BryanRalston/robot-lab/modules/design/cad/covers/README.md

## chest_pad_bezel_r2.step (P-052 rev 2, for Arms R18 G2 sweep), 2026-10-21
**Frame: GLOBAL** = torso frame + z 1280 mm, no rotation, waist joints at zero; mm, x fwd, y left, z up. Not the torso frame.
Bodies (named): `pad_core_116` (98×98, x 58–174), `pad_face_CF` (x 174–175), `land` (101×101, x 52–58, thickness [EST], Torso owns it), `bezel_fairing_P052r2` (1 mm PC, 100×100 front at x 173 → 150×150 at x 110, 4 mm corner chamfers, R6 front edge), `crush_posts_x4` (PA66 Ø8/Ø4.5, x 110–173, y ±63, z 1437/1563). Pad and land z 1451–1549 / 1449.5–1550.5.
Bounding box: x 52.0–175.0, y −75.0–75.0, z 1425.0–1575.0. Source: chest_pad_bezel_r2.py (CadQuery, light B-rep).
