BryanRalston/robot-lab/modules/legs/grokbuild/results/STRUCTURE_FEA_REPORT.md

# Structure FEA report

Job 3 of 3. Material 7075-T6. Loads at 66.5 kg. Solver is scikit-fem 12 on P2 tetrahedra, C3D27 hexahedra, and Q4 plates, units mm / N / MPa. Eight threads. CPU only. Every stress below is from a solve in `modules/legs/grokbuild/results/`. The M2 catalog was not changed.

## Acceptance

The r5 M2 line for both legs is 4.822 kg (`modules/legs/results/r5/structure_r5.json`, `total_both_kg` 4.82231676641112). The 0.04 kg bolt and bumper estimate is outside that line. The cap is 4.85 kg. This study did not add catalog mass, so the line stays at 4.822 kg.

Yield safety factor is Sy / von Mises, with Sy = 503 MPa. Pulse Goodman treats the reported stress as 0 to peak: sa = sm = σ/2, SF = 1 / (sa/159 + sm/572). Fully reversed Goodman at 0.52× is SF = 159 / (0.52 × σ) on the full-load stress. The walk load case that is already scaled by 0.52 is not run through that formula again.

| Check | Result |
| --- | --- |
| M2 line ≤ 4.85 kg | 4.822 kg. Holds. |
| Fall SF ≥ 2 on a converged section stress | Fork, knee tongue, both tubes in bending, tongue fall, and foot heel pass. Foot toe and clevis fail on the element maximum. Both of those maxima grew when the mesh was refined. |
| Goodman ≥ 1.5 | Clamp arm root is 1.472 on the fully reversed 0.52× check. Several corner maxima fail. Section stresses away from those corners pass. |
| Added mass where a check fails | Measured only for the lateral tube dent. Not measured for the clevis corner, the foot flange edge, the tongue neck corner, or the clamp root. |

## Material and loads

E = 71700 MPa, ν = 0.33, Sy = 503 MPa, Su = 572 MPa, Se = 159 MPa at 5×10^8 cycles, ρ = 2.81×10⁻⁶ kg/mm³. Shaft steel in the press-fit slice is E = 210000 MPa, ν = 0.30. DP490 in the bond model is E = 2500 MPa, ν = 0.40, thickness 0.10 mm.

W = 652.365 N. 3 body-weights = 1957.1 N. Fall = 3914.19 N. The r3 ground-reaction figure 1039.8 N was not rescaled. Knee screw 7267.4 N. Hip screw 9084.3 N. One screw body force 4542 N. Carry moment 241.5 N·m at a 73 mm instep arm, so the carry screw is 3308.2 N. The 1.5× moment used as a second foot case is 314 N·m.

## Solver checks

`verify_solver.json`, status ok.

- P2 cantilever, 439 tets, 3012 dofs. Tip 0.5557 mm against the beam value 0.5579 mm (0.40%). Bending-stress band 40.9 MPa against 48 MPa (15% low). Tip face area 100 mm².
- Lamé quarter tube, 4095 tets. Bore von Mises median 167.0 MPa against the plane-stress value 179.4 MPa (6.9% low). Hand hoop 141.7 MPa.

`fea_tubes.json` cantilever gate, C3D27, intorder 4, 64 elements, 2475 dofs. Tip −0.5553 mm against the bending target 0.5579 mm plus shear, error 1.26%. End area 100.0 mm². Converged in 159 iterations.

`plate_buckling.json`. Thin plate 100×100×1, nx = 32, reduced shear: k = 3.9692, σ_cr = 26.267 MPa against k = 4 at 26.471 MPa. Biaxial ratio 0.9933. Foot bay 28×28×3.5 mm, nx = 24, full 2×2 shear, 625 nodes: simply supported σ_cr = 3537.2 MPa (k = 3.421), clamped σ_cr = 7912.4 MPa. The bay yields at 503 MPa before it buckles.
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
