BryanRalston/robot-lab/modules/legs/grokbuild/results/REPORT.md

# WBC r6 closed-loop re-sim

Date of these runs: 2026-10-13. Machine: Windows, Python 3.12, repo venv, CPU. `LEGS_MASS=65`, `LEGS_LIMITS=r1`, `LEGS_CONTACT` unset. Contact is the default model: condim 3, box feet 240×100 (geom half-size 0.120×0.05). No change to `CONTRACTS.md` or actuator selections.

Controller: `modules/legs/wbc/`. The plan path is still the 1 kHz QP on a 1 s slice of `walk_1p2_r2` (carry uses `carry_20kg_r2`). `_plan_mpc` is no longer open-loop playback:
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
