BryanRalston/robot-lab/media/progress/2026-10-13_actuators_r2_regen_mass.png

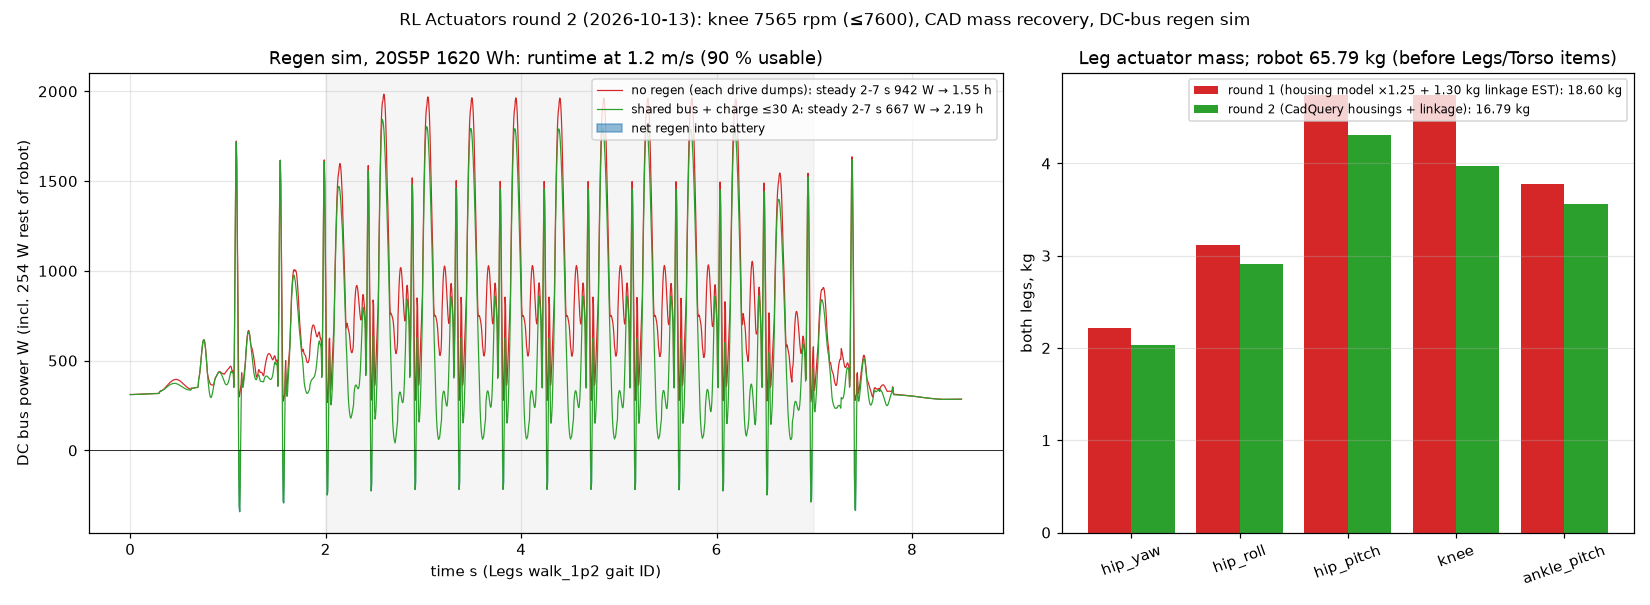
media/progress/2026-10-13_actuators_r2_regen_mass.png
