BryanRalston/robot-lab/media/progress/2026-10-13_actuators_r3_regen_sweep.png

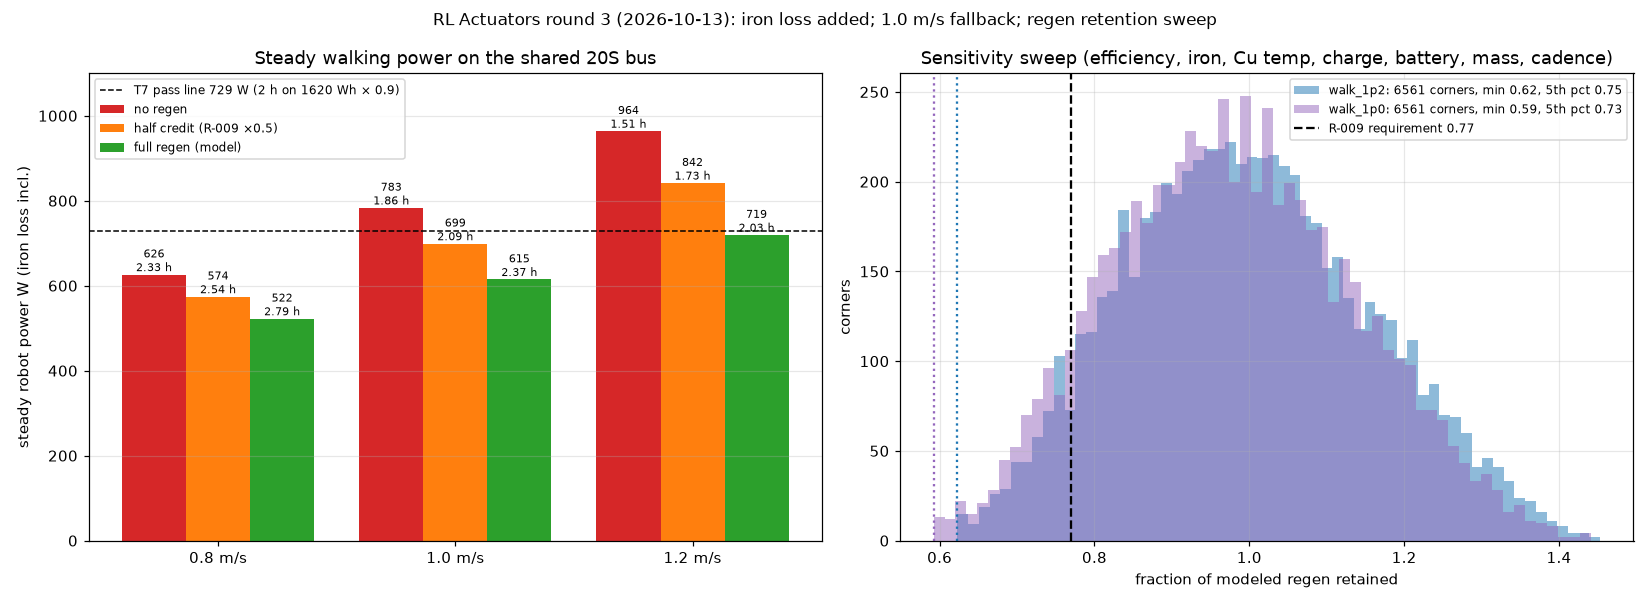
media/progress/2026-10-13_actuators_r3_regen_sweep.png
