BryanRalston/robot-lab/media/progress/2026-10-13_actuators_r3b_hip_lever_fea.png

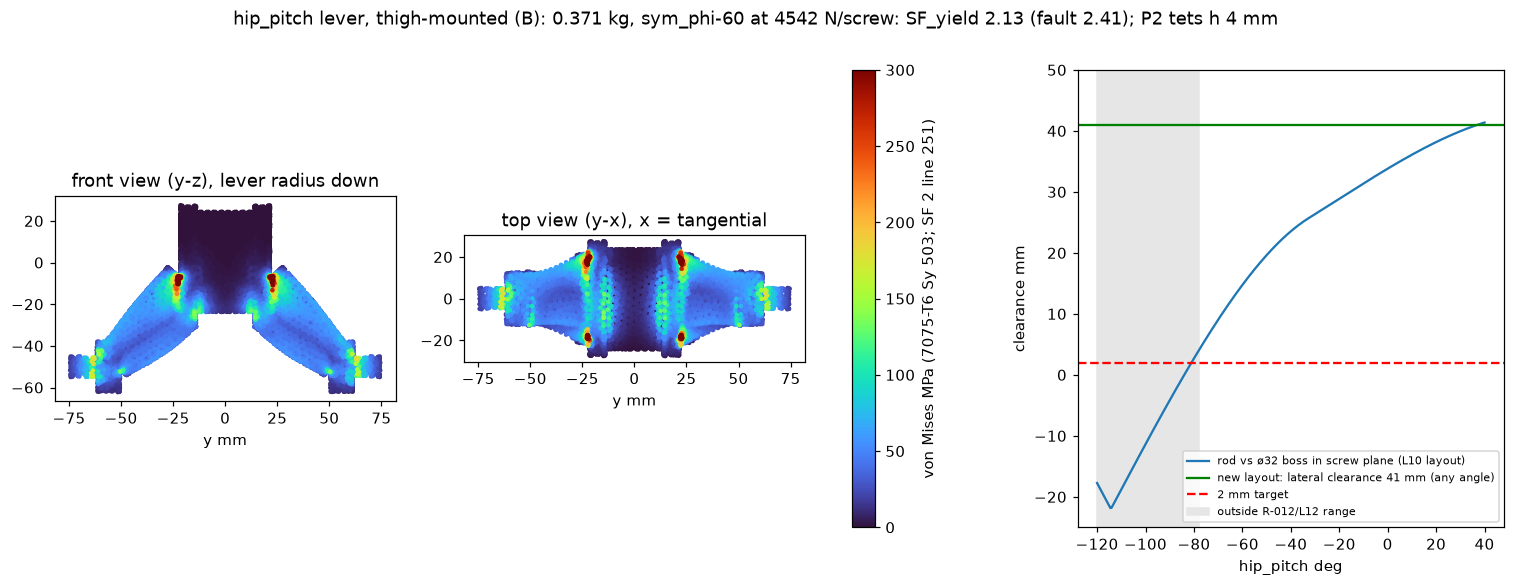
media/progress/2026-10-13_actuators_r3b_hip_lever_fea.png
