BryanRalston/robot-lab/media/progress/2026-10-13_actuators_r4_mass_cuts.png

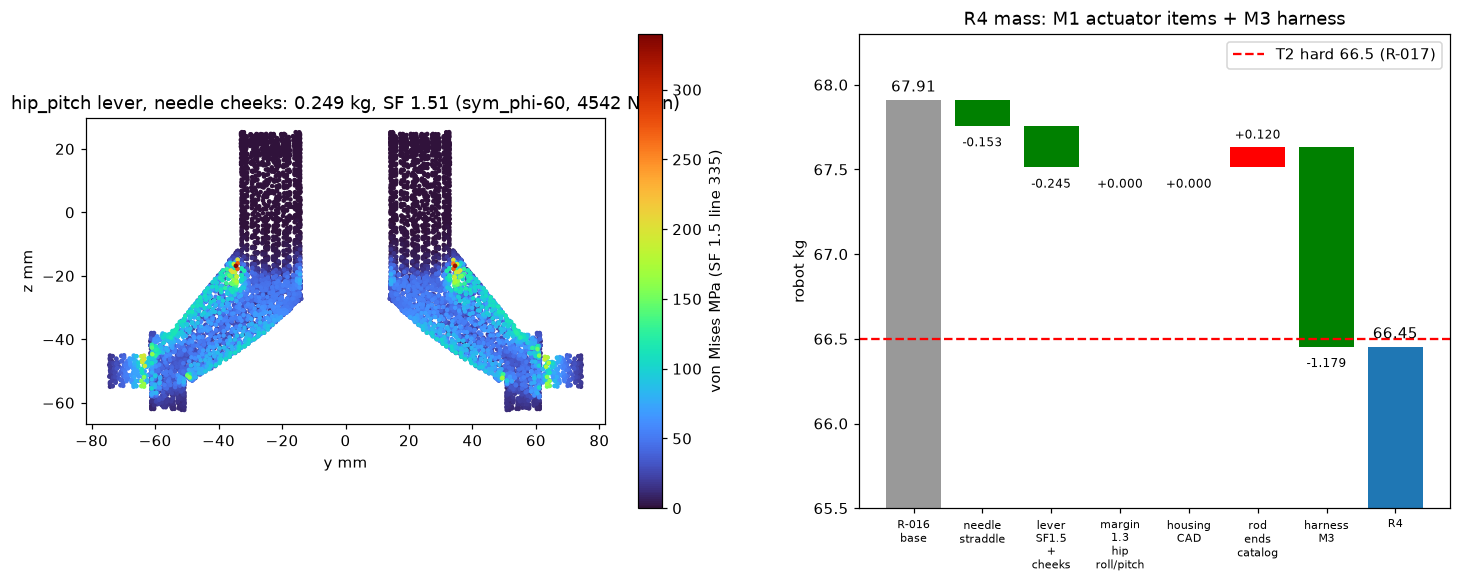
media/progress/2026-10-13_actuators_r4_mass_cuts.png
