BryanRalston/robot-lab/media/progress/2026-10-13_actuators_r5a2_harness.png

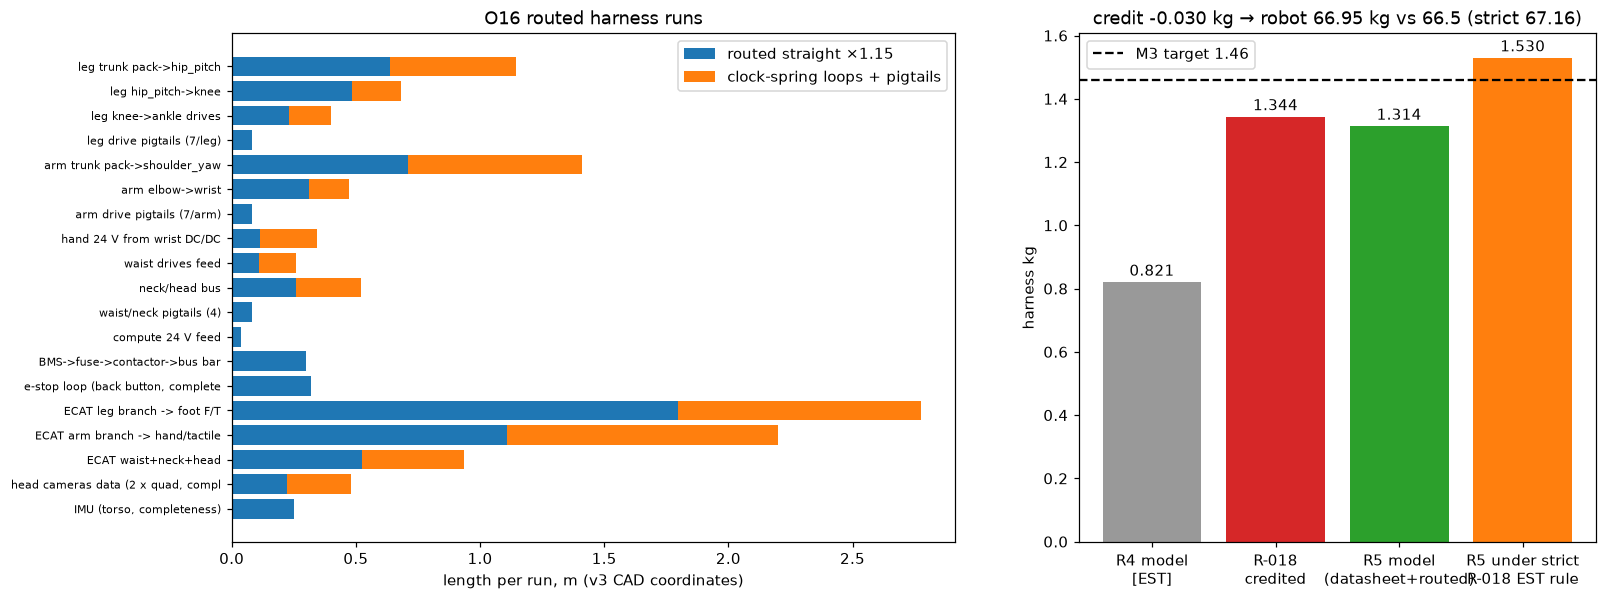
media/progress/2026-10-13_actuators_r5a2_harness.png
