BryanRalston/robot-lab/media/progress/2026-10-13_actuators_r5b_ankle_clamp_mass.png

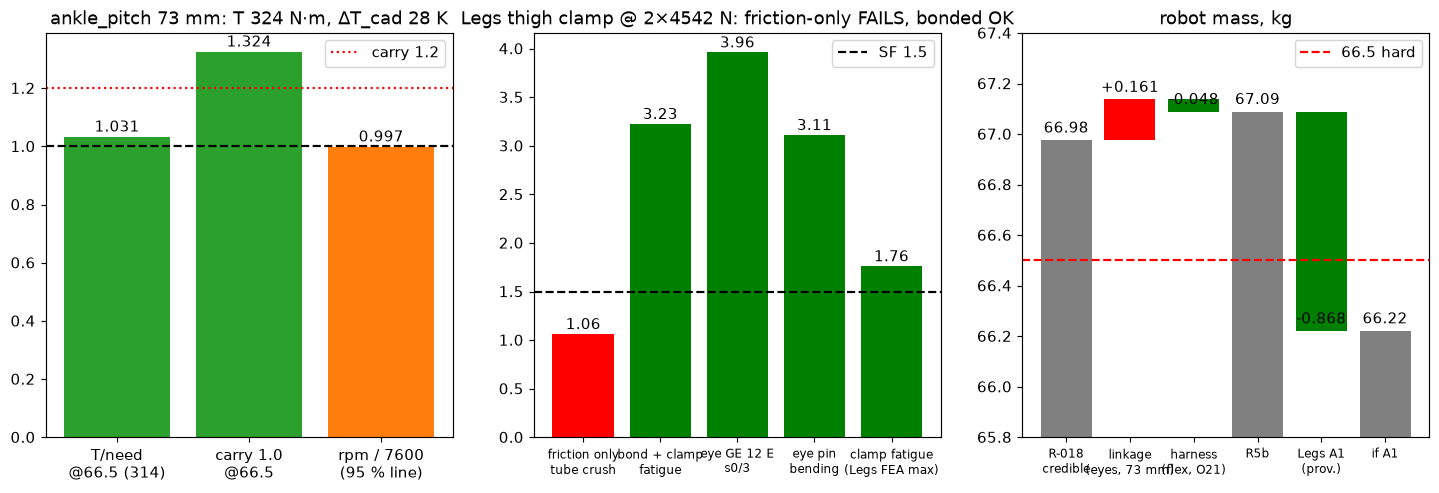
media/progress/2026-10-13_actuators_r5b_ankle_clamp_mass.png
