BryanRalston/robot-lab/media/progress/2026-10-13_actuators_r6_life_jst.png

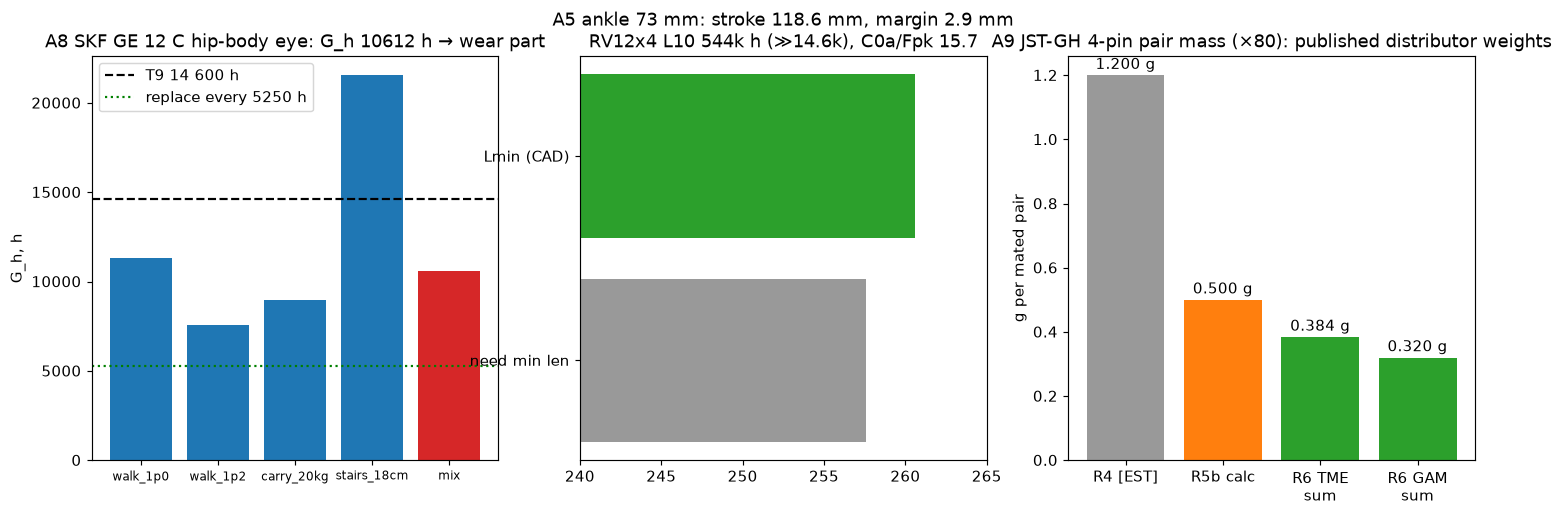
media/progress/2026-10-13_actuators_r6_life_jst.png
