BryanRalston/robot-lab/media/progress/2026-10-13_actuators_torque_speed.png

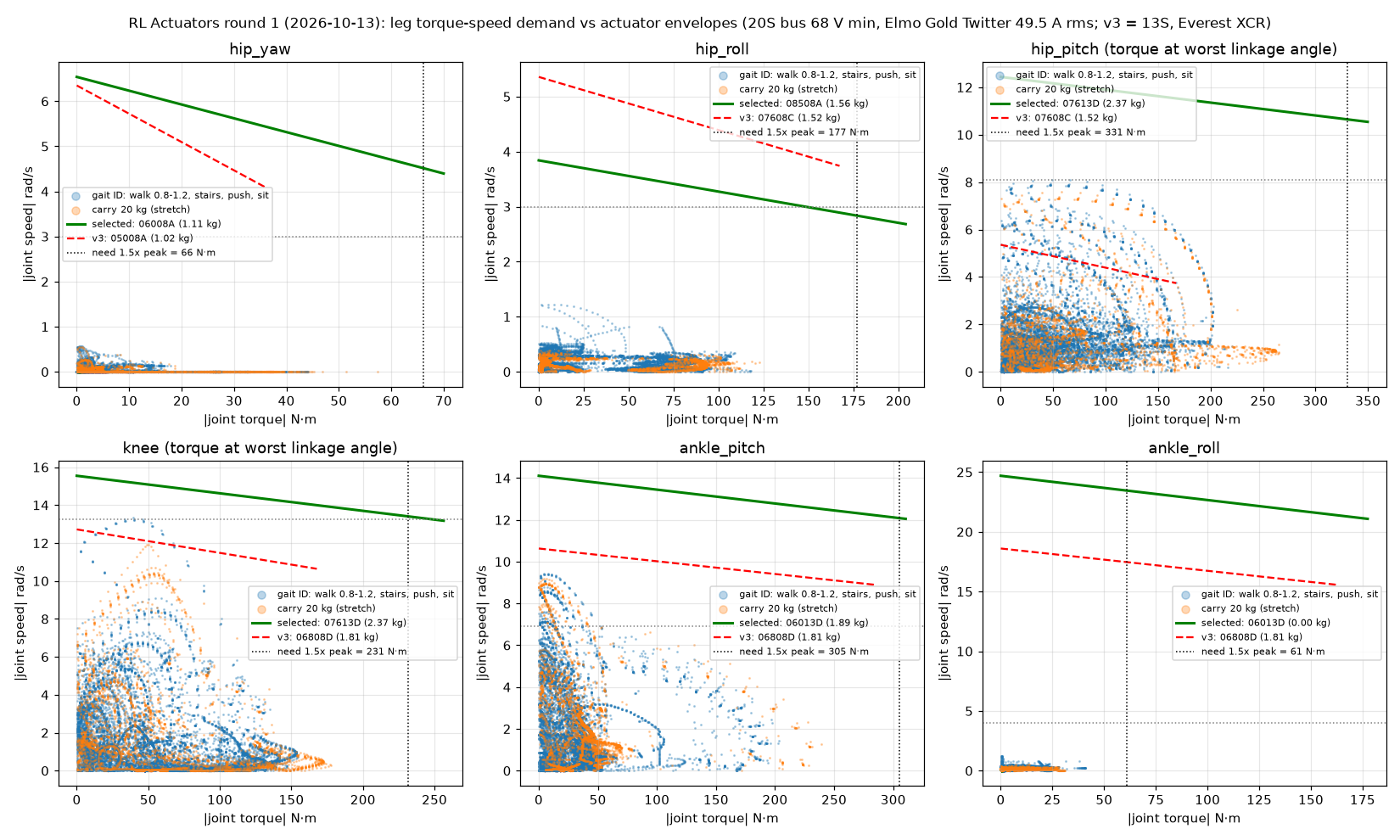
media/progress/2026-10-13_actuators_torque_speed.png
