BryanRalston/robot-lab/media/progress/2026-10-13_arbiter_mass_budget.png

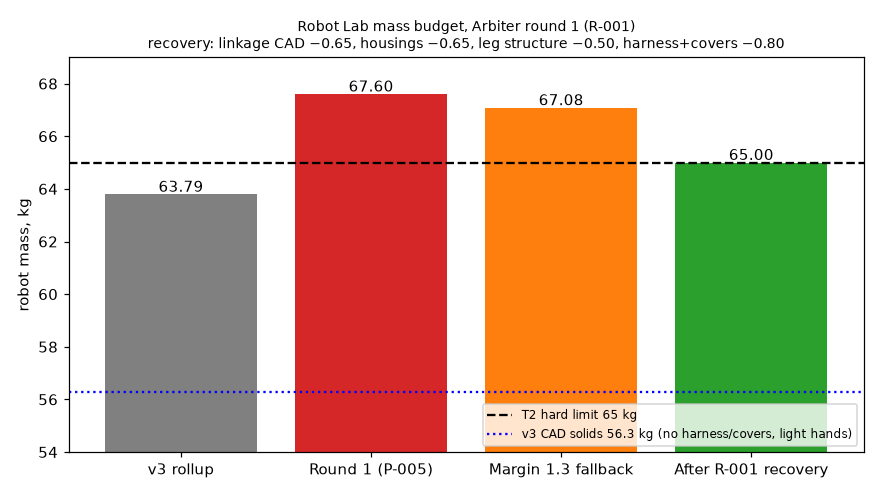
media/progress/2026-10-13_arbiter_mass_budget.png
