BryanRalston/robot-lab/media/progress/2026-10-13_legs_fsim_walk0p8.png

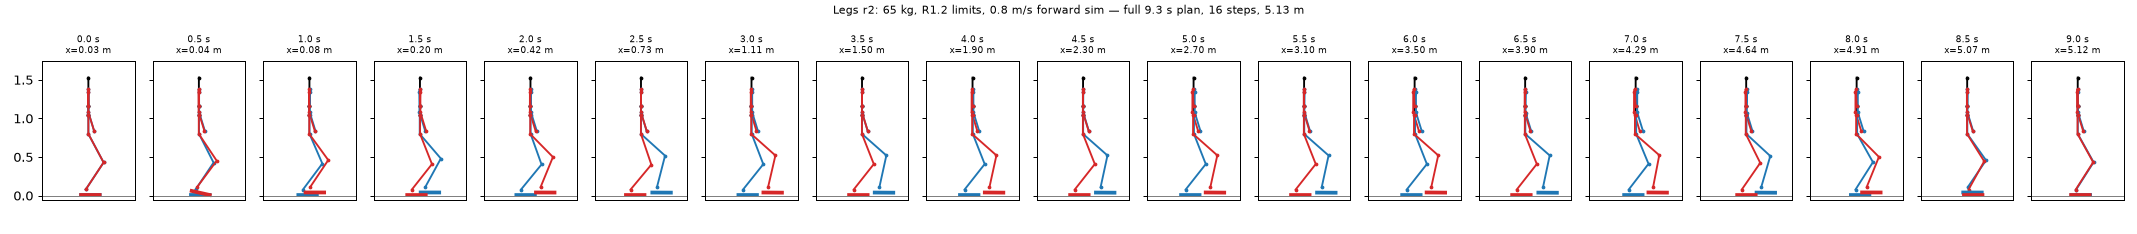
media/progress/2026-10-13_legs_fsim_walk0p8.png
