BryanRalston/robot-lab/media/progress/2026-10-13_legs_fsim_walk1p2_attempt.png

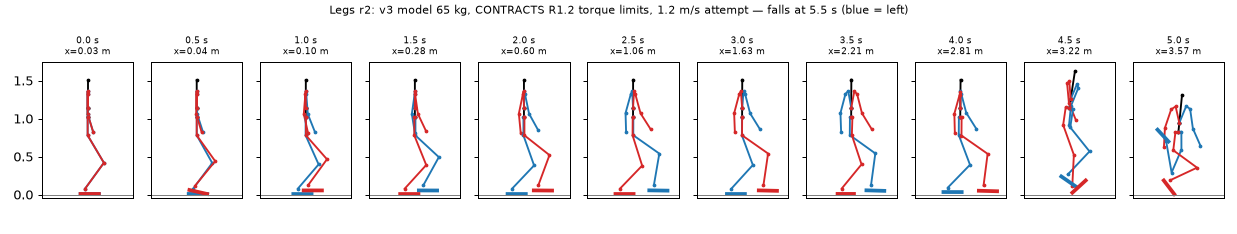
media/progress/2026-10-13_legs_fsim_walk1p2_attempt.png
