BryanRalston/robot-lab/media/progress/2026-10-13_legs_linkage_study.png

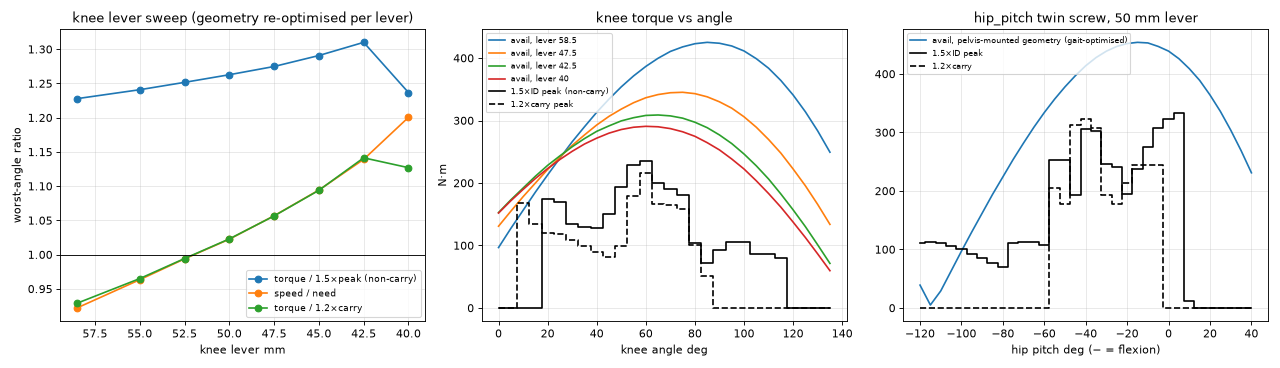
media/progress/2026-10-13_legs_linkage_study.png
