BryanRalston/robot-lab/media/progress/2026-10-13_legs_m2_structure_fea.png

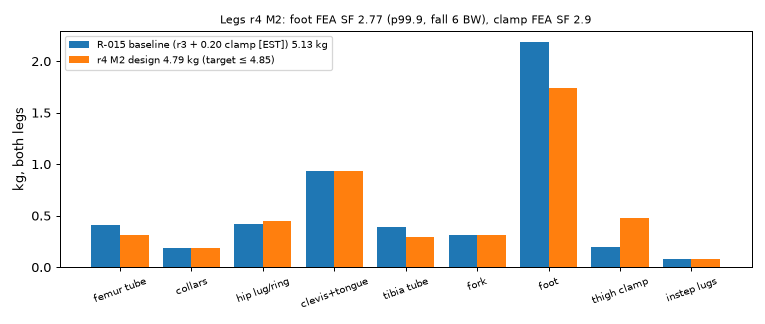
media/progress/2026-10-13_legs_m2_structure_fea.png
