BryanRalston/robot-lab/media/progress/2026-10-13_legs_sit_to_stand_chair.png

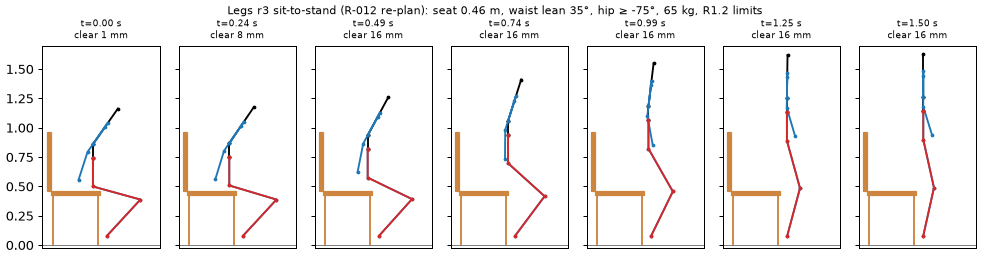
media/progress/2026-10-13_legs_sit_to_stand_chair.png
