BryanRalston/robot-lab/media/progress/2026-10-13_legs_wbc_r7_walk0p8.png

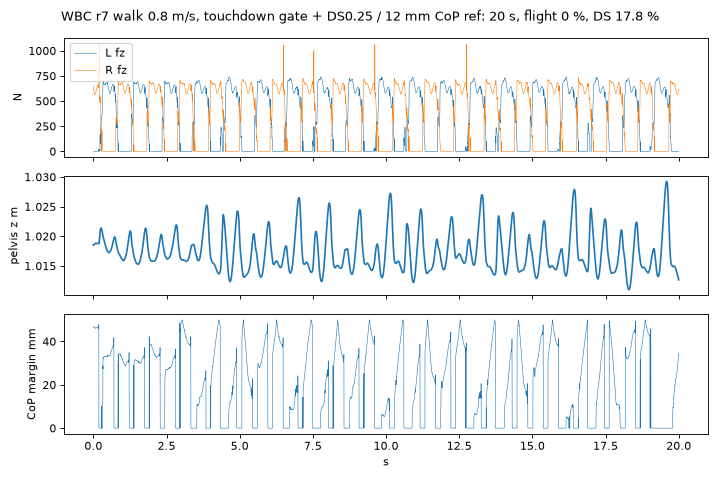
media/progress/2026-10-13_legs_wbc_r7_walk0p8.png
