BryanRalston/robot-lab/media/progress/2026-10-13_legs_wbc_walk1p2.gif

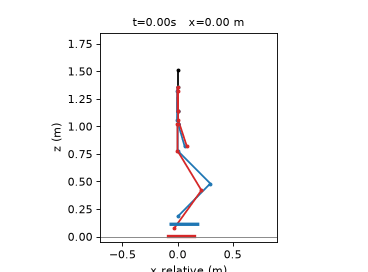
media/progress/2026-10-13_legs_wbc_walk1p2.gif
