BryanRalston/robot-lab/media/progress/2026-10-14_arms_R1_layout_torque.png

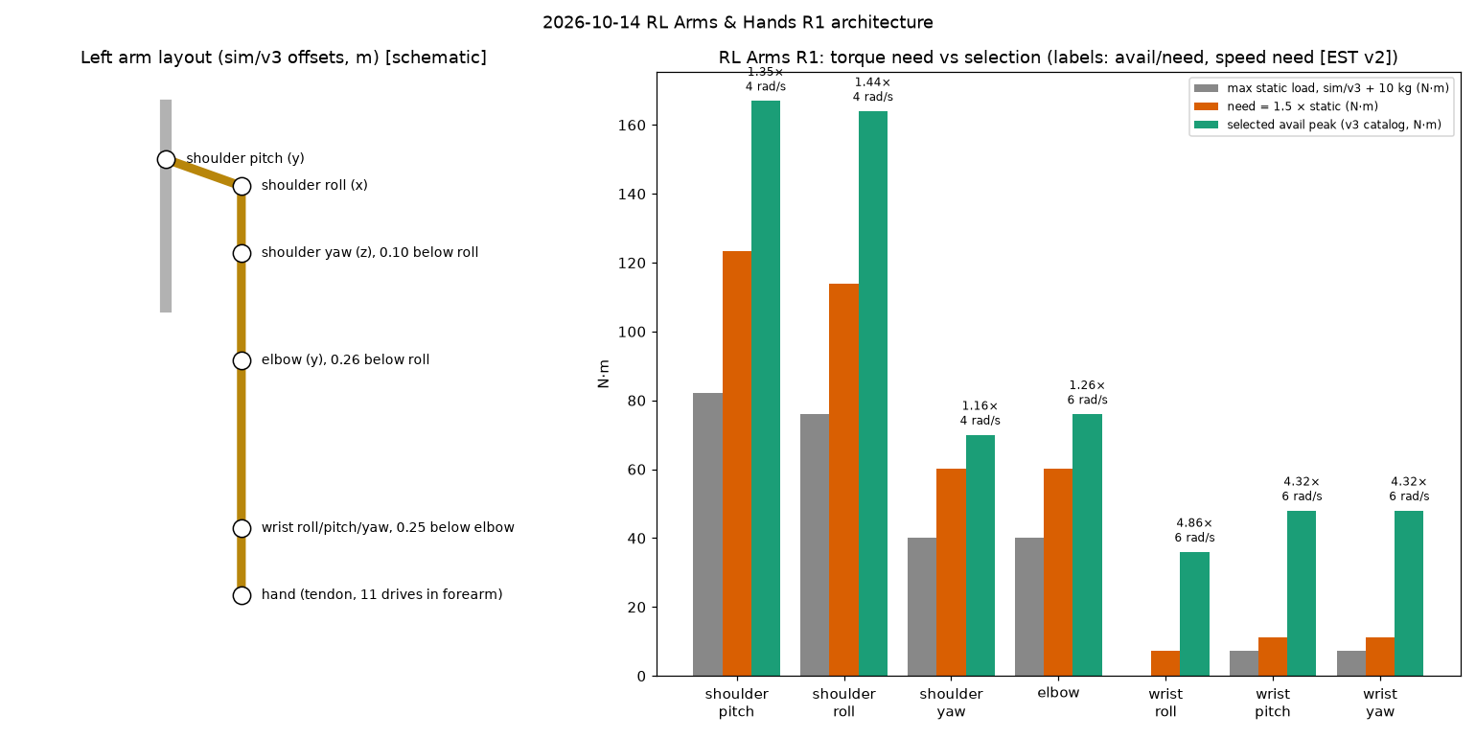
media/progress/2026-10-14_arms_R1_layout_torque.png
