BryanRalston/robot-lab/media/progress/2026-10-14_design_v5_polish_concept.png

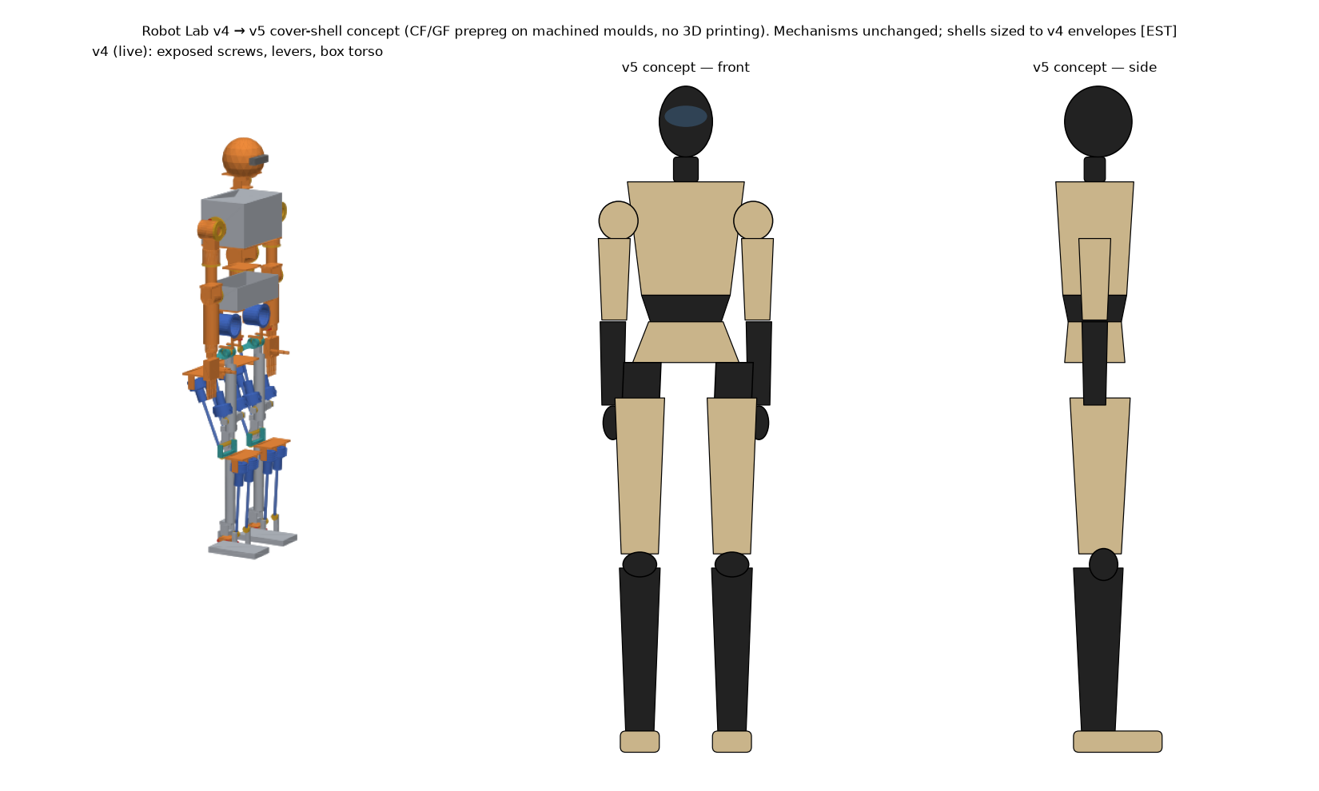
media/progress/2026-10-14_design_v5_polish_concept.png
