BryanRalston/robot-lab/media/progress/2026-10-14_head_balancer_verdict.png

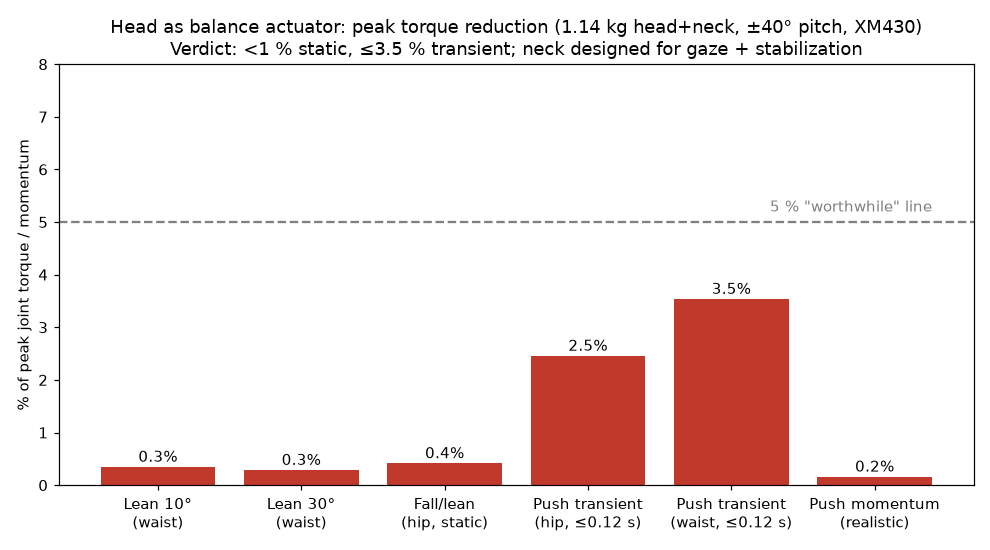
media/progress/2026-10-14_head_balancer_verdict.png
