BryanRalston/robot-lab/media/progress/2026-10-14_legs_v5_keepouts.png

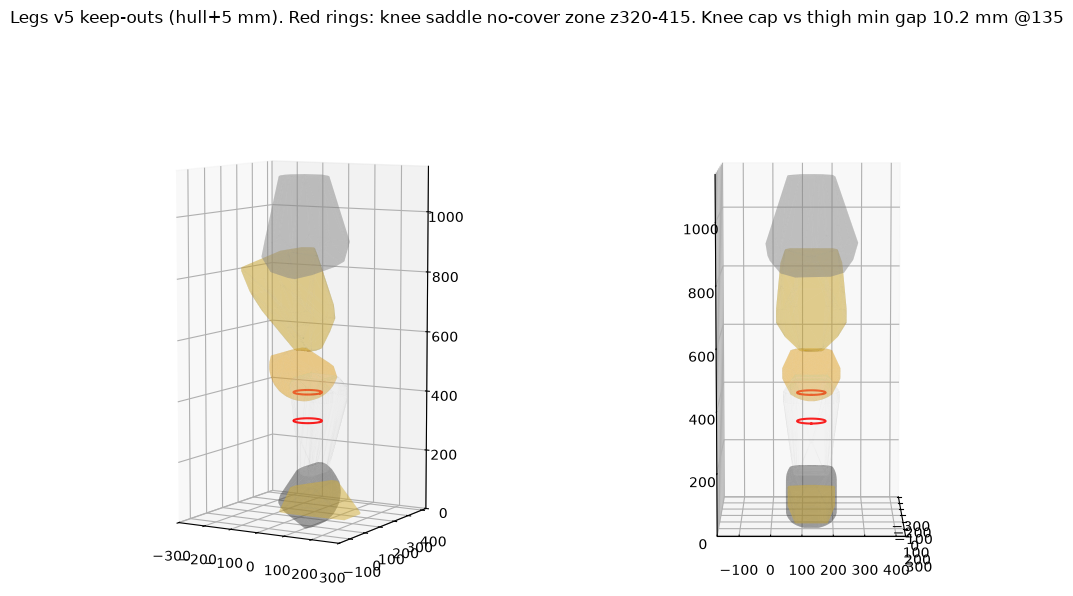
media/progress/2026-10-14_legs_v5_keepouts.png
