BryanRalston/robot-lab/media/progress/2026-10-14_model_v4_ankle_roll_fail.png

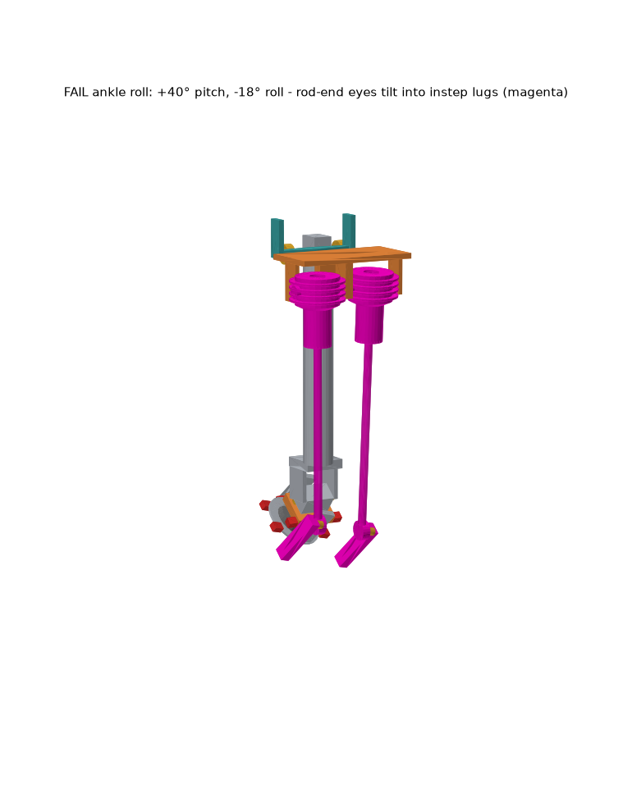
media/progress/2026-10-14_model_v4_ankle_roll_fail.png
