BryanRalston/robot-lab/media/progress/2026-10-14_model_v4_deep_squat.png

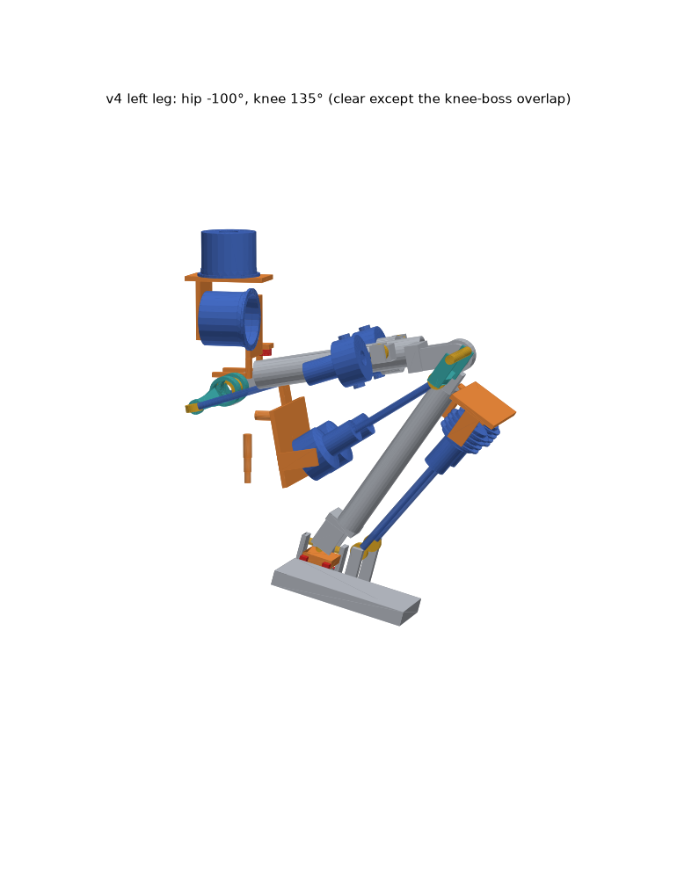
media/progress/2026-10-14_model_v4_deep_squat.png
