BryanRalston/robot-lab/media/progress/2026-10-14_model_v4_knee_boss_clash.png

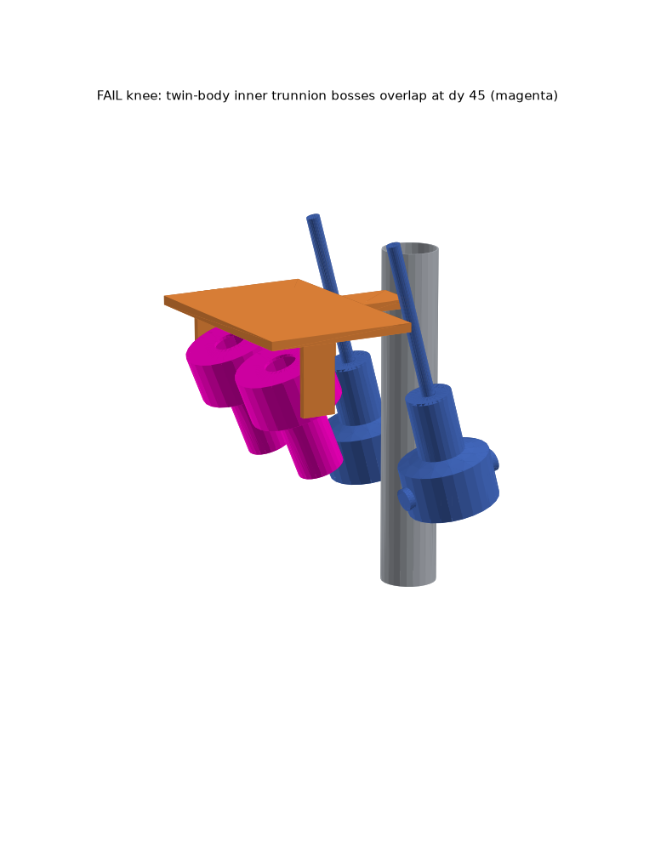
media/progress/2026-10-14_model_v4_knee_boss_clash.png
