BryanRalston/robot-lab/media/progress/2026-10-14_model_v4_site_desktop.png

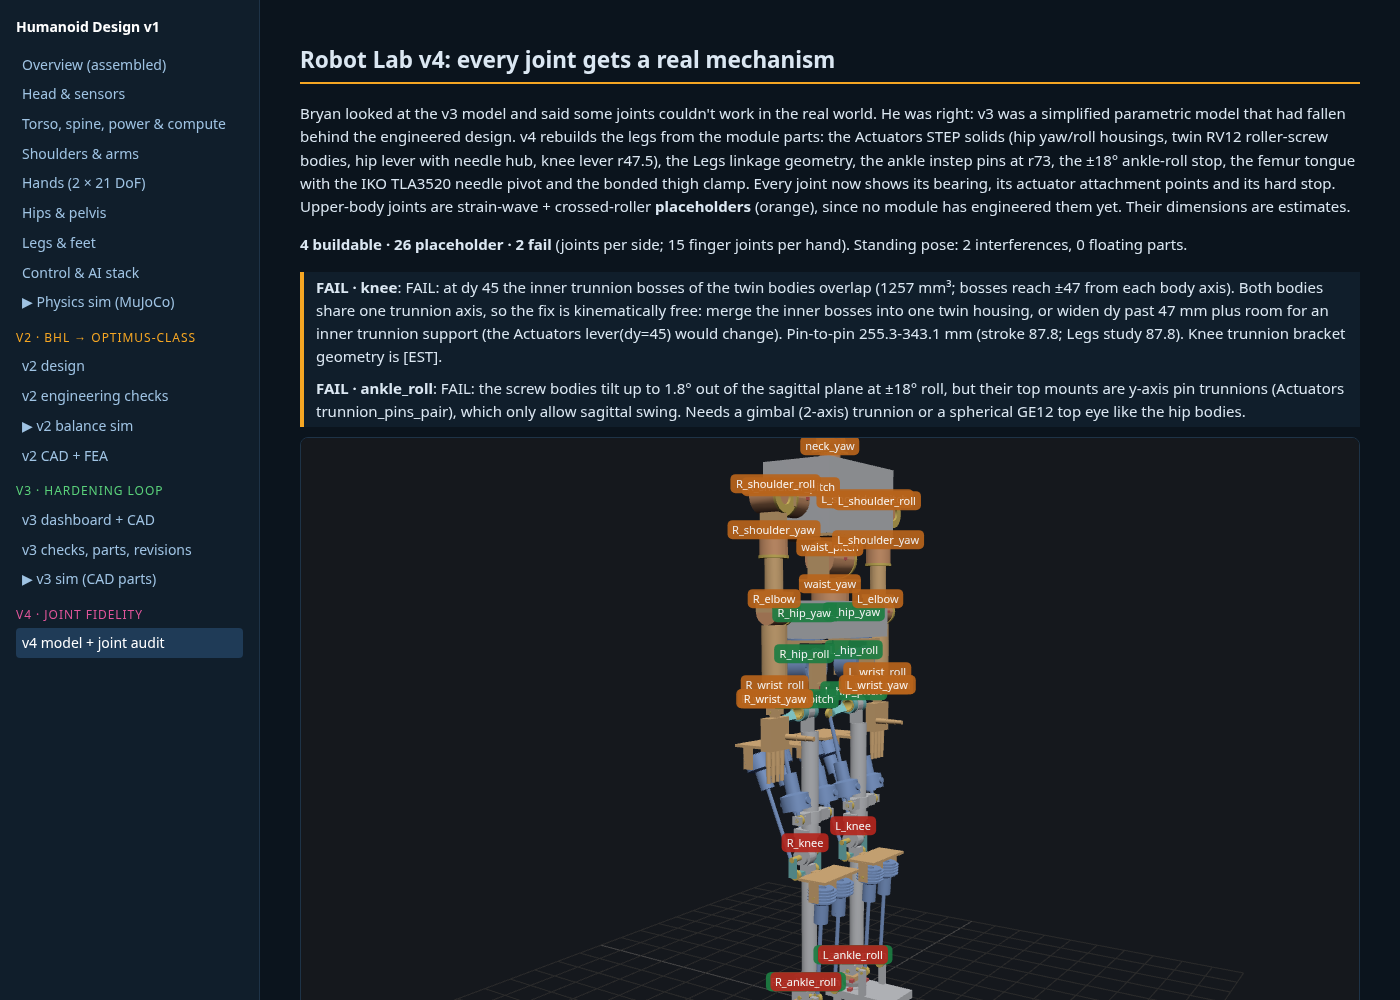
media/progress/2026-10-14_model_v4_site_desktop.png
