BryanRalston/robot-lab/media/progress/2026-10-14_torso_R1-3_power.png

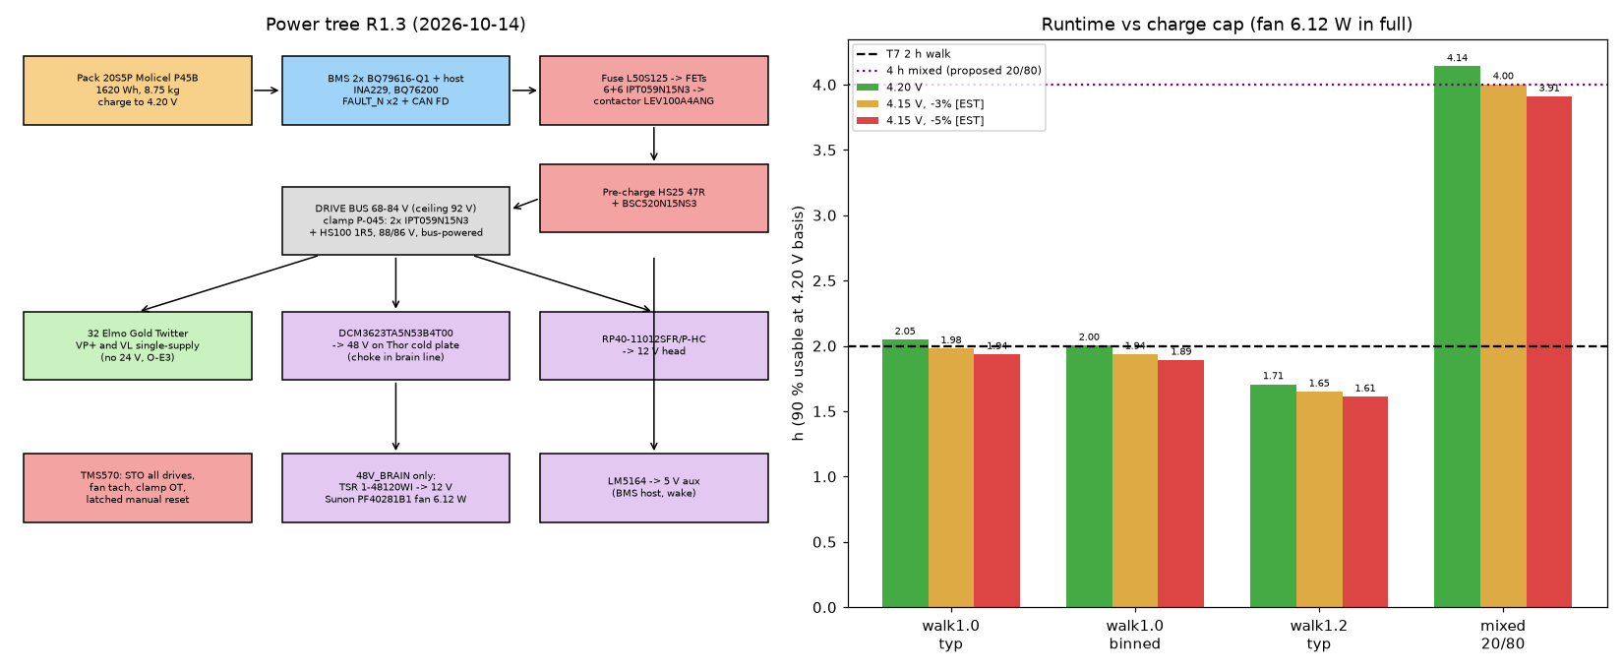
media/progress/2026-10-14_torso_R1-3_power.png
