BryanRalston/robot-lab/media/progress/2026-10-21_arms_R18_chest_pad_clash.png

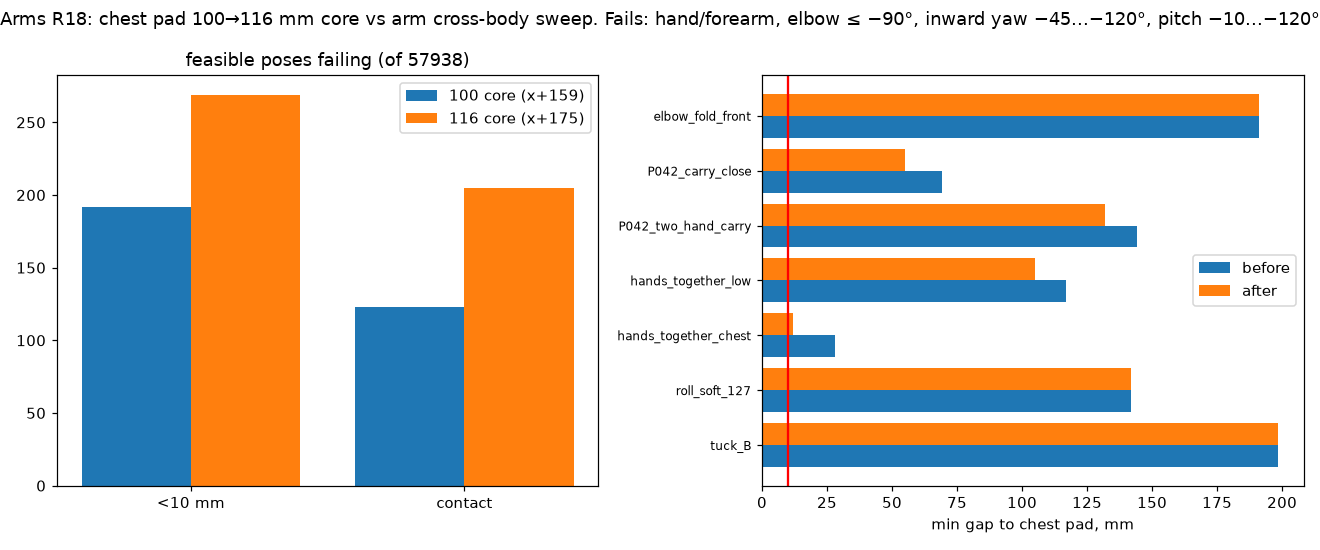
media/progress/2026-10-21_arms_R18_chest_pad_clash.png
