BryanRalston/robot-lab/media/progress/2026-10-21_arms_R18b_R19_kneel_plant.png

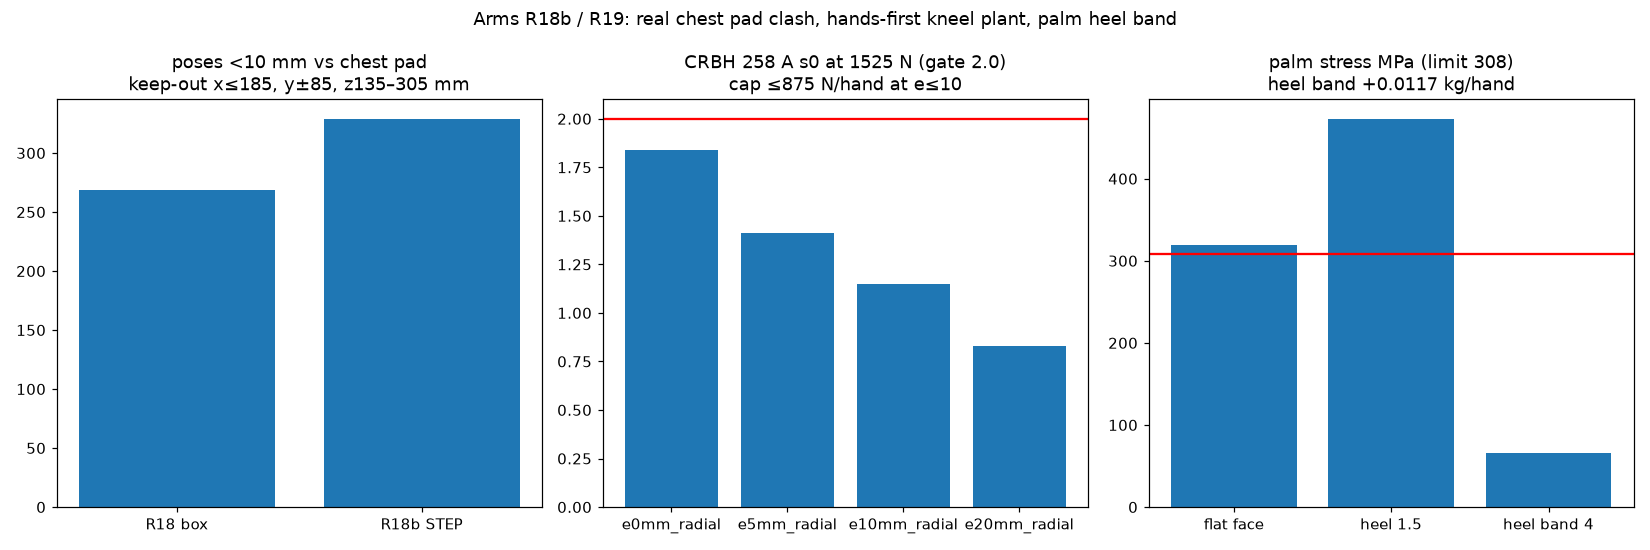
media/progress/2026-10-21_arms_R18b_R19_kneel_plant.png
