BryanRalston/robot-lab/media/progress/2026-10-21_controls_r142_safe_sit_wbc.gif

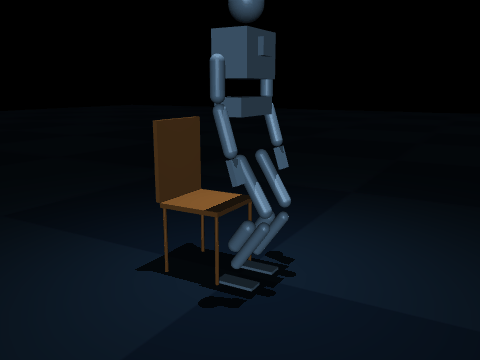
media/progress/2026-10-21_controls_r142_safe_sit_wbc.gif
