BryanRalston/robot-lab/media/progress/2026-10-21_controls_r145_crouch_kneel_attempt.gif

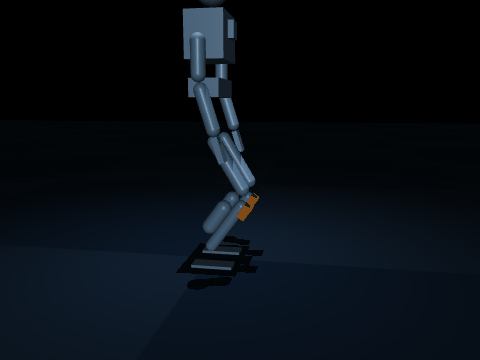
media/progress/2026-10-21_controls_r145_crouch_kneel_attempt.gif
