BryanRalston/robot-lab/media/progress/2026-10-21_controls_r146b_chest_lower_wbc.gif

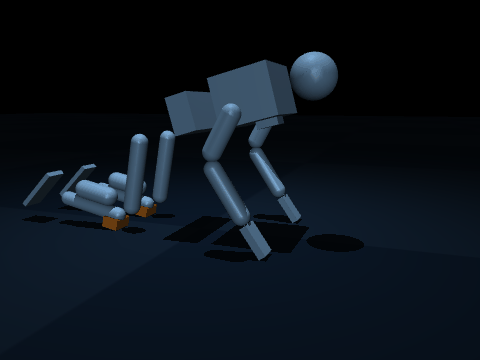
media/progress/2026-10-21_controls_r146b_chest_lower_wbc.gif
