BryanRalston/robot-lab/media/progress/2026-10-21_handling_map_rev6.png

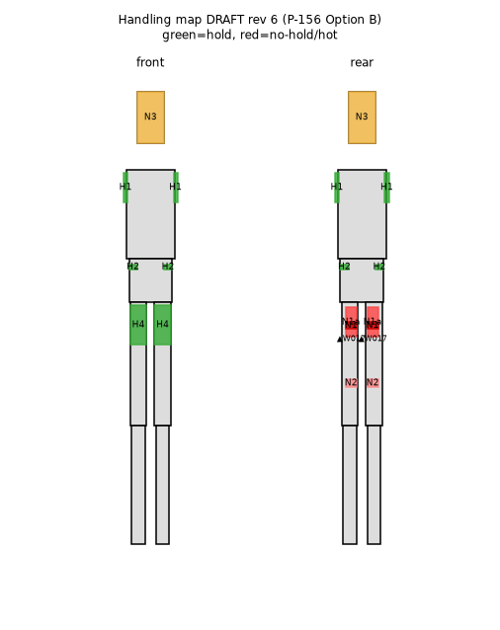
media/progress/2026-10-21_handling_map_rev6.png
