BryanRalston/robot-lab/media/progress/2026-10-21_hip_skirt_r8.png

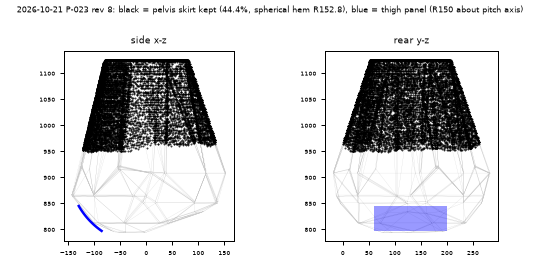
media/progress/2026-10-21_hip_skirt_r8.png
