BryanRalston/robot-lab/media/progress/2026-10-21_torso_revD_loadpath.png

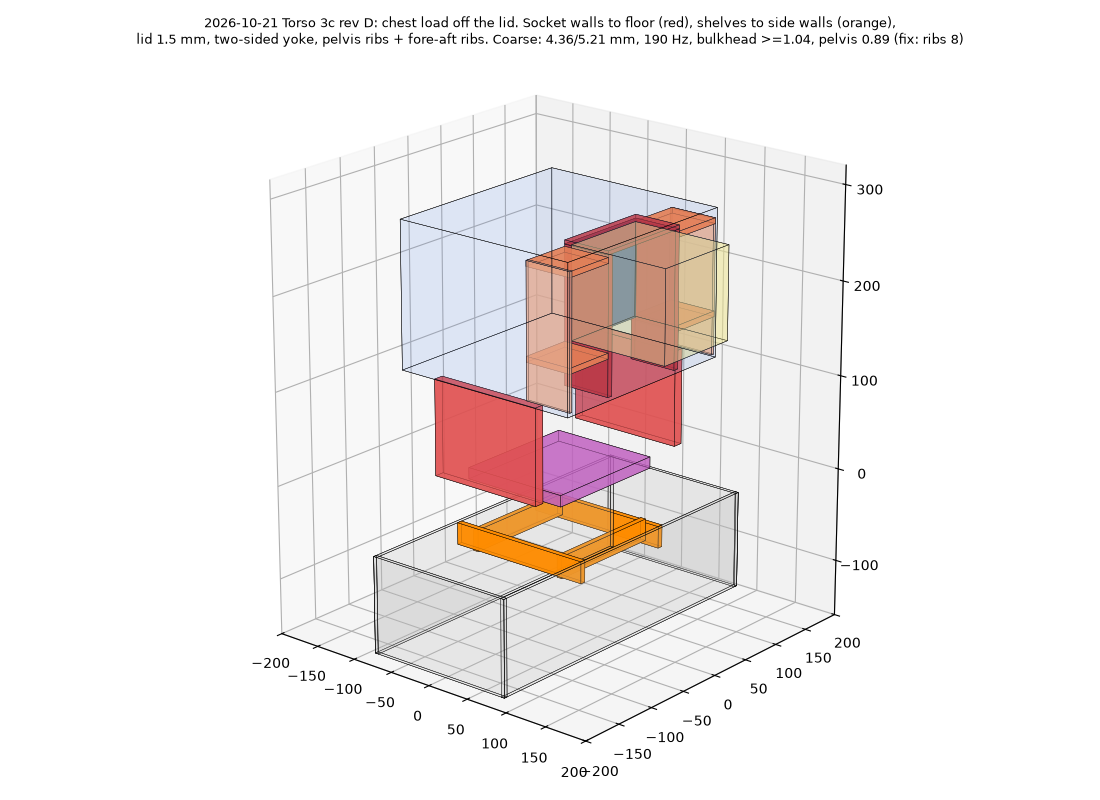
media/progress/2026-10-21_torso_revD_loadpath.png
