BryanRalston/robot-lab/media/progress/2026-10-21_torso_yoke.png

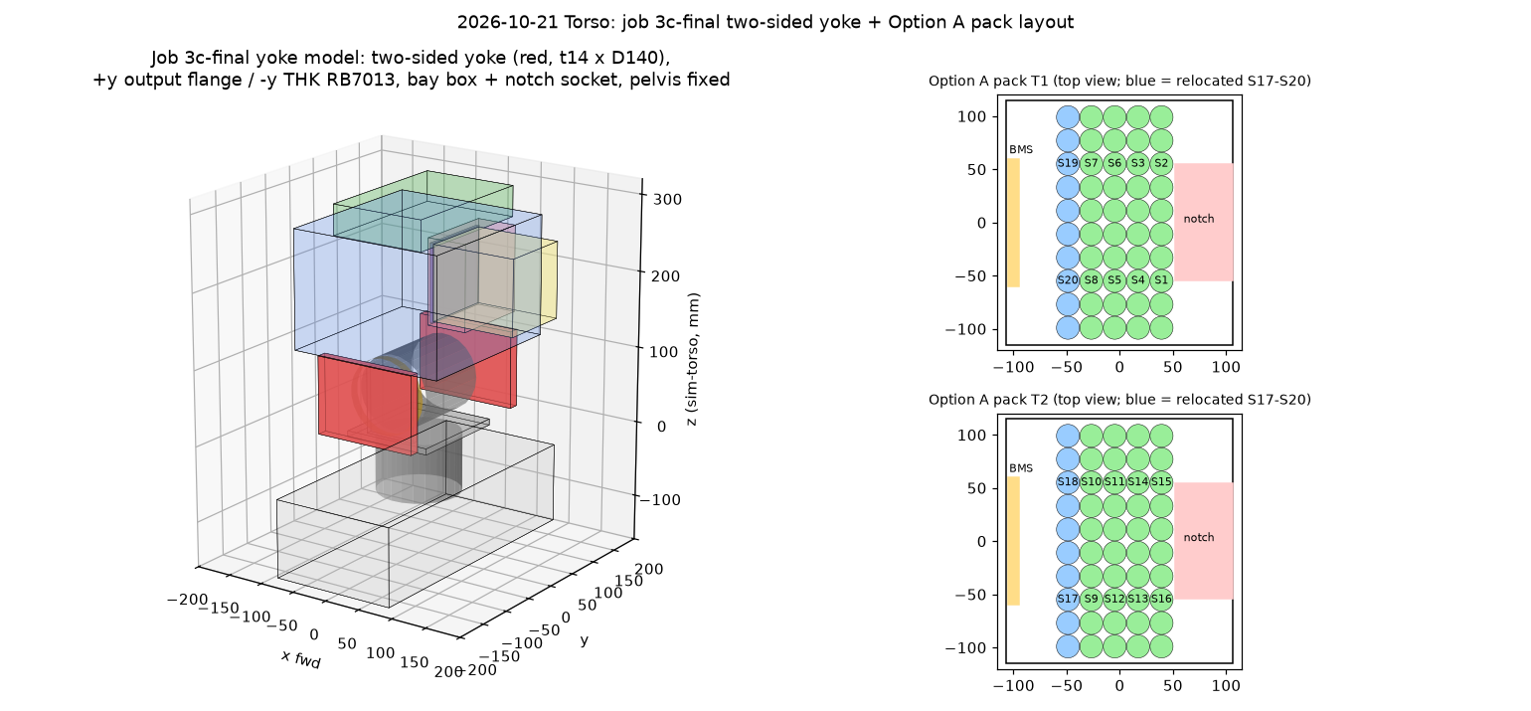
media/progress/2026-10-21_torso_yoke.png
