BryanRalston/robot-lab/media/progress/desktop_index.png

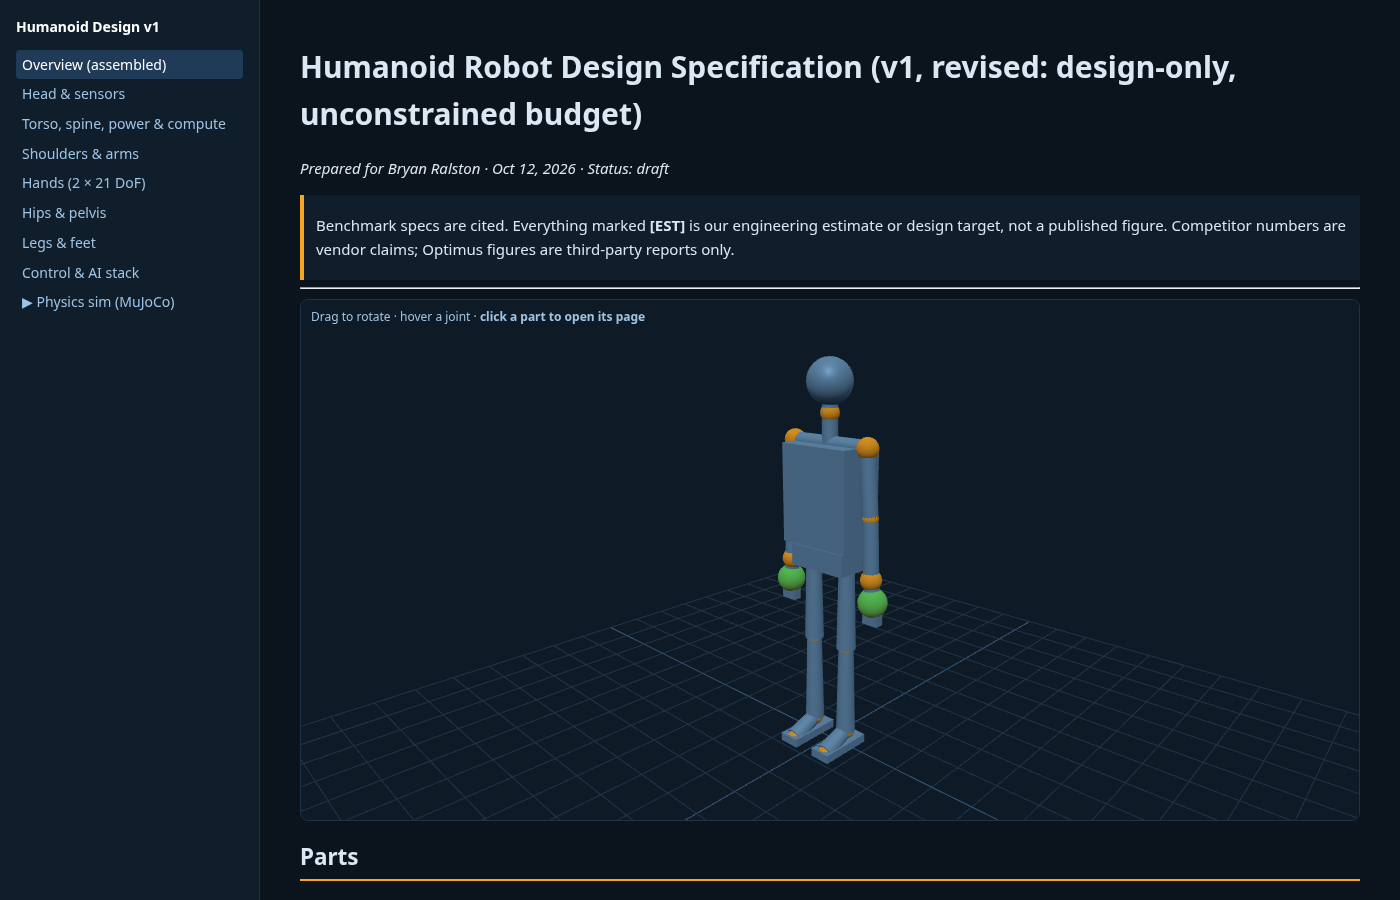
media/progress/desktop_index.png
