BryanRalston/robot-lab/media/progress/hp_lever_v2_B1_stress.png

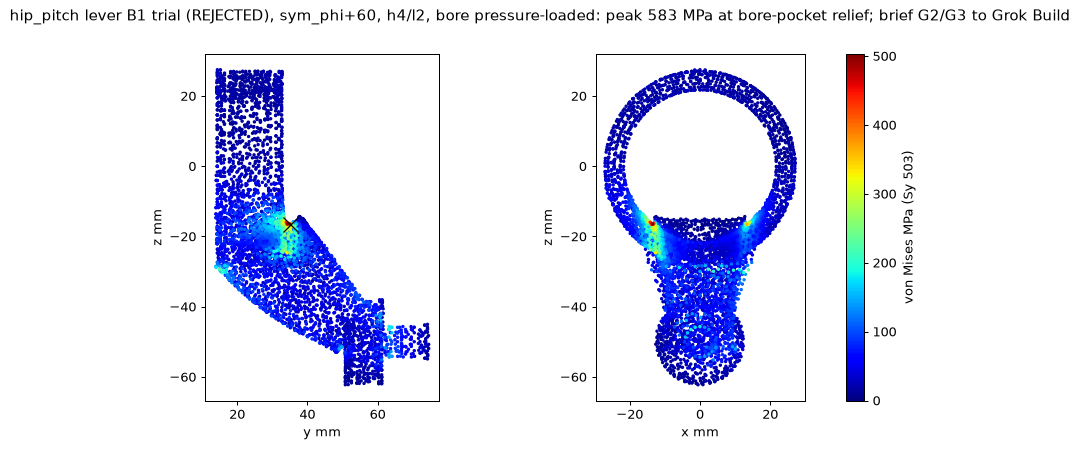
media/progress/hp_lever_v2_B1_stress.png
