BryanRalston/robot-lab/media/progress/v2_cad_desktop.png

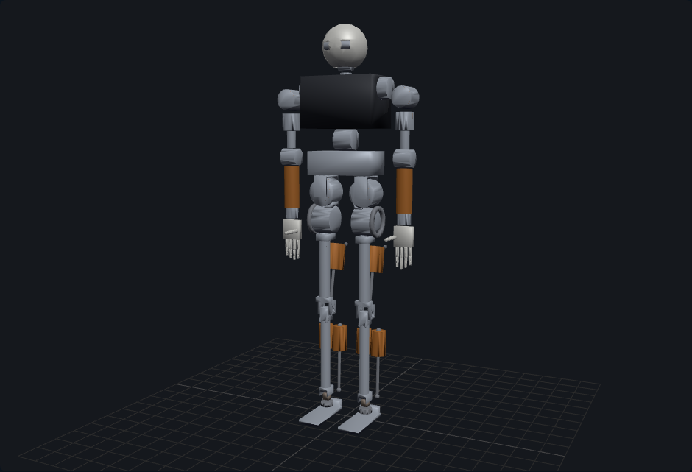
media/progress/v2_cad_desktop.png
