BryanRalston/robot-lab/media/progress/v3_mobile.png

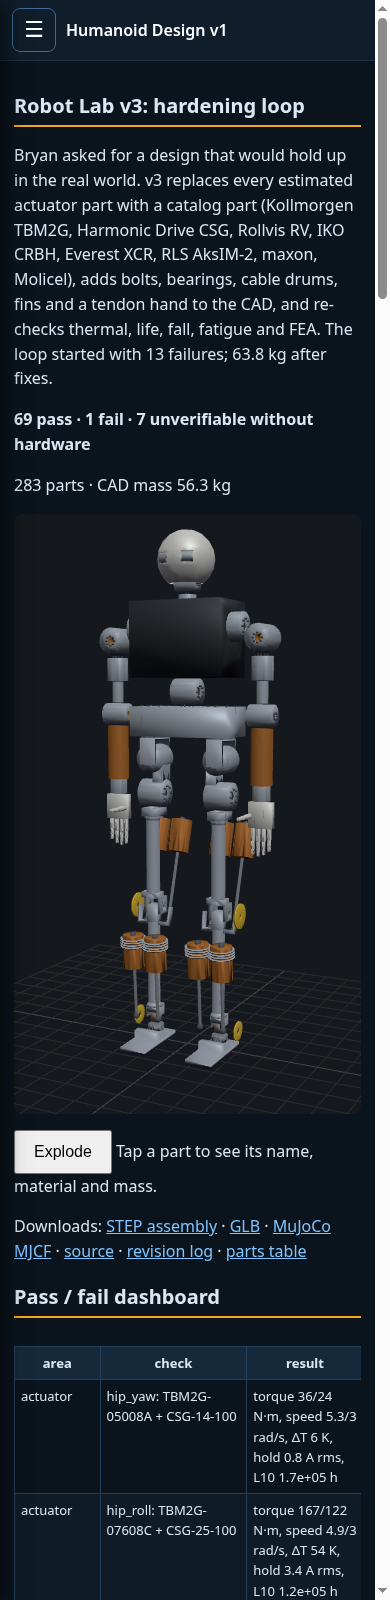
media/progress/v3_mobile.png
