BryanRalston/robot-lab/modules/actuators/fea/job2_g3_lever/governing_vm.png

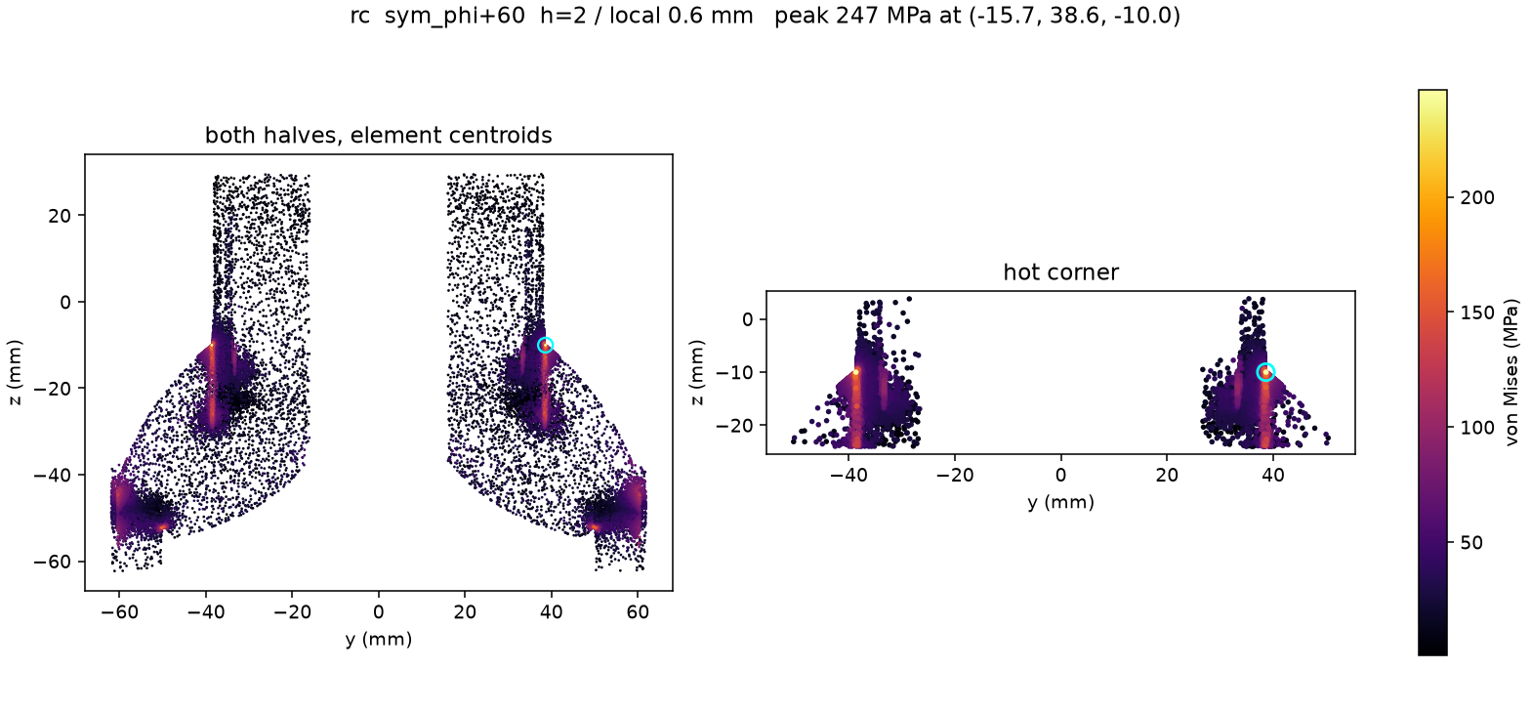
modules/actuators/fea/job2_g3_lever/governing_vm.png
