BryanRalston/robot-lab/modules/actuators/fea/job2_g3_lever/governing_vm_b35.png

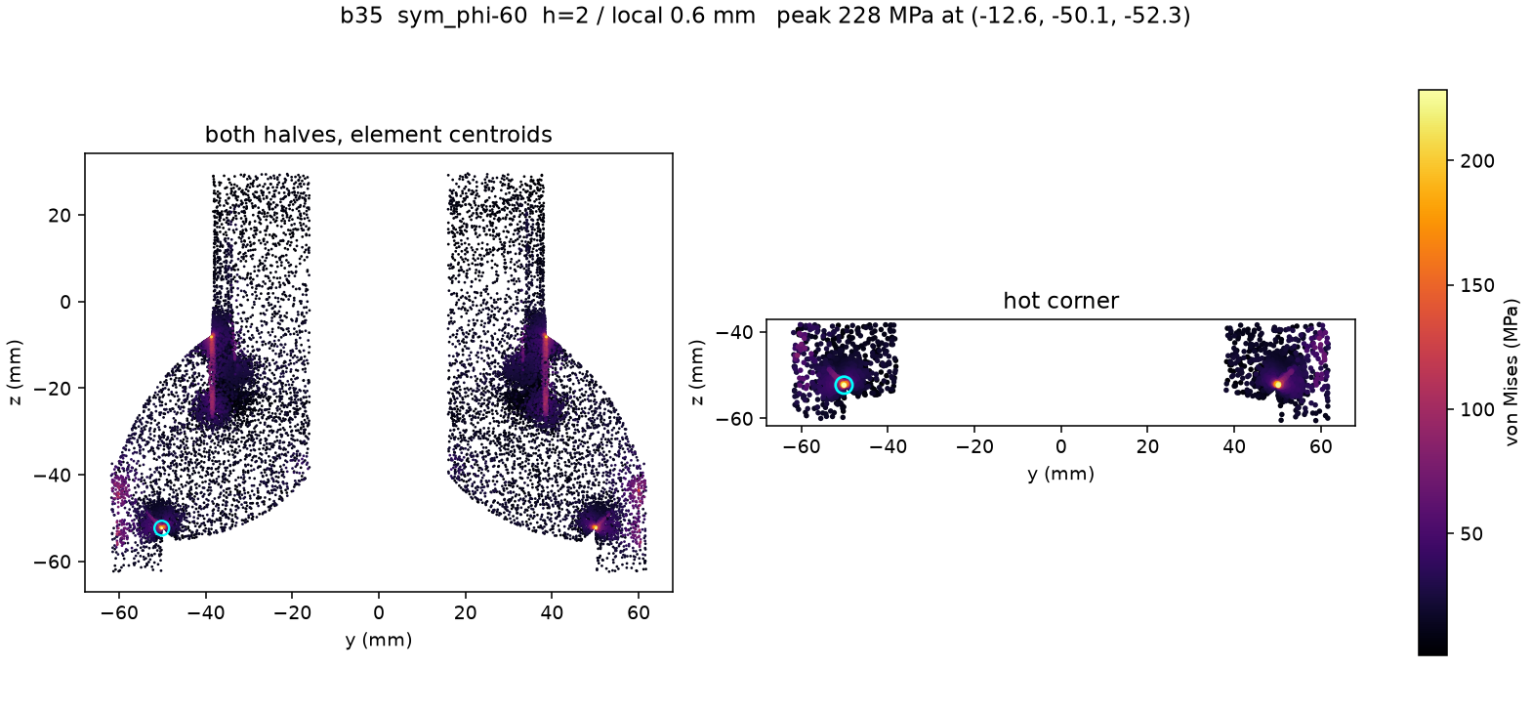
modules/actuators/fea/job2_g3_lever/governing_vm_b35.png
