BryanRalston/robot-lab/modules/actuators/fea/job2r_g3_lever/governing_vm_a.png

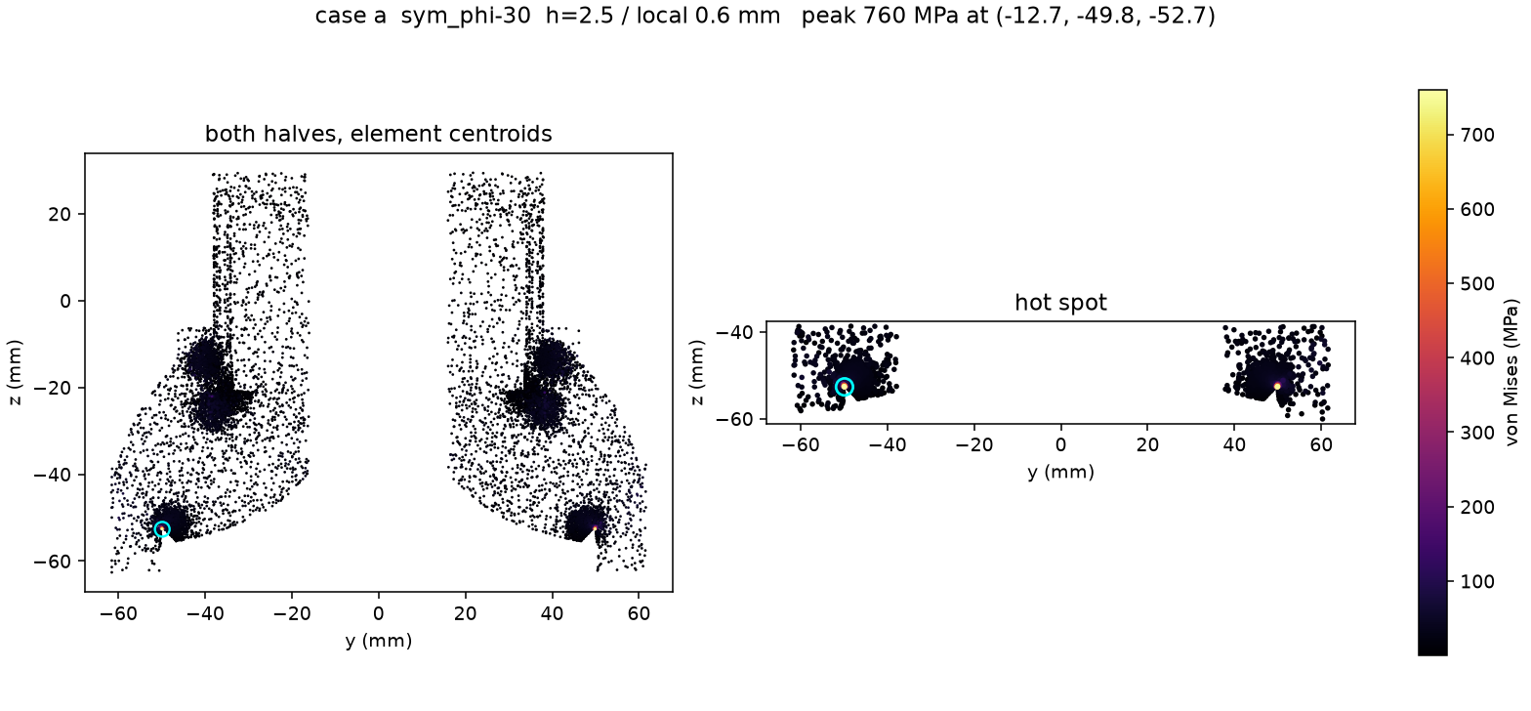
modules/actuators/fea/job2r_g3_lever/governing_vm_a.png
