BryanRalston/robot-lab/modules/arms/A42_forearm_wrist_r4.png

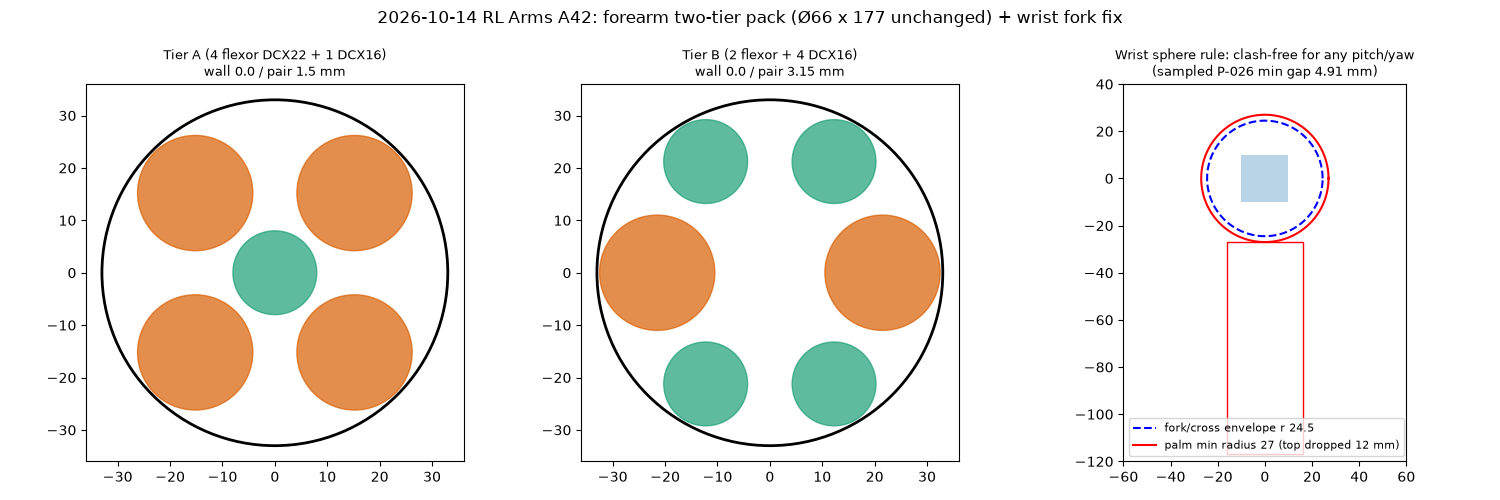
modules/arms/A42_forearm_wrist_r4.png
