BryanRalston/robot-lab/modules/arms/R13_standoff_7013.png

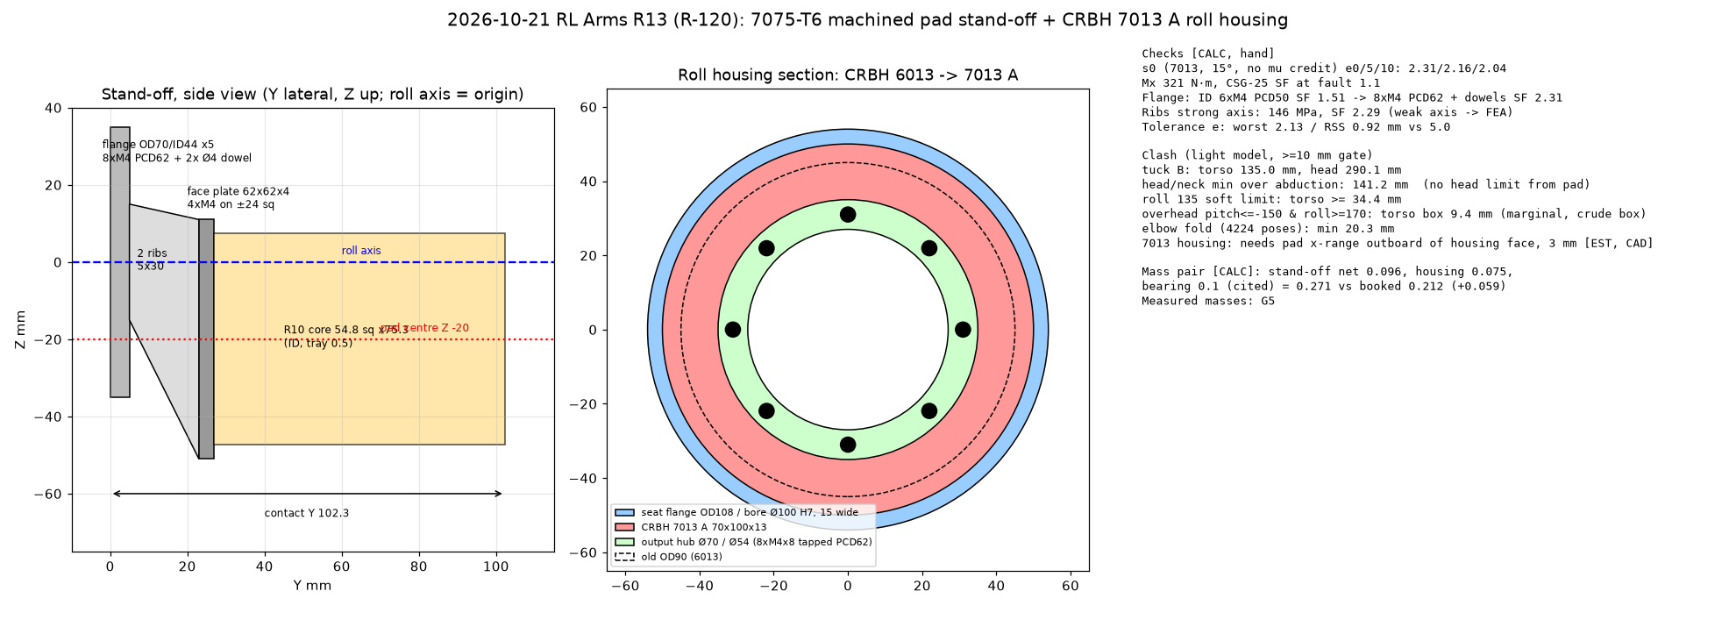
modules/arms/R13_standoff_7013.png
