BryanRalston/robot-lab/modules/arms/R15_w2_carrier.png

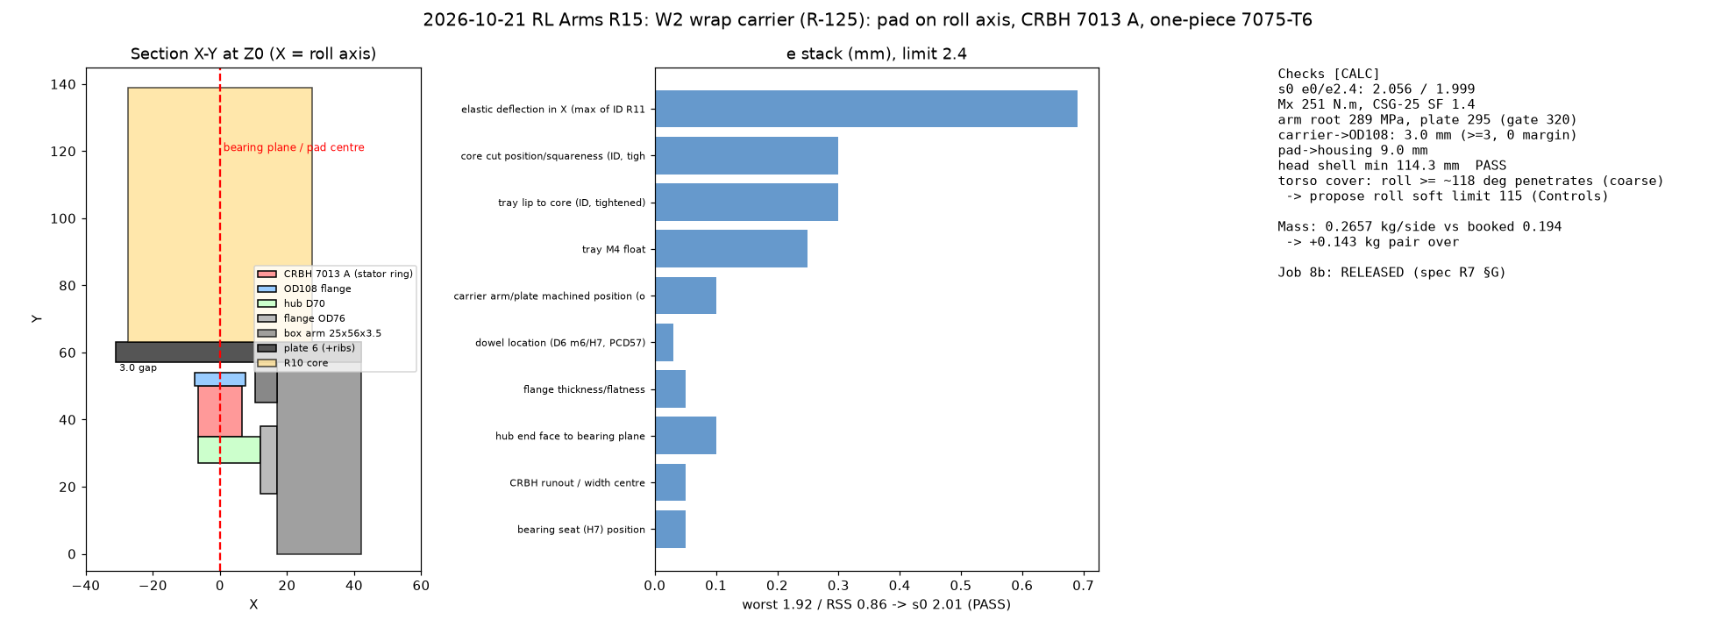
modules/arms/R15_w2_carrier.png
