BryanRalston/robot-lab/modules/design/HANDLING_MAP.png

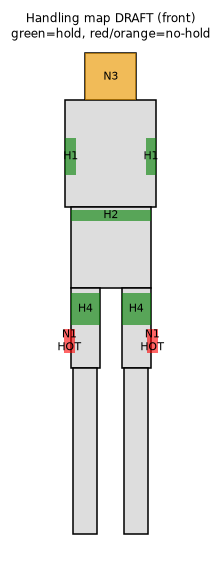
modules/design/HANDLING_MAP.png
