BryanRalston/robot-lab/modules/legs/plots/carry_20kg.png

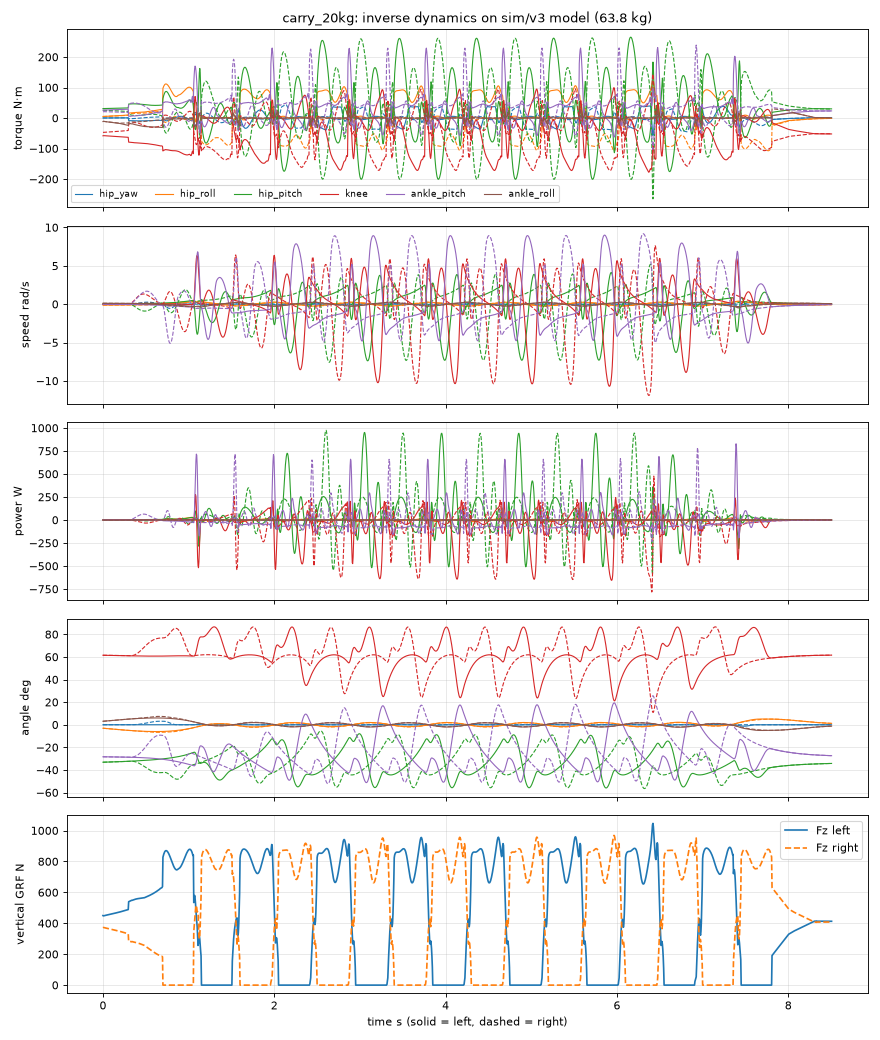
modules/legs/plots/carry_20kg.png
