BryanRalston/robot-lab/modules/legs/plots/envelope_vs_contract.png

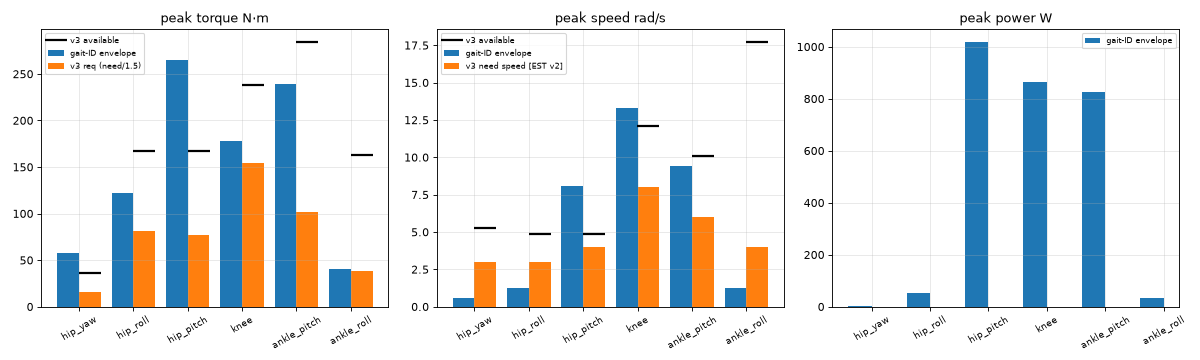
modules/legs/plots/envelope_vs_contract.png
