BryanRalston/robot-lab/modules/legs/plots/push_recover.png

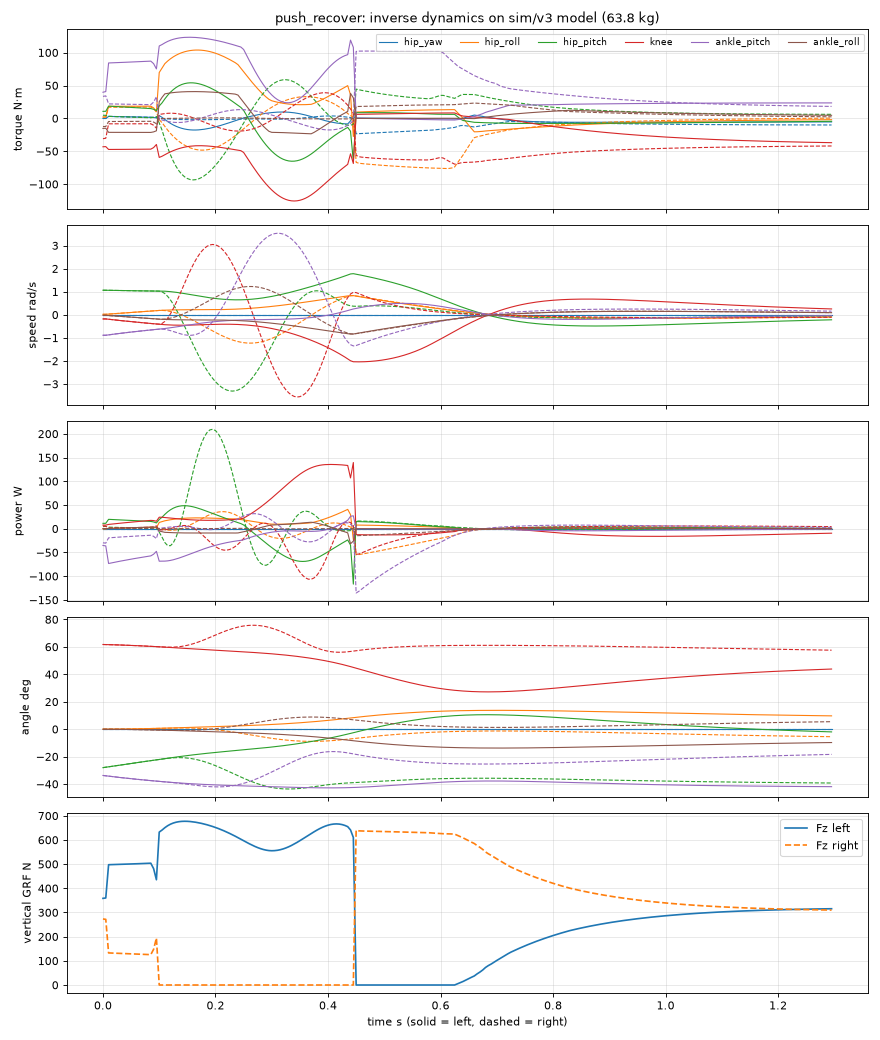
modules/legs/plots/push_recover.png
