BryanRalston/robot-lab/modules/legs/plots/r2/carry_20kg_r2.png

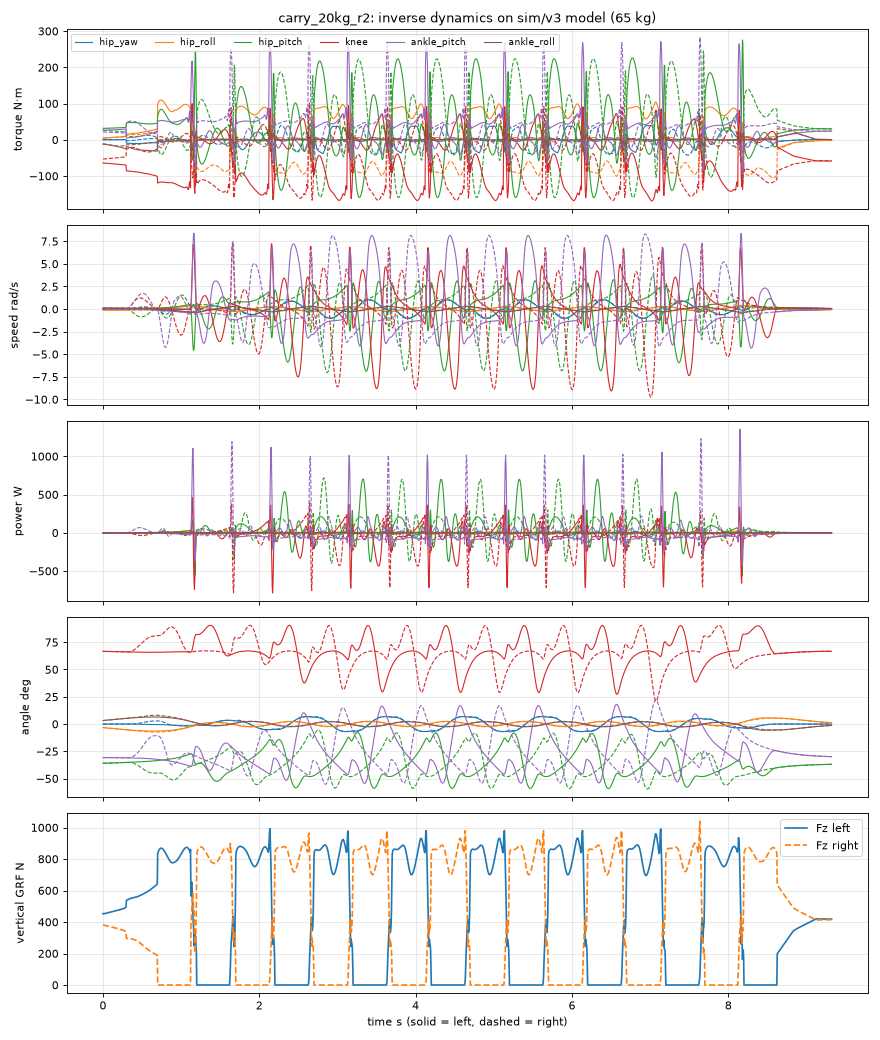
modules/legs/plots/r2/carry_20kg_r2.png
