BryanRalston/robot-lab/modules/legs/plots/r2/envelope_vs_contract.png

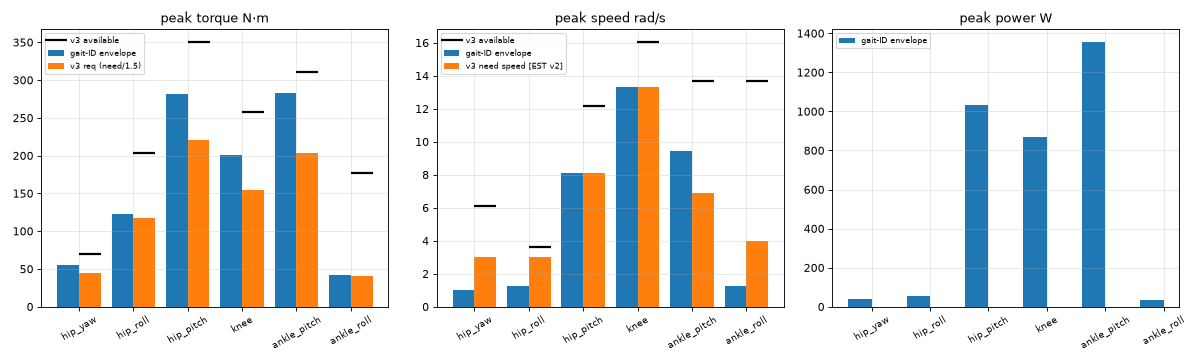
modules/legs/plots/r2/envelope_vs_contract.png
