BryanRalston/robot-lab/modules/legs/plots/r2/stairs_18cm.png

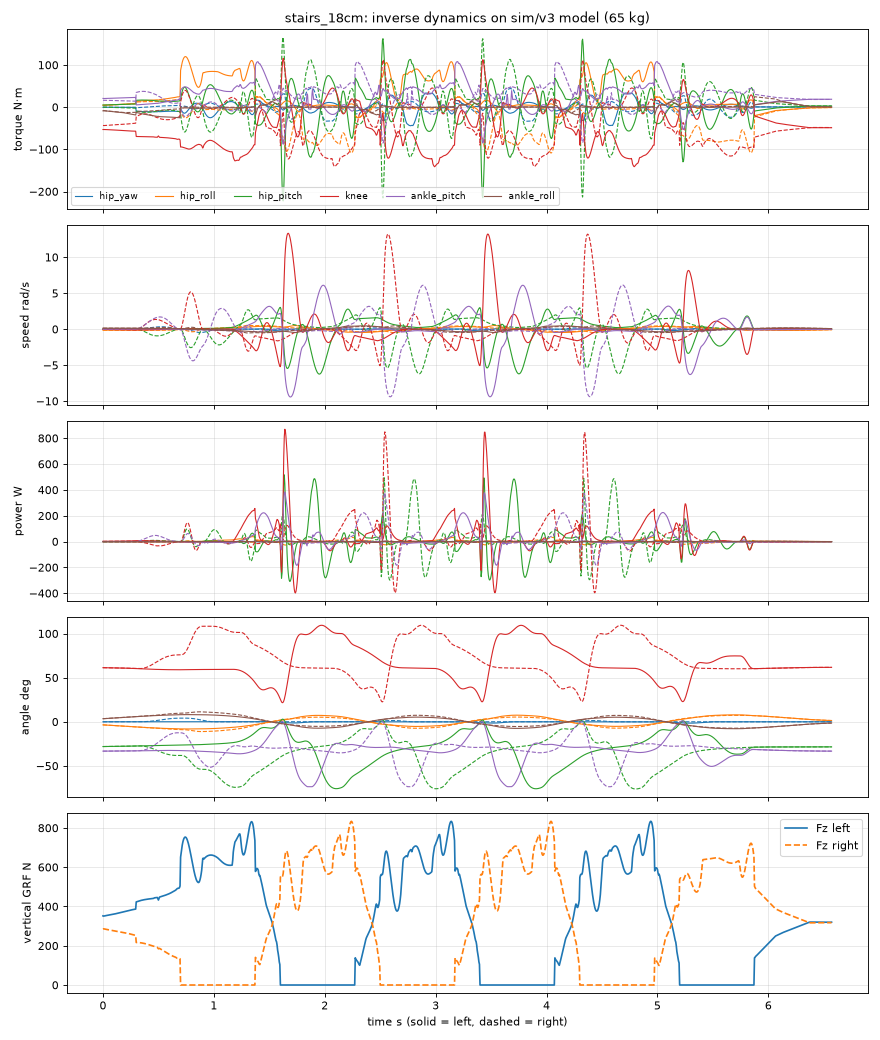
modules/legs/plots/r2/stairs_18cm.png
