BryanRalston/robot-lab/modules/legs/plots/r2/walk_1p2.png

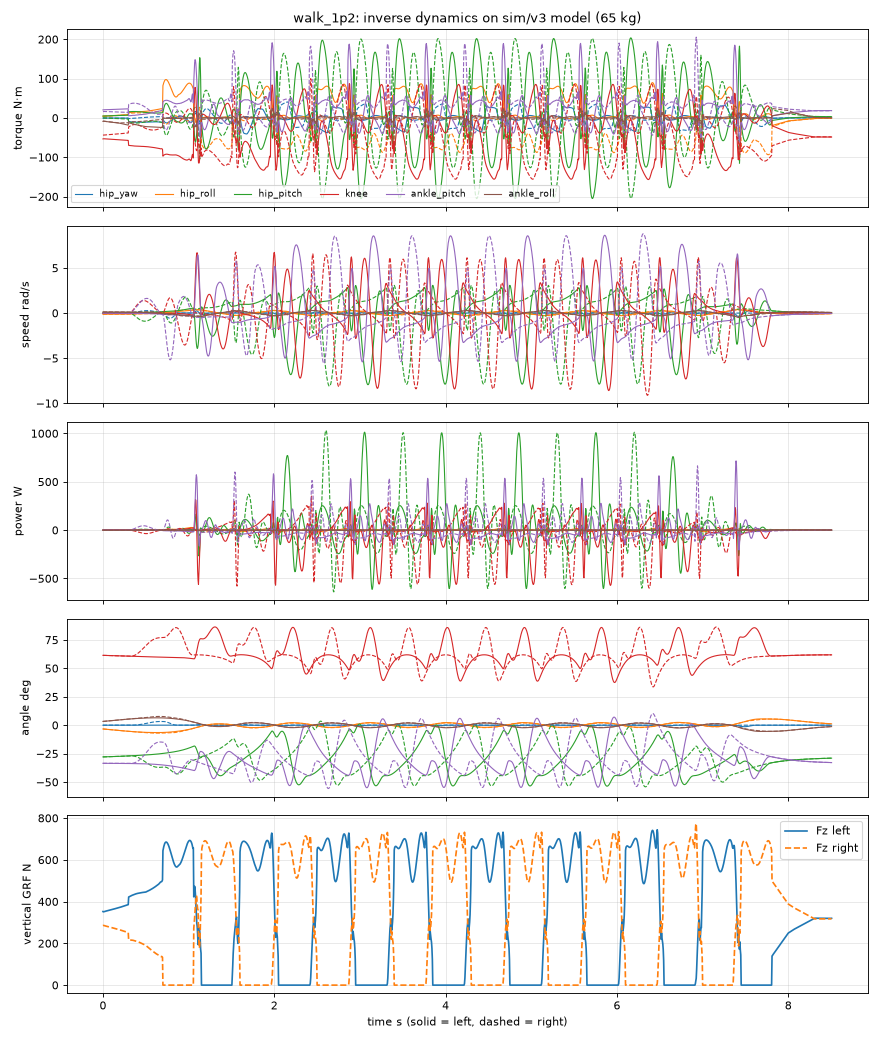
modules/legs/plots/r2/walk_1p2.png
