BryanRalston/robot-lab/modules/legs/plots/sit_to_stand.png

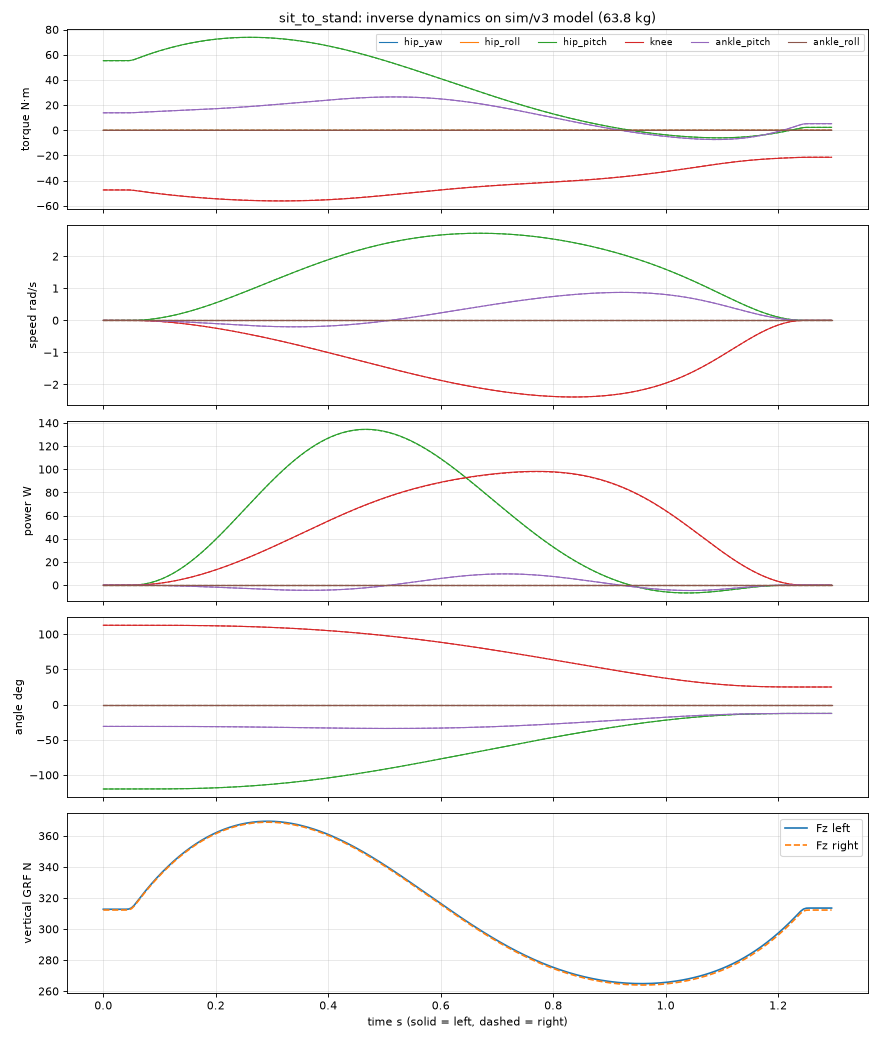
modules/legs/plots/sit_to_stand.png
