BryanRalston/robot-lab/modules/legs/plots/stairs_18cm.png

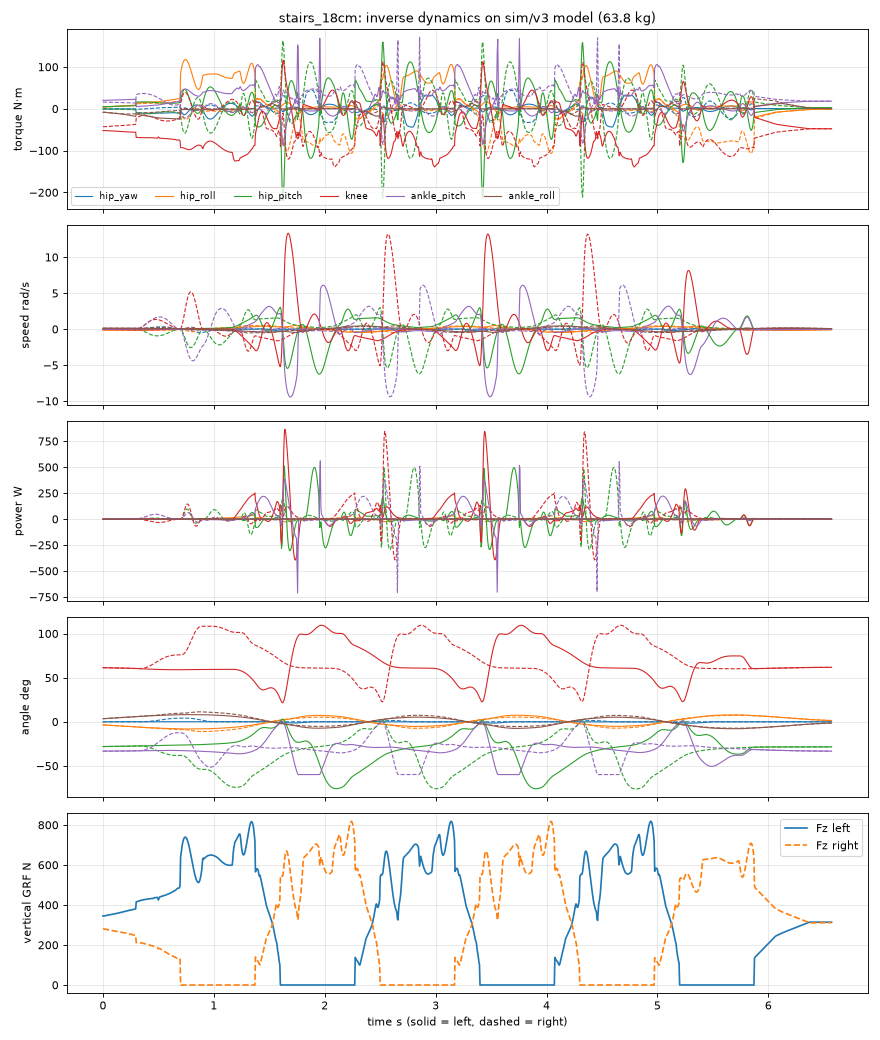
modules/legs/plots/stairs_18cm.png
