BryanRalston/robot-lab/modules/legs/plots/walk_0p8.png

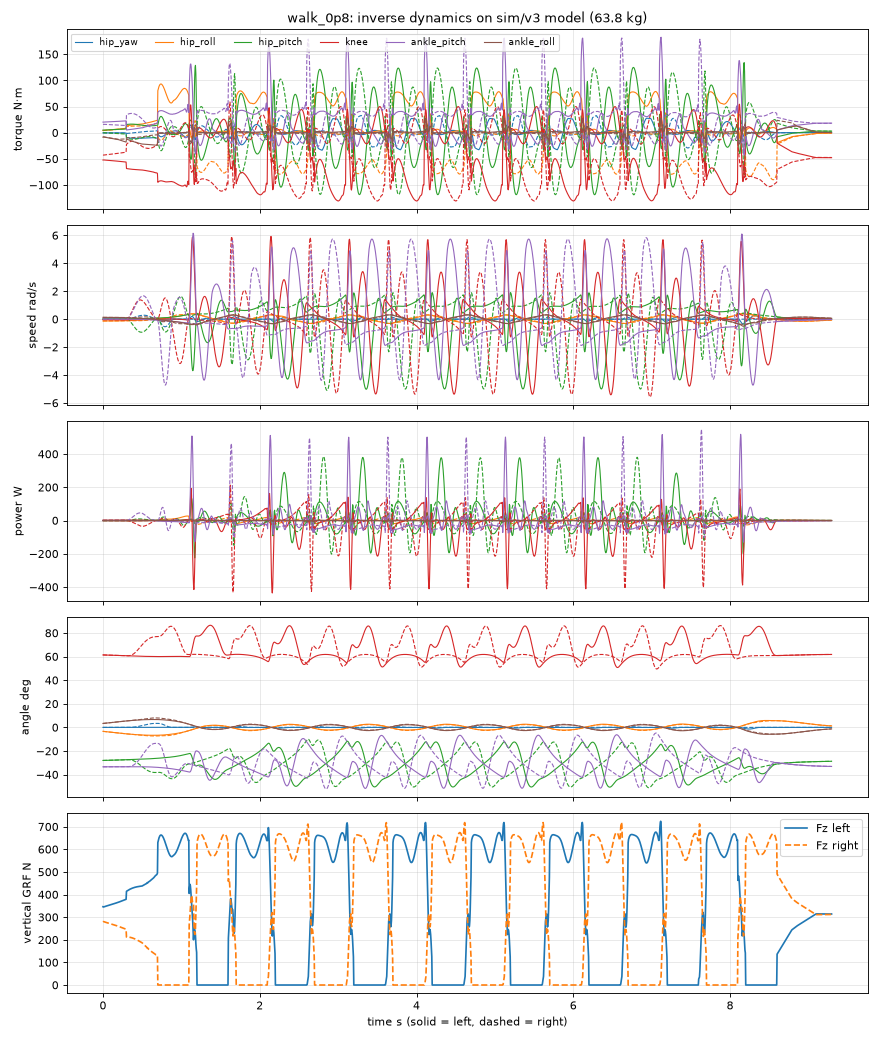
modules/legs/plots/walk_0p8.png
