BryanRalston/robot-lab/modules/legs/rl/curves/carry.png

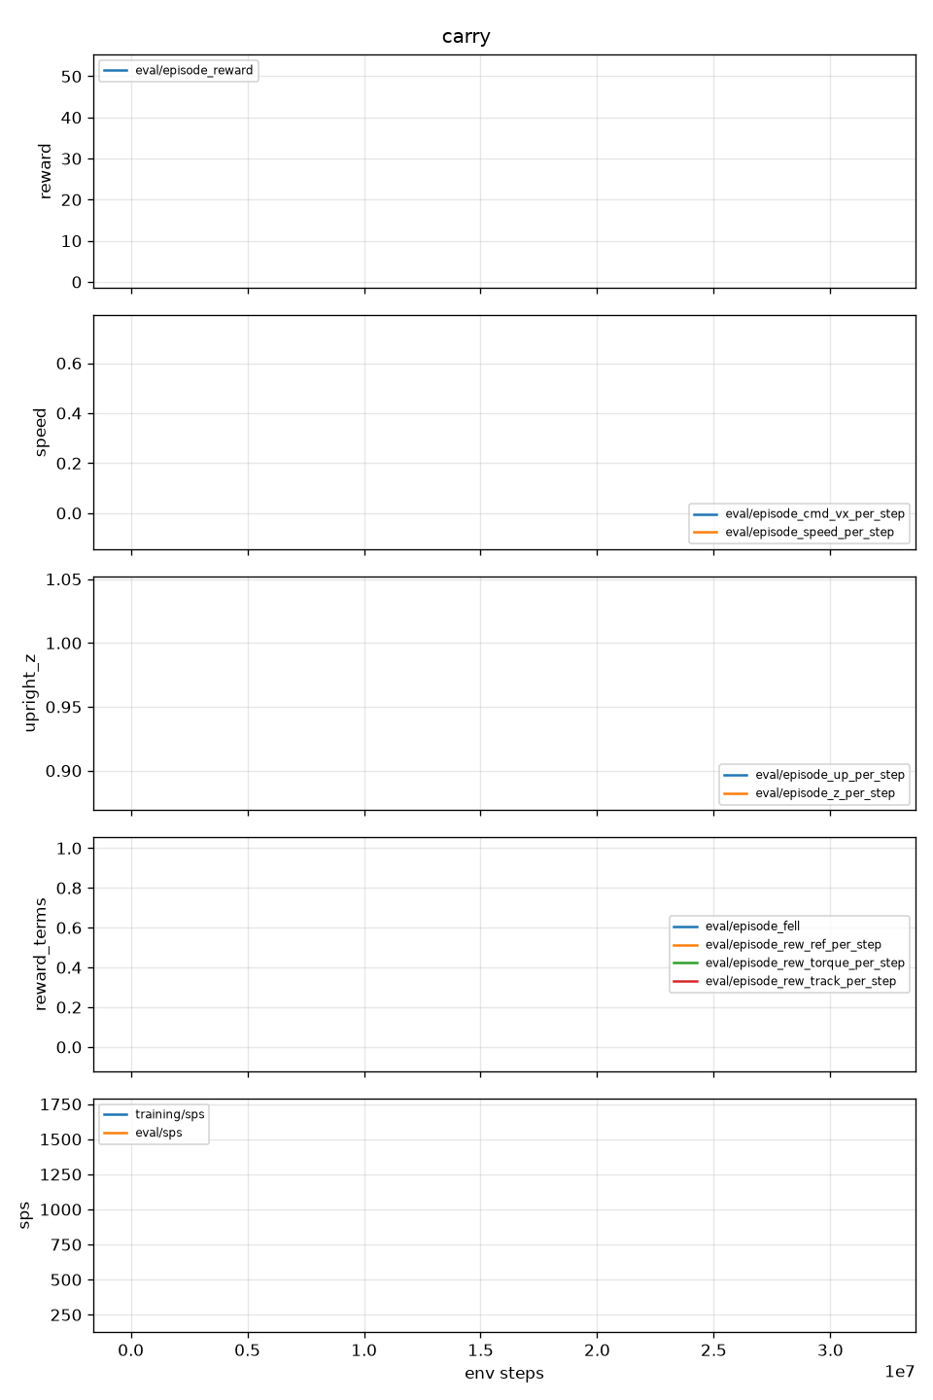
modules/legs/rl/curves/carry.png
