BryanRalston/robot-lab/modules/legs/rl/curves/walk_a.png

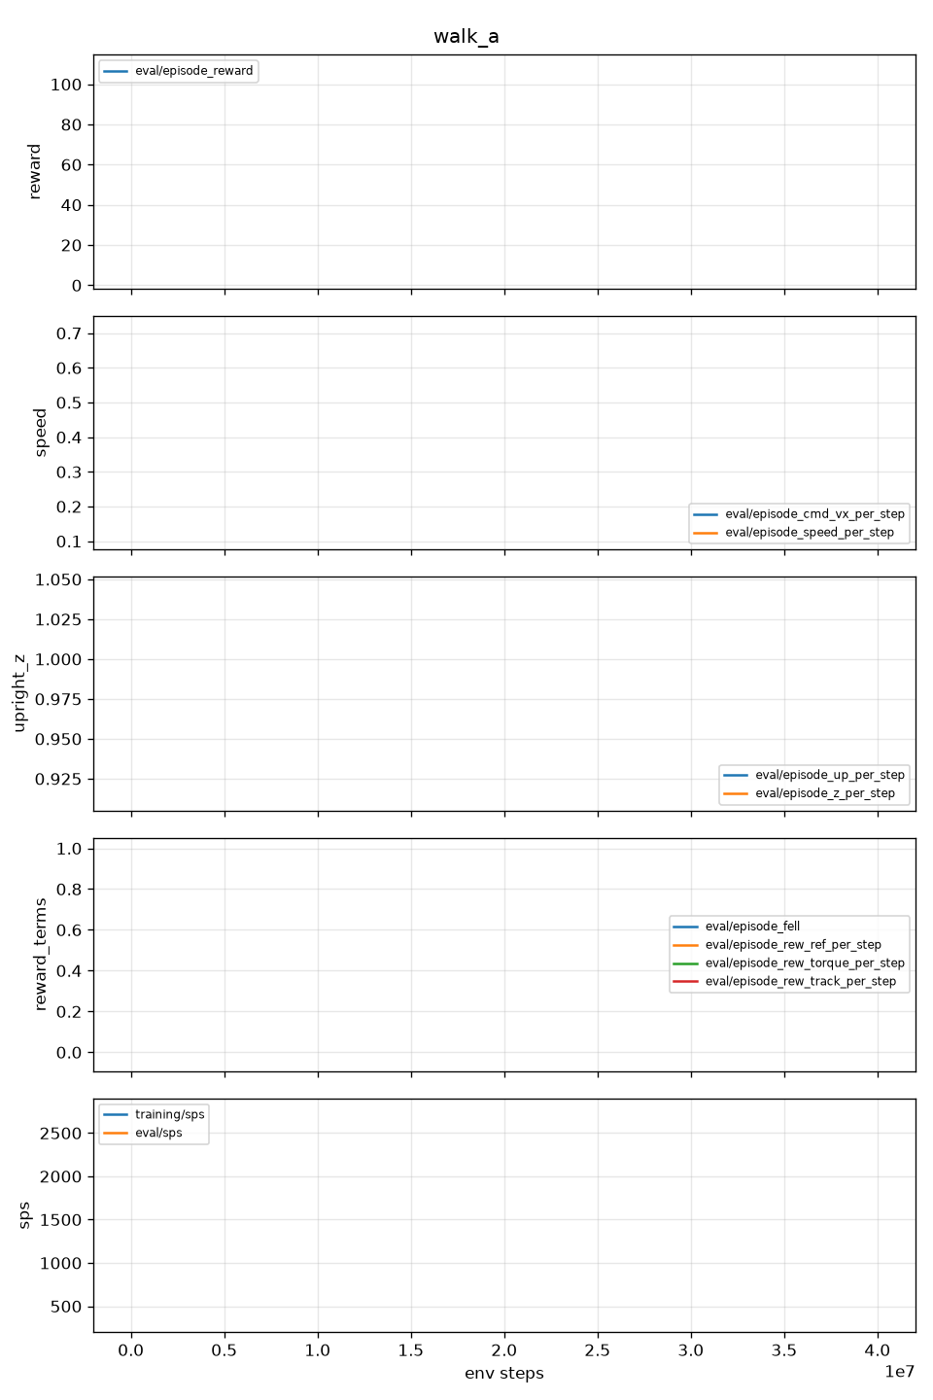
modules/legs/rl/curves/walk_a.png
