BryanRalston/robot-lab/modules/legs/rl/curves/walk_b.png

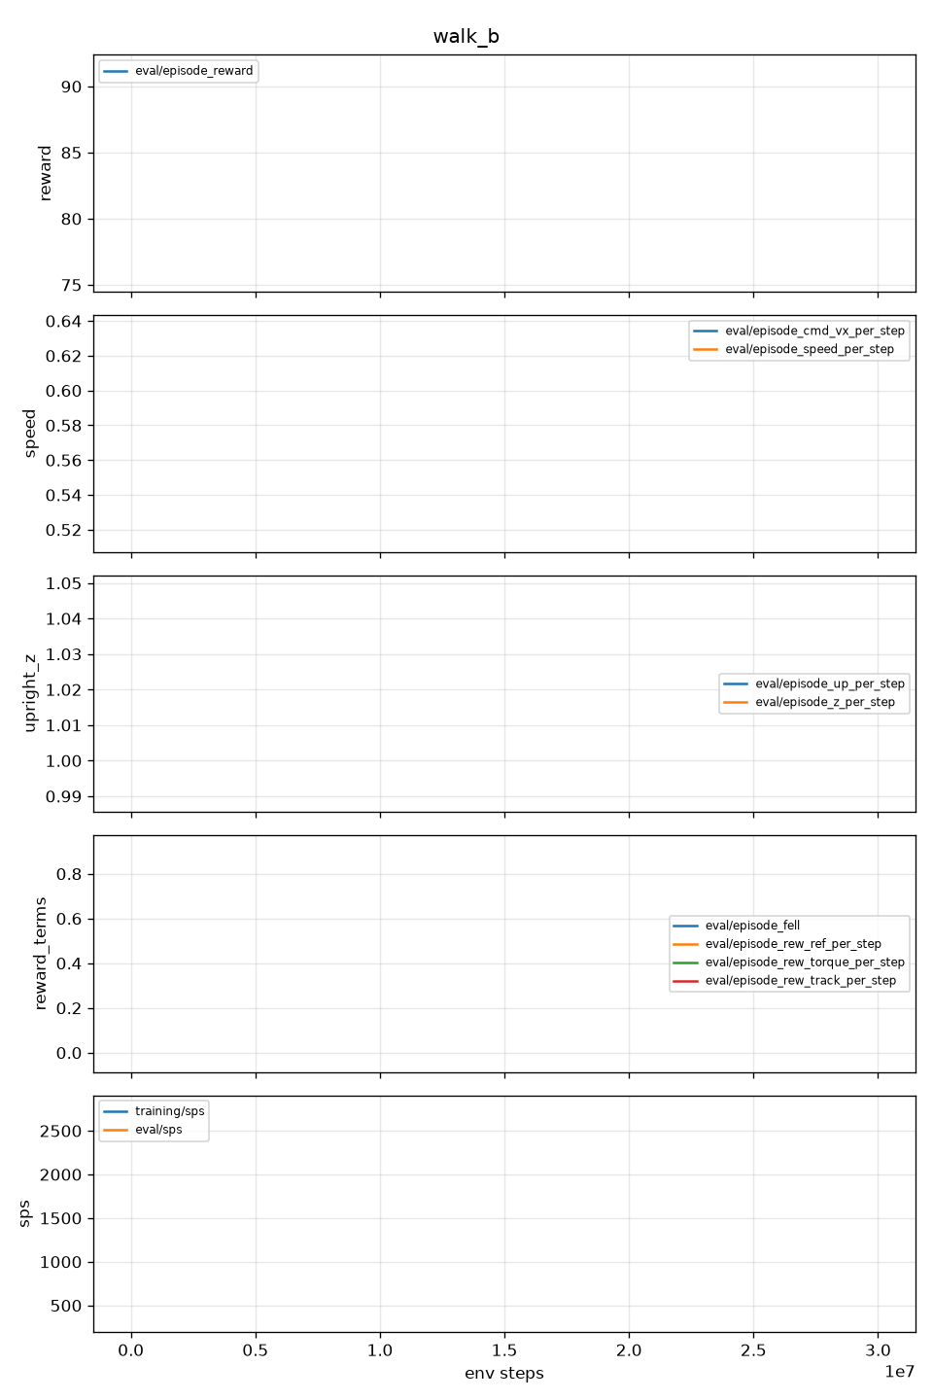
modules/legs/rl/curves/walk_b.png
