BryanRalston/robot-lab/modules/legs/rl/curves/walk_b_hardpush.png

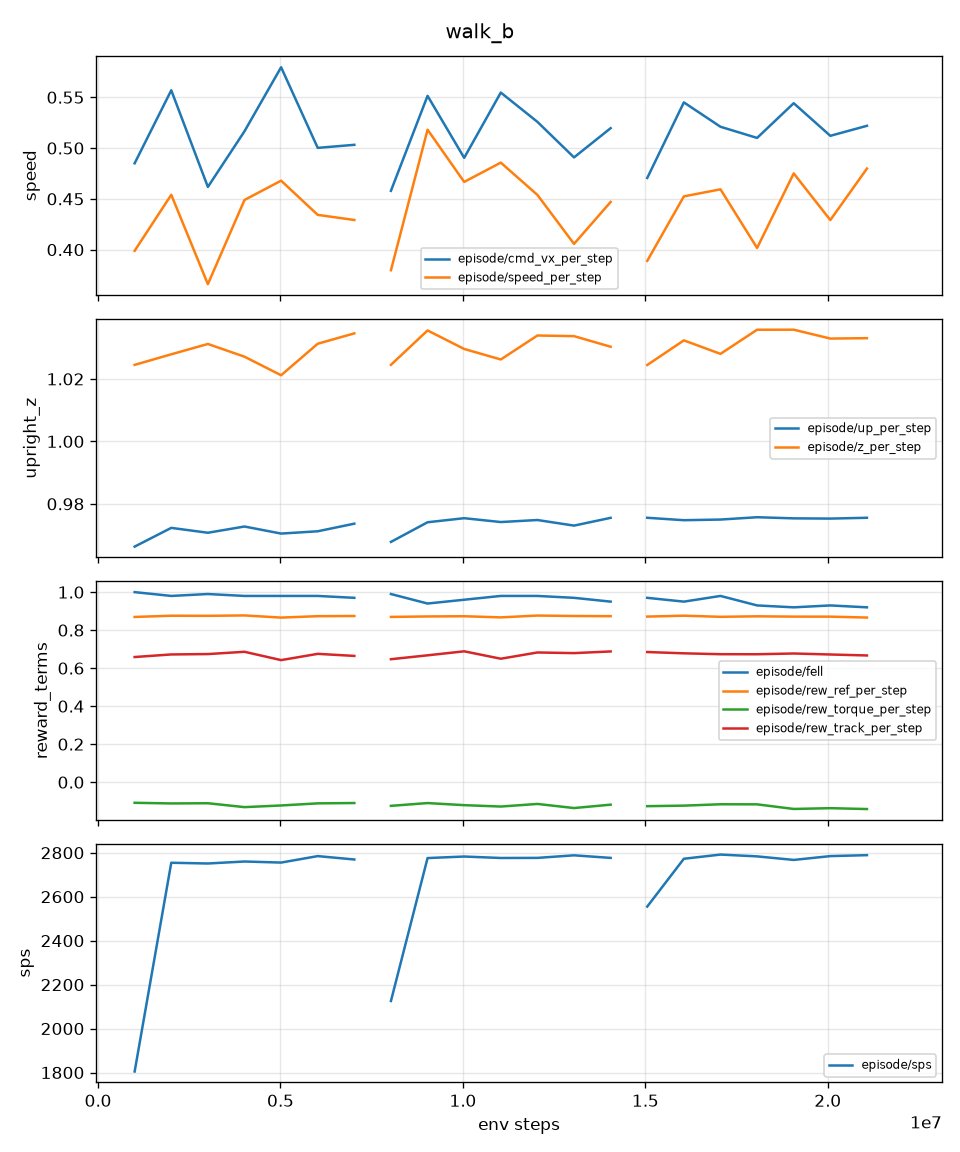
modules/legs/rl/curves/walk_b_hardpush.png
