BryanRalston/robot-lab/modules/legs/rl/walk.gif

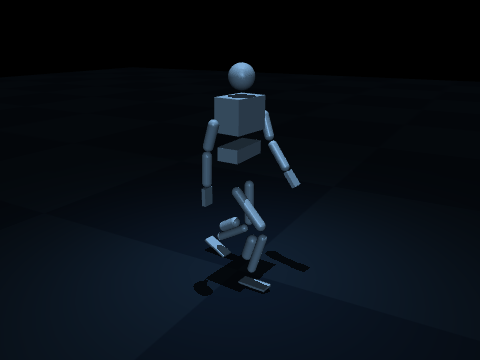
modules/legs/rl/walk.gif
