BryanRalston/robot-lab/shot_index.html.png

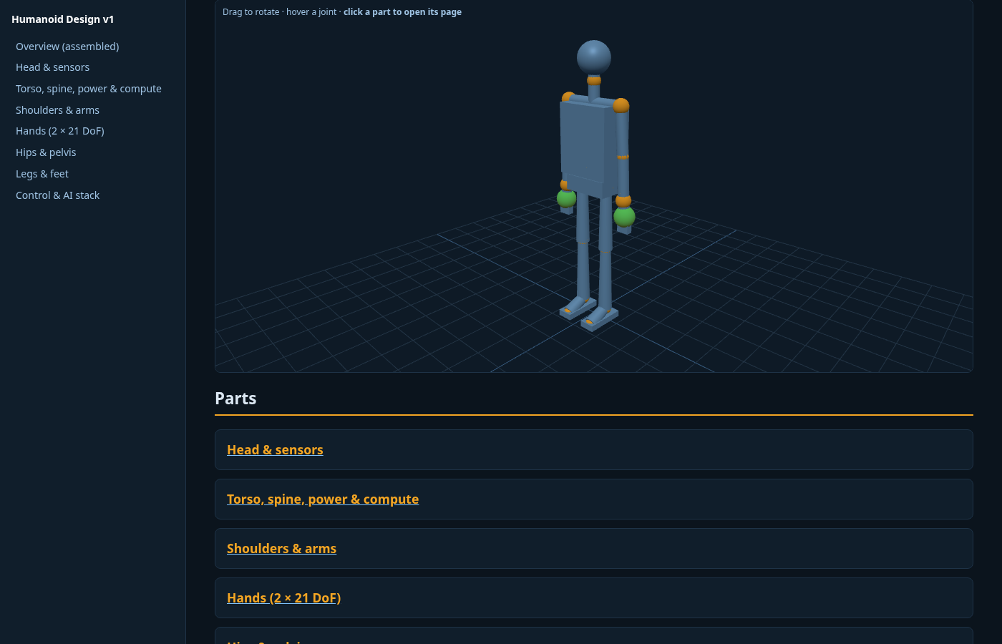
shot_index.html.png
