BryanRalston/robot-lab/shot_legs.html.png

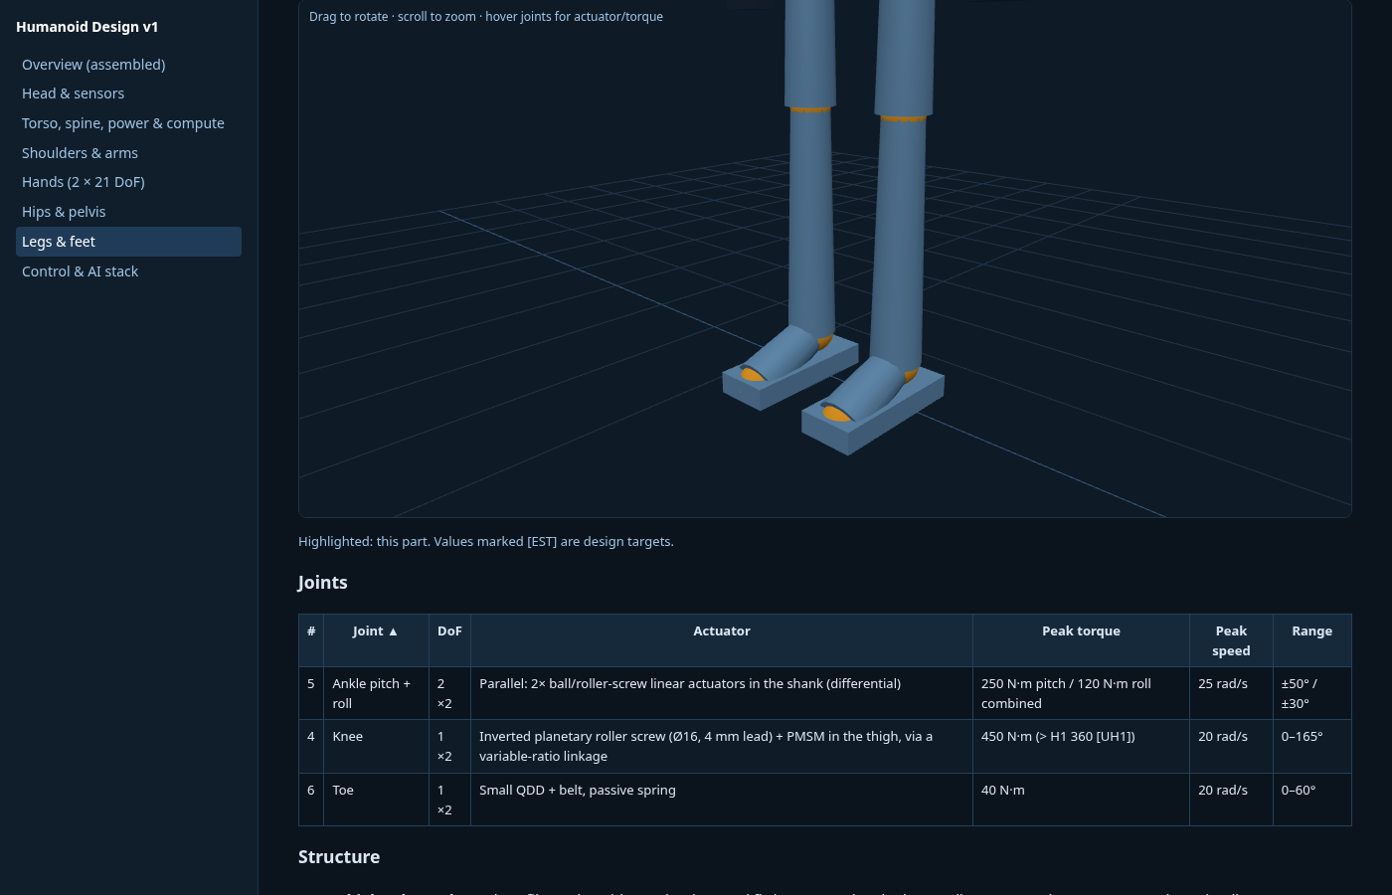
shot_legs.html.png
