BryanRalston/robot-lab/shot_sim.png

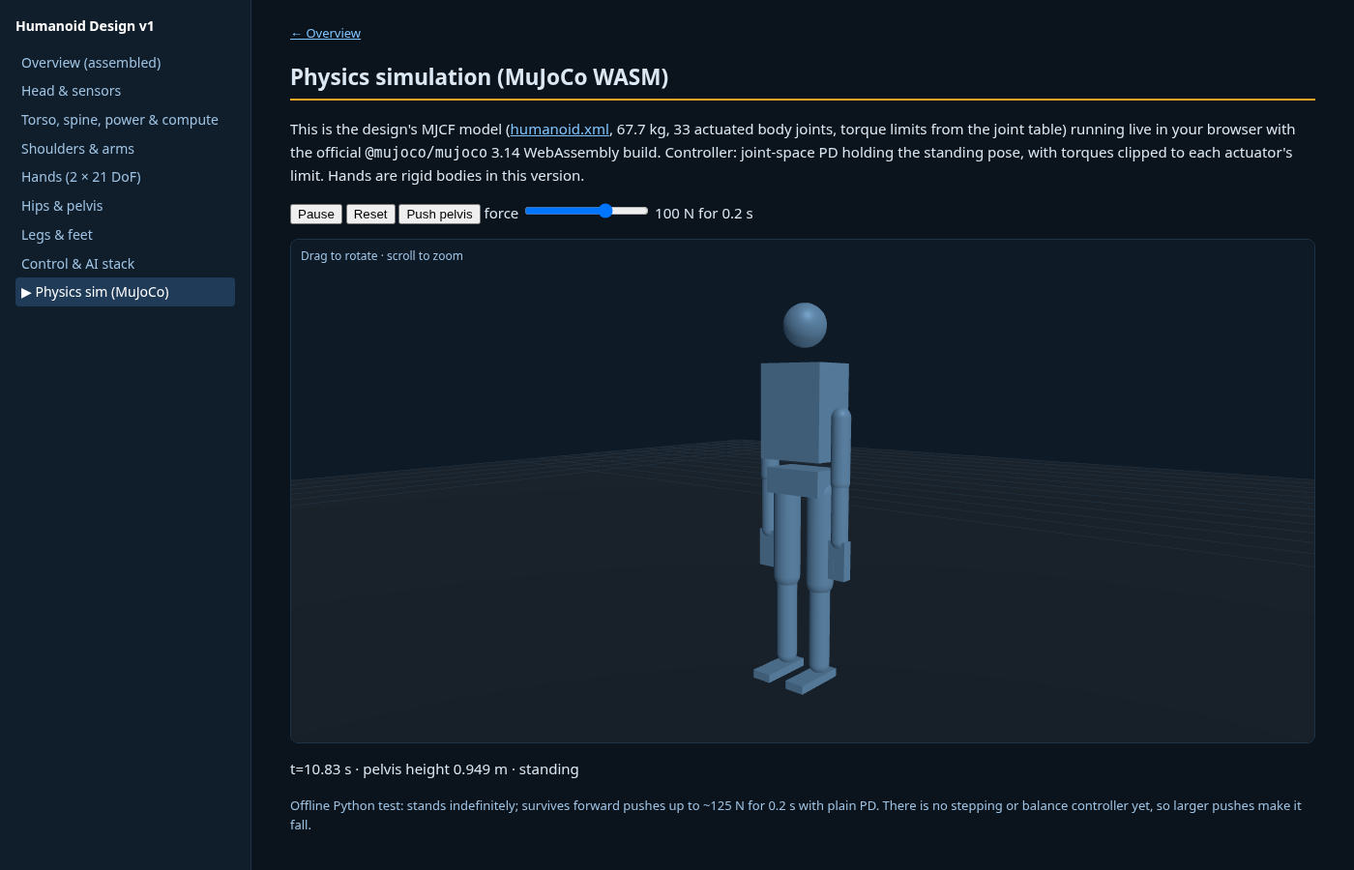
shot_sim.png
