BryanRalston/robot-lab/v3/PARTS.md

# v3 parts table (catalog parts, cited)

Every actuator part below is a catalog item; values are copied from the cited source. Items still marked [EST] are noted.

## Joint actuators (per joint; × count in the robot)

| joint | ×n | motor (winding) | Kt hot N·m/A | R Ω (25 °C, ph-ph) | Rth K/W | motor kg | transmission | rating | output bearing (C / C0 kN) | drive / encoder | actuator kg |
|---|---|---|---|---|---|---|---|---|---|---|---|
| hip_yaw | 2 | Kollmorgen TBM2G-05008A | 0.081 | 1.47 | 3.6 | 0.111 | Harmonic Drive CSG-14-100 | rated 10 / rep. peak 36 / mom. 70 / ratchet 100 N·m | IKO CRBH 6013 A (18.8 / 24.3) | Everest XCR / RLS AksIM-2 | 1.02 |
| hip_roll | 2 | Kollmorgen TBM2G-07608C | 0.096 | 0.318 | 2.15 | 0.236 | Harmonic Drive CSG-25-100 | rated 87 / rep. peak 204 / mom. 369 / ratchet 650 N·m | IKO CRBH 6013 A (18.8 / 24.3) | Everest XCR / RLS AksIM-2 | 1.52 |
| hip_pitch | 2 | Kollmorgen TBM2G-07608C | 0.096 | 0.318 | 2.15 | 0.236 | Harmonic Drive CSG-25-100 | rated 87 / rep. peak 204 / mom. 369 / ratchet 650 N·m | IKO CRBH 6013 A (18.8 / 24.3) | Everest XCR / RLS AksIM-2 | 1.52 |
| knee | 2 | Kollmorgen TBM2G-06808D | 0.044 | 0.115 | 2.45 | 0.188 | Rollvis RV12x4 roller screw, 58 mm lever | Ca 17.2 kN, C0a 27.2 kN, η 0.89 | rod-end spherical bearings [EST] | Everest XCR / RLS AksIM-2 | 1.81 |
| ankle_pitch | 2 | Kollmorgen TBM2G-06808D | 0.044 | 0.115 | 2.45 | 0.188 | Rollvis RV12x4 roller screw, 70 mm lever | Ca 17.2 kN, C0a 27.2 kN, η 0.89 | rod-end spherical bearings [EST] | Everest XCR / RLS AksIM-2 | 1.81 |
| ankle_roll | 0 | Kollmorgen TBM2G-06808D | 0.044 | 0.115 | 2.45 | 0.188 | Rollvis RV12x4 roller screw, 40 mm lever | Ca 17.2 kN, C0a 27.2 kN, η 0.89 | rod-end spherical bearings [EST] | Everest XCR / RLS AksIM-2 | 1.81 |
| waist_yaw | 1 | Kollmorgen TBM2G-06008A | 0.121 | 1.6 | 2.6 | 0.139 | Harmonic Drive CSG-17-100 | rated 31 / rep. peak 70 / mom. 143 / ratchet 200 N·m | IKO CRBH 5013 A (17.3 / 20.9) | Everest XCR / RLS AksIM-2 | 1.03 |
| waist_pitch | 1 | Kollmorgen TBM2G-06808A | 0.153 | 1.38 | 2.45 | 0.188 | Harmonic Drive CSG-25-100 | rated 87 / rep. peak 204 / mom. 369 / ratchet 650 N·m | IKO CRBH 5013 A (17.3 / 20.9) | Everest XCR / RLS AksIM-2 | 1.37 |
| shoulder_pitch | 2 | Kollmorgen TBM2G-07608C | 0.096 | 0.318 | 2.15 | 0.236 | Harmonic Drive CSG-25-100 | rated 87 / rep. peak 204 / mom. 369 / ratchet 650 N·m | IKO CRBH 6013 A (18.8 / 24.3) | Everest XCR / RLS AksIM-2 | 1.52 |
| shoulder_roll | 2 | Kollmorgen TBM2G-06813C | 0.113 | 0.427 | 2.3 | 0.254 | Harmonic Drive CSG-25-100 | rated 87 / rep. peak 204 / mom. 369 / ratchet 650 N·m | IKO CRBH 4010 A (8.6 / 10.6) | Everest XCR / RLS AksIM-2 | 1.24 |
| shoulder_yaw | 2 | Kollmorgen TBM2G-06008C | 0.061 | 0.4 | 2.6 | 0.139 | Harmonic Drive CSG-17-100 | rated 31 / rep. peak 70 / mom. 143 / ratchet 200 N·m | IKO CRBH 4010 A (8.6 / 10.6) | Everest XCR / RLS AksIM-2 | 0.81 |
| elbow | 2 | Kollmorgen TBM2G-05013C | 0.061 | 0.46 | 3.4 | 0.149 | Harmonic Drive CSG-20-100 | rated 52 / rep. peak 107 / mom. 191 / ratchet 330 N·m | IKO CRBH 3010 A (7.6 / 8.4) | Everest XCR / RLS AksIM-2 | 0.90 |
| wrist_roll | 2 | Kollmorgen TBM2G-05008C | 0.04 | 0.37 | 3.6 | 0.111 | Harmonic Drive CSG-14-100 | rated 10 / rep. peak 36 / mom. 70 / ratchet 100 N·m | IKO CRBH 208 A (2.9 / 2.4) | Everest XCR / RLS AksIM-2 | 0.55 |
| neck_yaw | 1 | Kollmorgen TBM2G-05008A | 0.081 | 1.47 | 3.6 | 0.111 | Harmonic Drive CSG-14-100 | rated 10 / rep. peak 36 / mom. 70 / ratchet 100 N·m | IKO CRBH 208 A (2.9 / 2.4) | Everest XCR / RLS AksIM-2 | 0.55 |
| neck_pitch | 1 | Kollmorgen TBM2G-05008A | 0.081 | 1.47 | 3.6 | 0.111 | Harmonic Drive CSG-14-100 | rated 10 / rep. peak 36 / mom. 70 / ratchet 100 N·m | IKO CRBH 208 A (2.9 / 2.4) | Everest XCR / RLS AksIM-2 | 0.55 |
| wrist_pitch | 2 | Kollmorgen TBM2G-05008C | 0.04 | 0.37 | 3.6 | 0.111 | Rollvis RV12x4 roller screw, 25 mm lever | Ca 17.2 kN, C0a 27.2 kN, η 0.89 | rod-end spherical bearings [EST] | Everest XCR / RLS AksIM-2 | 1.55 |
| wrist_yaw | 0 | Kollmorgen TBM2G-05008C | 0.04 | 0.37 | 3.6 | 0.111 | Rollvis RV12x4 roller screw, 25 mm lever | Ca 17.2 kN, C0a 27.2 kN, η 0.89 | rod-end spherical bearings [EST] | Everest XCR / RLS AksIM-2 | 1.55 |

Gear sizes 14 and 17 component-set masses are [EST] (not given in the table used). Housings are parametric 7075 shells (wall 3 mm), modelled in the CAD; harmonic-drive efficiency 75 % [EST]. Linear joints listed with ×0 share their screw pair with the pitch joint (differential pair).

## Other catalog parts

| item | part | key data | source |
|---|---|---|---|
| servo drive (one per motor) | Novanta Everest XCR | 45 A crest cont. (31.8 A rms), 60 A crest 1 s, ≤80 V, 38 g | EVE |
| joint encoder | RLS AksIM-2 off-axis absolute | 17–20 bit; ring + readhead masses per datasheet | AKSIM |
| battery cells | Molicel INR-21700-P45B ×91 (13S7P) | 16.2 Wh, ≤70 g each → 1474 Wh, 8.0 kg incl. 1.25× pack overhead [EST] | P45B |
| finger flexor drives (6 per hand) | maxon DCX 22 S + GPX 22 HP 111:1 | 15.3 mN·m cont.; gearhead 3.3 N·m cont., η 0.65 | DCX22, GPX22 |
| abduction/thumb drives (5 per hand) | maxon DCX 16 S + GPX 16 LN 103:1 | 5.2 mN·m cont.; 0.28 N·m cont. | DCX16, GPX16 |
| tendons | LIROS D-Pro 1 mm (Dyneema SK78) | 195 daN break | LIROS |
| structure | 7075-T6 | Su 572, Sy 503, Sf 159 MPa @5e8 | AL7075 |
| fasteners | ISO 898-1 class 12.9 | Rp0.2 ≥ 1100 MPa | ISO898 |
| cables | igus chainflex CFROBOT-class | moving bend radius ≥ 10×d | IGUS |

## Sources

| key | document | URL / reference |
|---|---|---|
| TBM2G | Kollmorgen TBM2G Frameless Motor Instruction Manual Rev B (June 2023), section 9 per-model specification pages | https://shop.oxni.ch/files/v240708160007/Kollmorgen/TBM/MN%20TBM2G%20RevB%20En.pdf ; https://www.kollmorgen.com/en-us/products/motors/direct-drive/tbm2g-series-frameless |
| HD-CSG | Harmonic Drive CSG-2A component set rating table (rated L10, repeated peak, momentary peak, mass) and CSF/CSG catalog (ratcheting torque Table 6, average torque, life formula) | https://www.harmonicdrive.net/products/component-sets/cup-type/csg-2a ; https://www.harmonicdrive.net/_hd/content/documents/csf-csg.pdf ; https://innodrive.ru/upload/iblock/195/ip72y4t28r1me60a2i9db29chijhvzqf.pdf (CSG-2A catalog, sizes 14/17 and average torque) |
| RV | Rollvis RV planetary roller screw product tables (Ca, C0a, nut dims, efficiency) | https://rollvis.com/wp-content/uploads/2024/05/Product-Tables-Rollvis-RV-Planetary-Roller-Screw-EN.pdf |
| IKO | IKO Crossed Roller Bearings catalog CAT-57151 (CRBH dimensions, C, C0, equivalent load with moment) | https://www.ikont.eu/files/Documents/Catalogues/CAT-57151UKv3_IKO_CRB.pdf |
| EVE | Novanta Everest XCR servo drive product description (45 A crest cont., 60 A crest 1 s, 80 V, 38 g) | https://drives.novantamotion.com/eve-xcr/product-description |
| AKSIM | RLS AksIM-2 off-axis absolute encoder datasheet MBD01 (17–20 bit, ring/readhead masses) | https://cdn.rls.si/documents/datasheets/MBD01_07_ds.pdf |
| DCX22 | maxon DCX 22 S graphite brushes datasheet (24 V winding: 15.3 mNm cont., 66 g, Rth 16+7 K/W) | https://innodrive.ru/upload/iblock/5b9/wra0c4ctrwv0jzqxwuy3ze74t678s55p.pdf |
| GPX22 | maxon GPX 22 HP gearhead (3-stage: 3.3 N·m cont., 65 % max eff., 107 g, ratios 62–231) | https://www.maxongroup.com/medias/sys_master/root/9406758256670/Cataloge-Page-EN-393.pdf |
| DCX16 | maxon DCX 16 S datasheet (5.2 mNm cont., 26 g) | https://www.maxongroup.com/medias/sys_master/root/8992244498462/EN-22-101.pdf |
| GPX16 | maxon GPX 16 LN gearhead (3-stage 0.28 N·m cont., 75 %, 25.7 mm, 27 g) | https://www.maxongroup.com/medias/sys_master/root/9406695473182/Cataloge-Page-EN-382.pdf |
| LIROS | LIROS D-Pro 1 mm (Dyneema SK78, 12-plait, breaking strength 195 daN) | https://www.liros.com/catalog/en/d-pro-1mm-p3511/ |
| CBOS | Bending-over-sheave endurance of small cables in prosthetic applications (HBO Kennisbank): 10 mm sheave, 150 N, Dyneema SK78 ≥ 31,826 cycles, none survived 50,000 | https://hbo-kennisbank.nl/details/sharekit_hh:oai:surfsharekit.nl:6534b4a7-f407-403f-bdd8-826dd64ce87a |
| AL7075 | Anchor Harvey 7075 datasheet (T6: Su 572 MPa, Sy 503 MPa, fatigue 159 MPa at 5e8 cycles, R=-1) | https://www.anchorharvey.com/media/fiahg3e0/anchorharvey-aluminum7075-datasheet.pdf |
| P45B | Molicel INR-21700-P45B product data sheet (4.5 Ah typ., 16.2 Wh, ≤70 g, 45 A cont.) | https://www.molicel.com/wp-content/uploads/INR21700P45B_1.4_Product-Data-Sheet-of-INR-21700-P45B-80109.pdf |
| IGUS | igus chainflex CFROBOT data sheets: min. bend radius 10×d moving (e-chain), 8×d flexible, 5×d fixed | https://www.igus.com/ContentData/Products/Downloads/2_EU_Data_sheet_chainflex_CFROBOT9.pdf |
| ISO898 | ISO 898-1 property class 12.9: Rp0.2 ≥ 1100 MPa, Rm ≥ 1220 MPa (standard values) | ISO 898-1:2013 |
| VDI2230 | VDI 2230 Part 1 (2015) systematic bolted-joint calculation: tightening preload, load factor, embedding, ASV fatigue limit for rolled-after-HT threads | VDI 2230 Blatt 1:2015 |
