BryanRalston/robot-lab/modules/covers/COVER_COST.md

# P-020/P-022..P-025 cover cost sheet (A30, A29 list after the final Legs envelopes)
Basis: trimmed v5 set, `modules/design/V5_COVER_SET.md`: **8 rigid PC thermoform panels** (thigh front/outboard, foot top, knee cap; L/R separate). The shin fairing is deleted because the lower shank and knee saddle are no-cover zones (Thermal D69). Plus 1 rim strip tool, 1 bellows mould (or COTS) and 2 sewing patterns. EPP pads not costed.

| Item | Cost | Basis |
|---|---|---|
| PC sheet 3 × 24×48″ 1.5 mm | $77 | cited (Falken) |
| 8 vacuum-form tools @ $900 + 8 trim fixtures @ $250 | $9,200 | [EST] |
| Rim strip former $300, bellows mould $1,500 (COTS ~$150 alt), 2 patterns $400 | $2,200 | [EST] |
| 8 rigid panels @ ≈ $86 | $687 | sheet cited, rest [EST] |
| 2 rim strips $40, 4 sewn parts $240, 1 bellows $40 | $320 | [EST] |
| **First robot set** | **≈ $12,480** (was ≈ $17,430 at 12 tools) | |
| Each further set | ≈ $1,080 | |
| Prototype route: tooling-board tools ~$300 each, COTS bellows | **≈ $6,330** first set | [EST] |

Line items in `COVER_COST.csv`. The CF thigh option (4 panels) needs machined Al tools (≈ +$1.6k) [EST].
