BryanRalston/robot-lab/modules/actuators/results/fastener_bom_table.md

| unit | item | size | n/unit | n/robot | grade | structural | reason | basis | steel g (robot) | Ti64 g (robot) |
|---|---|---|---:|---:|---|---|---|---|---:|---:|
| hip_yaw (CSG-17) | flexspline -> output hub | M5x12 | 6 | 12 | 12.9 steel | YES | gear torque path; HD requires >= 12.9 | HD Table 24; L [EST] | 40.6 | — |
| hip_yaw (CSG-17) | circular spline -> housing | M3x10 | 16 | 32 | 12.9 steel | YES | gear torque reaction | HD Table 27; L [EST] | 28.3 | — |
| hip_yaw (CSG-17) | output flange -> customer | M5x16 | 8 | 16 | 12.9 steel | YES | joint load path (interface, CONTRACTS 1c) | cad_mass.py 8 x M5x16 (legs); M4x12 on CSG-14/20 [EST] | 63.9 | — |
| hip_yaw (CSG-17) | crossed-roller clamp ring | M3x8 | 8 | 16 | 12.9 steel | YES | retains bearing outer ring axially (fall/impact load) | [EST] (Arms R13 clamp ring, count not drawn) | 12.4 | — |
| hip_yaw (CSG-17) | rear cap / encoder cover | M3x8 | 6 | 12 | 12.9 steel | no | cover only; motor reaction goes via stator bond land to tube | cad_mass.py 6 x M3; L [EST] | 9.3 | 5.2 |
| hip_yaw (CSG-17) | AksIM-2 readhead | M2x6 | 2 | 4 | A2 | no | locates readhead, no load; ring is press-fit | [EST] (RLS MBD01: ring press-fit) | 1.3 | 0.7 |
| hip_yaw (CSG-17) | Elmo drive mount | M2x6 | 4 | 8 | A2 | no | board/heat-sink mount; thermal contact (Thermal to OK Ti) | Elmo install guide l.770-773 (4 x M2 A2); L [EST] | 2.5 | 1.4 |
| hip_roll (CSG-25) | flexspline -> output hub | M6x14 | 8 | 16 | 12.9 steel | YES | gear torque path; HD requires >= 12.9 | HD Table 24; L [EST] | 92.0 | — |
| hip_roll (CSG-25) | circular spline -> housing | M4x12 | 16 | 32 | 12.9 steel | YES | gear torque reaction | HD Table 27; L [EST] | 62.9 | — |
| hip_roll (CSG-25) | output flange -> customer | M5x16 | 8 | 16 | 12.9 steel | YES | joint load path (interface, CONTRACTS 1c) | cad_mass.py 8 x M5x16 (legs); M4x12 on CSG-14/20 [EST] | 63.9 | — |
| hip_roll (CSG-25) | crossed-roller clamp ring | M3x8 | 8 | 16 | 12.9 steel | YES | retains bearing outer ring axially (fall/impact load) | [EST] (Arms R13 clamp ring, count not drawn) | 12.4 | — |
| hip_roll (CSG-25) | rear cap / encoder cover | M3x8 | 6 | 12 | 12.9 steel | no | cover only; motor reaction goes via stator bond land to tube | cad_mass.py 6 x M3; L [EST] | 9.3 | 5.2 |
| hip_roll (CSG-25) | AksIM-2 readhead | M2x6 | 2 | 4 | A2 | no | locates readhead, no load; ring is press-fit | [EST] (RLS MBD01: ring press-fit) | 1.3 | 0.7 |
| hip_roll (CSG-25) | Elmo drive mount | M2x6 | 4 | 8 | A2 | no | board/heat-sink mount; thermal contact (Thermal to OK Ti) | Elmo install guide l.770-773 (4 x M2 A2); L [EST] | 2.5 | 1.4 |
| waist_yaw (CSG-17) | flexspline -> output hub | M5x12 | 6 | 6 | 12.9 steel | YES | gear torque path; HD requires >= 12.9 | HD Table 24; L [EST] | 20.3 | — |
| waist_yaw (CSG-17) | circular spline -> housing | M3x10 | 16 | 16 | 12.9 steel | YES | gear torque reaction | HD Table 27; L [EST] | 14.2 | — |
| waist_yaw (CSG-17) | output flange -> customer | M5x16 | 8 | 8 | 12.9 steel | YES | joint load path (interface, CONTRACTS 1c) | cad_mass.py 8 x M5x16 (legs); M4x12 on CSG-14/20 [EST] | 32.0 | — |
| waist_yaw (CSG-17) | crossed-roller clamp ring | M3x8 | 8 | 8 | 12.9 steel | YES | retains bearing outer ring axially (fall/impact load) | [EST] (Arms R13 clamp ring, count not drawn) | 6.2 | — |
| waist_yaw (CSG-17) | rear cap / encoder cover | M3x8 | 6 | 6 | 12.9 steel | no | cover only; motor reaction goes via stator bond land to tube | cad_mass.py 6 x M3; L [EST] | 4.6 | 2.6 |
| waist_yaw (CSG-17) | AksIM-2 readhead | M2x6 | 2 | 2 | A2 | no | locates readhead, no load; ring is press-fit | [EST] (RLS MBD01: ring press-fit) | 0.6 | 0.4 |
| waist_yaw (CSG-17) | Elmo drive mount | M2x6 | 4 | 4 | A2 | no | board/heat-sink mount; thermal contact (Thermal to OK Ti) | Elmo install guide l.770-773 (4 x M2 A2); L [EST] | 1.3 | 0.7 |
| waist_pitch (CSG-25) | flexspline -> output hub | M6x14 | 8 | 8 | 12.9 steel | YES | gear torque path; HD requires >= 12.9 | HD Table 24; L [EST] | 46.0 | — |
| waist_pitch (CSG-25) | circular spline -> housing | M4x12 | 16 | 16 | 12.9 steel | YES | gear torque reaction | HD Table 27; L [EST] | 31.5 | — |
| waist_pitch (CSG-25) | output flange -> customer | M5x16 | 8 | 8 | 12.9 steel | YES | joint load path (interface, CONTRACTS 1c) | cad_mass.py 8 x M5x16 (legs); M4x12 on CSG-14/20 [EST] | 32.0 | — |
| waist_pitch (CSG-25) | crossed-roller clamp ring | M3x8 | 8 | 8 | 12.9 steel | YES | retains bearing outer ring axially (fall/impact load) | [EST] (Arms R13 clamp ring, count not drawn) | 6.2 | — |
| waist_pitch (CSG-25) | rear cap / encoder cover | M3x8 | 6 | 6 | 12.9 steel | no | cover only; motor reaction goes via stator bond land to tube | cad_mass.py 6 x M3; L [EST] | 4.6 | 2.6 |
| waist_pitch (CSG-25) | AksIM-2 readhead | M2x6 | 2 | 2 | A2 | no | locates readhead, no load; ring is press-fit | [EST] (RLS MBD01: ring press-fit) | 0.6 | 0.4 |
| waist_pitch (CSG-25) | Elmo drive mount | M2x6 | 4 | 4 | A2 | no | board/heat-sink mount; thermal contact (Thermal to OK Ti) | Elmo install guide l.770-773 (4 x M2 A2); L [EST] | 1.3 | 0.7 |
| shoulder_pitch (CSG-25) | flexspline -> output hub | M6x14 | 8 | 16 | 12.9 steel | YES | gear torque path; HD requires >= 12.9 | HD Table 24; L [EST] | 92.0 | — |
| shoulder_pitch (CSG-25) | circular spline -> housing | M4x12 | 16 | 32 | 12.9 steel | YES | gear torque reaction | HD Table 27; L [EST] | 62.9 | — |
| shoulder_pitch (CSG-25) | output flange -> customer | M5x16 | 8 | 16 | 12.9 steel | YES | joint load path (interface, CONTRACTS 1c) | cad_mass.py 8 x M5x16 (legs); M4x12 on CSG-14/20 [EST] | 63.9 | — |
| shoulder_pitch (CSG-25) | crossed-roller clamp ring | M3x8 | 8 | 16 | 12.9 steel | YES | retains bearing outer ring axially (fall/impact load) | [EST] (Arms R13 clamp ring, count not drawn) | 12.4 | — |
| shoulder_pitch (CSG-25) | rear cap / encoder cover | M3x8 | 6 | 12 | 12.9 steel | no | cover only; motor reaction goes via stator bond land to tube | cad_mass.py 6 x M3; L [EST] | 9.3 | 5.2 |
| shoulder_pitch (CSG-25) | AksIM-2 readhead | M2x6 | 2 | 4 | A2 | no | locates readhead, no load; ring is press-fit | [EST] (RLS MBD01: ring press-fit) | 1.3 | 0.7 |
| shoulder_pitch (CSG-25) | Elmo drive mount | M2x6 | 4 | 8 | A2 | no | board/heat-sink mount; thermal contact (Thermal to OK Ti) | Elmo install guide l.770-773 (4 x M2 A2); L [EST] | 2.5 | 1.4 |
| shoulder_roll (CSG-25) | flexspline -> output hub | M6x14 | 8 | 16 | 12.9 steel | YES | gear torque path; HD requires >= 12.9 | HD Table 24; L [EST] | 92.0 | — |
| shoulder_roll (CSG-25) | circular spline -> housing | M4x12 | 16 | 32 | 12.9 steel | YES | gear torque reaction | HD Table 27; L [EST] | 62.9 | — |
| shoulder_roll (CSG-25) | output flange -> customer | M5x16 | 8 | 16 | 12.9 steel | YES | joint load path (interface, CONTRACTS 1c) | cad_mass.py 8 x M5x16 (legs); M4x12 on CSG-14/20 [EST] | 63.9 | — |
| shoulder_roll (CSG-25) | crossed-roller clamp ring | M3x8 | 8 | 16 | 12.9 steel | YES | retains bearing outer ring axially (fall/impact load) | [EST] (Arms R13 clamp ring, count not drawn) | 12.4 | — |
| shoulder_roll (CSG-25) | rear cap / encoder cover | M3x8 | 6 | 12 | 12.9 steel | no | cover only; motor reaction goes via stator bond land to tube | cad_mass.py 6 x M3; L [EST] | 9.3 | 5.2 |
| shoulder_roll (CSG-25) | AksIM-2 readhead | M2x6 | 2 | 4 | A2 | no | locates readhead, no load; ring is press-fit | [EST] (RLS MBD01: ring press-fit) | 1.3 | 0.7 |
| shoulder_roll (CSG-25) | Elmo drive mount | M2x6 | 4 | 8 | A2 | no | board/heat-sink mount; thermal contact (Thermal to OK Ti) | Elmo install guide l.770-773 (4 x M2 A2); L [EST] | 2.5 | 1.4 |
| shoulder_yaw (CSG-17) | flexspline -> output hub | M5x12 | 6 | 12 | 12.9 steel | YES | gear torque path; HD requires >= 12.9 | HD Table 24; L [EST] | 40.6 | — |
| shoulder_yaw (CSG-17) | circular spline -> housing | M3x10 | 16 | 32 | 12.9 steel | YES | gear torque reaction | HD Table 27; L [EST] | 28.3 | — |
| shoulder_yaw (CSG-17) | output flange -> customer | M5x16 | 8 | 16 | 12.9 steel | YES | joint load path (interface, CONTRACTS 1c) | cad_mass.py 8 x M5x16 (legs); M4x12 on CSG-14/20 [EST] | 63.9 | — |
| shoulder_yaw (CSG-17) | crossed-roller clamp ring | M3x8 | 8 | 16 | 12.9 steel | YES | retains bearing outer ring axially (fall/impact load) | [EST] (Arms R13 clamp ring, count not drawn) | 12.4 | — |
| shoulder_yaw (CSG-17) | rear cap / encoder cover | M3x8 | 6 | 12 | 12.9 steel | no | cover only; motor reaction goes via stator bond land to tube | cad_mass.py 6 x M3; L [EST] | 9.3 | 5.2 |
| shoulder_yaw (CSG-17) | AksIM-2 readhead | M2x6 | 2 | 4 | A2 | no | locates readhead, no load; ring is press-fit | [EST] (RLS MBD01: ring press-fit) | 1.3 | 0.7 |
| shoulder_yaw (CSG-17) | Elmo drive mount | M2x6 | 4 | 8 | A2 | no | board/heat-sink mount; thermal contact (Thermal to OK Ti) | Elmo install guide l.770-773 (4 x M2 A2); L [EST] | 2.5 | 1.4 |
| elbow (CSG-20) | flexspline -> output hub | M5x12 | 8 | 16 | 12.9 steel | YES | gear torque path; HD requires >= 12.9 | HD Table 24; L [EST] | 54.1 | — |
| elbow (CSG-20) | circular spline -> housing | M3x10 | 16 | 32 | 12.9 steel | YES | gear torque reaction | HD Table 27; L [EST] | 28.3 | — |
| elbow (CSG-20) | output flange -> customer | M4x12 | 8 | 16 | 12.9 steel | YES | joint load path (interface, CONTRACTS 1c) | cad_mass.py 8 x M5x16 (legs); M4x12 on CSG-14/20 [EST] | 31.5 | — |
| elbow (CSG-20) | crossed-roller clamp ring | M3x8 | 8 | 16 | 12.9 steel | YES | retains bearing outer ring axially (fall/impact load) | [EST] (Arms R13 clamp ring, count not drawn) | 12.4 | — |
| elbow (CSG-20) | rear cap / encoder cover | M3x8 | 6 | 12 | 12.9 steel | no | cover only; motor reaction goes via stator bond land to tube | cad_mass.py 6 x M3; L [EST] | 9.3 | 5.2 |
| elbow (CSG-20) | AksIM-2 readhead | M2x6 | 2 | 4 | A2 | no | locates readhead, no load; ring is press-fit | [EST] (RLS MBD01: ring press-fit) | 1.3 | 0.7 |
| elbow (CSG-20) | Elmo drive mount | M2x6 | 4 | 8 | A2 | no | board/heat-sink mount; thermal contact (Thermal to OK Ti) | Elmo install guide l.770-773 (4 x M2 A2); L [EST] | 2.5 | 1.4 |
| wrist_roll (CSG-14) | flexspline -> output hub | M4x10 | 6 | 12 | 12.9 steel | YES | gear torque path; HD requires >= 12.9 | HD Table 24; L [EST] | 21.2 | — |
| wrist_roll (CSG-14) | circular spline -> housing | M3x10 | 8 | 16 | 12.9 steel | YES | gear torque reaction | HD Table 27; L [EST] | 14.2 | — |
| wrist_roll (CSG-14) | output flange -> customer | M4x12 | 8 | 16 | 12.9 steel | YES | joint load path (interface, CONTRACTS 1c) | cad_mass.py 8 x M5x16 (legs); M4x12 on CSG-14/20 [EST] | 31.5 | — |
| wrist_roll (CSG-14) | crossed-roller clamp ring | M3x8 | 8 | 16 | 12.9 steel | YES | retains bearing outer ring axially (fall/impact load) | [EST] (Arms R13 clamp ring, count not drawn) | 12.4 | — |
| wrist_roll (CSG-14) | rear cap / encoder cover | M3x8 | 6 | 12 | 12.9 steel | no | cover only; motor reaction goes via stator bond land to tube | cad_mass.py 6 x M3; L [EST] | 9.3 | 5.2 |
| wrist_roll (CSG-14) | AksIM-2 readhead | M2x6 | 2 | 4 | A2 | no | locates readhead, no load; ring is press-fit | [EST] (RLS MBD01: ring press-fit) | 1.3 | 0.7 |
| wrist_roll (CSG-14) | Elmo drive mount | M2x6 | 4 | 8 | A2 | no | board/heat-sink mount; thermal contact (Thermal to OK Ti) | Elmo install guide l.770-773 (4 x M2 A2); L [EST] | 2.5 | 1.4 |
| wrist_pitch (CSG-14, D76) | flexspline -> output hub | M4x10 | 6 | 12 | 12.9 steel | YES | gear torque path; HD requires >= 12.9 | HD Table 24; L [EST] | 21.2 | — |
| wrist_pitch (CSG-14, D76) | circular spline -> housing | M3x10 | 8 | 16 | 12.9 steel | YES | gear torque reaction | HD Table 27; L [EST] | 14.2 | — |
| wrist_pitch (CSG-14, D76) | output flange -> customer | M4x12 | 8 | 16 | 12.9 steel | YES | joint load path (interface, CONTRACTS 1c) | cad_mass.py 8 x M5x16 (legs); M4x12 on CSG-14/20 [EST] | 31.5 | — |
| wrist_pitch (CSG-14, D76) | crossed-roller clamp ring | M3x8 | 8 | 16 | 12.9 steel | YES | retains bearing outer ring axially (fall/impact load) | [EST] (Arms R13 clamp ring, count not drawn) | 12.4 | — |
| wrist_pitch (CSG-14, D76) | rear cap / encoder cover | M3x8 | 6 | 12 | 12.9 steel | no | cover only; motor reaction goes via stator bond land to tube | cad_mass.py 6 x M3; L [EST] | 9.3 | 5.2 |
| wrist_pitch (CSG-14, D76) | AksIM-2 readhead | M2x6 | 2 | 4 | A2 | no | locates readhead, no load; ring is press-fit | [EST] (RLS MBD01: ring press-fit) | 1.3 | 0.7 |
| wrist_pitch (CSG-14, D76) | Elmo drive mount | M2x6 | 4 | 8 | A2 | no | board/heat-sink mount; thermal contact (Thermal to OK Ti) | Elmo install guide l.770-773 (4 x M2 A2); L [EST] | 2.5 | 1.4 |
| wrist_yaw (CSG-14, D76) | flexspline -> output hub | M4x10 | 6 | 12 | 12.9 steel | YES | gear torque path; HD requires >= 12.9 | HD Table 24; L [EST] | 21.2 | — |
| wrist_yaw (CSG-14, D76) | circular spline -> housing | M3x10 | 8 | 16 | 12.9 steel | YES | gear torque reaction | HD Table 27; L [EST] | 14.2 | — |
| wrist_yaw (CSG-14, D76) | output flange -> customer | M4x12 | 8 | 16 | 12.9 steel | YES | joint load path (interface, CONTRACTS 1c) | cad_mass.py 8 x M5x16 (legs); M4x12 on CSG-14/20 [EST] | 31.5 | — |
| wrist_yaw (CSG-14, D76) | crossed-roller clamp ring | M3x8 | 8 | 16 | 12.9 steel | YES | retains bearing outer ring axially (fall/impact load) | [EST] (Arms R13 clamp ring, count not drawn) | 12.4 | — |
| wrist_yaw (CSG-14, D76) | rear cap / encoder cover | M3x8 | 6 | 12 | 12.9 steel | no | cover only; motor reaction goes via stator bond land to tube | cad_mass.py 6 x M3; L [EST] | 9.3 | 5.2 |
| wrist_yaw (CSG-14, D76) | AksIM-2 readhead | M2x6 | 2 | 4 | A2 | no | locates readhead, no load; ring is press-fit | [EST] (RLS MBD01: ring press-fit) | 1.3 | 0.7 |
| wrist_yaw (CSG-14, D76) | Elmo drive mount | M2x6 | 4 | 8 | A2 | no | board/heat-sink mount; thermal contact (Thermal to OK Ti) | Elmo install guide l.770-773 (4 x M2 A2); L [EST] | 2.5 | 1.4 |
| hip_pitch screw (RV12) | RV12 nut flange -> rotor hub | M5x12 | 6 | 24 | 12.9 steel | YES | full screw axial force | Rollvis p.25 via cad_mass.py hub(); L [EST] | 81.1 | — |
| hip_pitch screw (RV12) | front cap / 7202 bearing retainer | M4x12 | 4 | 16 | 12.9 steel | YES | carries angular-contact preload and axial force | cad_mass.py 4 x M4; L [EST] | 31.5 | — |
| hip_pitch screw (RV12) | rear cap / encoder cover | M3x8 | 6 | 24 | 12.9 steel | no | cover only | cad_mass.py 6 x M3; L [EST] | 18.6 | 10.5 |
| hip_pitch screw (RV12) | AksIM-2 readhead | M2x6 | 2 | 8 | A2 | no | no load | [EST] | 2.5 | 1.4 |
| hip_pitch screw (RV12) | Elmo drive mount | M2x6 | 4 | 16 | A2 | no | board mount; thermal contact (Thermal to OK Ti) | Elmo install guide (4 x M2 A2) | 5.0 | 2.8 |
| knee screw (RV12) | RV12 nut flange -> rotor hub | M5x12 | 6 | 24 | 12.9 steel | YES | full screw axial force | Rollvis p.25 via cad_mass.py hub(); L [EST] | 81.1 | — |
| knee screw (RV12) | front cap / 7202 bearing retainer | M4x12 | 4 | 16 | 12.9 steel | YES | carries angular-contact preload and axial force | cad_mass.py 4 x M4; L [EST] | 31.5 | — |
| knee screw (RV12) | rear cap / encoder cover | M3x8 | 6 | 24 | 12.9 steel | no | cover only | cad_mass.py 6 x M3; L [EST] | 18.6 | 10.5 |
| knee screw (RV12) | AksIM-2 readhead | M2x6 | 2 | 8 | A2 | no | no load | [EST] | 2.5 | 1.4 |
| knee screw (RV12) | Elmo drive mount | M2x6 | 4 | 16 | A2 | no | board mount; thermal contact (Thermal to OK Ti) | Elmo install guide (4 x M2 A2) | 5.0 | 2.8 |
| ankle screw (RV12) | RV12 nut flange -> rotor hub | M5x12 | 6 | 24 | 12.9 steel | YES | full screw axial force | Rollvis p.25 via cad_mass.py hub(); L [EST] | 81.1 | — |
| ankle screw (RV12) | front cap / 7202 bearing retainer | M4x12 | 4 | 16 | 12.9 steel | YES | carries angular-contact preload and axial force | cad_mass.py 4 x M4; L [EST] | 31.5 | — |
| ankle screw (RV12) | rear cap / encoder cover | M3x8 | 6 | 24 | 12.9 steel | no | cover only | cad_mass.py 6 x M3; L [EST] | 18.6 | 10.5 |
| ankle screw (RV12) | AksIM-2 readhead | M2x6 | 2 | 8 | A2 | no | no load | [EST] | 2.5 | 1.4 |
| ankle screw (RV12) | Elmo drive mount | M2x6 | 4 | 16 | A2 | no | board mount; thermal contact (Thermal to OK Ti) | Elmo install guide (4 x M2 A2) | 5.0 | 2.8 |
