BryanRalston/robot-lab/v3/cad/export/bhl_v3_assembly.step

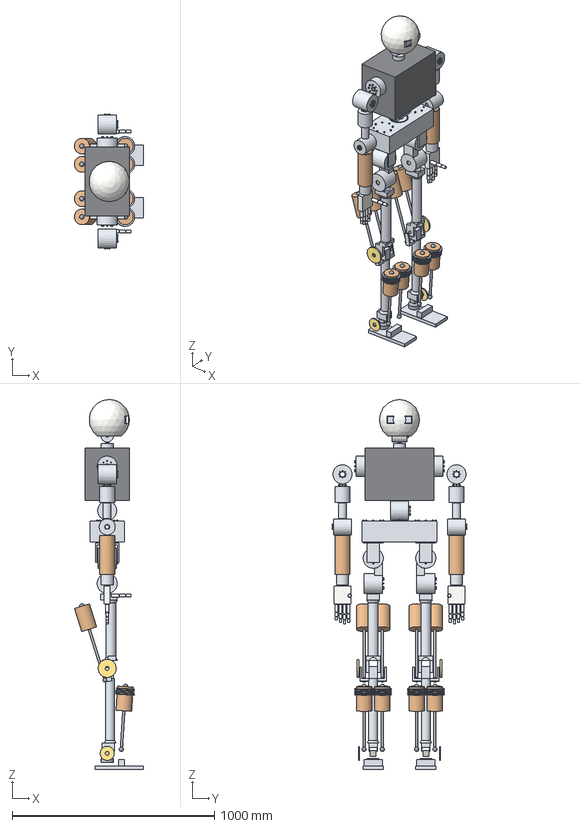
[picture p68: CAD file, 2026-10-13]
v3/cad/export/bhl_v3_assembly.step
342.2 x 669.0 x 1830.0 mm
pelvis shell (7075, 4 mm; encloses hip-yaw + waist-yaw actuators)
waist yaw housing
waist yaw motor (TBM2G-06008, Kollmorgen frameless)
waist yaw CSG-17-100 Harmonic Drive component set
waist yaw CRBH 5013 A crossed-roller output bearing (IKO)
waist yaw AksIM-2 encoder ring
waist yaw output bolts 8ÃM4 12.9
waist pitch housing
waist pitch motor (TBM2G-06808, Kollmorgen frameless)
waist pitch CSG-25-100 Harmonic Drive component set
waist pitch CRBH 5013 A crossed-roller output bearing (IKO)
waist pitch AksIM-2 encoder ring
waist pitch output bolts 8ÃM6 12.9
torso shell (CFRP sandwich 3 mm, 7 mm at shoulder doublers)
torso spine frame (7075)
battery pack 13S7P Molicel P45B (1474 Wh, 5.9 L)
compute bay: Jetson AGX Thor + cold plate
L_shoulder pitch housing
L_shoulder pitch motor (TBM2G-07608, Kollmorgen frameless)
L_shoulder pitch CSG-25-100 Harmonic Drive component set
L_shoulder pitch CRBH 6013 A crossed-roller output bearing (IKO)
L_shoulder pitch AksIM-2 encoder ring
L_shoulder pitch output bolts 8ÃM6 12.9
L_shoulder mount bolts 6ÃM8 12.9
L_shoulder roll housing
L_shoulder roll motor (TBM2G-06813, Kollmorgen frameless)
L_shoulder roll CSG-25-100 Harmonic Drive component set
L_shoulder roll CRBH 4010 A crossed-roller output bearing (IKO)
L_shoulder roll AksIM-2 encoder ring
L_shoulder roll output bolts 8ÃM6 12.9
L_shoulder yaw housing
L_shoulder yaw motor (TBM2G-06008, Kollmorgen frameless)
L_shoulder yaw CSG-17-100 Harmonic Drive component set
L_shoulder yaw CRBH 4010 A crossed-roller output bearing (IKO)
L_shoulder yaw AksIM-2 encoder ring
L_shoulder yaw output bolts 8ÃM4 12.9
L_upper arm tube 7075 Ã40x2
L_elbow housing
L_elbow motor (TBM2G-05013, Kollmorgen frameless)
L_elbow CSG-20-100 Harmonic Drive component set
L_elbow CRBH 3010 A crossed-roller output bearing (IKO)
L_elbow AksIM-2 encoder ring
L_elbow output bolts 8ÃM4 12.9
L_forearm shell 7075 (houses 11 hand drives)
L_flexor drive 1 (maxon DCX22S+GPX22HP 111:1)
L_flexor drive 2 (maxon DCX22S+GPX22HP 111:1)
L_flexor drive 3 (maxon DCX22S+GPX22HP 111:1)
L_flexor drive 4 (maxon DCX22S+GPX22HP 111:1)
L_flexor drive 5 (maxon DCX22S+GPX22HP 111:1)
L_flexor drive 6 (maxon DCX22S+GPX22HP 111:1)
L_wrist roll housing
L_wrist roll motor (TBM2G-05008, Kollmorgen frameless)
L_wrist roll CSG-14-100 Harmonic Drive component set
L_wrist roll CRBH 208 A crossed-roller output bearing (IKO)
L_wrist roll AksIM-2 encoder ring
L_wrist roll output bolts 6ÃM3 12.9
L_palm (7075 skeleton + PA12)
L_finger1 phalanx1
L_finger1 phalanx2
L_finger1 phalanx3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
