BryanRalston/robot-lab/modules/design/cad/shoulder_pad/assembly.stl

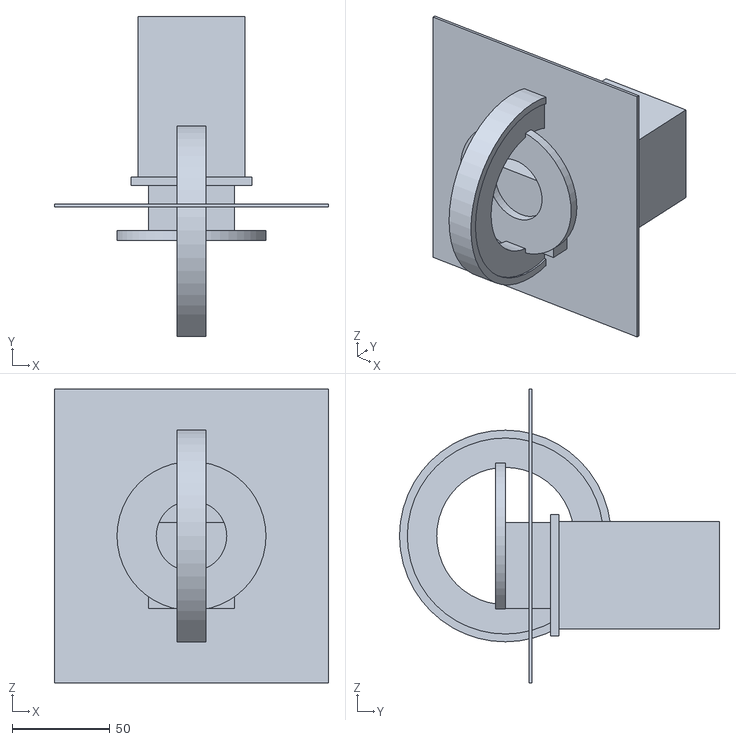
[picture p69: CAD file, 2026-10-21]
modules/design/cad/shoulder_pad/assembly.stl
140.0 x 163.3 x 150.0
