BryanRalston/robot-lab/modules/actuators/cad/waist_torque_limiter_d102c.step

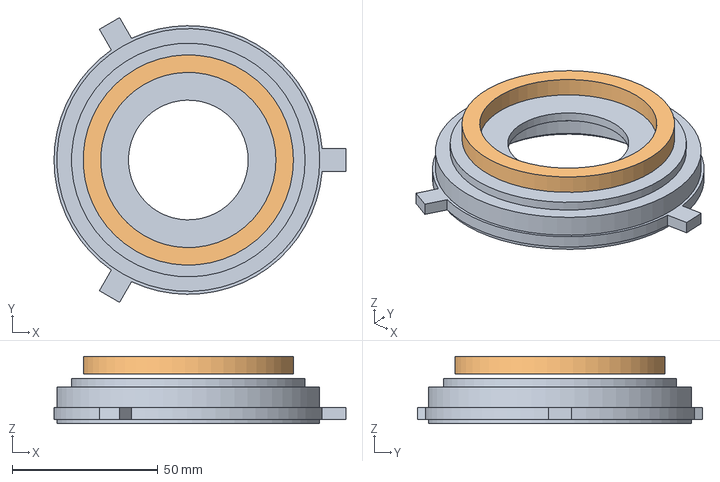
[picture p70: CAD file, 2026-10-21]
modules/actuators/cad/waist_torque_limiter_d102c.step
100.0 x 97.5 x 23.1 mm
