BryanRalston/robot-lab/modules/arms/cad/palm_7075.step

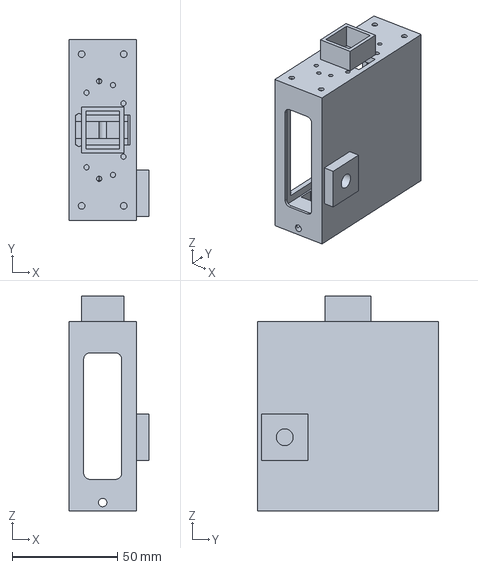
[picture p71: CAD file, 2026-10-21]
modules/arms/cad/palm_7075.step
38.0 x 86.0 x 102.0 mm
