BryanRalston/robot-lab/modules/arms/cad/r14/pad_envelope_r14.step

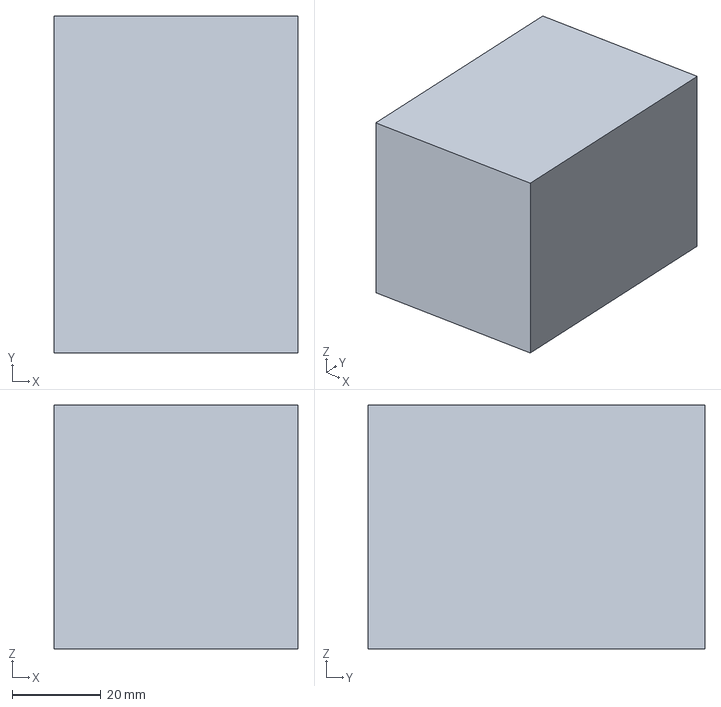
[picture p72: CAD file, 2026-10-21]
modules/arms/cad/r14/pad_envelope_r14.step
54.8 x 75.8 x 54.8 mm
