BryanRalston/robot-lab/modules/design/cad/covers/hip_skirt_r8f_pelvis_notched.stl

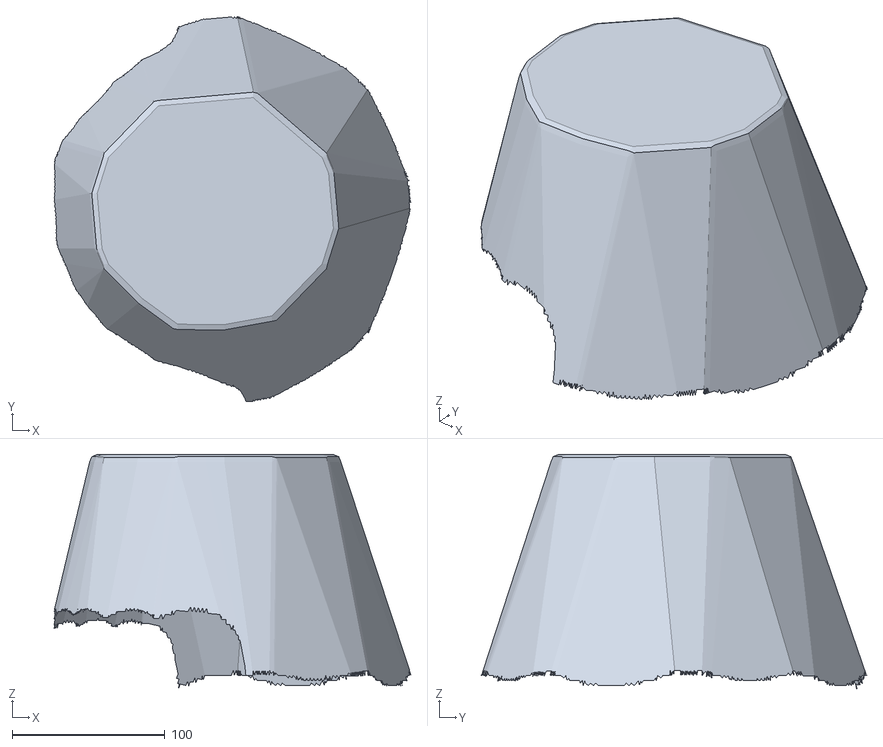
[picture p73: CAD file, 2026-10-21]
modules/design/cad/covers/hip_skirt_r8f_pelvis_notched.stl
234.0 x 252.4 x 153.4
