BryanRalston/robot-lab/modules/design/cad/shoulder_pad/housing_7013.stl

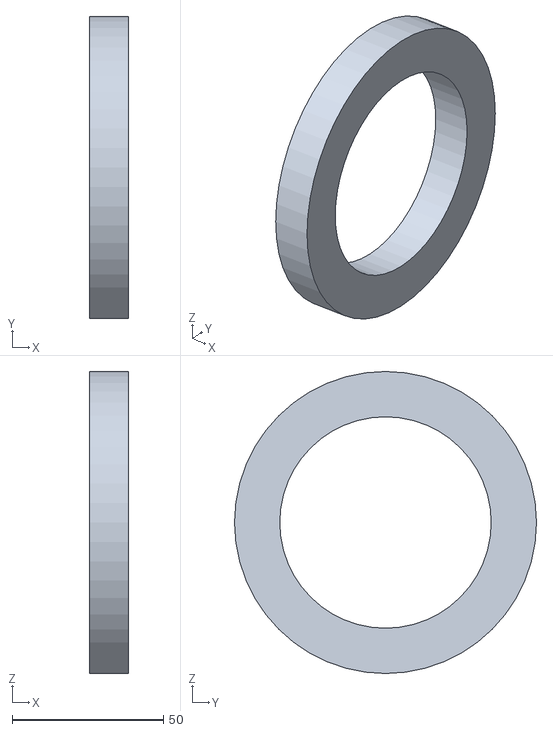
[picture p74: CAD file, 2026-10-21]
modules/design/cad/shoulder_pad/housing_7013.stl
13.0 x 100.0 x 100.0
