BryanRalston/robot-lab/modules/legs/cad/knee_twin_housing_fins_d69c_T1_b9_r6nf.step

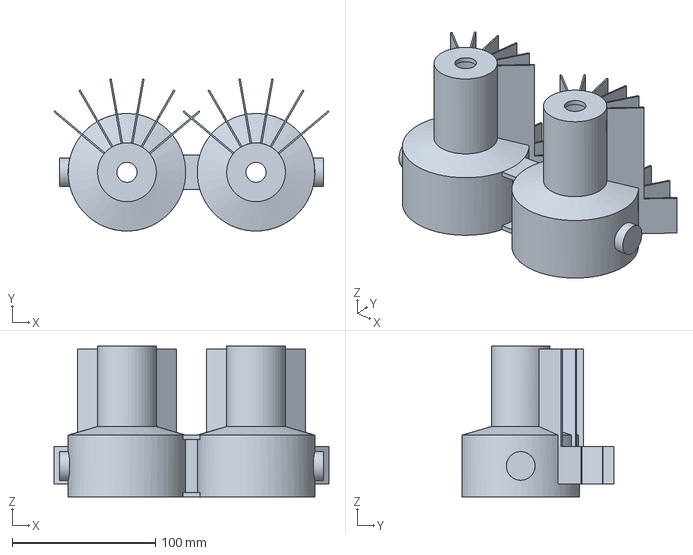
[picture p75: CAD file, 2026-10-14]
modules/legs/cad/knee_twin_housing_fins_d69c_T1_b9_r6nf.step
191.8 x 106.1 x 105.1 mm
