BryanRalston/robot-lab/modules/legs/results/v5/hip_skirt_keepout.stl

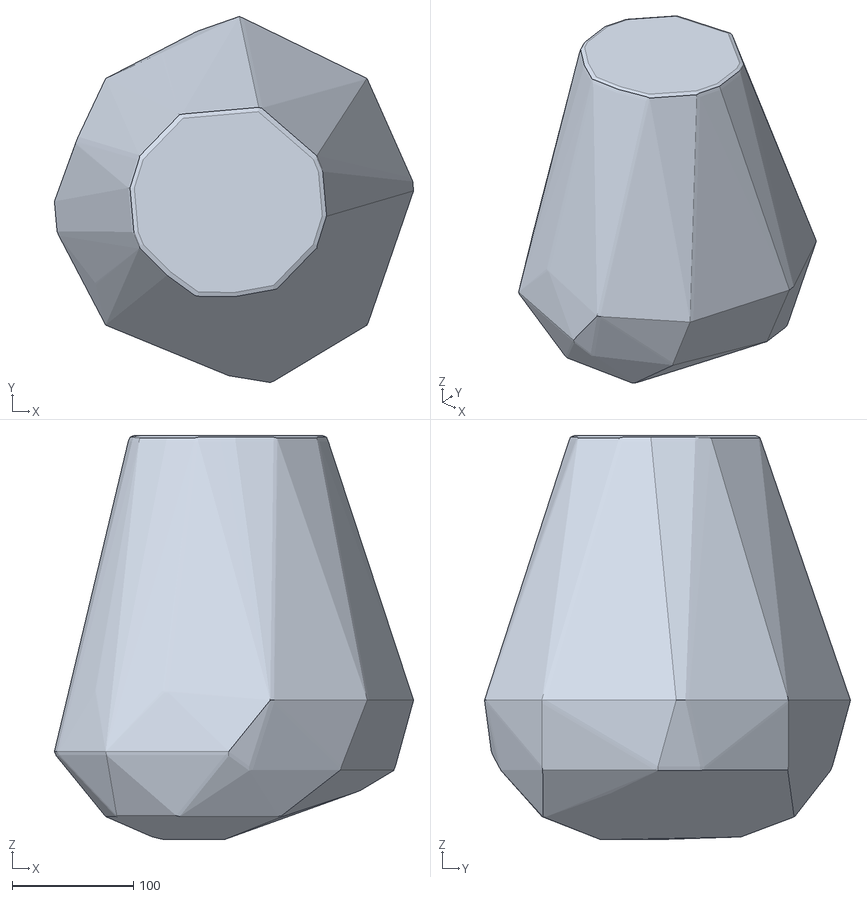
[picture p76: CAD file, 2026-10-14]
modules/legs/results/v5/hip_skirt_keepout.stl
295.9 x 301.5 x 333.0
