BryanRalston/robot-lab/modules/torso/cad/torso_cover.step

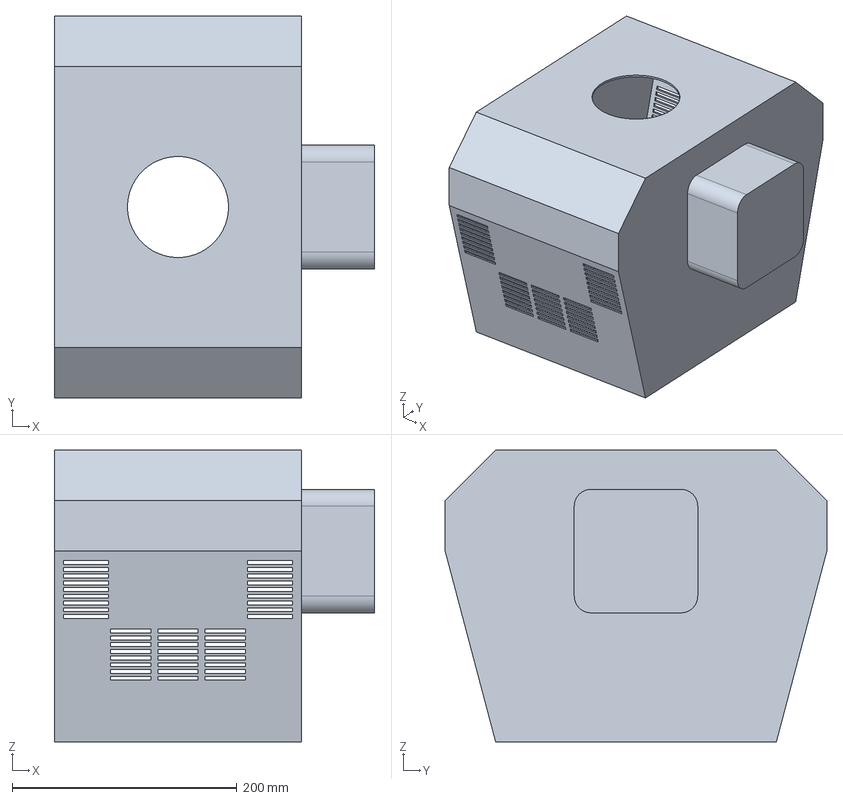
[picture p77: CAD file, 2026-10-21]
modules/torso/cad/torso_cover.step
285.0 x 340.0 x 260.0 mm
