BryanRalston/robot-lab/modules/torso/fea/job3b/torso_r1.step

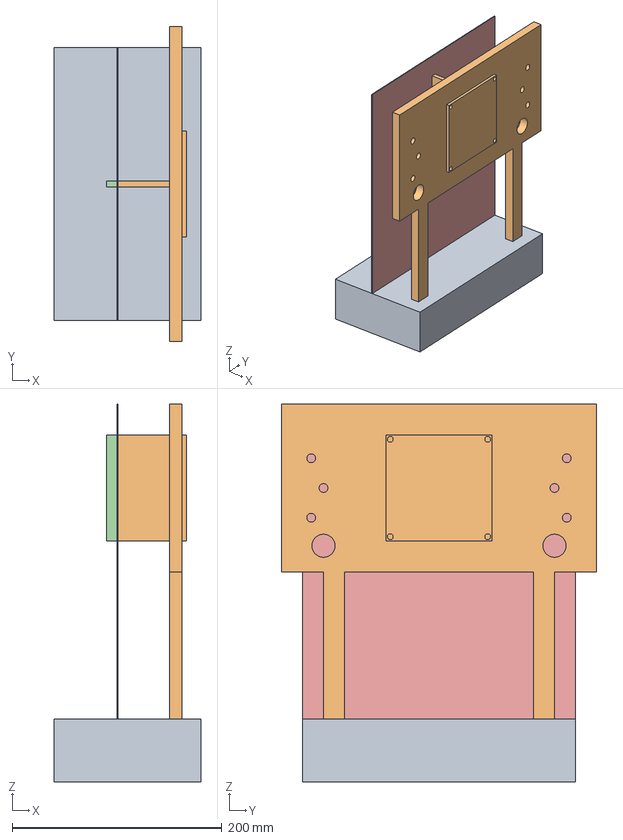
[picture p79: CAD file, 2026-10-21]
modules/torso/fea/job3b/torso_r1.step
140.0 x 300.0 x 360.0 mm
