BryanRalston/robot-lab/modules/actuators/cad/knee_stop_pu_r75b_d99.step

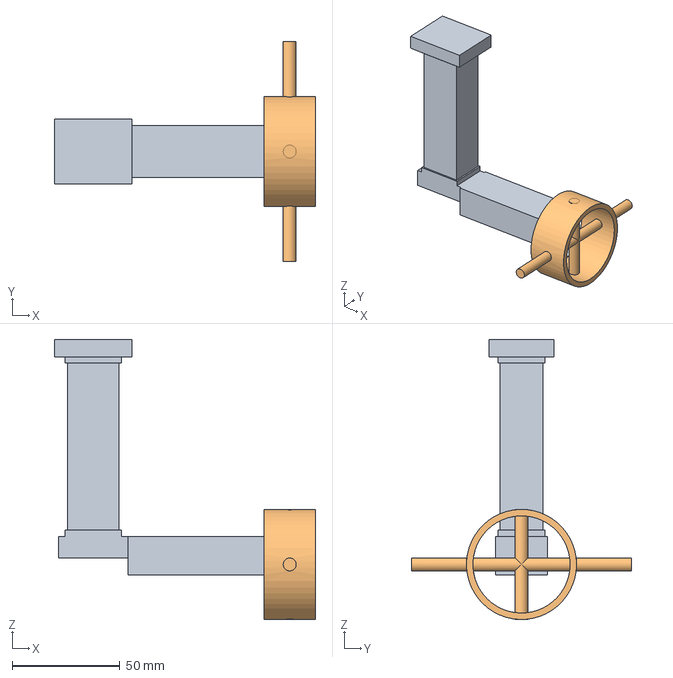
[picture p80: CAD file, 2026-10-21]
modules/actuators/cad/knee_stop_pu_r75b_d99.step
121.0 x 102.0 x 129.7 mm
