BryanRalston/robot-lab/modules/arms/cad/r14/housing_7013_r14.step

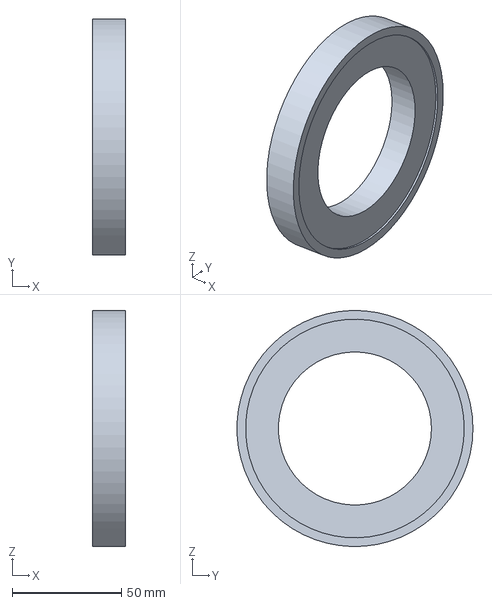
[picture p81: CAD file, 2026-10-21]
modules/arms/cad/r14/housing_7013_r14.step
15.0 x 107.9 x 108.0 mm
