BryanRalston/robot-lab/modules/arms/cad/r15/carrier_w2.stl

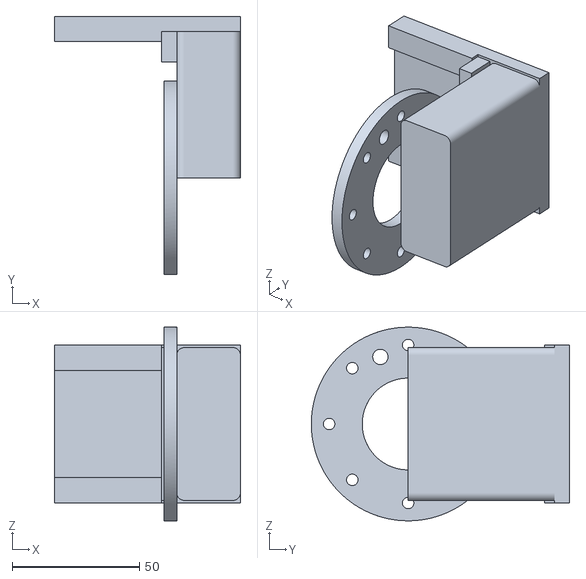
[picture p82: CAD file, 2026-10-21]
modules/arms/cad/r15/carrier_w2.stl
73.0 x 101.4 x 76.0
