BryanRalston/robot-lab/modules/design/cad/covers/hip_skirt_r8f_thigh_panel.stl

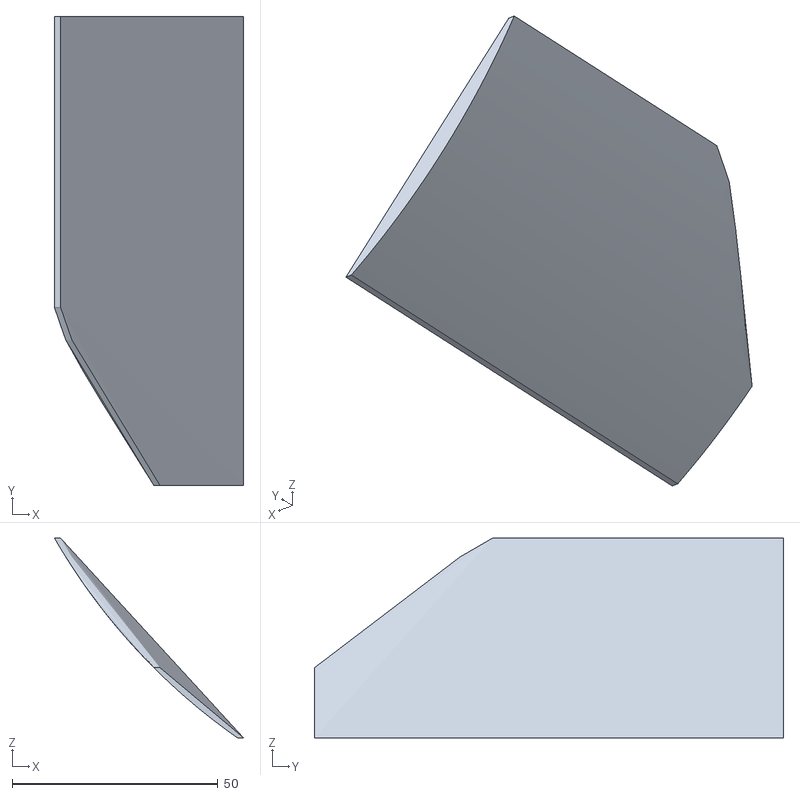
[picture p83: CAD file, 2026-10-21]
modules/design/cad/covers/hip_skirt_r8f_thigh_panel.stl
46.0 x 114.0 x 48.5
