BryanRalston/robot-lab/modules/design/cad/shoulder_pad/housing_flange_OD108.stl

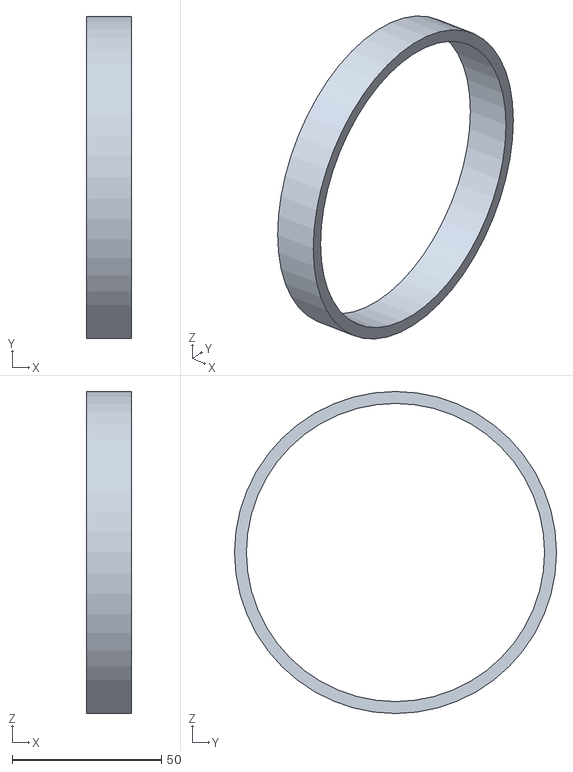
[picture p84: CAD file, 2026-10-21]
modules/design/cad/shoulder_pad/housing_flange_OD108.stl
15.0 x 108.0 x 108.0
