BryanRalston/robot-lab/modules/legs/cad/knee_twin_housing_fins_d69c_T1_z96.step

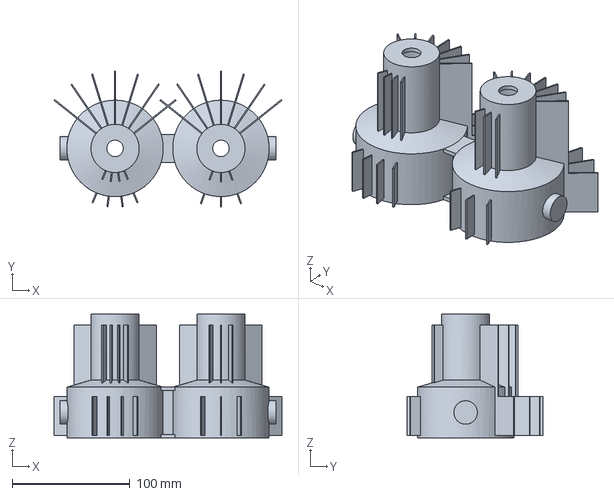
[picture p85: CAD file, 2026-10-14]
modules/legs/cad/knee_twin_housing_fins_d69c_T1_z96.step
193.8 x 116.0 x 105.1 mm
