BryanRalston/robot-lab/modules/legs/results/v5/shin_fairing_keepout.stl

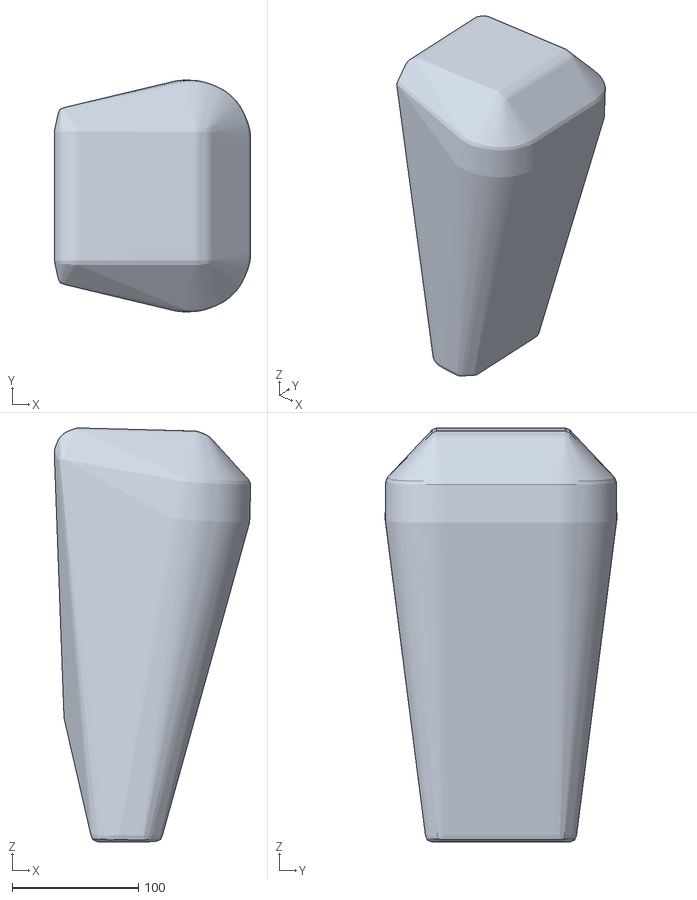
[picture p86: CAD file, 2026-10-14]
modules/legs/results/v5/shin_fairing_keepout.stl
155.4 x 183.3 x 327.5
