BryanRalston/robot-lab/modules/actuators/cad/knee_stop_pu_r75_d99.step

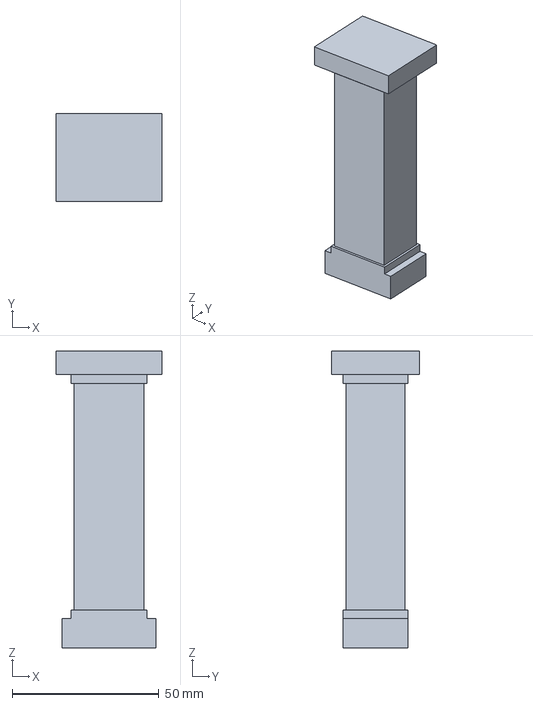
[picture p87: CAD file, 2026-10-21]
modules/actuators/cad/knee_stop_pu_r75_d99.step
36.0 x 30.0 x 101.2 mm
