BryanRalston/robot-lab/modules/arms/cad/r14/standoff_r14.stl

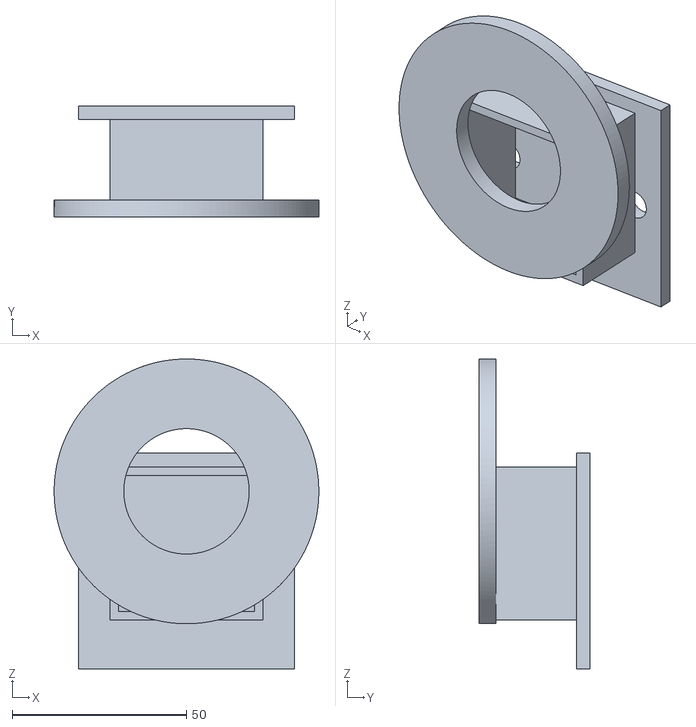
[picture p88: CAD file, 2026-10-21]
modules/arms/cad/r14/standoff_r14.stl
76.0 x 32.0 x 89.0
