BryanRalston/robot-lab/modules/arms/cad/r15/hub_r15.stl

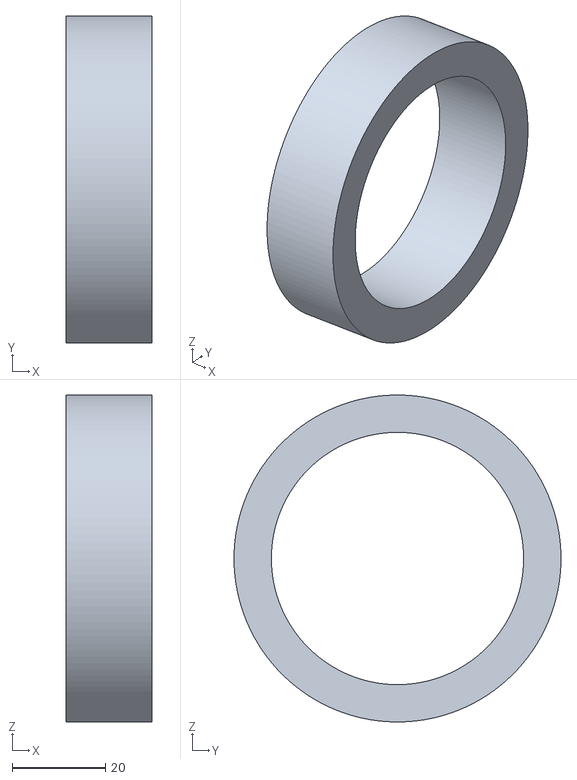
[picture p89: CAD file, 2026-10-21]
modules/arms/cad/r15/hub_r15.stl
18.5 x 70.0 x 70.0
