BryanRalston/robot-lab/modules/design/cad/covers/hip_skirt_r8e_stops.step

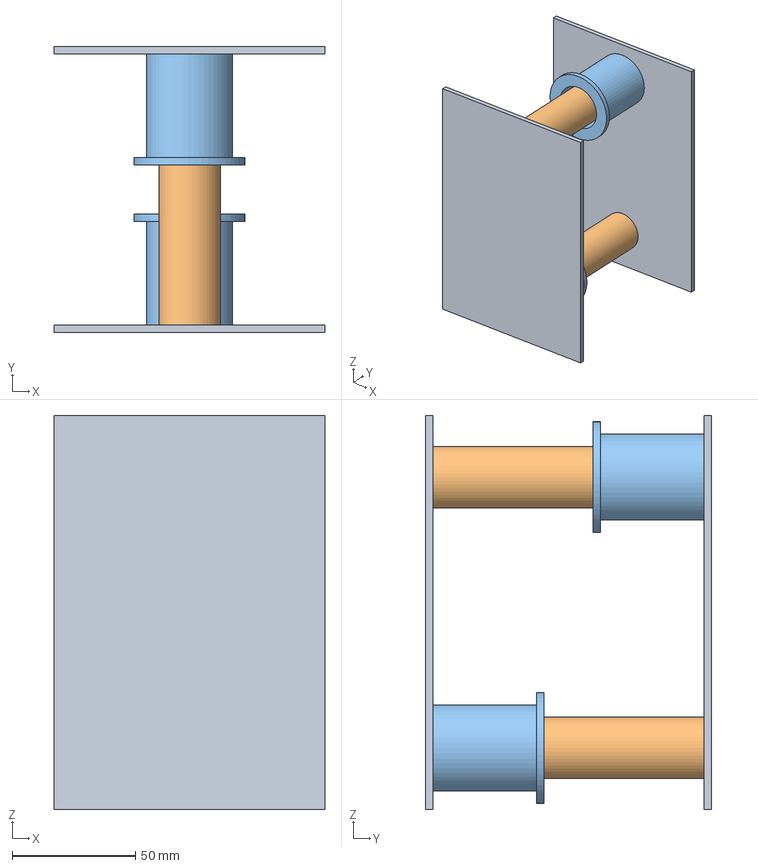
[picture p90: CAD file, 2026-10-21]
modules/design/cad/covers/hip_skirt_r8e_stops.step
110.0 x 116.0 x 160.0 mm
L_panel
L_stop_p40
L_cup_p70
R_panel
R_cup_p40
R_stop_p70
