BryanRalston/robot-lab/modules/design/cad/shoulder_pad/pad_face_EPP.stl

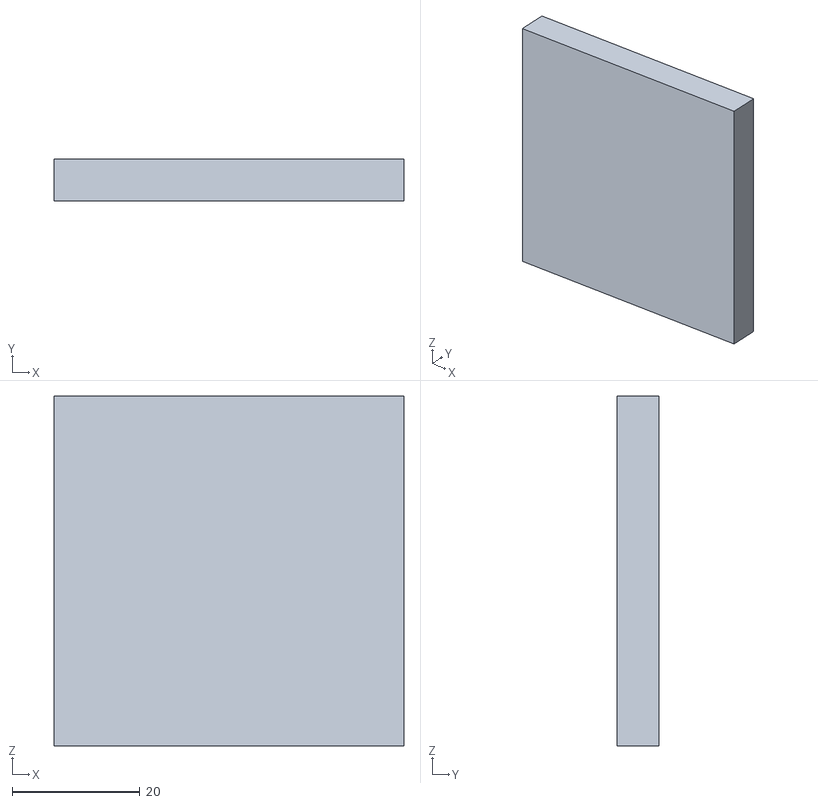
[picture p91: CAD file, 2026-10-21]
modules/design/cad/shoulder_pad/pad_face_EPP.stl
54.8 x 6.50 x 54.8
