BryanRalston/robot-lab/modules/legs/results/v5/foot_upper_keepout.stl

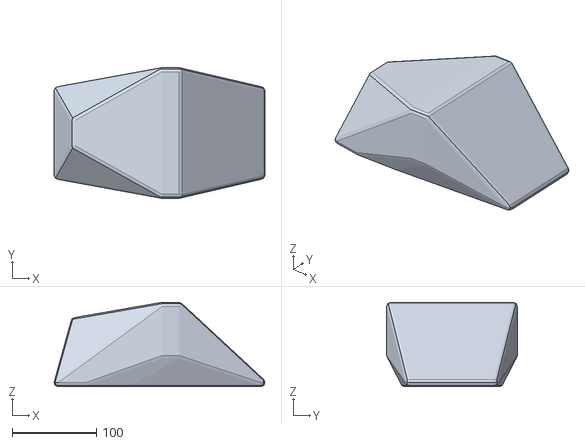
[picture p92: CAD file, 2026-10-14]
modules/legs/results/v5/foot_upper_keepout.stl
250.0 x 155.0 x 100.0
