BryanRalston/robot-lab/modules/actuators/cad/knee_stop_pu_pad_d97.step

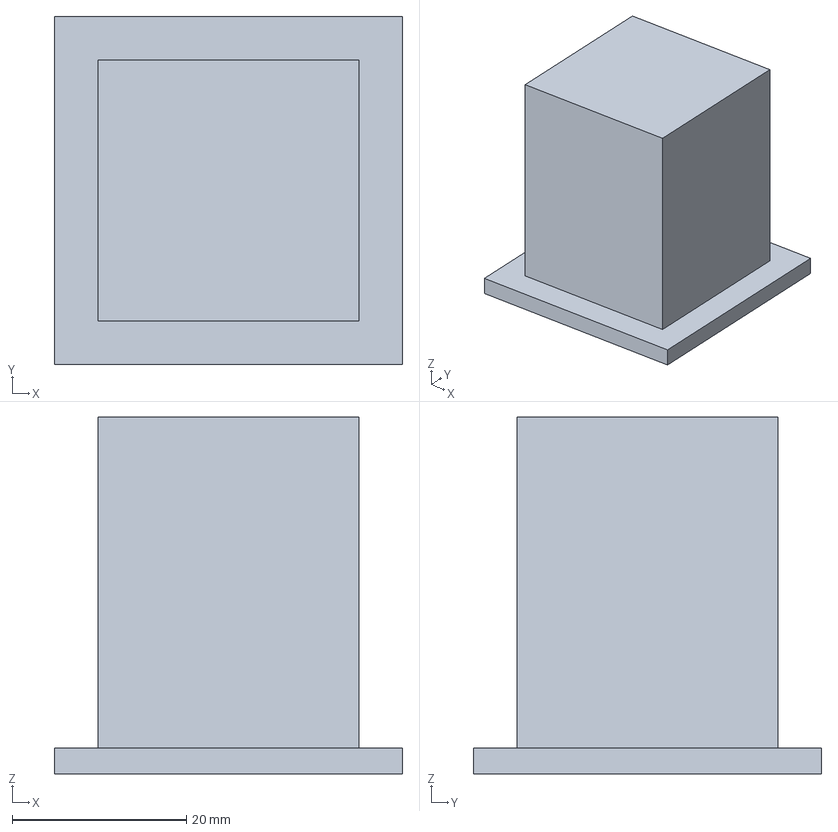
[picture p93: CAD file, 2026-10-21]
modules/actuators/cad/knee_stop_pu_pad_d97.step
40.0 x 40.0 x 41.0 mm
