BryanRalston/robot-lab/modules/design/cad/shoulder_pad/standoff_flange.stl

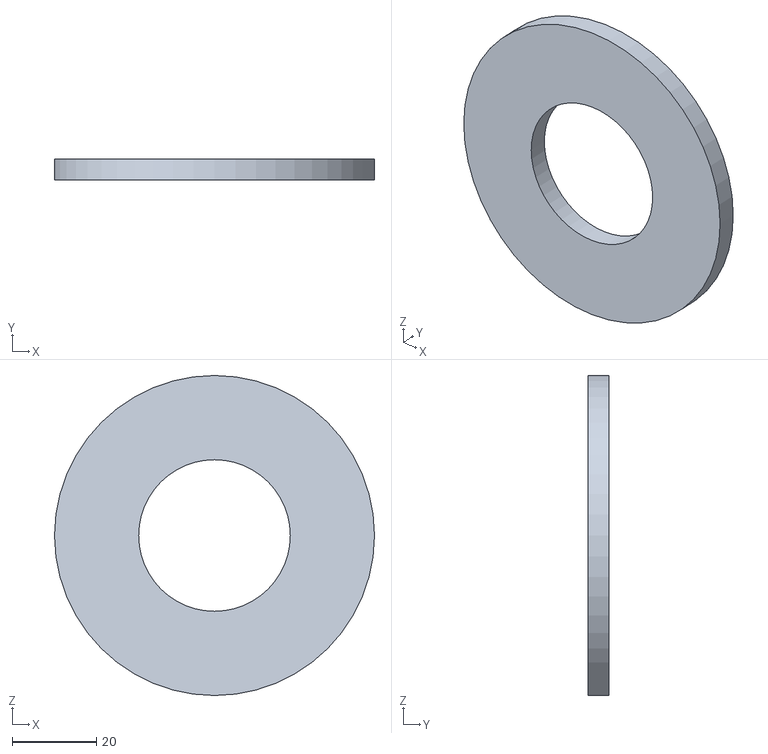
[picture p94: CAD file, 2026-10-21]
modules/design/cad/shoulder_pad/standoff_flange.stl
76.0 x 5.00 x 76.0
