BryanRalston/robot-lab/modules/legs/results/v5/ankle_boot_keepout.stl

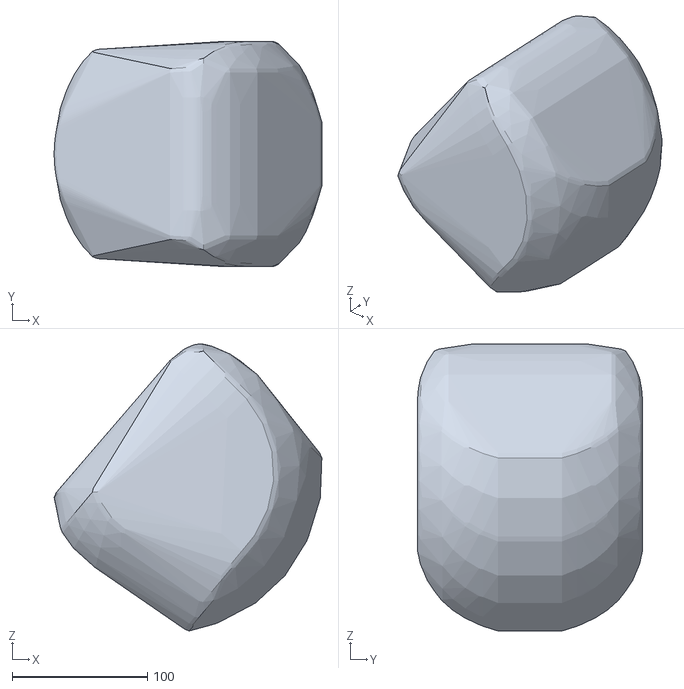
[picture p96: CAD file, 2026-10-14]
modules/legs/results/v5/ankle_boot_keepout.stl
198.1 x 166.4 x 212.4
