BryanRalston/robot-lab/modules/actuators/cad/knee_twin_housing_release_r116b.step

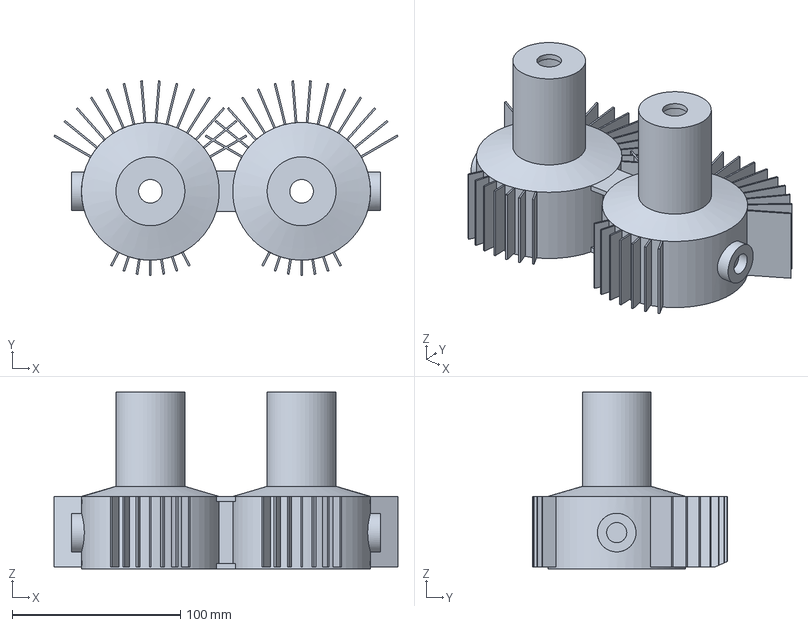
[picture p97: CAD file, 2026-10-21]
modules/actuators/cad/knee_twin_housing_release_r116b.step
204.8 x 115.8 x 105.1 mm
