BryanRalston/robot-lab/modules/design/cad/covers/hip_skirt_r8_pelvis.stl

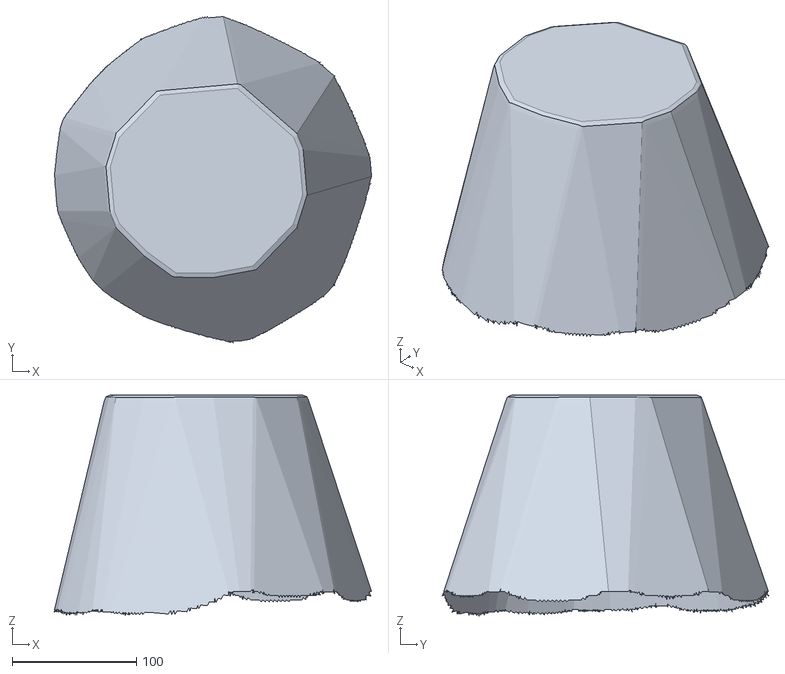
[picture p98: CAD file, 2026-10-21]
modules/design/cad/covers/hip_skirt_r8_pelvis.stl
255.4 x 262.4 x 177.9
