BryanRalston/robot-lab/modules/design/cad/shoulder_pad/standoff_plate.stl

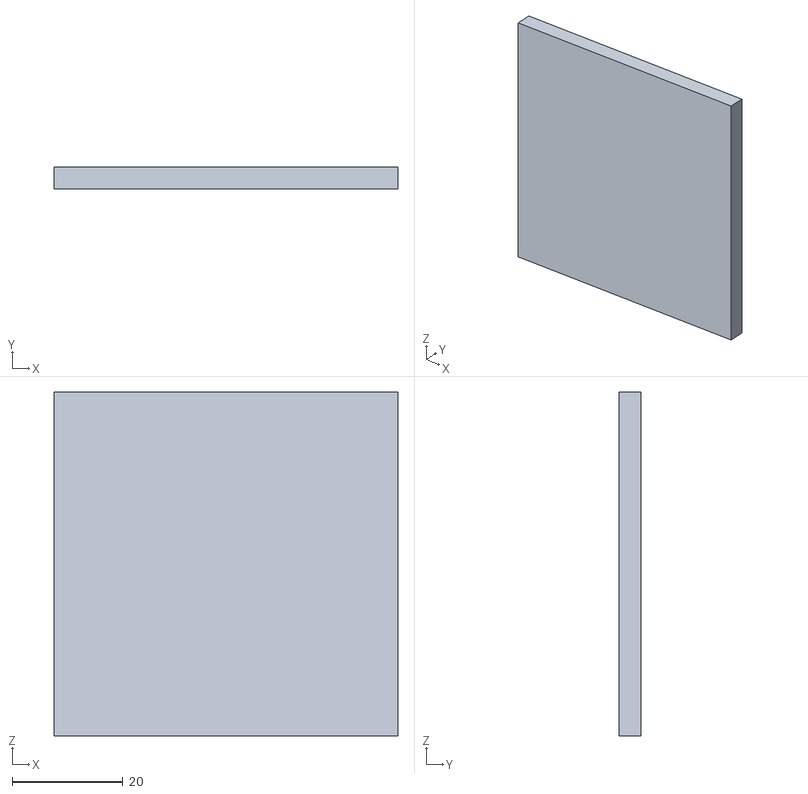
[picture p99: CAD file, 2026-10-21]
modules/design/cad/shoulder_pad/standoff_plate.stl
62.0 x 4.00 x 62.0
