BryanRalston/robot-lab/modules/legs/cad/hip_pitch_lever_r031_mw_b35_d40.step

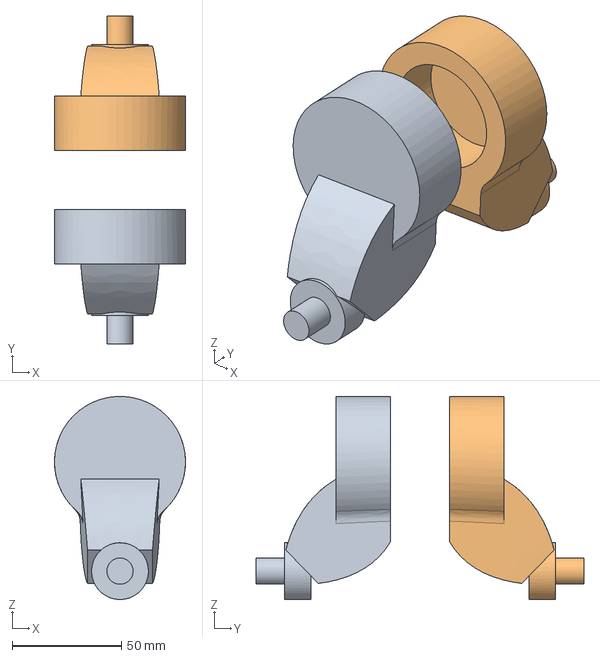
[picture p100: CAD file, 2026-10-14]
modules/legs/cad/hip_pitch_lever_r031_mw_b35_d40.step
60.0 x 150.0 x 92.9 mm
