BryanRalston/robot-lab/modules/legs/results/v5/thigh_fairing_keepout.stl

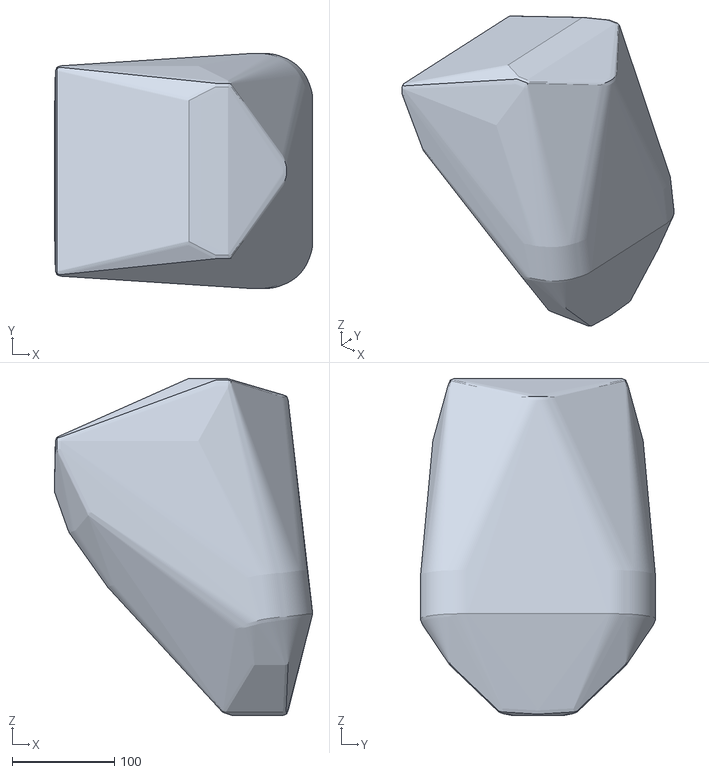
[picture p101: CAD file, 2026-10-14]
modules/legs/results/v5/thigh_fairing_keepout.stl
253.1 x 230.0 x 330.0
