BryanRalston/robot-lab/modules/actuators/cad/drive_plate_hip_pitch.step

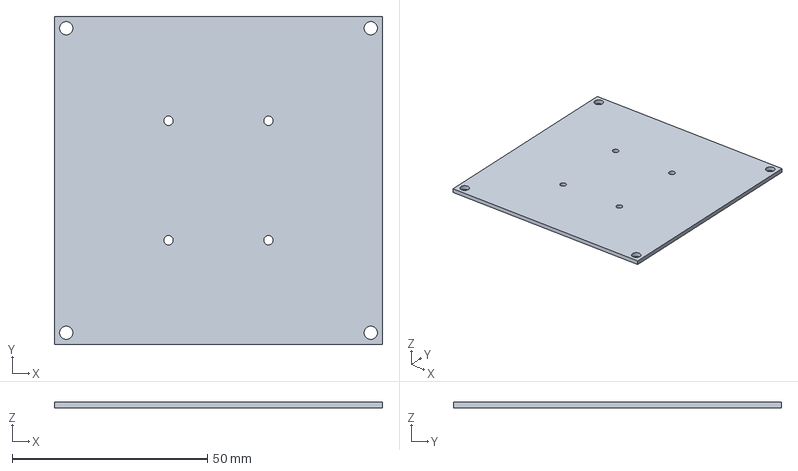
[picture p102: CAD file, 2026-10-21]
modules/actuators/cad/drive_plate_hip_pitch.step
84.0 x 84.0 x 1.50 mm
