BryanRalston/robot-lab/modules/design/cad/covers/hip_skirt_r8_thigh_panel.stl

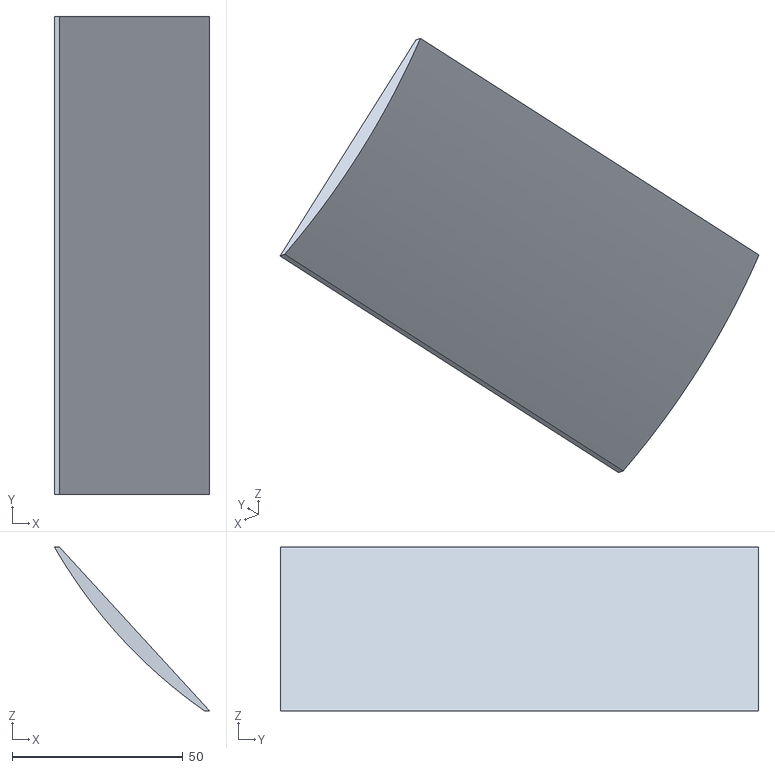
[picture p103: CAD file, 2026-10-21]
modules/design/cad/covers/hip_skirt_r8_thigh_panel.stl
45.4 x 140.0 x 47.9
