BryanRalston/robot-lab/modules/legs/results/v5/knee_cap_keepout.stl

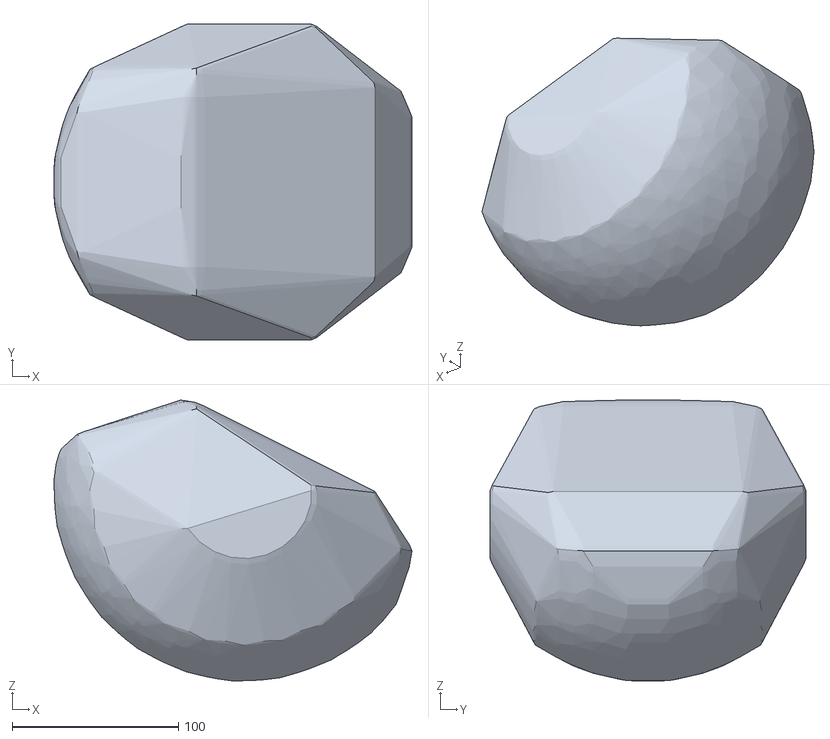
[picture p105: CAD file, 2026-10-14]
modules/legs/results/v5/knee_cap_keepout.stl
215.2 x 190.0 x 168.9
