BryanRalston/robot-lab/modules/actuators/cad/drive_plate_knee.step

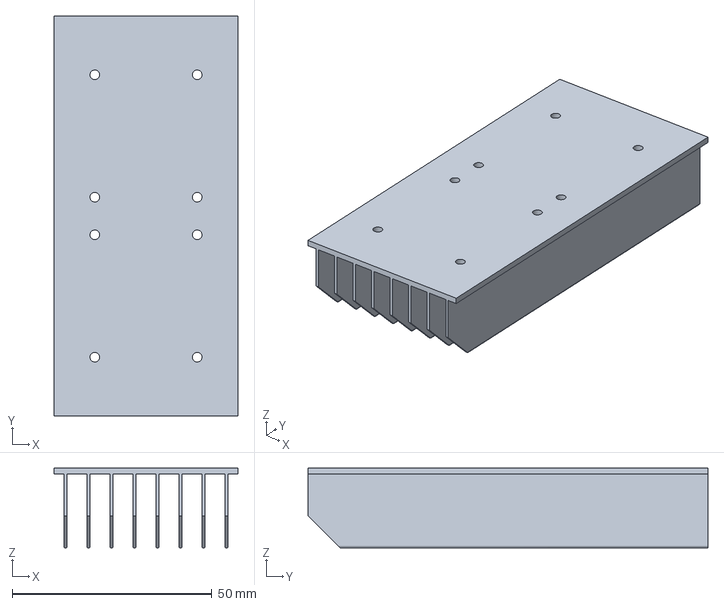
[picture p106: CAD file, 2026-10-21]
modules/actuators/cad/drive_plate_knee.step
46.0 x 100.0 x 20.0 mm
