BryanRalston/robot-lab/modules/design/cad/covers/hip_skirt_r7.stl

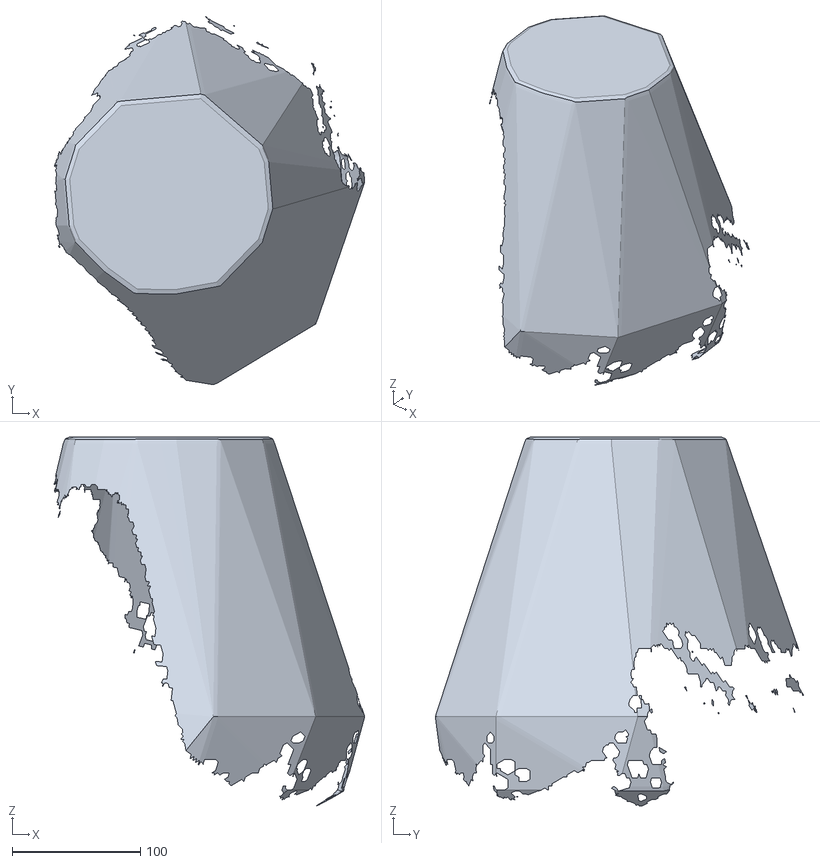
[picture p107: CAD file, 2026-10-21]
modules/design/cad/covers/hip_skirt_r7.stl
242.1 x 287.3 x 287.7
