BryanRalston/robot-lab/modules/legs/cad/hip_pitch_lever_r031_mw_b25_d30.step

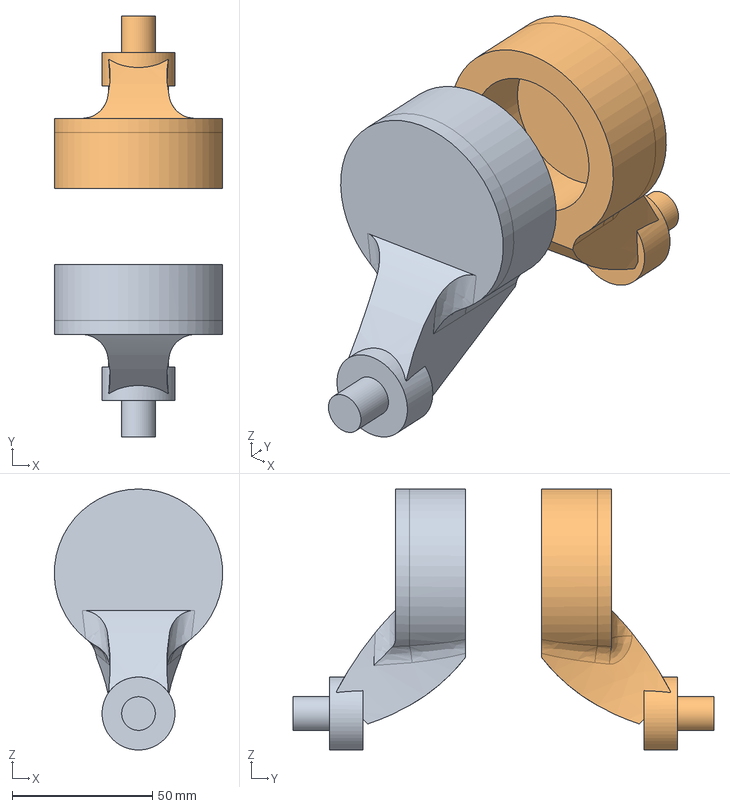
[picture p108: CAD file, 2026-10-14]
modules/legs/cad/hip_pitch_lever_r031_mw_b25_d30.step
60.0 x 150.0 x 93.0 mm
