BryanRalston/robot-lab/modules/actuators/cad/drive_plate_ankle.step

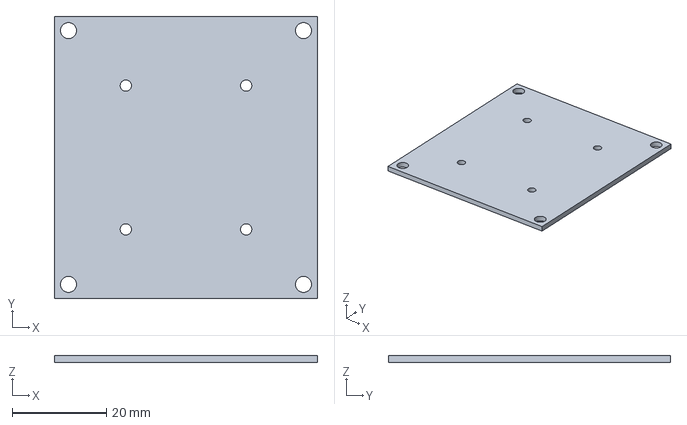
[picture p109: CAD file, 2026-10-21]
modules/actuators/cad/drive_plate_ankle.step
56.0 x 60.0 x 1.50 mm
