BryanRalston/robot-lab/modules/design/cad/covers/thigh_knee_vents.stl

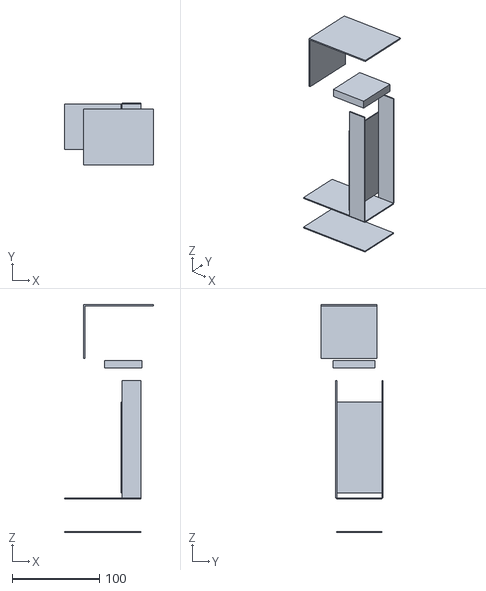
[picture p110: CAD file, 2026-10-21]
modules/design/cad/covers/thigh_knee_vents.stl
102.0 x 71.1 x 261.6
