BryanRalston/robot-lab/modules/actuators/cad/hip_pitch_lever_g3_b30_d36_e26.step

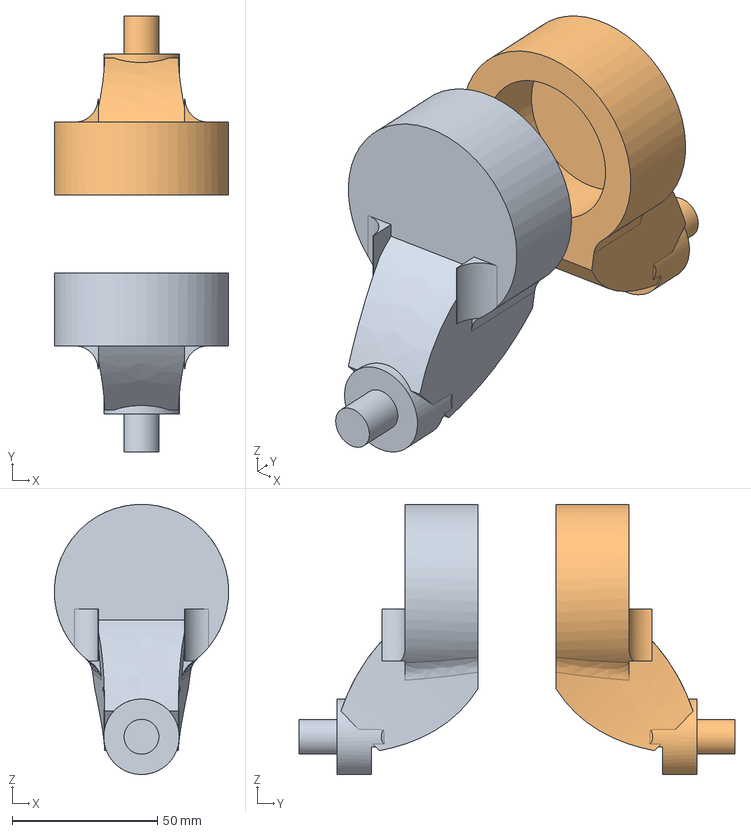
[picture p111: CAD file, 2026-10-21]
modules/actuators/cad/hip_pitch_lever_g3_b30_d36_e26.step
60.0 x 150.0 x 92.9 mm
