BryanRalston/robot-lab/modules/design/cad/covers/hip_skirt_r6.stl

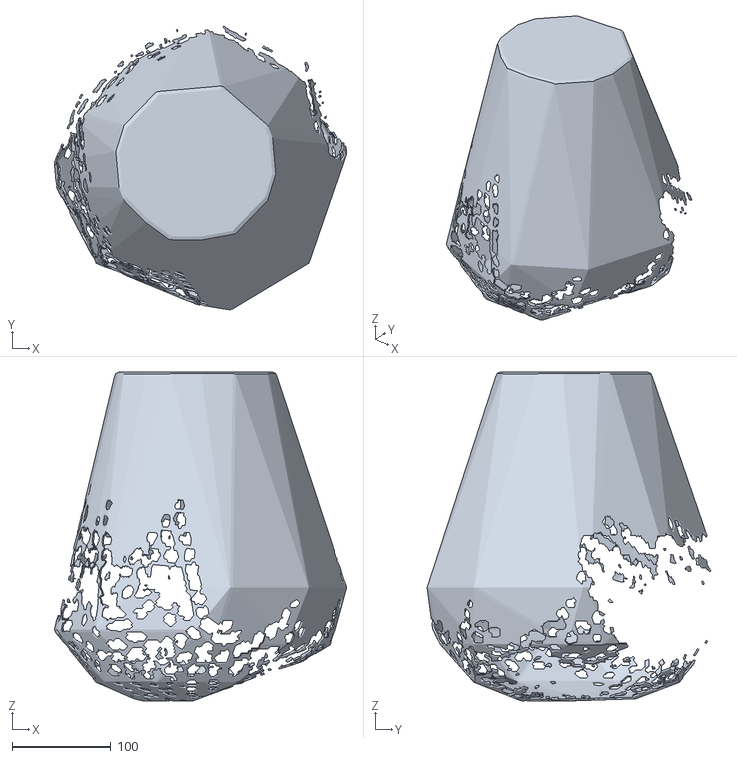
[picture p112: CAD file, 2026-10-21]
modules/design/cad/covers/hip_skirt_r6.stl
295.9 x 287.3 x 333.0
