BryanRalston/robot-lab/modules/design/cad/covers/chest_pad_bezel_r2.step

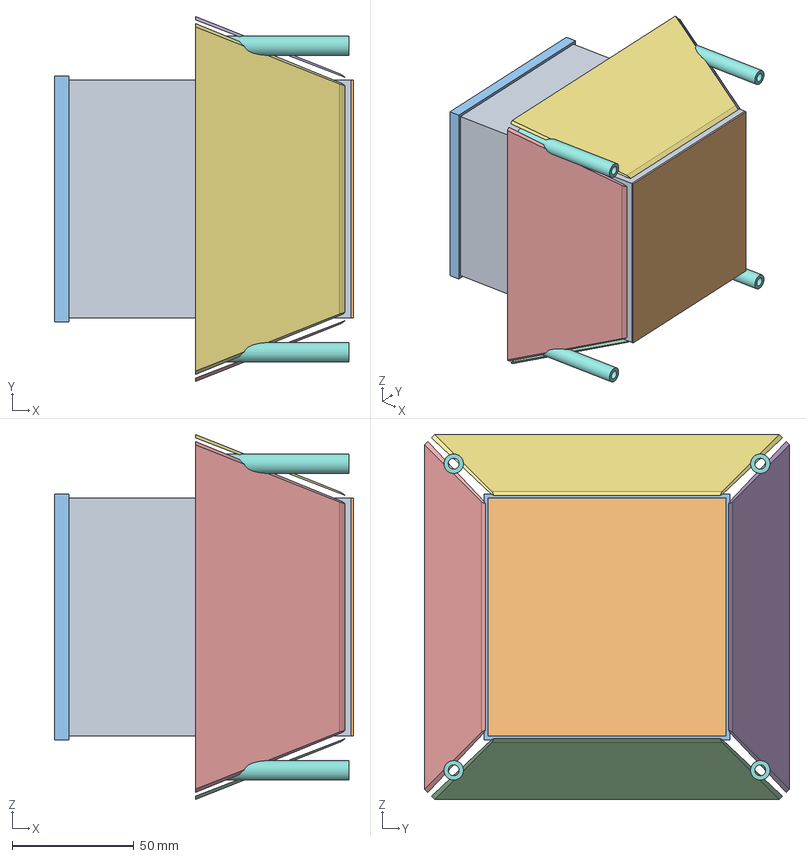
[picture p113: CAD file, 2026-10-21]
modules/design/cad/covers/chest_pad_bezel_r2.step
123.0 x 150.0 x 150.0 mm
pad_core_116
pad_face_CF
land
bezel_fairing_P052r2
crush_posts_x4
