BryanRalston/robot-lab/modules/actuators/cad/drive_plate_shoulder_pitch.step

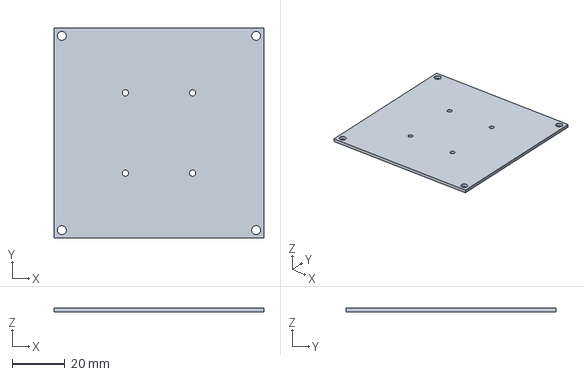
[picture p114: CAD file, 2026-10-21]
modules/actuators/cad/drive_plate_shoulder_pitch.step
80.0 x 80.0 x 1.50 mm
