BryanRalston/robot-lab/modules/design/cad/covers/knee_fin_guard.stl

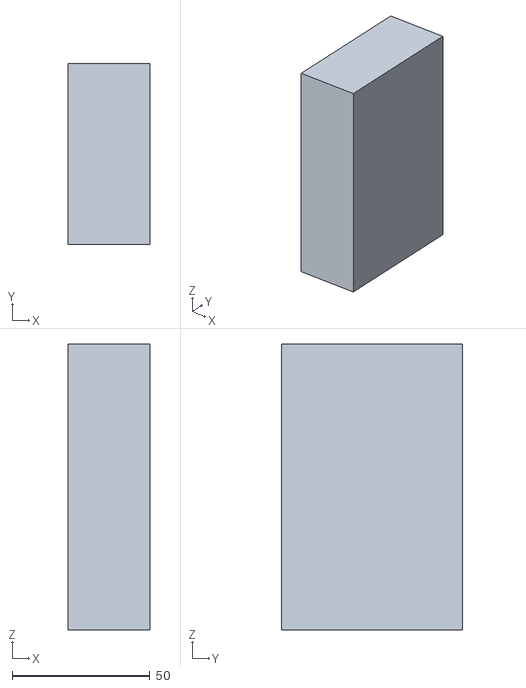
[picture p115: CAD file, 2026-10-21]
modules/design/cad/covers/knee_fin_guard.stl
30.0 x 66.0 x 104.0
