BryanRalston/robot-lab/modules/actuators/cad/wrist_place_d76.step

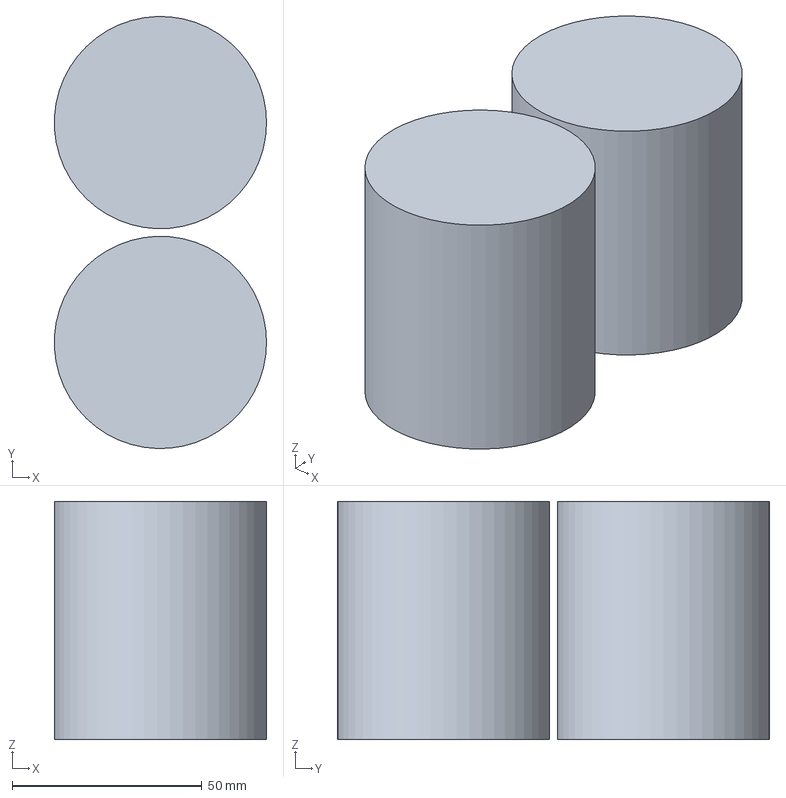
[picture p116: CAD file, 2026-10-14]
modules/actuators/cad/wrist_place_d76.step
55.9 x 114.0 x 62.8 mm
