BryanRalston/robot-lab/modules/actuators/cad/knee_twin_housing_finned_revc.step

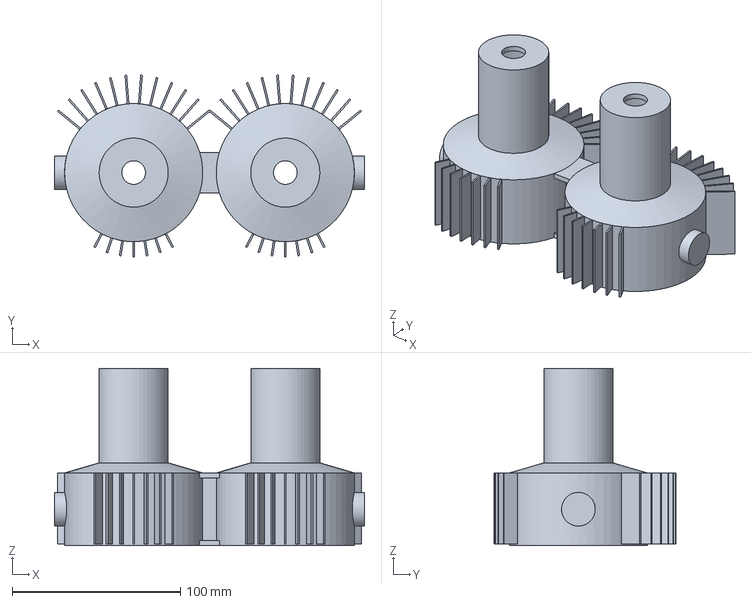
[picture p117: CAD file, 2026-10-14]
modules/actuators/cad/knee_twin_housing_finned_revc.step
184.0 x 107.9 x 105.1 mm
