BryanRalston/robot-lab/modules/actuators/cad/wrist_place_d73.step

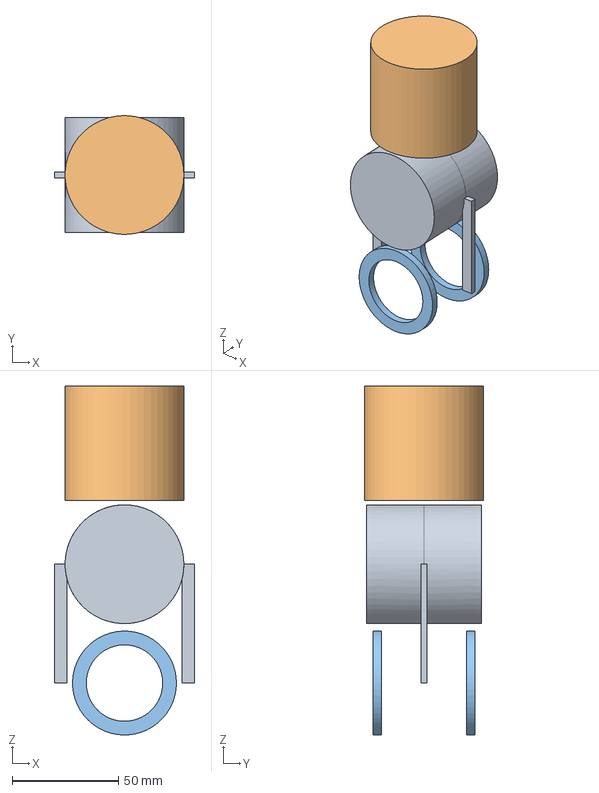
[picture p118: CAD file, 2026-10-14]
modules/actuators/cad/wrist_place_d73.step
66.0 x 56.0 x 164.5 mm
