BryanRalston/robot-lab/modules/actuators/cad/hip_pitch_lever_r031_b25_d30.step

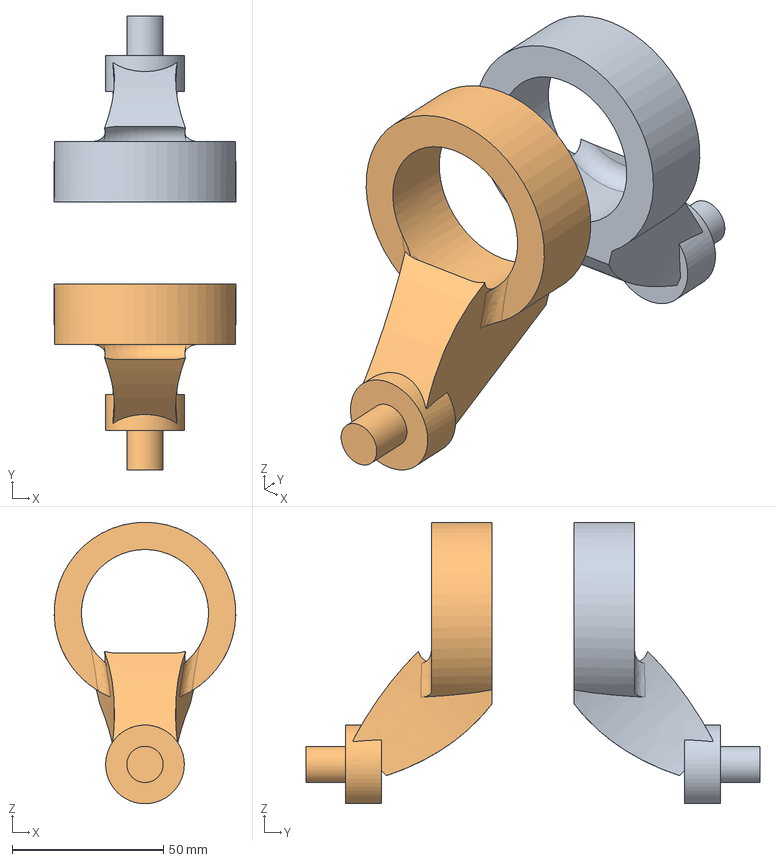
[picture p119: CAD file, 2026-10-14]
modules/actuators/cad/hip_pitch_lever_r031_b25_d30.step
60.0 x 150.0 x 93.0 mm
