BryanRalston/robot-lab/modules/actuators/cad/hip_pitch_lever_r031_b35_d40.step

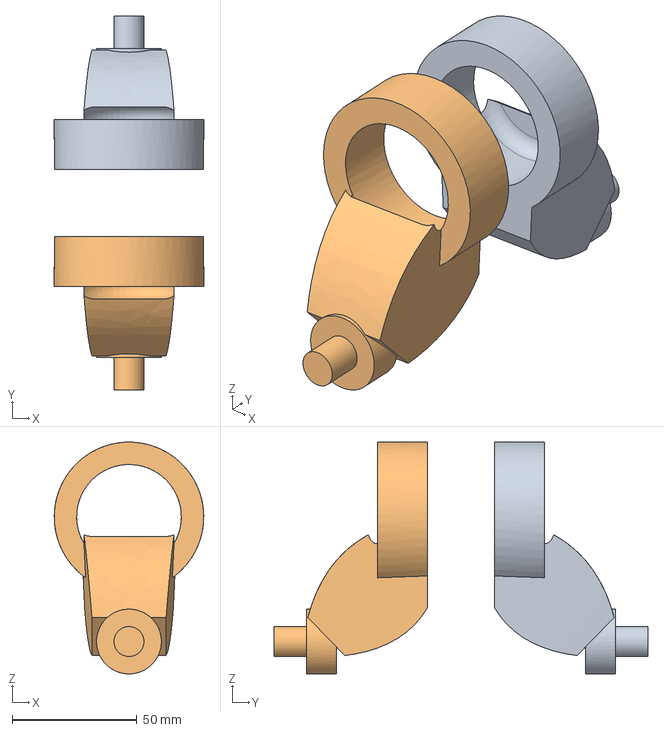
[picture p120: CAD file, 2026-10-14]
modules/actuators/cad/hip_pitch_lever_r031_b35_d40.step
60.0 x 150.0 x 93.0 mm
