BryanRalston/robot-lab/modules/actuators/cad/hip_pitch_lever_r031_b30_d36.step

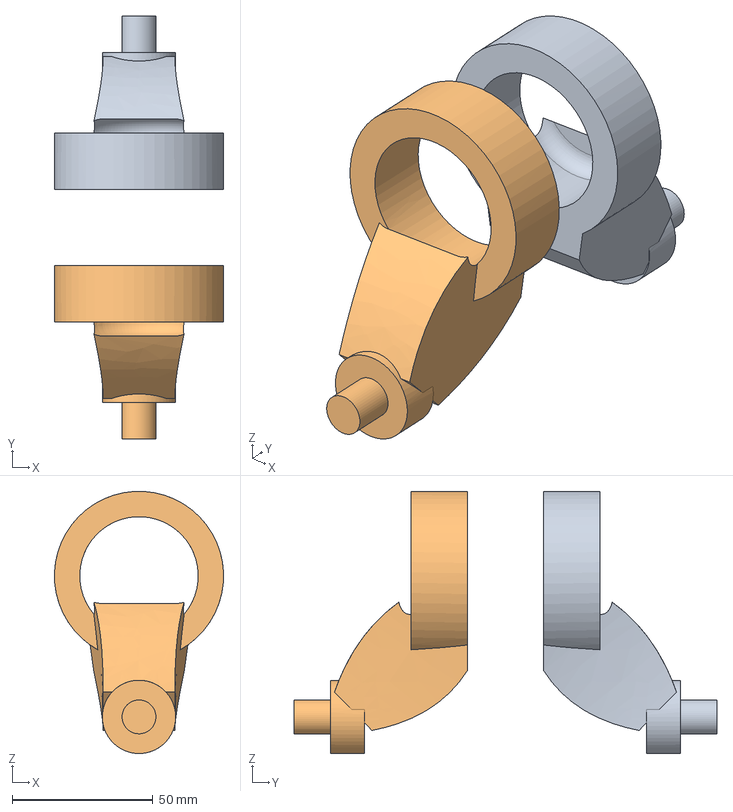
[picture p121: CAD file, 2026-10-14]
modules/actuators/cad/hip_pitch_lever_r031_b30_d36.step
60.0 x 150.0 x 92.9 mm
