BryanRalston/robot-lab/modules/actuators/cad/ankle_body_x1.step

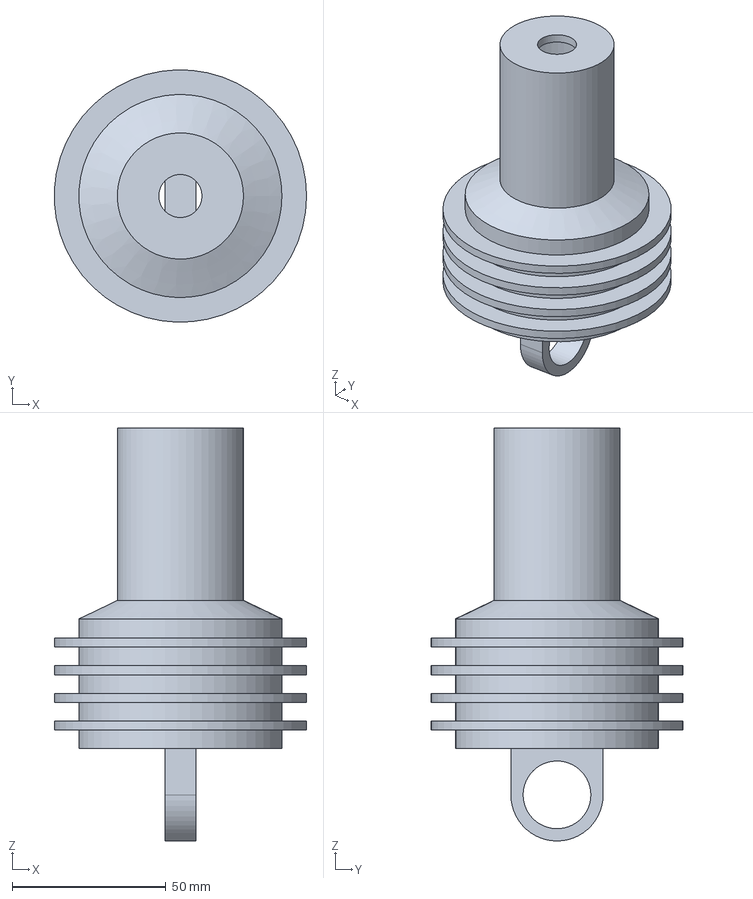
[picture p122: CAD file, 2026-10-14]
modules/actuators/cad/ankle_body_x1.step
81.9 x 82.0 x 134.2 mm
