BryanRalston/robot-lab/modules/actuators/cad/knee_body_x1.step

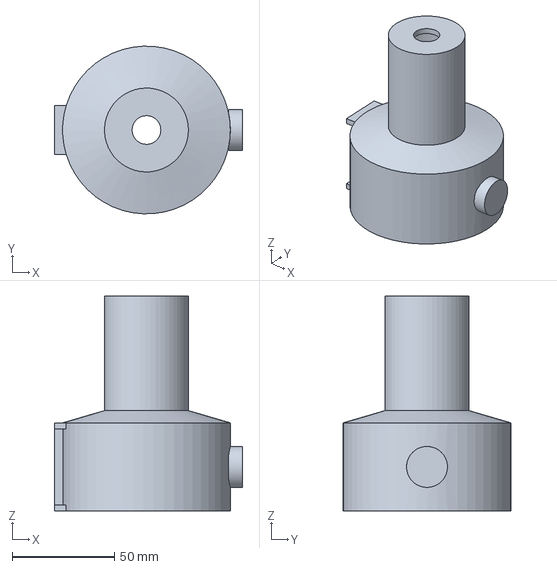
[picture p123: CAD file, 2026-10-14]
modules/actuators/cad/knee_body_x1.step
92.0 x 81.9 x 105.1 mm
