BryanRalston/robot-lab/modules/actuators/cad/hip_pitch_body_x1.step

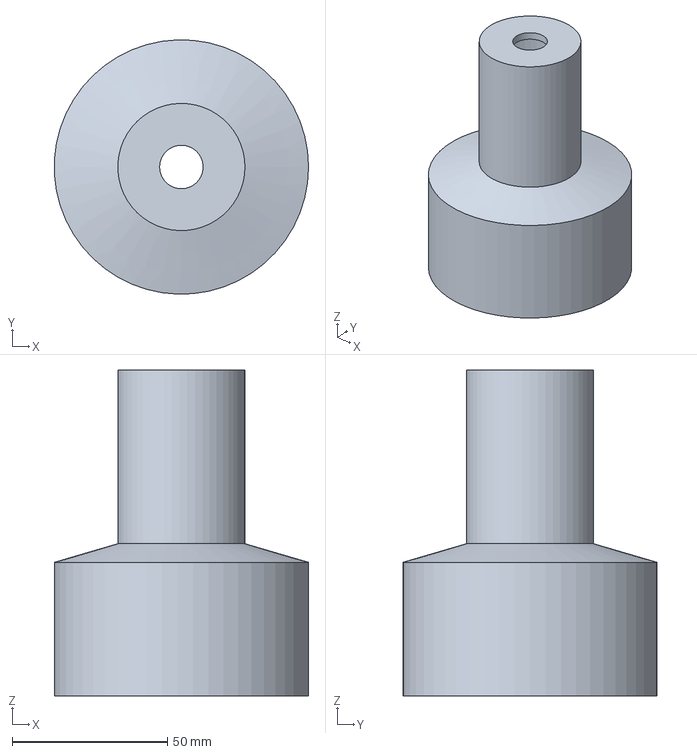
[picture p124: CAD file, 2026-10-14]
modules/actuators/cad/hip_pitch_body_x1.step
81.9 x 82.0 x 105.1 mm
