BryanRalston/robot-lab/modules/actuators/cad/knee_twin_housing.step

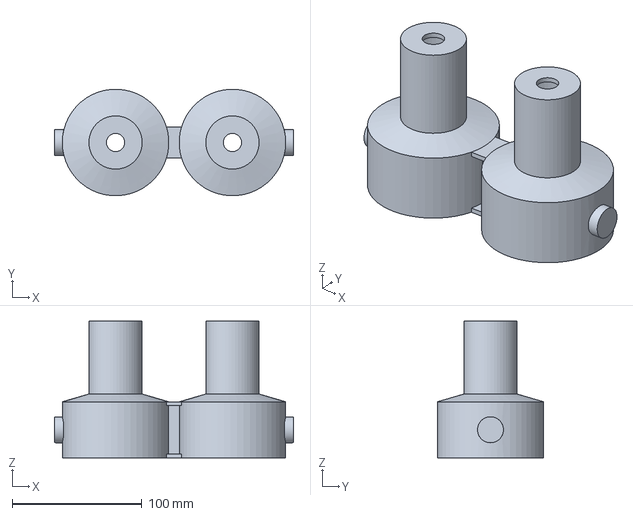
[picture p125: CAD file, 2026-10-14]
modules/actuators/cad/knee_twin_housing.step
184.0 x 81.9 x 105.1 mm
