BryanRalston/robot-lab/modules/actuators/cad/hip_pitch_lever_B_v2_B1_rejected.step

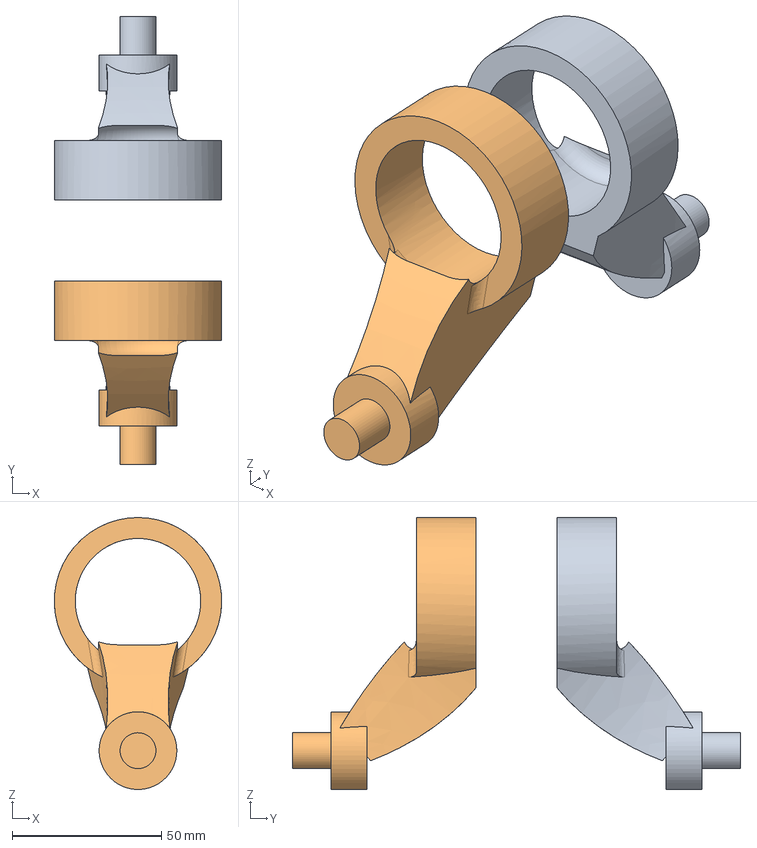
[picture p126: CAD file, 2026-10-14]
modules/actuators/cad/hip_pitch_lever_B_v2_B1_rejected.step
56.0 x 150.0 x 91.0 mm
