BryanRalston/robot-lab/modules/actuators/cad/hip_pitch_lever_B_needle_sf15.step

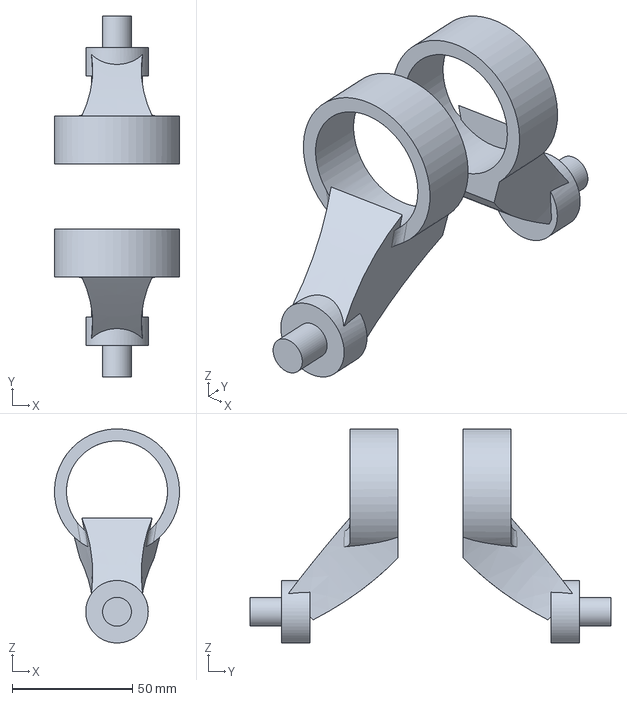
[picture p127: CAD file, 2026-10-13]
modules/actuators/cad/hip_pitch_lever_B_needle_sf15.step
52.0 x 150.0 x 88.9 mm
