BryanRalston/robot-lab/modules/actuators/cad/hip_pitch_lever_B.step

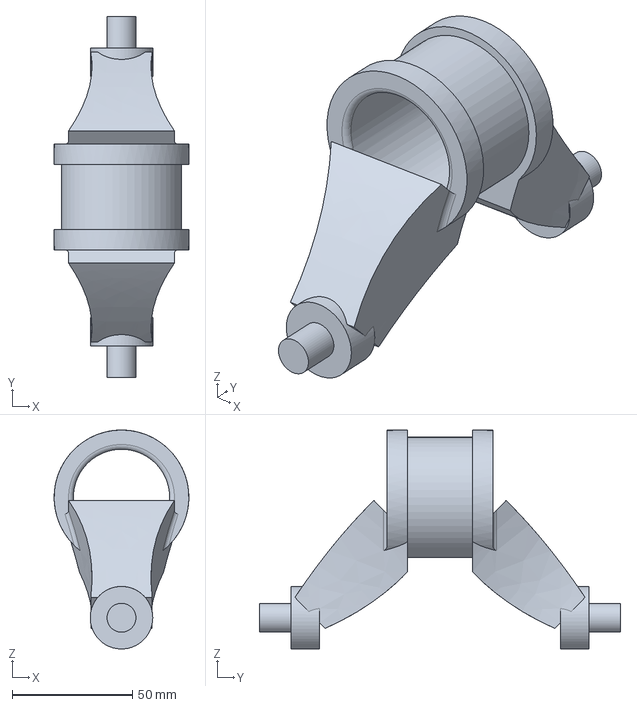
[picture p128: CAD file, 2026-10-13]
modules/actuators/cad/hip_pitch_lever_B.step
56.0 x 150.0 x 91.0 mm
