BryanRalston/robot-lab/modules/actuators/cad/knee_lever_r47p5.step

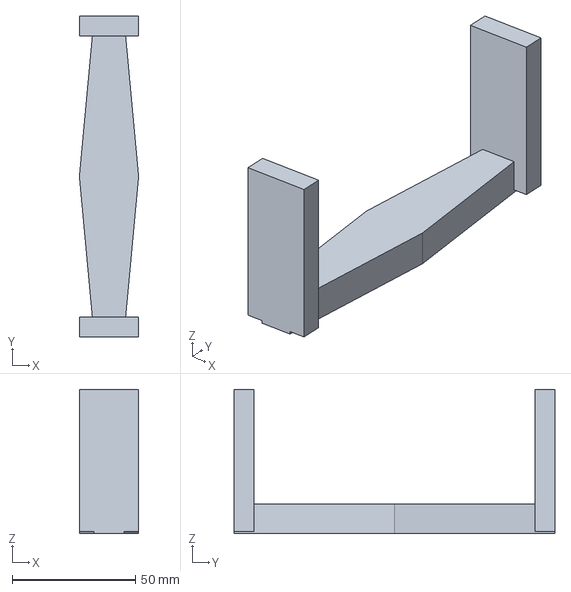
[picture p129: CAD file, 2026-10-13]
modules/actuators/cad/knee_lever_r47p5.step
24.0 x 130.0 x 58.5 mm
