BryanRalston/robot-lab/modules/actuators/cad/hip_pitch_lever_r50.step

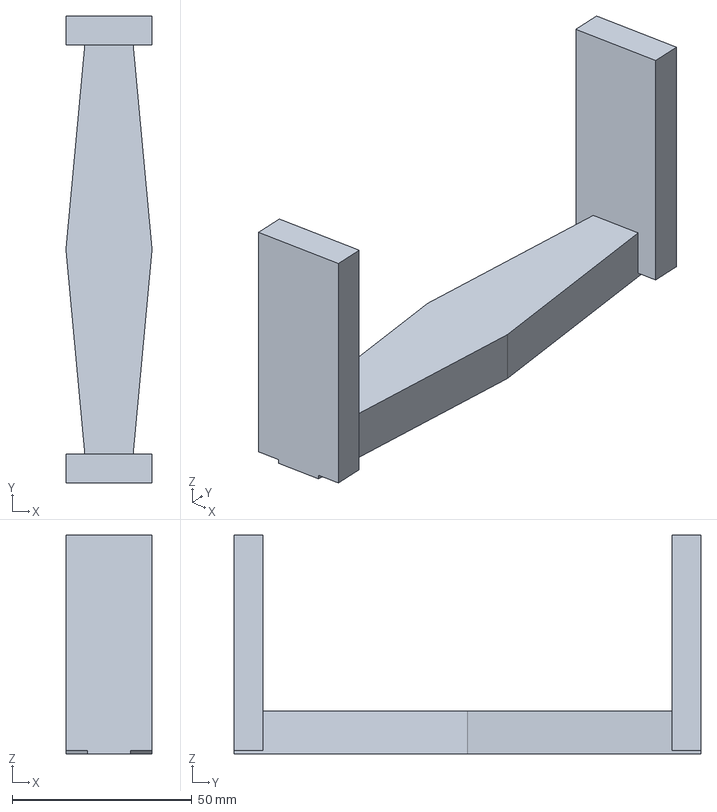
[picture p130: CAD file, 2026-10-13]
modules/actuators/cad/hip_pitch_lever_r50.step
24.0 x 130.0 x 61.0 mm
