BryanRalston/robot-lab/modules/actuators/cad/hip_yaw_housing.step

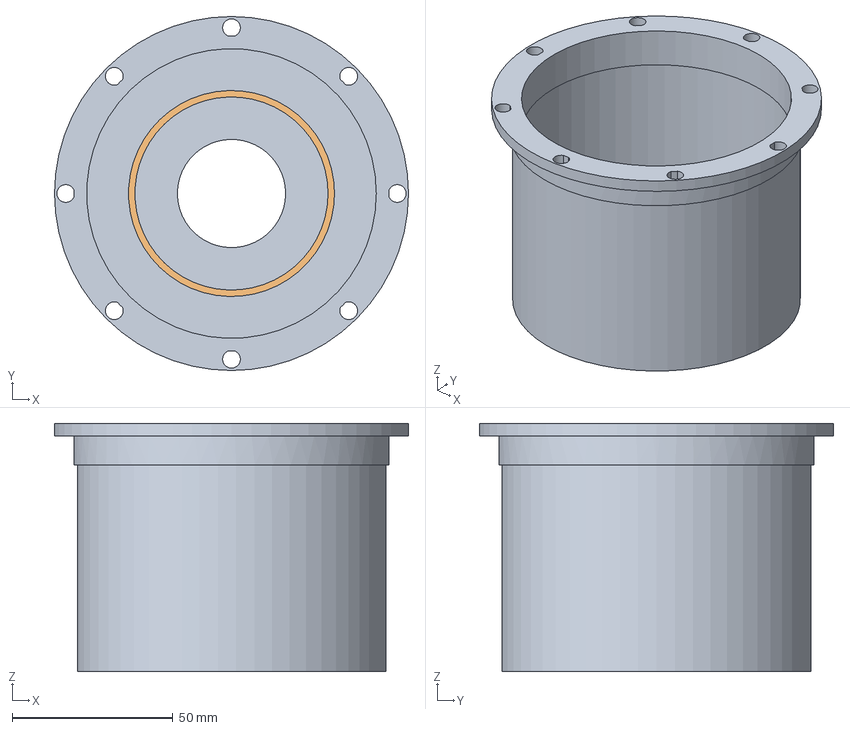
[picture p131: CAD file, 2026-10-13]
modules/actuators/cad/hip_yaw_housing.step
110.0 x 110.0 x 77.2 mm
