BryanRalston/robot-lab/modules/actuators/cad/knee_lever_r58p5_v3.step

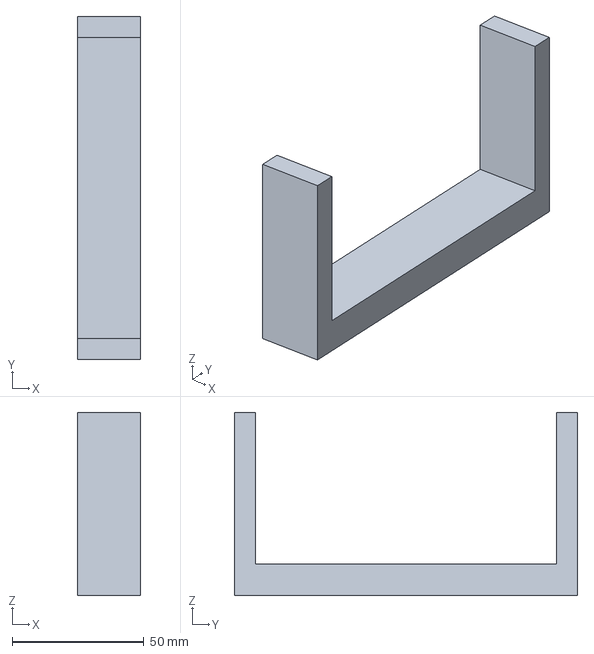
[picture p132: CAD file, 2026-10-13]
modules/actuators/cad/knee_lever_r58p5_v3.step
24.0 x 130.0 x 69.5 mm
