BryanRalston/robot-lab/modules/actuators/cad/knee_lever_r40.step

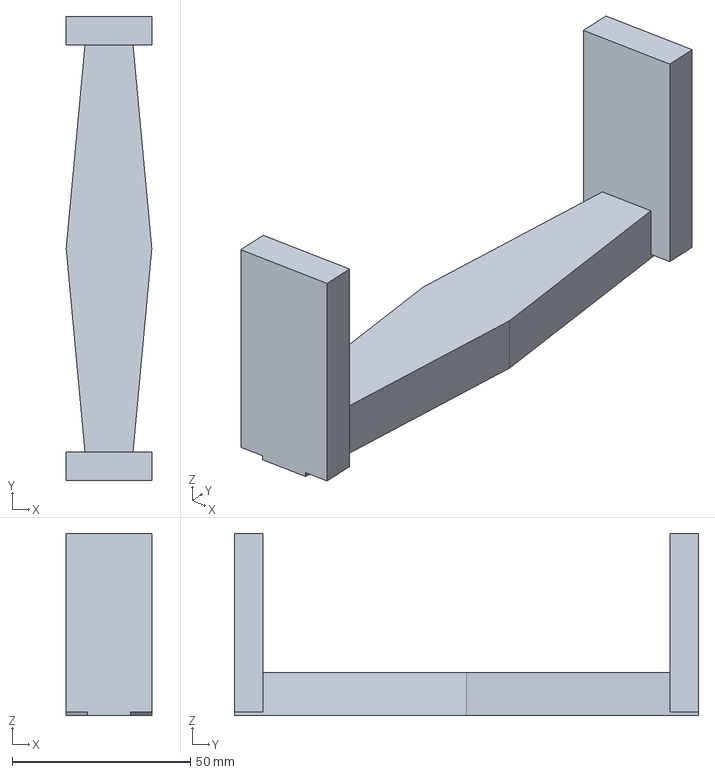
[picture p133: CAD file, 2026-10-13]
modules/actuators/cad/knee_lever_r40.step
24.0 x 130.0 x 51.0 mm
