BryanRalston/robot-lab/modules/actuators/cad/trunnion_pins_pair.step

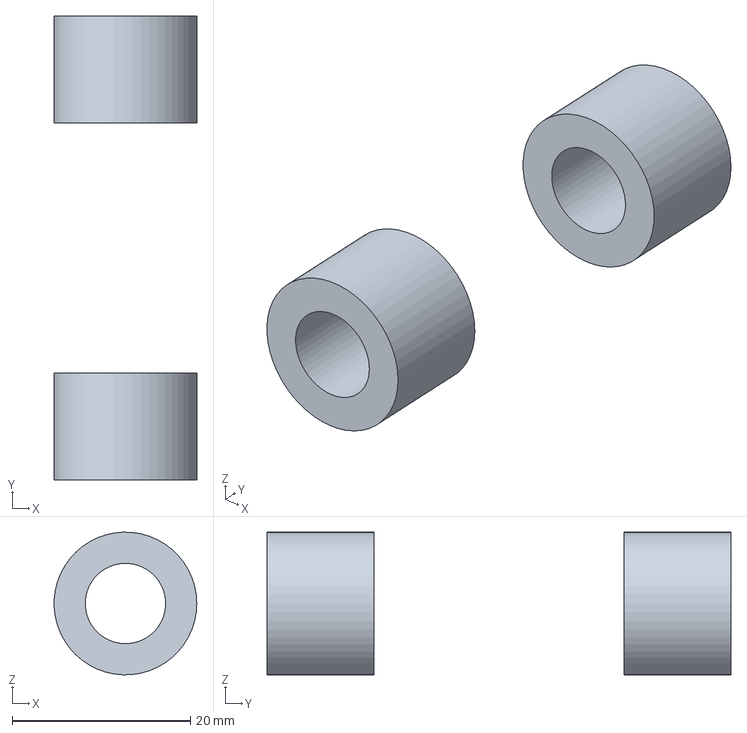
[picture p134: CAD file, 2026-10-13]
modules/actuators/cad/trunnion_pins_pair.step
16.0 x 52.0 x 16.0 mm
