BryanRalston/robot-lab/modules/actuators/cad/hip_roll_housing.step

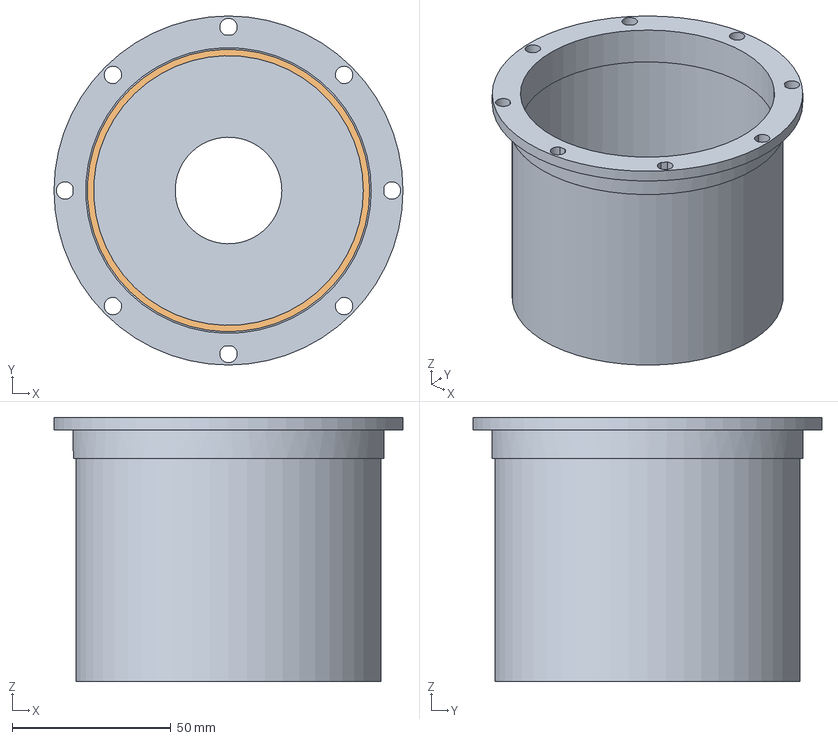
[picture p135: CAD file, 2026-10-13]
modules/actuators/cad/hip_roll_housing.step
110.0 x 110.0 x 83.3 mm
