BryanRalston/robot-lab/(list of files, cad)

Other CAD files:
modules/arms/cad/r15/pad_envelope_w2.step
modules/legs/cad/knee_twin_housing_fins_d69c_T1.step
modules/arms/cad/r15/housing_7013_coaxX.step
modules/design/cad/covers/hip_skirt_r8c_pelvis_notched.stl
modules/actuators/cad/hip_pitch_lever_g3_b34_d40_e26.step
modules/actuators/cad/knee_twin_housing_finned_revb.step
modules/actuators/cad/nut_rotor_hub_x1.step
modules/design/cad/covers/hip_skirt_r8e_stops.stl
v2/cad/export/bhl_v2_assembly.step
