BryanRalston/robot-lab/modules/legs/grokbuild/r031_fatigue_fea_brief.md

# Brief: R-031 converged fatigue FEA (for RL T&R on the bryan PC; never the box)
Inputs: `legs/R031_FIXES.md`, `legs/hp_lever_family_r031.py`, `actuators/results/GROKBUILD_lever_fea_v2.md` (G2 geometry + Amendment 1), `reliability/R1_FEA_REVIEW.md`, `legs/grokbuild/fea_r5.py` (solver base).

## Common settings
- 7075-T6 (R-123, ca66b9b): Sy 480 MPa, Su 560 MPa, E 70 GPa (ν 0.33). Se = 87 MPa (kept). **Static allowable 320 MPa** (480/1.5) at design/fault; any peak > 320 MPa is a **FAIL** (the 320–335 band is FAIL, not marginal).
- Pass: hot-spot von Mises amplitude ≤ 58 MPa at the walk load, fully reversed. (58 MPa **CONFIRMED by Materials e21dafd/6d01d59**, modules/materials/R144_7075_FATIGUE.md (MIL-HDBK-5H Fig 3.7.4.1.8(a) p.3-382, 7075-T6, R=-1, Sa 139 MPa at 1e8; ka 0.843, kb 0.90 [EST], ke 0.814, /1.5 = 57). Valid for a design life <= 1e8 cycles (assumed; no life target is set). Use 70 at 1e7 and 50 at 5e8. No hard anodize on the fatigue hot spots (arm/web fillets).) Also design/fault peak ≤ 320 MPa (SF_yield ≥ 1.5 on Sy 480).
- Convergence: h-refine to < 5 % peak change across three levels, with local h ≤ 0.5 mm at the fillets. Also report linearised membrane + bending through the root.

## Runs
1. Hip lever family, at 2030 N/pin walk and 4542 N/pin design (one-screw fault case too). G2 + modifications:
   - cap merged into a full-depth web, R8 cap/arm blends, bore-lip chamfer
   - (a) b 30 / d0 36 (pick)
   - (b) b 35 / d0 40 (fallback)
   - (c) b 32 / d0 36 / R12
   - Report the converged Kt (peak/nominal; nominal = F·35/(d0·b²/6)).
   - If (b) still exceeds 58 MPa, run 17-4PH H1025 at (a) (Se ≈ 294 MPa [EST], allowable 196 MPa) and report the mass.
2. Clevis cheek 17 mm, R8 (P-046), at R-023 loads. Goodman with Se 87 ≥ 1.5.
3. Clamp arm root 28 deep (P-046). Goodman ≥ 1.5.
4. Femur 7050-T7451 1.6 wall and tibia 1.6 wall outside the sleeve (P-047), with dent/bending at the R-023 load. Sleeve-end peel with DP490 cohesive layer E 2.5 GPa.
5. Femur tongue + A16 dowel, interference 60 MPa, bore opening under fault (P-048).
6. Foot collar OD edge with R2/taper (P-049).
7. Knee twin-housing centre web at 3.6 kN/screw (T&R #8), with D69 ø85 frame geometry from Actuators. Material per R-132 §2 / L66: 7075-T7351, plate 3.501–4.0 in [EST], ST = web thickness (trunnion axis y) [EST]; sustained ST load YES (bearing press fit + bolt preload) → limits 211 static (ST), 221 L/LT-only features, 317 fall (Job 9 interim); results above are held.

Output: `reliability/results/r031_*.json` with the peak, amplitude, Kt, SF and mesh-level table for each run.

## R-135 request: JOB9 b3 re-run at minimum wall (Legs L65/P-152, 2026-10-21)
- Geometry: femur ø50 × **1.37** wall, tibia ø45 × **1.40** wall (σ∝t^-n minimum from femur_dent_l65.py [EST interp]), outside the sleeve; sleeve OD 46.80 per P-152, DP490 layer as JOB9_SPEC b3.
- Load: R-023 side dent / bending + fall, as JOB9_SPEC b3.
- Pass: fall peak **SF ≥ 1.0 vs 393 MPa** (7050-T73511 S-basis, no permanent dent) for both tubes; keep the b3 262 single-path and adhesive peel/shear checks.
- PASS → 1.5 mm adopted (booking +0.15). FAIL → revert to P-047 1.6 mm (bore 46.8, sleeve ≤ 46.6 per BOND_SPEC §3).
