BryanRalston/robot-lab/modules/actuators/datasheets/tbm2g_manual.txt

            TM
TBM 2G
English Instruction Manual
Deutsch Betriebsanleitung
Español Manual de Instrucciones
Français Manuel d'Installation
Italiano Manuale di Istruzioni
中文       使用说明书
日本       取扱説明書
한국인 취급설명서

Edition: B, June 2023
Part Number: 908-900000-99

English       Deutsch         Español        Français       Italiano       中文           日本   한국인
Original Language is English. All other content is translated from the original language.

              For safe and proper use, follow these instructions.
              Keep them for future reference.

                                                                                                                    TBM2G Instructions |

Frontmatter

Copyrights
Copyright © 2023 Regal Rexnord Corporation, All Rights Reserved.
Information in this document is subject to change without notice. The software package described in this document is
furnished under a license agreement. The software package may be used or copied only in accordance with the terms of the
license agreement.
This document is the intellectual property of Kollmorgen and contains proprietary and confidential information. The
reproduction, modification, translation or disclosure to third parties of this document (in whole or in part) is strictly prohibited
without the prior written permission of Kollmorgen.

Trademarks
Regal Rexnord and Kollmorgen are trademarks of Regal Rexnord Corporation or one of its affiliated companies.
All other product and brand names listed in this document may be trademarks or registered trademarks of their
respective owners.

     l   TBM2G is a registered trademark of Kollmorgen Corporation
     l   CANopen is a registered trademark of CAN in Automation (CiA)
     l   EtherCAT is a registered trademark and patented technology, licensed by Beckhoff Automation GmbH
     l   LOCTITE is a registered trademark of Henkel Corporation
     l   Mylar is a DuPont® Corporation trade name
     l   Scotch-Weld ™ 2214 is a registered trademark of 3M
     l   Ghostscript is a registered trademark of Artifex Software, Inc. and is distributed under the AGPL license.

                                                                               KOLLMORGEN | kdn.kollmorgen.com | June 2023             2

TBM2G Instructions |

     Disclaimer
     Technical changes to improve the performance of the equipment may be made without prior notice!
     All rights reserved. No part of this work may be reproduced in any form (by photocopying, microfilm or any other method) or stored,
     processed, copied or distributed by electronic means without the written permission of Kollmorgen Corporation.
     Technische Änderungen, die der Verbesserung der Geräte dienen, vorbehalten!
     Alle Rechte vorbehalten. Kein Teil des Werkes darf in irgendeiner Form (Fotokopie, Mikrofilm oder in einem anderen Verfahren) ohne
     schriftliche Genehmigung der Firma Kollmorgen Corporation reproduziert oder unter Verwendung elektronischer Systeme verarbeitet,
     vervielfältigt oder verbreitet werden.
     Il produttore si riserva la facoltà di apportare modifiche tecniche volte al miglioramento degli apparecchi
     Tutti i diritti riservati. Nessuna parte di questo documento può essere rielaborata, riprodotta in qualsiasi forma (fotocopia, microfilm o altro
     processo) o diffusa mediante l'uso di sistemi elettronici senza l'approvazione scritta della ditta Kollmorgen Corporation o rielaborata,
     riprodotta o diffusa mediante l’uso di sistemi elettronici.
     Reservado el derecho de introducir modificaciones técnicas para la mejora de los equipos
     Reservados todos los derechos. Prohibida la reproducción total o parcial de la presente obra por cualquier medio (fotocopia, microfilm u
     otros), así como su procesamiento, reproducción y divulgación por medio de sistemas electrónicos, sin expresa autorización escrita de la
     empresa Kollmorgen Corporation.
     Toutes modifications techniques concourant pour l'amélioration des appareils réservées !
     Tous droits réservés. Aucune partie de l'ouvrage ne peut être reproduite sous quelque forme que ce soit (imprimée, photocopiée, microfilmée
     ou par un autre procédé) ou encore traitée, reproduite ou diffusée au moyen de systèmes électroniques sans autorisation écrite préalable de
     Kollmorgen Corporation.
     为提高设备性能而进行的技术改造可能不事先通知!

     保 留 所有 权利 。未 经 Kollmorgen公 司 书面 许 可 ，不 得以 任 何 形 式( 通 过 影 印 、缩微 胶 片 或 任何 其 他 方 法) 复
     制 本 作品 的 任 何 部分 ，或 以 电 子方 式 储 存 、处 理 、复 制 或分 发 。
     機 器 の性 能 向 上 のための技 術 的 な変 更 は、予 告 なく行 われることがあります

     本 書 の無 断転 載 を禁じます。この著 作物 のいかなる部分 も、Kollmorgen Corporationの書 面による許 可なくして、い
     かなる形 式 ( コピー、マイクロフィルム、その他 の方 法 ) でも複 製 したり、電 子 的 手段 で保 存 、加 工 、複 写 、配 布 したり
     することはできません。
     장비의 성능을 향상시키기 위한 기술적 변경은 사전 통지 없이 이루어질 수 있습니다!
     장비의 성능을 개선하기 위한 기술적 변경은 사전 통지 없이 이루어질 수 있습니다! 판권 소유. Kollmorgen
     Corporation의 서면 허가 없이 이 저작물의 어떤 부분도 어떤 형태로든 복제(복사, 마이크로필름 또는 기타 방법)
     하거나 전자적 수단으로 저장, 처리, 복사 또는 배포할 수 없습니다.

     Record of Document Revisions
      Version         Date                              Notes
      Beta            April 2022                        Beta documentation
      A               April 2023                        Initial release
      B               June 2023                         Updated data and translations

3     KOLLMORGEN | kdn.kollmorgen.com | June 2023

                                                                                         TBM2G Instructions |

Table of Contents
 1 English                                                                                           13
   1.1 General                                                                                       13
     1.1.1 About This Manual                                                                         13
     1.1.2 Abbreviations Used                                                                        13
     1.1.3 Symbols Used                                                                              13
     1.1.4 Safety                                                                                    14
          1.1.4.0.1 Safety notes                                                                     14
     1.1.5 Important Notice                                                                          16
     1.1.6 Prohibited Use                                                                            17
     1.1.7 Model Nomenclature                                                                        18
     1.1.8 Torque Overview                                                                           19
     1.1.9 Component Material Drawing                                                                19
   1.2 Storage, Operation and Transport Guidelines                                                   20
     1.2.1 Storage                                                                                   20
     1.2.2 Operation                                                                                 20
     1.2.3 Transport                                                                                 20
     1.2.4 Unpacking                                                                                 20
   1.3 Mounting and Installation Guidelines                                                          21
     1.3.1 Armature and Field Assembly Definitions                                                   21
     1.3.2 User Interface Responsibilities                                                           21
       1.3.2.1 Bearings                                                                              21
       1.3.2.2 Stator Mounting Materials                                                             21
       1.3.2.3 Rotor Mounting Materials                                                              21
       1.3.2.4 Grounding                                                                             22
       1.3.2.5 Basic Assembly Instructions                                                           23
     1.3.3 Stator Mounting Practices                                                                 24
       1.3.3.1 Stator Bonding                                                                        24
       1.3.3.2 Stator Clamping                                                                       26
     1.3.4 Rotor Mounting Practices                                                                  27
       1.3.4.1 Control of Radial Runout                                                              27
       1.3.4.2 Rotor Bonding                                                                         28
     1.3.5 Axial Mounting Practices                                                                  29
       1.3.5.1 Axial Alignment Control                                                               29
     1.3.6 Axial Mounting                                                                            29
     1.3.7 Electrical Wiring Interface                                                               31
       1.3.7.1 Wiring                                                                                31
       1.3.7.2 Lead Wire Requirements (no lead option)                                               31
       1.3.7.3 Power Leads General Specifications and Wiring                                         31
       1.3.7.4 Thermal Device General Specifications and Wiring                                      33
          1.3.7.4.1 Thermal Protection                                                               33
       1.3.7.5 Hall Sensor Device General Specifications and Wiring                                  35
   1.4 Definition of Terms for Technical Data                                                        37
 2 Deutsch                                                                                           38
   2.1 Allgemeines                                                                                   38
     2.1.1 Über dieses Handbuch                                                                      38
     2.1.2 Verwendete Abkürzungen                                                                    38
     2.1.3 Verwendete Symbole                                                                        39

                                                            KOLLMORGEN | kdn.kollmorgen.com | June 2023    4

TBM2G Instructions |

             2.1.4 Sicherheit                                                    40
                  2.1.4.0.1 Sicherheitshinweise                                  40
             2.1.5 Wichtiger Hinweis                                             42
             2.1.6 Nicht bestimmungsgemäße Verwendung                            43
             2.1.7 Modellnomenklatur                                             44
             2.1.8 Drehmoment Überblick                                          45
             2.1.9 Zeichnung der Komponentenmaterialien                          45
           2.2 Richtlinien für Lagerung, Betrieb und Transport                   46
             2.2.1 Lagerung                                                      46
             2.2.2 Betrieb                                                       46
             2.2.3 Transport                                                     46
             2.2.4 Auspacken                                                     46
           2.3 Montage- und Installationshinweise                                47
             2.3.1 Definitionen der Anker- und Feldbaugruppe                     47
             2.3.2 Verantwortung des Benutzers für die Schnittstellen            48
               2.3.2.1 Lager                                                     48
               2.3.2.2 Materialien für die Statormontage                         48
               2.3.2.3 Materialien für die Rotormontage                          48
               2.3.2.4 Erdung                                                    48
               2.3.2.5 Grundlegende Einbauanweisungen                            49
             2.3.3 Vorgehensweise bei der Statormontage                          51
               2.3.3.1 Statorverklebung                                          51
               2.3.3.2 Stator-Klemmung                                           53
             2.3.4 Vorgehensweise bei der Rotormontage                           54
               2.3.4.1 Kontrolle des radialen Nachlaufs                          54
               2.3.4.2 Rotorverklebung                                           55
             2.3.5 Vorgehensweise bei axialer Montage                            56
               2.3.5.1 Kontrolle der axialen Ausrichtung                         56
             2.3.6 Axiale Montage                                                57
             2.3.7 Schnittstelle der elektrischen Verkabelung                    59
               2.3.7.1 Verdrahtung                                               59
               2.3.7.2 Anforderungen an Anschlusskabel (Option ohne Kabel)       59
               2.3.7.3 Allgemeine Daten und Verkabelung der Stromleitungen       59
               2.3.7.4 Allgemeine Daten und Verkabelung der thermischen Geräte   61
                  2.3.7.4.1 Thermoschutz                                         61
               2.3.7.5 Allgemeine Daten und Verkabelung des Hall-Sensors         63
           2.4 Begriffsdefinitionen für technische Daten                         65
        3 Español                                                                68
           3.1 General                                                           68
             3.1.1 Acerca de este manual                                         68
             3.1.2 Abreviaturas usadas                                           68
             3.1.3 Símbolos usados                                               69
             3.1.4 Seguridad                                                     70
                  3.1.4.0.1 Notas de seguridad                                   70
             3.1.5 Nota importante                                               72
             3.1.6 Uso prohibido                                                 73
             3.1.7 Nomenclatura modelo                                           74
             3.1.8 Resumen de par de torsión                                     75

5     KOLLMORGEN | kdn.kollmorgen.com | June 2023

                                                                                         TBM2G Instructions |

   3.1.9 Diagrama de materiales de componentes                                                       75
 3.2 Directrices de almacenamiento, funcionamiento y transporte                                      76
   3.2.1 Almacenamiento                                                                              76
   3.2.2 Funcionamiento                                                                              76
   3.2.3 Transporte                                                                                  76
   3.2.4 Desembalaje                                                                                 76
 3.3 Directrices de instalación y montaje                                                            77
   3.3.1 Definiciones de Conjunto de campo y armazón                                                 77
   3.3.2 Responsabilidades de la interfaz de usuario                                                 78
     3.3.2.1 Rodamientos                                                                             78
     3.3.2.2 Materiales de montaje del estátor                                                       78
     3.3.2.3 Materiales de montaje del rotor                                                         78
     3.3.2.4 Conexión a tierra                                                                       78
     3.3.2.5 Instrucciones básicas de montaje                                                        79
   3.3.3 Prácticas de montaje del estátor                                                            81
     3.3.3.1 Conexión del estátor                                                                    81
     3.3.3.2 Sujeción del estátor                                                                    83
   3.3.4 Prácticas de montaje del rotor                                                              84
     3.3.4.1 Control de la desviación radial                                                         84
     3.3.4.2 Conexión del rotor                                                                      85
   3.3.5 Prácticas de montaje axial                                                                  86
     3.3.5.1 Control de alineación axial                                                             86
   3.3.6 Montaje axial                                                                               87
   3.3.7 Interfaz del cableado eléctrico                                                             89
     3.3.7.1 Cableado                                                                                89
     3.3.7.2 Requisitos del cable conductor (opción sin cable)                                       89
     3.3.7.3 Especificaciones generales y tendido de los cables de alimentación                      89
     3.3.7.4 Especificaciones generales y cableado del dispositivo térmico                           91
        3.3.7.4.1 Protección térmica                                                                 91
     3.3.7.5 Especificaciones generales y cableado del dispositivo sensor de Hall                    93
 3.4 Definición de los términos de Datos técnicos                                                    95
4 Français                                                                                           96
 4.1 Généralités                                                                                     96
   4.1.1 À propos de ce manuel                                                                       96
   4.1.2 Abréviations utilisées                                                                      96
   4.1.3 Symboles utilisés                                                                           97
   4.1.4 Sécurité                                                                                    98
        4.1.4.0.1 Consignes de sécurité                                                              98
   4.1.5 Avis important                                                                             100
   4.1.6 Utilisation interdite                                                                      101
   4.1.7 Nomenclature des modèles                                                                   102
   4.1.8 Vue d'ensemble des couples                                                                 103
   4.1.9 Description des matériaux des composants                                                   103
 4.2 Consignes de stockage, d'utilisation et de transport                                           104
   4.2.1 Stockage                                                                                   104
   4.2.2 Utilisation                                                                                104
   4.2.3 Transport                                                                                  104
   4.2.4 Déballage                                                                                  104

                                                            KOLLMORGEN | kdn.kollmorgen.com | June 2023    6

TBM2G Instructions |

           4.3 Consignes de montage et d'installation                                        105
             4.3.1 Définition de l'ensemble induit et de l'ensemble inducteur                105
             4.3.2 Responsabilités de l'utilisateur concernant l'interface                   106
               4.3.2.1 Paliers                                                               106
               4.3.2.2 Matériaux pour le montage du stator                                   106
               4.3.2.3 Matériaux pour le montage du rotor                                    106
               4.3.2.4 Mise à la terre                                                       106
               4.3.2.5 Instructions de montage de base                                       107
             4.3.3 Techniques de montage du stator                                           109
               4.3.3.1 Collage du stator                                                     109
               4.3.3.2 Serrage du stator                                                     111
             4.3.4 Techniques de montage du rotor                                            112
               4.3.4.1 Contrôle du faux-rond radial                                          112
               4.3.4.2 Collage du rotor                                                      113
             4.3.5 Techniques de montage axial                                               114
               4.3.5.1 Contrôle de l'alignement axial                                        114
             4.3.6 Montage axial                                                             115
             4.3.7 Interface de câblage électrique                                           117
               4.3.7.1 Câblage                                                               117
               4.3.7.2 Exigences relatives aux fils conducteurs (version fournie sans fil)   117
               4.3.7.3 Caractéristiques générales et câblage des fils d'alimentation         117
               4.3.7.4 Caractéristiques générales et câblage des dispositifs thermiques      119
                  4.3.7.4.1 Protection thermique                                             119
               4.3.7.5 Caractéristiques générales et câblage des capteurs à effet Hall       121
           4.4 Définition des termes pour les caractéristiques techniques                    123
        5 Italiano                                                                           126
           5.1 Generale                                                                      126
             5.1.1 Informazioni sul presente manuale                                         126
             5.1.2 Abbreviazioni usate                                                       126
             5.1.3 Simboli usati                                                             127
             5.1.4 Sicurezza                                                                 128
                  5.1.4.0.1 Note sulla sicurezza                                             128
             5.1.5 Nota importante                                                           130
             5.1.6 Uso vietato                                                               131
             5.1.7 Nomenclatura modello                                                      132
             5.1.8 Panoramica valori di coppia                                               133
             5.1.9 Illustrazione dei materiali dei componenti                                133
           5.2 Linee guida per lo stoccaggio, il funzionamento e il trasporto                134
             5.2.1 Conservazione                                                             134
             5.2.2 Funzionamento                                                             134
             5.2.3 Trasporto                                                                 134
             5.2.4 Rimozione dell'imballaggio                                                134
           5.3 Linee guida per il montaggio e l'installazione                                135
             5.3.1 Definizioni di gruppo indotto e gruppo campo                              135
             5.3.2 Responsabilità dell'utilizzatore in merito all'interfaccia                136
               5.3.2.1 Cuscinetti                                                            136
               5.3.2.2 Materiali per il montaggio dello statore                              136
               5.3.2.3 Materiali per il montaggio del rotore                                 136

7     KOLLMORGEN | kdn.kollmorgen.com | June 2023

                                                                                          TBM2G Instructions |

     5.3.2.4 Messa a terra                                                                           136
     5.3.2.5 Istruzioni di base per il montaggio                                                     137
   5.3.3 Procedure di montaggio dello statore                                                        139
     5.3.3.1 Incollaggio dello statore                                                               139
     5.3.3.2 Bloccaggio dello statore                                                                141
   5.3.4 Procedure di montaggio del rotore                                                           142
     5.3.4.1 Controllo della coassialità radiale                                                     142
     5.3.4.2 Incollaggio del rotore                                                                  143
   5.3.5 Procedure di montaggio assiale                                                              144
     5.3.5.1 Controllo dell'allineamento assiale                                                     144
   5.3.6 Montaggio assiale                                                                           145
   5.3.7 Interfaccia di cablaggio elettrico                                                          147
     5.3.7.1 Cablaggio                                                                               147
     5.3.7.2 Requisiti per i cavi (nessuna opzione)                                                  147
     5.3.7.3 Specifiche generali e cablaggio dei cavi di alimentazione                               147
     5.3.7.4 Specifiche generali e cablaggio dei dispositivi termici                                 149
        5.3.7.4.1 Protezione termica                                                                 149
     5.3.7.5 Specifiche generali e cablaggio dei sensori a effetto Hall                              151
 5.4 Definizione dei termini per i dati tecnici                                                      153
6 中文                                                                                                 156
 6.1 一 般 信 息                                                                                         156
   6.1.1 关 于本 手 册                                                                                    156
   6.1.2 所 使用 的 缩 写 词                                                                                156
   6.1.3 所 用符 号                                                                                      157
   6.1.4 安 全性                                                                                        158
   6.1.5 重 要事 项                                                                                      160
   6.1.6 禁 止使 用                                                                                      162
   6.1.7 型 号命 名 原 则                                                                                  163
   6.1.8 转 矩概 览                                                                                      164
   6.1.9 部 件材 料 图                                                                                    164
 6.2 储 存 、操 作 和 运 输 指 南                                                                              165
   6.2.1 储 存                                                                                         165
   6.2.2 操 作                                                                                         165
   6.2.3 运 输                                                                                         165
   6.2.4 开 箱                                                                                         165
 6.3 固 定 和 安 装 指 南                                                                                   166
   6.3.1 电 枢组 件 和 磁 场组 件 的 定义                                                                        166
   6.3.2 用 户接 口 职 责                                                                                  167
     6.3.2.1 轴 承                                                                                     167
     6.3.2.2 定 子 安 装材 料                                                                              167
     6.3.2.3 转 子 安 装材 料                                                                              167
     6.3.2.4 接 地                                                                                     167
     6.3.2.5 基 本 组 装说 明                                                                              168
   6.3.3 定 子安 装 实 践                                                                                  170
     6.3.3.1 定 子 粘 合                                                                                 170
     6.3.3.2 定 子 夹持                                                                                  172
   6.3.4 转 子安 装 实 践                                                                                  173
     6.3.4.1 径 向 跳 动控 制                                                                              173

                                                             KOLLMORGEN | kdn.kollmorgen.com | June 2023    8

TBM2G Instructions |

               6.3.4.2 转 子 粘 合                      174
             6.3.5 轴 向安 装 实 践                       175
               6.3.5.1 轴 向 对 齐控 制                   175
             6.3.6 轴 向安 装                           176
             6.3.7 电 气连 线 接 口                       178
               6.3.7.1 接 线                          178
               6.3.7.2 引 线 要 求( 无 引 线 选 项)          178
               6.3.7.3 电 源 线 一般 规 格 和 接线            178
               6.3.7.4 过 热 保 护装 置 一 般 规格 和 接 线      180
               6.3.7.5 霍 尔传 感 器 器件 一 般 规 格和 接 线     182
           6.4 技 术 数 据 的 术 语 定 义                    184
        7 日本語                                       186
           7.1 一 般 情 報                              186
             7.1.1 この操 作 説 明書 について                  186
             7.1.2 使 用されている略語                       186
             7.1.3 使 用されている記号                       187
             7.1.4 安 全性                             188
             7.1.5 重 要な通 知                          190
             7.1.6 禁 止事 項                           191
             7.1.7 モデルの分 類 法                        193
             7.1.8 トルクの概要                           194
             7.1.9 部 品材 質 の図                        194
           7.2 保 管 、運 用 、運 搬 のガイドライン                195
             7.2.1 保 管環 境                           195
             7.2.2 運 用                              195
             7.2.3 運 搬                              195
             7.2.4 開 梱                              195
           7.3 取 り付 けおよび設 置 のガイドライン                 196
             7.3.1 電 機子 およびフィールドアセンブリの定 義           196
             7.3.2 接 触面 についての注 意点                   197
               7.3.2.1 ベアリング                        197
               7.3.2.2 ステータの取 り付 け部 材               197
               7.3.2.3 ロータの取 り付 け部 材                197
               7.3.2.4 接 地                          197
               7.3.2.5 基 本 的 な組 み立てについての指 示         198
             7.3.3 ステータの取り付 け作 業                    200
               7.3.3.1 ステータの接 着                     200
               7.3.3.2 ステータのクランプ                    202
             7.3.4 ロータの取 り付 け作 業                    204
               7.3.4.1 ラジアル振 れの制 御                  204
               7.3.4.2 ロータの接 着                      205
             7.3.5 軸 の取 り付 け作 業                     206
               7.3.5.1 軸 アライメント制 御                  206
             7.3.6 軸 の取 り付 け                        207
             7.3.7 電 気配 線 インターフェイス                  209
               7.3.7.1 配 線                          209
               7.3.7.2 リード線の要 件( リードなしオプション)        209
               7.3.7.3 入 力 線 の一 般仕 様 および配 線         209

9     KOLLMORGEN | kdn.kollmorgen.com | June 2023

                                                                         TBM2G Instructions |

     7.3.7.4 熱 デバイスの一 般仕 様 および配 線                                                   211
     7.3.7.5 ホールセンサ装 置の一 般仕 様 および配 線                                                213
 7.4 技 術 データ用 語 の定 義                                                                215
8 한국어                                                                               218
 8.1 일반                                                                             218
   8.1.1 설명서 정보                                                                     218
   8.1.2 사용되는 약어                                                                    218
   8.1.3 사용된 기호                                                                     219
   8.1.4 안전성                                                                        220
   8.1.5 중요 알림                                                                      222
   8.1.6 금지된 사용                                                                     223
   8.1.7 모델 명명법                                                                     224
   8.1.8 토크 개요                                                                      225
   8.1.9 구성 요소 재료 도면                                                                225
 8.2 보관, 작동 및 운반 지침                                                                 226
   8.2.1 보관                                                                         226
   8.2.2 작동                                                                         226
   8.2.3 운송                                                                         226
   8.2.4 포장 풀기                                                                      226
 8.3 장착 및 설치 지침                                                                     227
   8.3.1 전기자 및 필드 어셈블리 정의                                                           227
   8.3.2 사용자 인터페이스 책임                                                               228
     8.3.2.1 베어링                                                                    228
     8.3.2.2 고정자 장착 재료                                                              228
     8.3.2.3 로터 장착 재료                                                               228
     8.3.2.4 접지                                                                     228
     8.3.2.5 기본 조립 지침                                                               229
   8.3.3 고정자 장착 방식                                                                  231
     8.3.3.1 고정자 본딩                                                                 231
     8.3.3.2 고정자 클램핑                                                                233
   8.3.4 로터 장착 방식                                                                   235
     8.3.4.1 방사상 런아웃 제어                                                             235
     8.3.4.2 로터 본딩                                                                  236
   8.3.5 축 장착 방식                                                                    237
     8.3.5.1 축 정렬 제어                                                                237
   8.3.6 축 장착                                                                       238
   8.3.7 전기 배선 인터페이스                                                                240
     8.3.7.1 배선                                                                     240
     8.3.7.2 리드 와이어 요구 사항(리드 없는 옵션)                                                 240
     8.3.7.3 전력 리드 일반 사양 및 배선                                                       240
     8.3.7.4 열 장치 일반 사양 및 배선                                                        242
     8.3.7.5 홀 센서 장치 일반 사양 및 배선                                                     244
 8.4 기술 데이터 용어 정의                                                                   246
9 Technical Data                                                                    248
 9.1 Dictionary for technical data tables                                           249
   9.1.1 Motor Terminology                                                          249
   9.1.2 Brake Terminology                                                          251
 9.2 TBM2G-050 Data & Drawings                                                      252

                                            KOLLMORGEN | kdn.kollmorgen.com | June 2023   10

TBM2G Instructions |

             9.2.1 TBM2G-05008 Frameless Motor Specifications      252
             9.2.2 TBM2G-05013 Frameless Motor Specifications      254
             9.2.3 TBM2G-05026 Frameless Motor Specifications      256
             9.2.4 TBM2G-050 Frameless Motor Performance Curves    258
             9.2.5 TBM2G-050 Frameless Motor Outline Drawing       260
             9.2.6 TBM2G-050 Series Optional Lead Specifications   261
           9.3 TBM2G-060 Data & Drawings                           262
             9.3.1 TBM2G-06008 Frameless Motor Specifications      262
             9.3.2 TBM2G-06013 Frameless Motor Specifications      264
             9.3.3 TBM2G-06026 Frameless Motor Specifications      266
             9.3.4 TBM2G-060 Frameless Motor Performance Curves    268
             9.3.5 TBM2G-060 Frameless Motor Outline Drawing       270
             9.3.6 TBM2G-060 Series Optional Lead Specifications   271
           9.4 TBM2G-068 Data & Drawings                           272
             9.4.1 TBM2G-06808 Frameless Motor Specifications      272
             9.4.2 TBM2G-06813 Frameless Motor Specifications      274
             9.4.3 TBM2G-06826 Frameless Motor Specifications      276
             9.4.4 TBM2G-068 Frameless Motor Performance Curves    278
             9.4.5 TBM2G-068 Frameless Motor Outline Drawing       280
             9.4.6 TBM2G-068 Series Optional Lead Specifications   281
           9.5 TBM2G-076 Data & Drawings                           282
             9.5.1 TBM2G-07608 Frameless Motor Specifications      282
             9.5.2 TBM2G-07613 Frameless Motor Specifications      284
             9.5.3 TBM2G-07626 Frameless Motor Specifications      286
             9.5.4 TBM2G-076 Frameless Motor Performance Curves    288
             9.5.5 TBM2G-076 Frameless Motor Outline Drawing       290
             9.5.6 TBM2G-076 Series Optional Lead Specifications   291
           9.6 TBM2G-085 Data & Drawings                           292
             9.6.1 TBM2G-08508 Frameless Motor Specifications      292
             9.6.2 TBM2G-08513 Frameless Motor Specifications      294
             9.6.3 TBM2G-08526 Frameless Motor Specifications      296
             9.6.4 TBM2G-085 Frameless Motor Performance Curves    298
             9.6.5 TBM2G-085 Frameless Motor Outline Drawing       300
             9.6.6 TBM2G-085 Series Optional Lead Specifications   301
           9.7 TBM2G-094 Data & Drawings                           302
             9.7.1 TBM2G-09408 Frameless Motor Specifications      302
             9.7.2 TBM2G-09413 Frameless Motor Specifications      304
             9.7.3 TBM2G-09426 Frameless Motor Specifications      306
             9.7.4 TBM2G-094 Frameless Motor Performance Curves    308
             9.7.5 TBM2G-094 Frameless Motor Outline Drawing       310
             9.7.6 TBM2G-094 Series Optional Lead Specifications   311
           9.8 TBM2G-115 Data & Drawings                           312
             9.8.1 TBM2G-11508 Frameless Motor Specifications      312
             9.8.2 TBM2G-11513 Frameless Motor Specifications      314
             9.8.3 TBM2G-11526 Frameless Motor Specifications      316
             9.8.4 TBM2G-115 Frameless Motor Performance Curves    318
             9.8.5 TBM2G-115 Frameless Motor Outline Drawing       320
             9.8.6 TBM2G-115 Series Optional Lead Specifications   321

11    KOLLMORGEN | kdn.kollmorgen.com | June 2023

                                                              TBM2G Instructions |

10 Approvals                                                             322
 10.1   CE Technical Notice                                              322
 10.2   Conformance with uL                                              324
 10.3   Conformance with RoHS                                            324
 10.4   Conformance with REACH                                           324

                                 KOLLMORGEN | kdn.kollmorgen.com | June 2023   12

TBM2G Instructions | 1 English

     1 English

     1.1 General

     1.1.1 About This Manual
     This manual describes the TBM2G frameless motors (standard version). In the case that TBM2G motors are
     operated in drive systems together with Kollmorgen® servo drives, please observe the entire system
     documentation, consisting of:

         l       Installation manual for the servo drives
         l       Fieldbus communication manual (e.g. CANopen or EtherCAT)

     More background information can be found on the Kollmorgen Developer Network, available at
     kdn.kollmorgen.com.

     1.1.2 Abbreviations Used

             l   Abbreviations used for technical data can be found under Definition of Terms.
             l   In this document, the symbolism (➜ # 25) means: see page 25.

     1.1.3 Symbols Used
                      Symbol                                                       Indication

                                             Indicates a hazardous situation which, if not avoided, will result in death or serious
                                             injury.
                         DANGER
                                             Indicates a hazardous situation which, if not avoided, could result in death or serious
                                             injury.
                        WARNING
                                             Indicates a hazardous situation which, if not avoided, could result in minor or
                                             moderate injury.
                        CAUTION
                                             Indicates situations which, if not avoided, could result in property damage.

                                             This symbol indicates important notes.

                                             Warning of a danger (general). The type of danger is specified by the text next to the
                                             symbol.

                                             Warning of danger from electricity and its effects.

                                             Warning of danger from hot surface.

                                             Warning of suspended loads.

13    KOLLMORGEN | kdn.kollmorgen.com | June 2023

                                                                                      TBM2G Instructions | 1 English

1.1.4 Safety
1.1.4.0.1 Safety notes

                 WARNING Pacemaker!
                 The strong magnetic fields which are produced as long as the magnetic rotor is not installed,
                 constitute a hazard for persons with implants, such as cardiac pacemakers, that can be
                 influenced by magnetic fields. As a general rule, all persons who may suffer impairment to
                 health through the influence of strong magnetic fields must keep at a safe distance of at least
                 1 meter from the rotor.

                 CAUTION Magnetic field!
                 The strong magnetic fields which are produced constitute a hazard for persons with implants
                 that can be influenced by magnetic fields. As a general rule, all persons who may suffer
                 impairment to health through the influence of strong magnetic fields must keep at a safe
                 distance of at least 1 meter from the motor.
                 Only properly qualified persons are permitted to perform activities such as transport,
                 installation, commissioning and maintenance. Properly qualified persons are those who are
                 familiar with the transport, assembly, installation, commissioning and operation of motors,
                 and who have the appropriate qualifications for their job. Qualified personnel must know and
                 observe the following standards and directives: IEC 60364, 60662 and national accident
                 prevention regulations.
                 The recommendations included in this document are intended to serve as general
                 installation guidelines and are for reference purpose.
                 Kollmorgen assumes no responsibility for incorrect implementation of these techniques,
                 which remain the sole responsibility of the user.

                 CAUTION Wear gloves!
                 Always wear gloves when working on the motor.
                 Read the available documentation before installation and commissioning. Incorrect handling
                 of the motor components can cause injury and damage to persons and equipment. Special
                 care must be taken when installing the rotor inside the stator of the motor. Tooling or fixtures
                 may be required.

                 CAUTION Magnetic field!
                 Strong magnetic fields attract metallic objects and create potential safety hazards for hands
                 and fingers. During work on or in the vicinity of TBM2G motors make sure that at least two
                 finely pointed wedges of tough non-magnetic material -e.g. V2A -(with a wedge angle of
                 approx. 10°-15°) and a non-metallic hammer (approx. 3 kg) are at hand. In an emergency
                 you can then use these tools to detach objects that are magnetically bound to the magnetic
                 rotor (for instance, to free trapped parts of the body).
                 Keep watches and magnetic data media (credit cards, diskettes, etc.) and digital displays
                 (mobile phones, laptops, etc.) out of the immediate vicinity (<500 mm) of the TBM2G motor.
                 Because of the high forces of attraction, special care must be taken within a range of about
                 50 mm from the magnetic rotor. Inside this area, heavy (>1 kg) or large-area (>1 dm²) objects
                 of steel or iron must not be held in the hand.
                 The rotor must never be stored in an unpacked condition. Use non-magnetic packaging
                 material that is at least 20 mm thick. The storage location must be dry and protected from
                 heat. Do not expose the motor rotor to heat in excess of 110°C, unless installed inside the
                 stator. Heat over 110°C can de-magnetize the rotor magnets.
                 Put up warning signs where the motors are stored: Caution : STRONG MAGNETS
                 Attach easily visible warning signs (e.g. permanent self-adhesive labels) to the machine.
                 Caution : The drives on this machine are fitted with strong magnets. STRONG MAGNETIC
                 FIELDS + HIGH ATTRACTION FORCES!

                                                                 KOLLMORGEN | kdn.kollmorgen.com | June 2023        14

TBM2G Instructions | 1 English

                       DANGER Earthing! High voltages!
                       It is mandatory to ensure that the metallic parts of the motor stator are properly grounded to
                       the PE (protective earth) busbar in the switchgear cabinet. Safety for personnel cannot be
                       assured without a low-resistance protective earth. See Grounding section of Mounting and
                       Installation Guidelines of this documentation for more detailed information.
                       Power connections may still be live, even though the motor is not moving. Never undo the
                       electrical connections to the motor while voltage is present. In unfavorable cases this can
                       cause arcing, with injury and damage to people and equipment.

15    KOLLMORGEN | kdn.kollmorgen.com | June 2023

                                                                                           TBM2G Instructions | 1 English

1.1.5 Important Notice
Specialist staff required!
Only properly qualified personnel are permitted to perform such tasks as transport, assembly, setup and
maintenance. Qualified specialist staff are persons who are familiar with the transport, installation, assembly,
commissioning and operation of motors and who bring their relevant minimum qualifications to bear on their
duties:

    l   Transport: only by personnel with knowledge of handling electrostatic sensitive components.
    l   Mechanical Installation: only by mechanically qualified personnel.
    l   Electrical Installation: only by electrically qualified personnel.
    l   Setup: only by qualified personnel with extensive knowledge of electrical engineering and drive
        technology.

The qualified personnel must know and observe IEC 60364 / IEC 60664 and national accident prevention
regulations.
Read the documentation!
Read the available documentation before installation and commissioning. Improper handling of the stator/rotor
can cause harm to people or damage to property. The operator must therefore ensure that all persons entrusted
to work on the frameless motor have read and understood the manual and that the safety notices in this manual
are observed.
Pay attention to the technical data!
Adhere to the technical data and the specifications on connection conditions (electrical ratings in Technical
Data). If permissible voltage values or current values are exceeded, the frameless motors can be damaged, for
example by overheating .
Perform a risk assessment!
The manufacturer of the machine must generate a risk assessment for the machine and take appropriate
measures to ensure that unforeseen movements cannot cause injury or damage to any person or property.
Additional requirements on specialist staff may also result from the risk assessment.

                    CAUTION Hot surface!
                    The surfaces of the TBM2G motors can be very hot in operation, according to their protection
                    category. Risk of minor burns! The surface temperature can exceed 155°C.

                         l   Measure the temperature and wait until the TBM2G motor has cooled down below
                             40°C before touching it.

                    DANGER Earthing! High voltages!
                    It is vital that you ensure that the TBM2G motor is safely earthed to the PE (protective earth)
                    busbar in the switch cabinet. Risk of electric shock. Without low-resistance earthing, no
                    personal protection can be guaranteed and there is a risk of death from electric shock.

                         l   Not having optical displays does not guarantee an absence of voltage. Power
                             connections may carry voltage even if the rotor is not rotating.
                         l   Do not unplug any connectors during operation. There is a risk of death or severe
                             injury from touching exposed contacts. Power connections may be live even when
                             the rotor is not rotating. This can cause flashovers with resulting injuries to persons
                             and damage to the contacts.

                         l   After disconnecting the servo drive from the supply voltage, wait several minutes
                             before touching any components which are normally live (e.g. contacts, screw
                             connections) or opening any connections.

                         l   The capacitors in the servo drive can still carry a dangerous voltage several minutes
                             after switching off the supply voltages. To ensure safety, measure the DC-link
                             voltage and wait until the voltage has fallen below 60 V.

                                                                      KOLLMORGEN | kdn.kollmorgen.com | June 2023      16

TBM2G Instructions | 1 English

     Use as Directed (“Intended Use”)

         l   The user is only permitted to operate the motors under the ambient conditions which are defined in this
             documentation.
         l   The series of motors is exclusively intended to be driven by servo drives.
         l   The motors are installed as components in electrical apparatus or machines and can only be
             commissioned and put into operation as integral components of such apparatus or machines.
         l   The End User assumes responsibility for machine conformity.

     1.1.6 Prohibited Use
     The use of the motors in the following environments is prohibited, without consulting Kollmorgen Customer
     Support:

         l   potentially explosive areas
         l   environments with corrosive and/or electrically conductive acids, alkaline solutions, oils, vapors, dusts
         l   vacuum
         l   directly on supply networks, mains

     Commissioning the motor is prohibited if the machine in which it was installed

         l   does not meet the requirements of the EC Machinery Directive
         l   does not comply with the EMC Directive
         l   does not comply with the Low Voltage Directive

17    KOLLMORGEN | kdn.kollmorgen.com | June 2023

                                              TBM2G Instructions | 1 English

1.1.7 Model Nomenclature

                           KOLLMORGEN | kdn.kollmorgen.com | June 2023   18

TBM2G Instructions | 1 English

     1.1.8 Torque Overview
                               0.72 Nm to 1.75 Nm
       050         0.27 Nm to 0.64 Nm
                                           1.17 Nm to 2.85 Nm
                                                                                  Peak Torque
       060            0.45 Nm to 0.96 Nm                                          Continuous Torque
                               1.53 Nm to 4.13 Nm
       068                  0.63 Nm to 1.54 Nm
                                           2.12 Nm to 5.57 Nm
       076                       0.89 Nm to 2.06 Nm
                                                        3.16 Nm to 7.01 Nm
       085                              1.21 Nm to 2.69 Nm
                                                                      3.75 Nm to 9.01 Nm
       094                                          1.58 Nm to 3.67 Nm
                                                                         3.18 Nm to 15.3 Nm
       115                                   1.90 Nm to 6.03 Nm
             0.0    1.0        2.0         3.0       4.0          5.0     6.0       7.0       8.0     9.0   15.0
                                                           Torque (Nm)

     1.1.9 Component Material Drawing
                                                                                    1. Yoke
                                                                                         l Material: 400 Series Stainless

                                                                                            Steel
                                                                                    2. Ring Magnet
                                                                                         l Material: NdFeB (Neodymium)

                                                                                         l Coating: Epoxy

                                                                                    3. Printed Circuit Board (PCB)
                                                                                    4. Coil
                                                                                         l Material: Copper

                                                                                         l Coating: Varnish

                                                                                    5. End Insulators
                                                                                       Material: Polymer Resin
                                                                                    6. Power Leads
                                                                                    7. Lamination Stack
                                                                                       Material: Electrical Steel
                                                                                    8. Optional Thermal Devices
                                                                                       (mounted underneath PCB)
                                                                                         l PT1000

                                                                                         l PTC Avalanche (3 in series)

                                                                                    9. Optional Hall Sensors
                                                                                       (mounted underneath PCB)
                                                                                         l Allegro A1260

19    KOLLMORGEN | kdn.kollmorgen.com | June 2023

                                                                                       TBM2G Instructions | 1 English

1.2 Storage, Operation and Transport Guidelines

1.2.1 Storage
Climate Category             1K4 according to IEC 60721-3-1, EN61800-2.
Storage Temperature          -25 to +55°C, max. variation 20°K per hour
Humidity                     relative humidity 5% - 95%, no condensation
Storage Time                 unlimited

Only store motors in the manufacturer’s original packaging.

1.2.2 Operation
Ambient Temperature (at -20 to +40°C for site altitude up to 1000 m amsl
rated values)
Permissible Humidity (at     95% relative humidity, no condensation
rated values)
Power Derating (currents No derating for site altitudes above 1000 m amsl with temperature reduction of
and torques)             10°K per 1000 m. It must be ensured, that winding temperature doesn’t exceed
                         155°C.

1.2.3 Transport
Climate Category             2K3 according to IEC 60721-3-2, EN61800-2
Storage Temperature          -25 to +70°C, max. variation 20°K/hour
Humidity                     relative humidity 5% - 95%, no condensation

Avoid shocks. If the packaging is damaged, check the motor parts for visible damage. Inform the carrier and, if
appropriate, the manufacturer.

1.2.4 Unpacking
The Stator and Rotor set is typically shipped together in a single or bulk package. Custom bulk packaging is
available as a special option. The Rotor and Stator are separated from each other by packing material so not to
impact each other due to the strong magnetic forces. Care in unpacking should be taken to keep the parts
separated and to keep the highly magnetized rotor from impacting other objects.
The Stator may contain hall sensor devices if requested. These devices are susceptible to static electricity
damage. ESD bags are used in shipping Stators with hall devices. During unpacking, care should be taken to
continue ESD protection.

                                                                  KOLLMORGEN | kdn.kollmorgen.com | June 2023     20

TBM2G Instructions | 1 English

     1.3 Mounting and Installation Guidelines

      The recommendations included in this Kollmorgen manual are intended to serve as general installation
      guidelines, and are for reference purposes only. Kollmorgen assumes no responsibility for incorrect
      implementation of these techniques, which remain the sole responsibility of the user.

     1.3.1 Armature and Field Assembly Definitions
     Armature Assembly (Stator)
     The Armature Assembly is the stationary portion of the frameless motor. This assembly is comprised of the
     magnetic steel laminations, coils, and lead wire assembly. It may also contain additional options such as Hall
     Devices or Thermal Sensors.
     Field Assembly (Rotor)
     The Field Assembly is the moving portion of the frameless motor. This assembly is comprised of a rare-earth ring
     magnet and yoke ring.
     Frameless Motor (Set)
     A motor manufactured and shipped as separate parts: stator and rotor. The individual parts must be assembled
     into an end user fabricated housing, shaft, and bearing system.

     1.3.2 User Interface Responsibilities
     To ensure proper performance and reliability of the motor when installed in the system, the user is responsible for
     designing the mounting interface using the following information as a guideline. The user is responsible for
     designing the rotor shaft, stator enclosure, bearing system, housing design details, material selection, fit
     calculations and tolerance analysis based on the needs of the intended application.

     1.3.2.1 Bearings
     The user-supplied bearing system in the motor application must exhibit sufficient stiffness to maintain a rigid,
     uniform clearance gap between the rotor and the stator under all operating conditions. Uniform clearance
     includes limits for runout and concentricity between the rotor and stator.

     1.3.2.2 Stator Mounting Materials
     A metallic housing or clamp structure is suggested to rigidly mount the stator to assure the best conductive
     heatsinking path and proper structural integrity. Aluminum alloys are preferred due to their superior thermal
     conductivity and strength-to-weight ratio, although stainless steel alloys (300 series or equivalent) are an
     acceptable alternative for applications that are less thermally critical. Carbon steel, cast iron, 400 series stainless
     alloys and other magnetic flux conducting ferrous metals are the least desirable choices for stator mounting.
     Consult a Kollmorgen engineer for assistance if such metals must be used. Plastics or other similar thermally
     isolating materials are not recommended, since they adversely affect the heatsinking capacity of the system,
     making it necessary to significantly derate the motor’s performance.

     1.3.2.3 Rotor Mounting Materials
     The magnetized rotor may be mounted to any metallic shaft of the user’s choice. Carbon steel and stainless steel
     are the most commonly used shaft materials, although aluminum alloys are occasionally used when properly
     designed for the intended torque and thermal operating range. The method used to attach the rotor to the shaft
     may influence the optimum material and tolerance choices for the shaft. The shaft does not need to carry flux or
     function as a portion of the magnetic circuit to achieve rated performance when using a Kollmorgen brushless
     motor.

21    KOLLMORGEN | kdn.kollmorgen.com | June 2023

                                                                                     TBM2G Instructions | 1 English

1.3.2.4 Grounding
     When mounted in the application, the laminated stack (or bare metal outer sleeve) of the stator should be
     at the same electrical ground potential as the system chassis and the servo drive chassis. If this common
     ground path is not ensured, the application may exhibit electrical noise, and also create an electrical
     shock hazard. The risk of shock is particularly prevalent when using high pole-count motors with large
     capacitance characteristics. Typically, if the stator is mounted using electrically conductive metallic
     components, then a robust ground path between stator lamination stack and machine chassis is
     inherently achieved. Kollmorgen recommends performing a continuity check to confirm proper ground
     path before enabling the motor system. In some applications, depending on the mounting configuration
     and materials chosen, a separate conductive ground strap may be required. In such cases, the user is
     responsible for installation of the ground path and electrical verification.

                                                                KOLLMORGEN | kdn.kollmorgen.com | June 2023      22

TBM2G Instructions | 1 English

     1.3.2.5 Basic Assembly Instructions
                           Kollmorgen’s TBM2G series and other frameless brushless motors utilize high-performance
                           rare earth magnets. Use extreme caution when handling or transporting to avoid injury and
                           product damage. The attractive forces between magnetized rotors and nearby metallic
                           objects can be extremely powerful. Improper handling can result in sudden unexpected
                           impacts. The strong magnetic field can also damage nearby computers, display screens and
                           memory storage devices. Keep the rotor in its shipping container or wrapped protectively
                           until ready to install. This practice will help avoid accidents and prevent contamination such
                           as metallic chips or debris that tend to cling to the magnets.

     Below is a generic assembly process that can be followed when inserting a Rotor (Field Assembly) into a Stator
     (Armature Assembly)

      1. Securely mount the customer-supplied housing on a stable surface to prevent any sudden movements.
      2. Slide the stator into the housing and secure it by either bonding or clamping the stator as shown in Stator
         Mounting Practices.
      3. Slide the rotor onto the customer-supplied shaft and secure it by either bonding or clamping the rotor as
         shown in Rotor Mounting Practices.

           Rare earth magnets are susceptible to cracking and chipping. Take care not to drop the magnets and to
           avoid impacts with other surfaces when mounting the rotor onto the shaft.

      4. Prior to inserting the Rotor/Shaft Assembly into the Stator/Housing Assembly, Kollmorgen recommends first
         installing a thin layer of shim material, such as Mylar® film, in the stator’s inner bore.
              l The Mylar film can be installed as a single piece that is wrapped entirely around the circumference of

                 the stator bore or multiple pieces may be inserted axially at equally spaced points. The optimum film
                 thickness and number of shim layers required is dependent upon the gap clearance between the rotor
                 and stator for the specific motor size the user is attempting to install. See the Radial Running
                 Clearance chart below for guidance.

                   The outer surface of the rotor may stick to the nearest point on the inner bore of the stator due to
                   magnetic attractive forces as the user attempts to install the rotor. The resulting friction as the Rotor
                   slides along the inside of the Stator can potentially damage the Rotor band, magnets, coatings, or
                   stator bore surfaces.

      5. Insert the rotor slowly and smoothly along the central axis line to position the rotor inside the stator. This can
         be done by hand or by using a custom installation fixture.
      6. Install bearings onto rotor assembly as needed to maintain shaft alignment prior to removing shims.
      7. Remove the shim material from the airgap between the rotor and stator prior to operation.

     Typical Radial Running Clearance
                               TBM2G Frame Size
                              050       060                    068            076           085           094           115
      Nominal        mm            0.26          0.29          0.26           0.26          0.26          0.26          0.40
      Mechanical
      Gap            in.           0.010         0.011         0.010          0.010         0.010         0.010         0.016
      Concentricity requirements noted on each model-specific Kollmorgen outline drawing must be considered by the user.
      Bearings with the lowest possible friction and high quality lubricant should be chosen to minimize overall system friction,
      which allows optimal motor operation.

23    KOLLMORGEN | kdn.kollmorgen.com | June 2023

                                                                                                 TBM2G Instructions | 1 English

1.3.3 Stator Mounting Practices
Kollmorgen suggests the following options for installation of the motor stator depending on torque, vibration, and
the thermal characteristics of the application, as well as cost, ease of assembly and serviceability desired by the
user.

1.3.3.1 Stator Bonding

Stator and housing surfaces should be cleaned thoroughly prior to bonding to ensure good adhesion. Reference
the data sheet of the adhesive being used for cleaning techniques based on housing material.

In most cases, motors in the general peak torque range up to 2,400 Nm may have the stator bonded in place
using a structural epoxy, such as 3M™ Scotch-Weld™ 2214 or other similar adhesives. Bonding is a preferred
permanent installation technique for all TBM2G stators. As shown in Illustrations of Stator Bonding below, to
successfully utilize adhesive bonding, the stator enclosure should be designed as a cylindrical cup, with a small
shoulder for axial positioning at one end and open at the opposite end. The shoulder serves as a stop point for
the stator to bank against when inserted from the open end and should generally clear the maximum outer
diameter of the winding end-turn as indicated on the outline drawing. Corner reliefs are required to accommodate
the sharp corners of the stator laminations. A small internal chamfer at the open end of the housing cup simplifies
stator insertion. If the assembly procedure is performed with the stator housing lying flat [rotation axis vertical],
the hydrostatic pressure of the structural adhesive will assist the stator in self-centering within the stator housing.
                                                                         1.   Customer Bearing
                                                                         2.   Customer Housing
                                                                         3.   Customer Feedback
                                                                         4.   TBM2G Stator

                      深度停止SHOULDER                                            0.025 MM [0.010 IN.] MIN.
                           FEATURE                                            CLEARANCE FROM ALL
                                                        ADHESIVE              SOLDER JOINTS
                      INSULATOR CAN TOUCH              RESERVOIR
                       HOUSING ON THIS END              GROOVES                 0.13 - 0.26 MM [0.006 - 0.010 IN.]
                                                                                ADDITIONAL ADHESIVE GROOVE
                                                                                50+% OF SURFACE

                                                                                    0.025/0.050 MM
                                                                                    NOMINAL (RADIAL) GAP
                                                                                    PER SIDE

                                                                          RECOMMENDED STRUCTURAL EPOXY:
                                                                          3M SCOTCHWELD 2214
                                                                          HYSOL EA934NA

         Figure 4-1: Illustrations of Stator Bonding

Temperature extremes can create a potential issue due to dissimilar expansion coefficients [e.g. steel
laminations vs. aluminum housing]. The user should consult the adhesive manufacturer for proper bond line
thickness, application process and curing instructions. The grooves shown in the inner diameter of the housing in

                                                                      KOLLMORGEN | kdn.kollmorgen.com | June 2023           24

TBM2G Instructions | 1 English

     the Illustrations of Stator Bonding are intended to serve as adhesive reservoirs for the thick structural epoxy
     helping to provide significant torsional strength across a broad temperature range. If using a thick structural
     epoxy, the inner diameter of the housing cup should be approximately 0.05 mm - 0.1 mm larger than the
     maximum outer diameter of the stator. When used in the manufacturer’s recommended manner, these bonding
     agents provide excellent life and strength characteristics over time.
     If a retaining compound, such as LOCTITE® 640™ or other similar adhesive, is preferred instead of a structural
     epoxy, a tighter clearance between housing inner diameter and stator outer diameter must be controlled to
     maintain appropriate bond line thickness. Refer to the adhesive manufacturer’s guidelines for recommendations.

      User assumes responsibility for selecting proper adhesive and for designing housing dimensions per expected
      thermal growth rate at intended temperature extremes of application. Adhesive cure temperatures should not
      exceed 155°C to avoid damaging the motor stator.

25    KOLLMORGEN | kdn.kollmorgen.com | June 2023

                                                                                          TBM2G Instructions | 1 English

1.3.3.2 Stator Clamping
For applications where the stator may need to be repeatedly installed and removed from the system, axial
clamping may be an acceptable option. Kollmorgen does not generally recommend this technique for high shock
and vibration applications or extreme temperature applications without special design consideration. The stator
enclosure shown in the illustration below is very similar to the epoxy bonding technique. When using the
clamping technique for mounting the stator, the inner diameter of the housing cup should be approximately 0.025
mm – 0.050 mm larger than the maximum outer diameter of the stator. If desired, the small radial space between
the stator outer diameter and the housing inner diameter may be filled with a thermal compound for more efficient
conduction to the heatsink.

Use caution to avoid contaminating the axial clamping surfaces with greases that may lead to reduced clamping
friction.

A machined shoulder feature serving as a stop and location point for the stator to bank against when inserted is
required. A separate clamp ring is needed at the opposite end of the stator and bolted to the housing with 4 to 12
equally spaced fasteners. Using the dimensions provided on the Outline drawing, maximize the surface area for
clamping. This minimizes the clamping stress on the stator. Design the housing bore depth to ensure that the
clamping ring contacts the stator core before contacting the housing at all tolerance and temperature conditions.
Clamping on housing surface before the stator will result in insufficient clamping forces. See the Outline drawing
for stator tolerances. Clamping pressures are dependent upon the surface area and clamping force. The
clamping pressure should be in the range of 5 to 20 Mpa (725 psi to 2900 psi). Care should be taken to avoid
excessive clamping pressures. Extreme pressures will result in increased core losses when operating at high
rotational speeds. Care should also be taken to ensure sufficient preload on clamping bolts. This along with a
removable thread locker will help keep clamping bolts from loosening after extended operation.
                                                                                  1. Customer Housing
                                                                                  2. TBM2G Stator
                                                                                  3. Stator Clamp Ring

                                                                       CLAMP RING NEEDS TO HAVE A GAP
                                                                       BEHIND TO ALLOW COMPRESSION OF
                                DEPTH STOP
                                                                       STATOR SHOULDER
                          SHOULDER FEATURE

                       INSULATOR CAN TOUCH                                  0.012/0.025 MM NOMINAL
                        HOUSING ON THIS END                                 (RADIAL) GAP PER SIDE

                                                                           CLAMP RING WITH BOLTS
                                                                           MUST ENGAGE AT LEAST
                                                                           HALF OF STATOR SHOULDER

         Figure 4-2: Illustrations of Stator Clamping

                                                                   KOLLMORGEN | kdn.kollmorgen.com | June 2023       26

TBM2G Instructions | 1 English

     1.3.4 Rotor Mounting Practices
                       Kollmorgen’s TBM2G series and other frameless brushless motors utilize high-performance
                       rare earth magnets. Use extreme caution when handling or transporting to avoid injury and
                       product damage. The attractive forces between magnetized rotors and nearby metallic
                       objects can be extremely powerful. Improper handling can result in sudden unexpected
                       impacts. The strong magnetic field can also damage nearby computers, display screens and
                       memory storage devices. Keep the rotor in its shipping container or wrapped protectively
                       until ready to install. This practice will help avoid accidents and prevent contamination such
                       as metallic chips or debris that tend to cling to the magnets.

     1.3.4.1 Control of Radial Runout
                       Kollmorgen’s model-specific outline drawings note a mounting requirement for runout of the
                       rotor ID to the stator OD. This callout is intended to represent the users shaft OD to housing
                       ID runout requirements. The user is responsible for designing the shaft, housing, and
                       bearing system to meet the specified runout limit between the shaft’s bonding surface OD
                       and the housing’s bonding surface ID. If this is followed the overall concentricity of the rotor
                       OD to stator ID should be acceptable.

27    KOLLMORGEN | kdn.kollmorgen.com | June 2023

                                                                                         TBM2G Instructions | 1 English

1.3.4.2 Rotor Bonding

Stator and housing surfaces should be cleaned thoroughly prior to bonding to ensure good adhesion. Reference
the data sheet of the adhesive being used for cleaning techniques based on the housing material.

Generally, for applications where peak torque does not exceed 750 Nm, rotors can be bonded to carbon steel or
stainless-steel shafts. Retaining compounds, such as LOCTITE® 640™ or other similar adhesives, usually
require smooth continuous interface diameters and tight fit tolerances, such as nominal gaps of 0.012 mm - 0.025
mm. Structural epoxies generally require slightly larger fit clearance to allow a thicker bond line. Epoxies often
benefit from grooves in the shaft/rotor interface that function as adhesive reservoirs and may be enhanced by
textured machined surfaces via knurling or grit blasting. Consult the adhesive manufacturer for proper bond line
thickness, fit tolerances, process details and curing guidelines.
To avoid partial demagnetization of the rotor, do not cure rotor/shaft bond joints at temperatures above 110°C
unless the rotor is nested inside the matching stator or the rotor is completely surrounded by a ferrous metal
"keeper" fixture. Contact a Kollmorgen engineer if more information is required on this topic. Before bonding
rotors to aluminum shafts, consult with the adhesive manufacturer for assistance. A highly flexible adhesive with
broad thermal properties may be required.
                                                                        1. Customer Shaft
                                                                        2. TBM2G Field Assembly Rotor

                                                                    FIELD ASSEMBLY

                                                                         0.012/0.025 MM NOMINAL
                                                                         (RADIAL) GAP PER SIDE

                                FIT DEPTH TO
                                SHOULDER
                                                                        CUSTOMER SHAFT

         Figure 4-3: Illustrations of Rotor Bonding

                                                                   KOLLMORGEN | kdn.kollmorgen.com | June 2023       28

TBM2G Instructions | 1 English

     1.3.5 Axial Mounting Practices

     1.3.5.1 Axial Alignment Control
     Kollmorgen’s model-specific outline drawings note axial alignment that must be maintained between rotor and
     stator when mounted to ensure proper motor performance. The user is responsible for designing the rotor shaft,
     stator enclosure and bearing system to achieve the specified mounting alignment. Machined shoulders on the
     shaft or grooves for removable retaining rings are common ways of controlling rotor installation position.
     Maximum diameter of retaining rings or shaft shoulders should be kept below the rotor diameter where magnets
     are bonded to the steel hub.

     1.3.6 Axial Mounting
     To assure full performance and proper triggering of the Hall devices, Kollmorgen specifies a mounting dimension
     between the edge of the lamination stack and the edge of the yoke ring ["Illustration of mounting dimension
     displayed on a TBM2G-068XXX-XXXX-00 Outline. This dimension is measured from the left edge of the
     lamination stack to the left edge of the yoke material (not magnet)." (➜ p. 29)].
     This mounting dimension ensures magnet material will be fully covering the lamination stack and extends axially
     to trigger the Hall devices, if applicable.
                                            "A"
                                           MAX.
                                                      ARMATURE ASSEMBLY
                                           "B"
                                                          3.00 [0.118] MAX.
                 4.70 [0.185] MAX                         OVER SOLDER AND HEAT STAKE
                                                          SEE NOTE 3
                                                                            A

                                                                                                     YOKE RING

            FIELD ASSEMBLY
                                                          2X 30°

     Ø 91.13 [3.588]
         MAX.
                                                         2X 0.50
                                                         [0.020]
                                                         CHAMFER
                                 "C"
                                                                         Ø93.96 - 94.04
                 Ø46.98 - 47.02                                           [3.700 - 3.702]
                  [1.850 - 1.851]
                    0.07 [0.003] A
                  MOUNTING
                 REQUIREMENT
                                                               Ø92.33
                                                               [3.635]
                                                                MAX

                                                                                              0.70±0.40 [0.028±0.015]
                                                                                              MTG DIM
              0.70±0.40 [0.028±0.015]
                           MTG DIM                    SHARP CORNER BOTH SIDES.
                                                      UNDERCUT REQUIRED ON
                                                      MATING COMPONENTS
                                        SECTION A-A

                   Figure 4-4: Illustration of mounting dimension displayed on a TBM2G-068XXX-XXXX-00 Outline. This dimension
                   is measured from the left edge of the lamination stack to the left edge of the yoke material (not magnet).

     If you wish to establish the Alternate Mounting Dimension from the other side of the lamination stack, then the
     nominal value can be calculated using a few parameters from the drawing. In order to calculate the nominal value
     from the right edge of the lamination stack to the right edge of the yoke material, use the equation below:
                       Alternate Mounting Dimension (mm, nominal) = “C” – “B” – 0.70 mm

29    KOLLMORGEN | kdn.kollmorgen.com | June 2023

                                                                                          TBM2G Instructions | 1 English

To provide an example of calculating the Alternate Mounting Dimension we will use:

    l   The dimensions for TBM2G-06813-00 from the TBM2G-068XXX-XXXX-00 Outline in "Illustration of
        mounting dimension displayed on a TBM2G-068XXX-XXXX-00 Outline. This dimension is measured from
        the left edge of the lamination stack to the left edge of the yoke material (not magnet)." (➜ p. 29).
    l   The equation for Alternate Mounting Dimension.
    l   A table from the TBM2G-068 Outline that gives the values for “B” and “C”, shown in "Table for values “A”
        MAX, “B” and “C” taken from the TBM2G-068XXX-XXXX-00 Outline." (➜ p. 30).

        Stack Specific Dimensional Data
         Part Number           "A" Max      "B" REF ±0.35 [0.014] “C” ±0.08 [0.004]
         TBM2G-06808-00 18.34 [0.722]              8.2 [0.323]           14.76 [0.581]

         TBM2G-06813-00 22.84 [0.899]             12.70 [0.500]          19.26 [0.758]

         TBM2G-06826-00 36.44 [1.435]             26.30 [1.035]          32.86 [1.294]

                 Figure 4-5: Table for values “A” MAX, “B” and “C” taken from the TBM2G-068XXX-XXXX-00 Outline.

Example:
For TBM2G-06813-00, “B” = 12.7 mm nominal and “C” = 19.26 mm nominal. The original mounting dimension,
0.70 mm nominal, is already given in the Outline. Using our equation, we now calculate the following:
           Alternate Mounting Dimension (mm) = 19.26 mm – 12.7 mm – 0.70 mm = 5.86 mm
           nominal

                                                                    KOLLMORGEN | kdn.kollmorgen.com | June 2023      30

TBM2G Instructions | 1 English

     1.3.7 Electrical Wiring Interface

     1.3.7.1 Wiring
     TBM2G series motors can be supplied with UL-compliant un-terminated flying lead wires. The user is responsible
     for proper lead wire routing and connection per the diagrams shown on Kollmorgen drawings. Avoid routing wires
     across sharp corners, pinch points or edges that may pierce the insulation. Clamp or otherwise secure wire
     bundles in high vibration applications and avoid wire contact with moving or vibrating surfaces that may abrade
     the insulation. Provide strain relief for all wire bundles and allow room for a generous bend radius. User assumes
     responsibility for connector installation, crimping, soldering, shielding, sleeving or any other wire bundling or
     electrical interface enhancement beyond the configuration shown on the TBM2G outline drawing.

     1.3.7.2 Lead Wire Requirements (no lead option)
     Recommendations/Guidelines to soldering lead wire onto pad.

     1.3.7.3 Power Leads General Specifications and Wiring
     POWER LEAD GENERAL SPECIFICATIONS
      Motor                       TBM2G-      TBM2G-       TBMG-      TBM2G-          TBM2G-   TBM2G-       TBM2G-
                                    050         060         068         076             085      094          115
      Type                                                           3 flying leads
      Length, mm*                                                         500
      Wire Gauge, AWG                20            20        20          18             16        14           14
      Nominal Insulation            1.47        1.47        1.47        1.70           1.98      2.26         2.26
      Diameter, mm
      Min. Static Bend Radius,      7.37        7.37        7.37        8.51           9.91      11.3         11.3
      mm

     *Optional No Lead Version (solder pad only)

     POWER LEAD ELECTRICAL INTERFACE
      Color                Function (alt)
      Red                  Phase U (A)
      White                Phase V (B)
      Black                Phase W (C)

31    KOLLMORGEN | kdn.kollmorgen.com | June 2023

                                                                             TBM2G Instructions | 1 English

            POWER LEADS EXCITATION CHART
STEP      Phase "U" Red Phase "V" White     Phase "W" Black
1               ⊕                 ⊖
2               ⊕                                 ⊖
3                                ⊕                ⊖
4               ⊖                ⊕
5               ⊖                                 ⊕
6                                 ⊖               ⊕
CW rotation viewed from PCB/Lead Exit End

                                                          KOLLMORGEN | kdn.kollmorgen.com | June 2023   32

TBM2G Instructions | 1 English

     1.3.7.4 Thermal Device General Specifications and Wiring
     To provide for continuous safe operation of TBM2G series motors in demanding applications, integral thermistors
     may be attached to the PCBA. The typical option for TBM2G is a PT1000 RTD. As an alternative, three PTC
     devices wired in series with one placed in each phase winding provides protection of each phase.

     THERMAL LEAD GENERAL SPECIFICATIONS
      Motor                      TBM2G-      TBM2G-       TBM2G-       TBM2G-        TBM2G-     TBM2G-       TBM2G-
                                   050         060          068          076           085        094          115
      Type                                                          2 flying leads
      Length, mm*                                                        500
      Wire Gauge, AWG               26           26          26           26           26          26           26
      Nominal Insulation           0.99         0.99        0.99         0.99         0.99        0.99         0.99
      Diameter, mm
      Min. Static Bend             4.95         4.95        4.95         4.95         4.95        4.95         4.95
      Radius, mm

     *Optional No Lead Version (solder pad only)

     THERMAL LEAD ELECTRICAL INTERFACE
      Color              Function (alt.)
      White              Thermal Sensor +
      White              Thermal Sensor -

     1.3.7.4.1 Thermal Protection
     There are two methods for thermal protection for continuous operation. The first method allows for continuous
     measurement of the motor's temperature by using a PT1000. The motor's temperature is determined by
     measuring the resistance of the of the PT1000 per IEC-60751 (see chart below). Since only one device can be
     used, this method can only monitor one of the motor phases. Therefore, it is not recommended for applications
     where the motor will be in a stall condition for an extended period.
     The second method uses three avalanche PTC in series. There is one PTC to monitor each of the three phases
     to make sure none of the phases exceeds the rated temperature of the motor. This option should be chosen if the
     motor is in a stall condition for an extended period of time. During normal operation the resistance of the devices
     will be under 1,500 ohms. When one phase reaches the 155°C the resistance increases rapidly and will exceed >
     7,000 ohms.
     Neither of these methods protect the motor from overheating when current above the continuous rating is
     applied. The thermal devices cannot react fast enough to account for the rate of change in temperature that
     happens when applying peak current. The drive needs to limit the time the peak current in applied to the motor to
     prevent it from overheating.

33    KOLLMORGEN | kdn.kollmorgen.com | June 2023

                                                                                                                      TBM2G Instructions | 1 English

                                           PT1000 Resistance vs. Temperature
                     1800

                     1600
                     1400
Resistance in Ohms

                     1200
                     1000

                      800

                      600

                      400
                      200

                        0
                            0    20   40      60         80   100 120 140        160   180   200
                                                        Temperature in ˚C

                                15

This option only has the PT1000 in series and will give the same output as shown on the graph above.

                                      PTC-3 in Series Resistance vs. Temperature
100,000

       50,000
Resistance in Ohms

                     10K

                      5K

                     1000
                            0    20    40          60      80    100      120   140    160   180
                                                        Temperature in ˚C

                                15$                        15$                   15$

This option has three PTC in series in three different phases. If one of the phases approaches the temperature
rating of the motor, the resistance will greatly increase.

                                                                                                   KOLLMORGEN | kdn.kollmorgen.com | June 2023   34

TBM2G Instructions | 1 English

     1.3.7.5 Hall Sensor Device General Specifications and Wiring
     HALL SENSOR GENERAL SPECIFICATIONS
      Motor                                     TBM2G-           TBM2G-           TBMG-       TBM2G-         TBM2G-   TBM2G-   TBM2G-
                                                  050              060             068          076            085      094      115
      Type                                                                            5 flying leads, Allegro A1260
      Input Voltage, VDC                                                                        +5 to 24
      Output Signal                                                                           Sinking Type
      Length, mm*                                                                                 500
      Wire Gauge, AWG                                26               26              26          26           26       26       26
      Nominal Insulation                         0.99                 0.99          0.99         0.99         0.99     0.99     0.99
      Diameter, mm
      Min. Static Bend Radius,                   4.95                 4.95          4.95         4.95         4.95     4.95     4.95
      mm

     *Optional No Lead Version (solder pad only)

     HALL SENSOR LEAD ELECTRICAL INTERFACE
      Color                             Function (alt)
      Brown                             Hall 1 (U-V)
      Orange                            Hall 2 (V-W)
      Yellow                            Hall 3 (W-U)
      Blue                              +5 to 24 VDC
      Green                             Ground

     Sensor Wiring Diagram
                      R = 1.5 kΩ (Customer Supplied)
                                                                             BLUE
                      R                    R                     R      (+5 TO 24 V DC)

      H                    H                     H
          1                    2                     3
                BROWN                ORANGE                 YELLOW
                OUTPUT                OUTPUT                OUTPUT
              PHASE - UV           PHASE - VW            PHASE - WU
                                                                             GREEN
                                                                           (GROUND)

35    KOLLMORGEN | kdn.kollmorgen.com | June 2023

                                                                                                           TBM2G Instructions | 1 English

Sensor Output Diagram
U, V, W phased for CW rotation viewed at PCB/Lead Exit End

     VOLTS
                    1          2          3          4          5          6

               Bemf U-V

     5
H1                                                                               IN PHASE WITH Bemf U-V
     0                               Bemf V-W

     5
H2                                                                               IN PHASE WITH Bemf V-W
     0                                                     Bemf W-U

     5
H3                                                                               IN PHASE WITH Bemf W-U
     0
              60˚                  180˚                  300˚                  420˚
         0˚             120˚                  240˚                  360˚
              ELECTRICAL DEGREES (RELATIVE)

                                                                                        KOLLMORGEN | kdn.kollmorgen.com | June 2023   36

TBM2G Instructions | 1 English

     1.4 Definition of Terms for Technical Data
      Maximum                    The Maximum Continuous Stall Torque can be maintained indefinitely at low speed
      Continuous Stall           and rated ambient conditions. There may be additional derating if speed is not high
      Torque, Tmc [Nm]           enough to produce even heat distribution across phases. This value assumes an
                                 ambient temperature of 25°C.

      Maximum                    The Maximum Continuous Current is the effective sinusoidal current which the motor
      Continuous Current,        draws at low speed to produce the Maximum Continuous Stall Torque.
      Imc [Arms]

      Maximum Mechanical         The Maximum Mechanical Speed is the highest speed achievable by the motor.
      Speed, Nmax [rpm]          Limited by mechanical factors such as adhesion strength of magnet bond.

      Peak Torque, Tp [Nm] The Peak Torque can be maintained for brief durations of time, dependent on
                           ambient conditions and overall duty cycle. This value may also be limited based on
                           drive specifications and supply voltage.

      Peak Current, Ip           The Peak Current of the motor (effective sinusoidal value) is three times the
      [Arms]                     Continuous Current. The actual value is the lessor of the peak current of the motor or
                                 the peak current of the drive used.

      Rated torque, Trtd         The rated torque is produced when the motor is drawing the rated current at the
      [Nm]                       rated speed. The rated torque can be produced indefinitely at the rated speed in
                                 continuous operation (Nrtd ). This value assumes an ambient temperature of 25°C.

      Torque Constant, Kt        The Torque Constant defines how much torque is produced by the motor per unit of
      [Nm/Arms]                  Current. Measured at both 25°C ambient and 155°C winding temperature.

      Back EMF Constant,         The BEMF Constant defines the induced motor back EMF, as an effective sinusoidal
      Ke [Vrms/krpm]             value between two terminals, per 1000 rpm. Measured at both 25°C ambient and
                                 155°C winding temperature.

      Motor Constant, Km         This constant is typically used to compare motors power density at or near stall. It
      [Nm/√W]                    defines the amount torque the motor can produce with a given amount of power. This
                                 value is given with the Kt and resistance at 25°C winding temperature.

      Resistance, Rm [Ω]         The Resistance is measured line-to-line and at the PC board. The value does not
                                 include the resistance of the motor leads. The resistance value is at 25°C and will
                                 increase with winding temperature.

      Inductance, L [mH]         The Inductance is measured line-to-line and at the PC board. This is the average
                                 inductance for the motor with respect to the rotor position. The value is measured at
                                 25°C winding temperature.

      Rotor Moment of            The Rotor Moment of Inertia factors into angular acceleration capability of your
      Inertia, Jm [kg-cm²]       motor. This value pertains only to the standard Field Assembly components (Yoke
                                 Ring and Ring Magnet). Customer supplied components will alter the total Inertia.

      Static Friction, Tf        Static Friction is the torque that must be overcome to get the motor rotating. It is the
      [Nm]                       combination of the low speed hysteresis losses and the peak of the cogging torque.
                                 It does not include any bearing losses in the system. This friction should not be
                                 included when calculating the rotational losses of the motor at speed.

      Thermal Resistance,        The Thermal Resistance is a measurement of steady state temperature rise per unit
      Rthw-a [deg. C/watt]       of energy dissipated from losses. This value assumes the TBM2G motor is housed
                                 and mounted to an Aluminum heat sink as defined on corresponding CD sheet or its
                                 equivalent.

37    KOLLMORGEN | kdn.kollmorgen.com | June 2023

                                                                                         TBM2G Instructions | 2 Deutsch

2 Deutsch

2.1 Allgemeines

2.1.1 Über dieses Handbuch
Dieses Handbuch beschreibt die gehäuselosen Motoren TBM2G (Standardversion). Für den Fall, dass die
Motoren TBM2G in Antriebssystemen zusammen mit Kollmorgen®-Servoantrieben betrieben werden, beachten
Sie bitte die gesamte Systemdokumentation, bestehend aus:

    l       Installationshandbuch für die Servoantriebe
    l       Feldbus-Kommunikationshandbuch (z. B. CANopen oder EtherCAT)

Weitere Hintergrundinformationen finden Sie im Developer Network Kollmorgen unter kdn.kollmorgen.com.

2.1.2 Verwendete Abkürzungen

        l   Die Abkürzungen für die technischen Daten finden Sie unter „Begriffsdefinitionen“.
        l   In diesem Dokument bedeutet die Symbolik (➜ # 25): siehe Seite 25.

                                                                      KOLLMORGEN | kdn.kollmorgen.com | June 2023   38

TBM2G Instructions | 2 Deutsch

     2.1.3 Verwendete Symbole
                Symbol              Bedeutung

                                   Weist auf eine gefährliche Situation hin, die, wenn sie nicht vermieden wird,
                                   zum Tode oder zu schweren, irreversiblen Verletzungen führen wird.
                   GEFAHR
                                   Weist auf eine gefährliche Situation hin, die, wenn sie nicht vermieden wird,
                                   zum Tode oder zu schweren, irreversiblen Verletzungen führen kann.
                 WARNUNG
                                   Weist auf eine gefährliche Situation hin, die, wenn sie nicht vermieden wird, zu
                                   leichten Verletzungen führen kann.
                 VORSICHT
                                   Dieses Symbol weist auf eine Situation hin, die, wenn sie nicht vermieden wird,
                                   zu Sachschäden führen kann.

                                   Dieses Symbol weist auf wichtige Informationen hin.

                                   Warnung vor einer Gefahr (allgemein). Die Art der Gefahr wird durch den
                                   nebenstehenden Warntext spezifiziert.

                                   Warnung vor gefährlicher elektrischer Spannung und deren Wirkung.

                                   Warnung vor Gefahr durch heiße Oberflächen.

                                   Warnung vor hängender Last.

39    KOLLMORGEN | kdn.kollmorgen.com | June 2023

                                                                                   TBM2G Instructions | 2 Deutsch

2.1.4 Sicherheit
2.1.4.0.1 Sicherheitshinweise

                 WARNUNG Herzschrittmacher!
                 Die starken Magnetfelder, die erzeugt werden, solange der Magnetrotor nicht installiert ist,
                 stellen eine Gefahr für Personen mit Implantaten, wie z. B. Herzschrittmachern, dar, die
                 durch Magnetfelder beeinflusst werden können. Generell gilt, dass alle Personen, die durch
                 den Einfluss starker Magnetfelder gesundheitliche Beeinträchtigungen erleiden können,
                 einen Sicherheitsabstand von mindestens 1 Meter zum Rotor einhalten müssen.

                 VORSICHT Magnetfeld!
                 Die starken Magnetfelder, die erzeugt werden, stellen eine Gefahr für Personen mit
                 Implantaten dar, die durch Magnetfelder beeinflusst werden können. Generell gilt, dass alle
                 Personen, die durch den Einfluss starker Magnetfelder gesundheitliche Beeinträchtigungen
                 erleiden können, einen Sicherheitsabstand von mindestens 1 Meter zum Motor einhalten
                 müssen.
                 Für Arbeiten wie den Transport und die Installation, Inbetriebnahme und Wartung des Geräts
                 dürfen nur entsprechend qualifizierte Personen eingesetzt werden. Qualifiziertes Personal
                 sind Personen, die mit dem Transport, Zusammenbau, der Installation, Inbetriebnahme und
                 dem Betrieb des Motors vertraut sind und die über eine entsprechende berufliche
                 Qualifikation verfügen. Qualifiziertes Personal muss die folgenden Normen und Richtlinien
                 kennen und beachten: IEC 60364, 60662 und nationale Unfallverhütungsvorschriften.
                 Die in diesem Dokument enthaltenen Empfehlungen sind als allgemeine
                 Installationshinweise gedacht und dienen zu Referenzzwecken.
                 Kollmorgen übernimmt keine Verantwortung für die fehlerhafte Anwendung dieser
                 Techniken, die in der alleinigen Verantwortung des Benutzers liegen.

                 VORSICHT Handschuhe tragen!
                 Tragen Sie bei Arbeiten am Motor immer Handschuhe.
                 Lesen Sie vor der Montage und Inbetriebnahme die vorliegende Dokumentation. Ein
                 unsachgemäßer Umgang mit den Motorkomponenten kann zu Verletzungen und Schäden
                 an Personen und Geräten führen. Besondere Vorsicht ist geboten, wenn Sie den Rotor in
                 den Stator des Motors einbauen. Möglicherweise sind Werkzeuge oder Vorrichtungen
                 erforderlich.

                                                               KOLLMORGEN | kdn.kollmorgen.com | June 2023      40

TBM2G Instructions | 2 Deutsch

                       VORSICHT Magnetfeld!
                       Starke Magnetfelder ziehen metallische Gegenstände an und stellen ein potenzielles
                       Sicherheitsrisiko für Hände und Finger dar. Achten Sie bei Arbeiten an oder in der Nähe von
                       Motoren TBM2G darauf, dass mindestens zwei fein zugespitzte Keile aus zähem,
                       nichtmagnetischem Material – z. B. V2A – (mit einem Keilwinkel von ca. 10°–15°) und ein
                       nichtmetallischer Hammer (ca. 3 kg) zur Hand sind. Im Notfall können Sie diese Werkzeuge
                       dann verwenden, um Objekte zu lösen, die magnetisch an den Magnetrotor gebunden sind
                       (zum Beispiel, um eingeklemmte Körperteile zu befreien).
                       Halten Sie Uhren und magnetische Datenträger (Kreditkarten, Disketten usw.) sowie digitale
                       Displays (Mobiltelefone, Laptops usw.) aus der unmittelbaren Nähe (<500 mm) des Motors
                       TBM2G fern. Wegen der hohen Anziehungskräfte müssen Sie in einem Bereich von etwa
                       50 mm um den Magnetrotor besonders vorsichtig sein. Innerhalb dieses Bereichs dürfen
                       schwere (>1 kg) oder großflächige (>1 dm²) Gegenstände aus Stahl oder Eisen nicht in der
                       Hand gehalten werden.
                       Der Rotor darf niemals in unverpacktem Zustand gelagert werden. Verwenden Sie
                       nichtmagnetisches Verpackungsmaterial mit einer Stärke von mindestens 20 mm. Der
                       Lagerort muss trocken und vor Hitze geschützt sein. Setzen Sie den Motorrotor nicht einer
                       Hitze von mehr als 110 °C aus, es sei denn, er ist im Inneren des Stators installiert.
                       Temperaturen über 110 °C können die Rotormagnete entmagnetisieren.
                       Stellen Sie Warnschilder auf, wo die Motoren gelagert werden: Vorsicht: STARKE
                       MAGNETE
                       Bringen Sie gut sichtbare Warnschilder (z. B. permanente selbstklebende Etiketten) an der
                       Maschine an. Vorsicht: Die Antriebe dieser Maschine sind mit starken Magneten
                       ausgestattet. STARKE MAGNETFELDER + HOHE ANZIEHUNGSKRÄFTE!

                       GEFAHR Erdung! Hohe Spannungen!
                       Es muss unbedingt sichergestellt werden, dass die metallischen Teile des Motorstators
                       ordnungsgemäß mit der PE-Sammelschiene (Schutzerde) im Schaltschrank verbunden und
                       somit geerdet sind. Die Sicherheit des Personals kann ohne eine niederohmige Schutzerde
                       nicht gewährleistet werden. Ausführlichere Informationen finden Sie im Abschnitt „Erdung“ in
                       den Montage- und Installationshinweisen in dieser Dokumentation.
                       Leistungsanschlüsse können auch bei bewegungslosem Motor unter Spannung stehen.
                       Lösen Sie niemals die elektrischen Verbindungen zum Motor, während Spannung anliegt. In
                       ungünstigen Fällen kann es zu Lichtbögen kommen, die zu Verletzungen und Schäden an
                       Personen und Geräten führen können.

41    KOLLMORGEN | kdn.kollmorgen.com | June 2023

                                                                                      TBM2G Instructions | 2 Deutsch

2.1.5 Wichtiger Hinweis
Fachpersonal erforderlich
Für Arbeiten wie Transport, Installation, Inbetriebnahme und Instandhaltung darf nur qualifiziertes Personal
eingesetzt werden. Qualifiziertes Fachpersonal sind Personen, die mit dem Transport, der Installation, der
Montage, der Inbetriebnahme und dem Betrieb von Motoren vertraut sind und ihre jeweiligen
Mindestqualifikationen einbringen:

    l   Transport: nur durch Personal mit Kenntnissen in der Behandlung elektrostatisch empfindlicher Bauteile.
    l   Mechanische Installation: nur durch Fachleute mit maschinenbautechnischer Ausbildung.
    l   Elektrische Installation: nur durch Fachleute mit elektrotechnischer Ausbildung.
    l   Inbetriebnahme: nur durch Fachleute mit weitreichenden Kenntnissen in den Bereichen
        Elektrotechnik/Antriebstechnik.

Das Fachpersonal muss ebenfalls IEC 60364/IEC 60664 und nationale Unfallverhütungsvorschriften kennen
und beachten.
Dokumentation lesen
Lesen Sie vor der Montage und Inbetriebnahme die vorliegende Dokumentation. Unsachgemäße Handhabung
des Stators/Rotors kann zu Personen- oder Sachschäden führen. Der Betreiber muss daher sicherstellen, dass
alle mit Arbeiten am gehäuselosen Motor betrauten Personen das Handbuch gelesen und verstanden haben und
dass die Sicherheitshinweise in diesem Handbuch beachtet werden.
Technische Daten beachten
Halten Sie die technischen Daten und die Angaben zu den Anschlussbedingungen ein (elektrische Nennwerte in
Technical Data). Werden zulässige Spannungs- oder Stromwerte überschritten, können die gehäuselosen
Motoren z. B. durch Überhitzung beschädigt werden.
Erstellen Sie eine Risikobeurteilung.
Der Hersteller der Maschine muss eine Risikobeurteilung für die Maschine erstellen und geeignete Maßnahmen
treffen, dass unvorhergesehene Bewegungen nicht zu Verletzungen oder Sachschäden führen können. Aus der
Risikobeurteilung leiten sich eventuell weitere Anforderungen an das Fachpersonal ab.

                    VORSICHT Heiße Oberfläche!
                    Die Oberflächen der Motoren TBM2G können im Betrieb je nach Schutzart sehr heiß
                    werden. Gefahr leichter Verbrennungen! Die Oberflächentemperatur kann 155 °C
                    überschreiten.

                         l   Messen Sie die Temperatur und warten Sie, bis der Motor TBM2G unter 40 °C
                             abgekühlt ist, bevor Sie ihn berühren.

                                                                  KOLLMORGEN | kdn.kollmorgen.com | June 2023     42

TBM2G Instructions | 2 Deutsch

                         GEFAHR Erdung! Hohe Spannungen!
                         Es ist unbedingt darauf zu achten, dass der Motor TBM2G sicher mit der PE-Sammelschiene
                         im Schaltschrank verbunden und somit geerdet ist. Gefahr durch elektrischen Schlag. Ohne
                         niederohmige Erdung ist keine personelle Sicherheit gewährleistet und es besteht
                         Lebensgefahr durch elektrischen Schlag.

                              l   Das Fehlen von optische Anzeigen gewährleisten nicht die Spannungsfreiheit.
                                  Leistungsanschlüsse können Spannung führen, auch wenn sich der Rotor nicht
                                  dreht.
                              l   Ziehen Sie keine Stecker während des Betriebs. Es besteht die Gefahr von Tod oder
                                  schweren gesundheitlichen Schäden beim Berühren freiliegender Kontakte.
                                  Leistungsanschlüsse können Spannung führen, auch wenn sich der Rotor nicht
                                  dreht. In ungünstigen Fällen können Lichtbögen entstehen und Personen und
                                  Kontakte schädigen.

                              l   Warten Sie nach dem Trennen des Servoantriebs von der Versorgungsspannung
                                  einige Minuten, bevor Sie spannungsführende Komponenten (z. B. Kontakte,
                                  Schraubverbindungen) berühren oder Anschlüsse öffnen.

                              l   Die Kondensatoren im Servoantrieb können auch einige Minuten nach dem
                                  Abschalten der Versorgungsspannungen noch eine gefährliche Spannung führen.
                                  Messen Sie zur Gewährleistung der Sicherheit die DC-Zwischenkreisspannung und
                                  warten Sie, bis die Spannung unter 60 V abgesunken ist.

     Nur bestimmungsgemäß verwenden („Bestimmungsgemäße Verwendung“)

         l   Der Anwender darf die Motoren nur unter den in dieser Dokumentation definierten
             Umgebungsbedingungen betreiben.
         l   Diese Motorenserie wurde ausschließlich für den Antrieb durch Servoantriebe vorgesehen.
         l   Die Motoren werden als Bauteile in elektrische Anlagen oder Maschinen eingebaut und dürfen nur als
             integrierte Bauteile der Anlage in Betrieb genommen werden.
         l   Der Endbenutzer übernimmt die Verantwortung für die Konformität der Maschine.

     2.1.6 Nicht bestimmungsgemäße Verwendung
     Die Verwendung der Motoren in den folgenden Umgebungen ist ohne Rücksprache mit dem Kundensupport von
     Kollmorgen verboten:

         l   explosionsgefährdete Bereiche,
         l   Umgebungen mit korrosiven und/oder elektrisch leitenden Säuren, alkalischen Lösungen, Ölen, Dämpfen
             und Staub,
         l   Vakuum,
         l   direkt am Stromnetz.

     Die Inbetriebnahme des Motors ist untersagt, wenn die Maschine, in die er eingebaut wurde,

         l   nicht den Bestimmungen der EG-Maschinenrichtlinie entspricht,
         l   nicht die Bestimmung der EMV-Richtlinie erfüllt,
         l   nicht die Bestimmung der Niederspannungsrichtlinie erfüllt.

43    KOLLMORGEN | kdn.kollmorgen.com | June 2023

                                            TBM2G Instructions | 2 Deutsch

2.1.7 Modellnomenklatur

                          KOLLMORGEN | kdn.kollmorgen.com | June 2023   44

TBM2G Instructions | 2 Deutsch

     2.1.8 Drehmoment Überblick
                               0.72 Nm to 1.75 Nm
       050         0.27 Nm to 0.64 Nm
                                           1.17 Nm to 2.85 Nm
                                                                                  Spitzendrehmoment
       060            0.45 Nm to 0.96 Nm                                          Kontinuierliches Drehmoment
                               1.53 Nm to 4.13 Nm
       068                  0.63 Nm to 1.54 Nm
                                           2.12 Nm to 5.57 Nm
       076                       0.89 Nm to 2.06 Nm
                                                        3.16 Nm to 7.01 Nm
       085                              1.21 Nm to 2.69 Nm
                                                                      3.75 Nm to 9.01 Nm
       094                                          1.58 Nm to 3.67 Nm
                                                                        3.18 Nm to 15.3 Nm
       115                                   1.90 Nm to 6.03 Nm
             0.0    1.0        2.0         3.0       4.0          5.0    6.0        7.0          8.0   9.0    15.0
                                                           Drehmoment (Nm)

     2.1.9 Zeichnung der Komponentenmaterialien
                                                                                  1. Gabel
                                                                                             l Material: Edelstahl der Serie
                                                                                               400
                                                                                  2.   Ringmagnet
                                                                                            l Material: NdFeB (Neodym-

                                                                                               Eisen-Bor)
                                                                                            l Beschichtung: Epoxid

                                                                                  3.   Leiterplatte (PCB)
                                                                                  4.   Spule
                                                                                            l Material: Kupfer

                                                                                            l Beschichtung: Lack

                                                                                  5.   End-Isolatoren
                                                                                       Material: Polymerharz
                                                                                  6.   Stromleitungen
                                                                                  7.   Laminierstapel
                                                                                       Material: Elektrostahl
                                                                                  8.   Optionale thermische Geräte
                                                                                       (unter der Leiterplatte montiert)
                                                                                            l PT1000

                                                                                            l PTC Avalanche (3 in Serie)

                                                                                  9.   Optionale Hall-Sensoren
                                                                                       (unter der Leiterplatte montiert)
                                                                                            l Allegro A1260

45    KOLLMORGEN | kdn.kollmorgen.com | June 2023

                                                                                     TBM2G Instructions | 2 Deutsch

2.2 Richtlinien für Lagerung, Betrieb und Transport

2.2.1 Lagerung
Klimakategorie               1K4 gemäß IEC 60721-3-1, EN61800-2.
Lagertemperatur              -25 bis +55 °C, max. Schwankung 20 °K pro Stunde
Feuchtigkeit                 relative Luftfeuchtigkeit 5–95 %, nicht kondensierend
Lagerdauer                   ohne Einschränkung

Lagern Sie Motoren nur in der Originalverpackung des Herstellers.

2.2.2 Betrieb
Umgebungstemperatur          -20 bis +40 °C bei einer Aufstellhöhe bis 1.000 m über NN
(bei Nennwerten)
Zulässige                    95 % relative Luftfeuchtigkeit, nicht kondensierend
Luftfeuchtigkeit (bei
Nennwerten)
Leistungsreduzierung         Keine Leistungsreduzierung bei Aufstellhöhen über 1.000 m über NN und
(Ströme und                  Temperaturreduzierung um 10 °K pro 1.000 m. Es muss sichergestellt werden,
Drehmomente)                 dass die Temperatur der Wicklung 155 °C nicht überschreitet.

2.2.3 Transport
Klimakategorie               2K3 gemäß IEC 60721-3-2, EN61800-2
Lagertemperatur              -25 bis +70 °C max. Schwankung 20 °K/Stunde
Feuchtigkeit                 relative Luftfeuchtigkeit 5–95 %, nicht kondensierend

Vermeiden Sie harte Stöße. Überprüfen Sie bei beschädigter Verpackung die Teile des Motors auf sichtbare
Schäden. Informieren Sie den Frachtführer und gegebenenfalls den Hersteller.

2.2.4 Auspacken
Der Satz aus Stator und Rotor wird in der Regel zusammen in einem einzigen Paket oder als Großpackung
geliefert. Individuelle Großverpackungen sind als Sonderoption erhältlich. Der Rotor und der Stator sind durch
Verpackungsmaterial voneinander getrennt, damit sie sich aufgrund der starken Magnetkräfte nicht gegenseitig
beeinflussen. Achten Sie beim Auspacken darauf, dass die Teile voneinander getrennt bleiben und dass der
stark magnetisierte Rotor keine anderen Gegenstände beeinflusst.
Der Stator kann auf Wunsch Hall-Sensorgeräte enthalten. Diese Geräte sind anfällig für Schäden durch
statische Elektrizität. Für den Versand von Statoren mit Hall-Geräten werden ESD-Beutel verwendet. Achten Sie
beim Auspacken darauf, den ESD-Schutz beizubehalten.

                                                                 KOLLMORGEN | kdn.kollmorgen.com | June 2023     46

TBM2G Instructions | 2 Deutsch

     2.3 Montage- und Installationshinweise

      Die in diesem Handbuch Kollmorgen enthaltenen Empfehlungen sind als allgemeine Installationshinweise
      gedacht und dienen nur zu Referenzzwecken. Kollmorgen übernimmt keine Verantwortung für die fehlerhafte
      Anwendung dieser Techniken, die in der alleinigen Verantwortung des Benutzers liegen.

     2.3.1 Definitionen der Anker- und Feldbaugruppe
     Ankerbaugruppe (Stator)
     Die Ankerbaugruppe ist der stationäre Teil des gehäuselosen Motors. Diese Baugruppe besteht aus den
     magnetischen Stahllaminierungen, Wicklungen und der Anschlussdrahtbaugruppe. Sie kann auch zusätzliche
     Optionen wie Hall-Geräte oder Temperatursensoren enthalten.
     Feldbaugruppe (Rotor)
     Die Feldbaugruppe ist der bewegliche Teil des gehäuselosen Motors. Diese Baugruppe besteht aus einem
     Seltenerd-Ringmagneten und einem Feldgestell.
     Gehäuseloser Motor (Satz)
     Ein Motor, der als separate Teile hergestellt und versandt wird: Stator und Rotor. Die einzelnen Teile müssen in
     ein vom Endverbraucher hergestelltes System aus Gehäuse, Welle und Lager eingebaut werden.

47    KOLLMORGEN | kdn.kollmorgen.com | June 2023

                                                                                      TBM2G Instructions | 2 Deutsch

2.3.2 Verantwortung des Benutzers für die Schnittstellen
Um die ordnungsgemäße Leistung und Zuverlässigkeit des Motors bei der Installation im System zu
gewährleisten, ist der Benutzer für die Gestaltung der Montageschnittstelle verantwortlich, wobei die folgenden
Informationen als Richtlinie dienen. Der Benutzer ist für die Konstruktion der Rotorwelle, des Statorgehäuses,
des Lagersystems, der Gehäusedetails, der Materialauswahl, der Passformberechnungen und der
Toleranzanalyse auf der Grundlage der Anforderungen der geplanten Anwendung verantwortlich.

2.3.2.1 Lager
Das vom Benutzer bereitgestellte Lagersystem in der Motoranwendung muss eine ausreichende Steifigkeit
aufweisen, um unter allen Betriebsbedingungen einen starren, gleichmäßigen Spalt zwischen dem Rotor und
dem Stator aufrechtzuerhalten. Ein gleichmäßiges Spiel beinhaltet Grenzwerte für Laufabweichung und
Konzentrizität zwischen Rotor und Stator.

2.3.2.2 Materialien für die Statormontage
Wir empfehlen, den Stator in einem Metallgehäuse oder einer Klemmkonstruktion starr zu montieren, um die
beste Wärmeableitung und die ordnungsgemäße strukturelle Integrität zu gewährleisten. Aluminiumlegierungen
werden aufgrund ihrer überlegenen Wärmeleitfähigkeit und ihres Verhältnisses von Festigkeit zu Gewicht
bevorzugt, obwohl Edelstahllegierungen (Serie 300 oder gleichwertig) jedoch eine akzeptable Alternative für
thermisch weniger kritische Anwendungen sind. Kohlenstoffstahl, Gusseisen, Edelstahllegierungen der Serie
400 und andere Eisenmetalle, die den magnetischen Fluss leiten, sind die am wenigsten wünschenswerte Wahl
für die Statormontage. Wenden Sie sich an einen Ingenieur von Kollmorgen, wenn solche Metalle verwendet
werden müssen. Kunststoffe oder andere ähnliche thermisch isolierende Materialien werden nicht empfohlen, da
sie die Wärmeabfuhrkapazität des Systems beeinträchtigen, so dass die Leistung des Motors erheblich reduziert
werden muss.

2.3.2.3 Materialien für die Rotormontage
Der magnetisierte Rotor kann auf jede beliebige Metallwelle montiert werden, die der Benutzer auswählt.
Kohlenstoffstahl und Edelstahl sind die am häufigsten verwendeten Wellenmaterialien, wobei jedoch
gelegentlich auch Aluminiumlegierungen verwendet werden, wenn sie für das vorgesehene Drehmoment und
den thermischen Betriebsbereich ordnungsgemäß ausgelegt sind. Die Methode zur Befestigung des Rotors an
der Welle kann die Wahl des optimalen Materials und der Toleranz für die Welle beeinflussen. Bei einem
bürstenlosen Motor von Kollmorgen muss die Welle keinen Fluss tragen oder als Teil des Magnetkreises
fungieren, um die Nennleistung zu erreichen.

2.3.2.4 Erdung
      Bei der Montage in der Anwendung sollte der Laminierstapel (oder die metallische Außenhülle) des
      Stators auf dem gleichen elektrischen Massepotential liegen wie das Systemgehäuse und das Gehäuse
      des Servoantriebs. Wenn dieser gemeinsame Erdungspfad nicht sichergestellt wird, kann es in der
      Anwendung zu elektrischen Störungen kommen, und es besteht die Gefahr eines Stromschlags. Die
      Gefahr eines Stromschlags ist besonders groß, wenn Sie Motoren mit hoher Polzahl und großer
      Kapazität verwenden. Wenn der Stator mit elektrisch leitenden Metallkomponenten montiert ist, wird in
      der Regel inhärent ein robuster Erdungspfad zwischen dem Stator-Laminierstapel und dem
      Maschinengehäuse erzeugt. Kollmorgen empfiehlt die Durchführung einer Durchgangsprüfung, um den
      korrekten Erdungspfad zu bestätigen, bevor Sie das Motorsystem aktivieren. Bei einigen Anwendungen
      kann je nach Montagekonfiguration und Materialwahl ein separates leitfähiges Erdungsband erforderlich
      sein. In solchen Fällen ist der Benutzer für die Installation des Erdungspfades und die elektrische
      Überprüfung verantwortlich.

                                                                  KOLLMORGEN | kdn.kollmorgen.com | June 2023     48

TBM2G Instructions | 2 Deutsch

     2.3.2.5 Grundlegende Einbauanweisungen
                        Motoren der Serie TBM2G von Kollmorgen sowie andere gehäuselose und
                        bürstenlose Motoren verwenden leistungsstarke Seltenerdmagnete. Seien
                        Sie bei der Handhabung und beim Transport äußerst vorsichtig, um
                        Verletzungen und Produktschäden zu vermeiden. Die Anziehungskräfte
                        zwischen magnetisierten Rotoren und metallischen Gegenständen in der
                        Nähe können extrem stark sein. Unsachgemäße Handhabung kann zu
                        plötzlichen unerwarteten Stößen führen. Das starke Magnetfeld kann auch
                        Computer, Bildschirme und Speichergeräte in der Nähe beschädigen.
                        Bewahren Sie den Rotor in seinem Versandbehälter oder in einer
                        Schutzverpackung auf, bis er installiert werden kann. Auf diese Weise
                        vermeiden Sie Unfälle und Verunreinigungen wie Metallspäne oder Schutt,
                        die an den Magneten haften bleiben.

     Nachfolgend finden Sie ein allgemeines Montageverfahren, das Sie beim Einsetzen eines Rotors
     (Feldbaugruppe) in einen Stator (Ankerbaugruppe) befolgen können

      1. Befestigen Sie das kundenseitig bereitgestellte Gehäuse sicher auf einer stabilen Oberfläche, um plötzliche
         Bewegungen zu vermeiden.
      2. Schieben Sie den Stator in das Gehäuse und befestigen Sie ihn, indem Sie ihn entweder verkleben oder
         festklemmen, wie in der Vorgehensweise bei der Statormontage gezeigt.
      3. Schieben Sie den Rotor auf die kundenseitig bereitgestellte Welle und sichern Sie ihn, indem Sie ihn
         entweder verkleben oder festklemmen, wie in der Vorgehensweise bei der Rotormontage gezeigt.

          Seltenerdmagnete sind anfällig für Risse und Absplitterungen. Achten Sie darauf, die Magnete nicht fallen
          zu lassen und Stöße mit anderen Oberflächen zu vermeiden, wenn Sie den Rotor auf der Welle montieren.
      4. Bevor Sie die Rotor-/Wellenbaugruppe in die Stator/Gehäusebaugruppe einsetzen, empfiehlt Kollmorgen,
         zunächst eine dünne Schicht Ausgleichsmaterial, wie z. B. Mylar®-Folie, in die Innenbohrung des Stators
         einzubringen.
             l Die Mylar-Folie kann als einzelnes Stück installiert werden, das vollständig um den Umfang der

               Statorbohrung gewickelt wird, oder es können mehrere Stücke axial an gleichmäßig beabstandeten
               Punkten eingefügt werden. Die optimale Dicke der Folie und die Anzahl der erforderlichen
               Ausgleichsschichten hängt vom Spaltspiel zwischen Rotor und Stator für die spezifische Motorgröße
               ab, die der Benutzer zu installieren versucht. Beachten Sie die Tabelle für den radialen Freiraum
               unten.

                 Die äußere Oberfläche des Rotors kann aufgrund magnetischer Anziehungskräfte an der
                 nächstgelegenen Stelle der inneren Bohrung des Stators haften, wenn der Benutzer versucht, den
                 Rotor zu installieren. Die daraus resultierende Reibung, wenn der Rotor an der Innenseite des
                 Stators entlang gleitet, kann möglicherweise die Rotorbandage, die Magnete, die Beschichtungen
                 oder die Oberflächen der Statorbohrung beschädigen.
      5. Setzen Sie den Rotor langsam und gleichmäßig entlang der zentralen Achslinie ein, um den Rotor im Stator
         zu positionieren. Dies kann von Hand oder mit Hilfe einer speziellen Installationshalterung erfolgen.
      6. Montieren Sie die Lager nach Bedarf auf die Rotoreinheit, um die Ausrichtung der Welle beizubehalten,
         bevor Sie die Ausgleichsfolie entfernen.
      7. Entfernen Sie vor dem Betrieb das Ausgleichsmaterial aus dem Luftspalt zwischen Rotor und Stator.

49    KOLLMORGEN | kdn.kollmorgen.com | June 2023

                                                                                   TBM2G Instructions | 2 Deutsch

Typischer radialer Freiraum
                              TBM2G Baugröße

                              050        060         068        076        085        094        115
 Nominaler         mm         0,26       0,29        0,26       0,26       0,26       0,26       0,40
 mechanischer
 Abstand           in.        0,010      0,011       0,010      0,010      0,010      0,010      0,016

 Die Anforderungen an die Konzentrizität, die auf jeder modellspezifischen Umrisszeichnung Kollmorgen
 vermerkt sind, müssen vom Benutzer berücksichtigt werden. Es sollten Lager mit möglichst geringer Reibung
 und ein hochwertiges Schmiermittel gewählt werden, um die Reibung im Gesamtsystem zu minimieren, was
 einen optimalen Motorbetrieb ermöglicht.

                                                               KOLLMORGEN | kdn.kollmorgen.com | June 2023    50

TBM2G Instructions | 2 Deutsch

     2.3.3 Vorgehensweise bei der Statormontage
     Kollmorgen schlägt die folgenden Optionen für die Installation des Motorstators vor, je nach Drehmoment,
     Vibration und den thermischen Eigenschaften der Anwendung sowie den Kosten, der einfachen Montage und
     der vom Benutzer gewünschten Wartungsfreundlichkeit.

     2.3.3.1 Statorverklebung

      Die Oberflächen von Stator und Gehäuse sollten vor dem Verkleben gründlich gereinigt werden, um eine gute
      Haftung zu gewährleisten. Informieren Sie sich im Datenblatt des verwendeten Klebstoffs über die
      Reinigungstechniken für das jeweilige Gehäusematerial.

     In den meisten Fällen kann der Stator bei Motoren im allgemeinen Spitzendrehmomentbereich bis 2.400 Nm mit
     einem Epoxidharz wie 3M™ Scotch-Weld™ 2214 oder anderen ähnlichen Klebstoffen verklebt werden.
     Verkleben ist eine bevorzugte Technik bei der dauerhaften Installation aller Statoren TBM2G. Wie in den
     Abbildungen zur Statorverklebung unten gezeigt, sollte das Statorgehäuse als zylindrische Schale konstruiert
     werden, der an einem Ende eine kleine Schulter zur axialen Positionierung aufweist und am
     gegenüberliegenden Ende offen ist, um eine erfolgreiche Verklebung zu ermöglichen. Die Schulter dient als
     Anschlagspunkt für den Stator, wenn er vom offenen Ende her eingeführt wird. Sie sollte im Allgemeinen den
     maximalen Außendurchmesser der Endwindung der Wicklung freilassen, wie auf der Skizze angegeben.
     Eckaussparungen sind erforderlich, um die scharfen Ecken der Statorbleche aufzunehmen. Eine kleine innere
     Abfasung am offenen Ende der Gehäuseschale vereinfacht das Einsetzen des Stators. Wenn der
     Zusammenbau bei flach liegendem Statorgehäuse durchgeführt wird [Rotationsachse senkrecht], unterstützt der
     hydrostatische Druck des Strukturklebstoffs die Selbstzentrierung des Stators im Statorgehäuse.
                                                                        1.    Lager (kundenseitig)
                                                                        2.    Gehäuse (kundenseitig)
                                                                        3.    Rückmeldung (kundenseitig)
                                                                        4.    TBM2G-Stator

                          TIEFENANSCHLAG
                                                                      0.025 MM [0.010 IN.] MIN.
                        SCHULTERMERKMAL
                                                                      ABSTAND ZU ALLEN
              DER ISOLATOR KANN DAS GEHÄUSE      KLEBERESERVOIR       LÖTSTELLEN
                    AN DIESEM ENDE BERÜHREN              -RILLEN
                                                                        0.13 - 0.26 MM [0.006 - 0.010 IN.]
                                                                        ZUSÄTZLICHE KLEBERILLE 50+%
                                                                        DER OBERFLÄCHE

                                                                             0.025/0.050 MM
                                                                             NENNSPALT (RADIAL)
                                                                             PRO SEITE

                                                                   EMPFOHLENES STRUKTUREPOXID:
                                                                   3M SCOTCHWELD 2214
                                                                   HYSOL EA934NA

             Figure 5-1: Illustrationen zur Statorverklebung

51    KOLLMORGEN | kdn.kollmorgen.com | June 2023

                                                                                  TBM2G Instructions | 2 Deutsch

Temperaturspitzen können aufgrund unterschiedlicher Ausdehnungskoeffizienten ein Problem darstellen [z. B.
Stahlbleche vs. Aluminiumgehäuse]. Der Benutzer sollte den Hersteller des Klebstoffs konsultieren, um sich
über die richtige Dicke der Klebelinie, das Anwendungsverfahren und die Anweisungen zur Aushärtung zu
informieren. Die Rillen im Innendurchmesser des Gehäuses, die in den Abbildungen der Statorverklebung zu
sehen sind, sollen als Klebstoffreservoir für das dickflüssige Epoxidharz dienen, das über einen breiten
Temperaturbereich hinweg für eine hohe Torsionsfestigkeit sorgt. Wenn Sie ein dickflüssiges Epoxidharz
verwenden, sollte der Innendurchmesser der Gehäuseschale etwa 0,05 mm – 0,1 mm größer sein als der
maximale Außendurchmesser des Stators. Wenn sie gemäß den Empfehlungen des Herstellers verwendet
werden, bieten diese Klebstoffe eine hervorragende Lebensdauer und Festigkeit.
Wenn Sie anstelle eines Epoxidharzes eine Halteverbindung, wie z. B. LOCTITE® 640™ oder einen ähnlichen
Klebstoff, bevorzugen, muss der Abstand zwischen dem Innendurchmesser des Gehäuses und dem
Außendurchmesser des Stators enger sein, um eine angemessene Dicke der Klebelinie zu gewährleisten.
Empfehlungen finden Sie in den Richtlinien des Klebstoffherstellers.

Der Benutzer übernimmt die Verantwortung für die Auswahl des richtigen Klebstoffs und für die Auslegung der
Gehäuseabmessungen entsprechend der erwarteten thermischen Ausdehnungsrate bei den beabsichtigten
Temperaturspitzen der Anwendung. Die Aushärtungstemperatur des Klebstoffs sollte 155 °C nicht
überschreiten, um den Motorstator nicht zu beschädigen.

                                                               KOLLMORGEN | kdn.kollmorgen.com | June 2023    52

TBM2G Instructions | 2 Deutsch

     2.3.3.2 Stator-Klemmung
     Für Anwendungen, bei denen der Stator möglicherweise wiederholt ein- und ausgebaut werden muss, kann eine
     axiale Klemmung eine akzeptable Option sein. Kollmorgen empfiehlt diese Technik im Allgemeinen nicht für
     Anwendungen mit hohen Schock- und Vibrationsbelastungen oder extremen Temperaturen ohne besondere
     Überlegungen zum Design. Das in der Abbildung unten gezeigte Statorgehäuse ist dem der Epoxidharz-
     Klebetechnik sehr ähnlich. Wenn Sie die Klemmtechnik zur Montage des Stators verwenden, sollte der
     Innendurchmesser der Gehäuseschale etwa 0,025 mm – 0,050 mm größer sein als der maximale
     Außendurchmesser des Stators. Falls gewünscht, kann der kleine radiale Raum zwischen dem
     Außendurchmesser des Stators und dem Innendurchmesser des Gehäuses mit einer Wärmeleitpaste gefüllt
     werden, um eine effizientere Wärmeleitung zum Kühlkörper zu gewährleisten.

      Achten Sie darauf, die axialen Klemmflächen nicht mit Fetten zu verunreinigen, die zu einer verminderten
      Klemmreibung führen können.

     Es ist eine maschinell bearbeitete Schulter erforderlich, die beim Einführen als Anschlag und Verortungspunkt
     für den Stator dient, an die er anstoßen kann. Am gegenüberliegenden Ende des Stators wird ein separater
     Klemmring benötigt, der mit 4 bis 12 gleichmäßig verteilten Schrauben an das Gehäuse geschraubt wird.
     Maximieren Sie anhand der Abmessungen auf der Umrisszeichnung die Fläche zum Klemmen. Dadurch wird die
     Klemmbeanspruchung des Stators minimiert. Legen Sie die Bohrungstiefe des Gehäuses so aus, dass der
     Klemmring unter allen Toleranz- und Temperaturbedingungen den Statorkern berührt, bevor er das Gehäuse
     berührt. Das Klemmen auf der Gehäuseoberfläche vor dem Stator führt zu einer unzureichenden Klemmkraft.
     Die Toleranzen für den Stator finden Sie in der Umrisszeichnung. Der Klemmdruck ist abhängig von der Fläche
     und der Klemmkraft. Der Klemmdruck sollte im Bereich von 5 bis 20 Mpa (725 bis 2.900 psi) liegen. Achten Sie
     darauf, dass der Klemmdruck nicht zu hoch ist. Extreme Drücke führen zu erhöhten Kernverlusten beim Betrieb
     mit hohen Drehzahlen. Achten Sie auch auf eine ausreichende Vorspannung der Spannbolzen. Zusammen mit
     einer entfernbaren Gewindesicherung wird dies dazu beitragen, dass sich die Klemmschrauben auch nach
     längerem Betrieb nicht lösen.
                                                                                        1. Gehäuse (kundenseitig)
                                                                                        2. TBM2G-Stator
                                                                                        3. Stator-Klemmring

                                                                    DER KLEMMRING MUSS HINTEN EINEN
                                                                    SPALT HABEN, DAMIT DIE
                              TIEFENANSCHLAG
                                                                    STATORSCHULTER
                            SCHULTERMERKMAL
                                                                    ZUSAMMENGEDRÜCKT WERDEN KANN
                        DER ISOLATOR KANN DAS                            0.012/0.025 MM NENNSPALT
                           GEHÄUSE AN DIESEM                             (RADIAL) PRO SEITE
                                ENDE BERÜHREN

                                                                        KLEMMRING MIT BOLZEN
                                                                        MUSS MINDESTENS DIE
                                                                        HÄLFTE DER STATORSCHULTER
                                                                        ERFASSEN

              Figure 5-2: Illustrationen der Stator-Klemmung

53    KOLLMORGEN | kdn.kollmorgen.com | June 2023

                                                                      TBM2G Instructions | 2 Deutsch

2.3.4 Vorgehensweise bei der Rotormontage
               Motoren der Serie TBM2G von Kollmorgen sowie andere gehäuselose und
               bürstenlose Motoren verwenden leistungsstarke Seltenerdmagnete. Seien
               Sie bei der Handhabung und beim Transport äußerst vorsichtig, um
               Verletzungen und Produktschäden zu vermeiden. Die Anziehungskräfte
               zwischen magnetisierten Rotoren und metallischen Gegenständen in der
               Nähe können extrem stark sein. Unsachgemäße Handhabung kann zu
               plötzlichen unerwarteten Stößen führen. Das starke Magnetfeld kann auch
               Computer, Bildschirme und Speichergeräte in der Nähe beschädigen.
               Bewahren Sie den Rotor in seinem Versandbehälter oder in einer
               Schutzverpackung auf, bis er installiert werden kann. Auf diese Weise
               vermeiden Sie Unfälle und Verunreinigungen wie Metallspäne oder Schutt,
               die an den Magneten haften bleiben.

2.3.4.1 Kontrolle des radialen Nachlaufs
               In den modellspezifischen Umrisszeichnungen von Kollmorgen ist eine
               Montageanforderung für den Nachlauf des Rotor-ID zum Stator-AD
               vermerkt. Diese Positionsbezeichnung soll die Anforderungen des
               Anwenders an den Nachlauf zwischen dem AD der Welle und dem ID des
               Gehäuses darstellen. Der Benutzer ist dafür verantwortlich, die Welle, das
               Gehäuse und das Lagersystem so zu konstruieren, dass die angegebene
               Nachlaufgrenze zwischen dem AD der Klebefläche der Welle und dem ID der
               Klebefläche des Gehäuses eingehalten wird. Wenn dies befolgt wird, sollte
               die Gesamtkonzentrizität von Rotor-AD und Stator-ID akzeptabel sein.

                                                    KOLLMORGEN | kdn.kollmorgen.com | June 2023   54

TBM2G Instructions | 2 Deutsch

     2.3.4.2 Rotorverklebung

      Die Oberflächen von Stator und Gehäuse sollten vor dem Verkleben gründlich gereinigt werden, um eine gute
      Haftung zu gewährleisten. Informieren Sie sich im Datenblatt des verwendeten Klebstoffs über die
      Reinigungstechniken für das jeweilige Gehäusematerial.

     Für Anwendungen, bei denen das Spitzendrehmoment 750 Nm nicht übersteigt, können die Rotoren in der
     Regel auf Wellen aus Kohlenstoffstahl oder Edelstahl geklebt werden. Halteverbindungen wie LOCTITE® 640™
     oder andere ähnliche Klebstoffe erfordern in der Regel glatte, durchgehende Schnittstellendurchmesser und
     enge Passungstoleranzen, wie z. B. Nennabstände von 0,012 mm – 0,025 mm. Strukturelle Epoxidharze
     erfordern in der Regel ein etwas größeres Passungsspiel, um eine dickere Klebelinie zu ermöglichen.
     Epoxidharze profitieren oft von Rillen in der Schnittstelle zwischen Welle und Rotor, die als Klebstoffreservoir
     dienen und durch strukturierte, maschinell bearbeitete Oberflächen mittels Rändelung oder Sandstrahlen
     vergrößert werden können. Informieren Sie sich beim Klebstoffhersteller über die richtige Dicke der Klebelinie,
     Passungstoleranzen, Verarbeitungsdetails und Aushärtungsrichtlinien.
     Um eine partielle Entmagnetisierung des Rotors zu vermeiden, sollten Sie die Rotor-Wellen-Verbindungen nicht
     bei Temperaturen über 110 °C aushärten, es sei denn, der Rotor ist in den passenden Stator eingebettet oder
     der Rotor ist vollständig von einer „Schutzvorrichtung“ aus Eisenmetall umgeben. Wenden Sie sich an einen
     Ingenieur von Kollmorgen, wenn Sie weitere Informationen zu diesem Thema benötigen. Bevor Sie Rotoren auf
     Aluminiumwellen kleben, sollten Sie den Hersteller des Klebstoffs um Rat fragen. Möglicherweise ist ein
     hochflexibler Klebstoff mit breiten thermischen Eigenschaften erforderlich.
                                                                            1. Welle (kundenseitig)
                                                                            2. TBM2G Feldbaugruppe, Rotor

                                                                        FELDMONTAGE

                                                                             0.012/0.025 MM NOMINAL
                                                                             (RADIAL) GAP PER SIDE

                                   EINBAUTIEFE                              KUNDENWELLE
                                   BIS ZUR
                                   SCHULTER

              Figure 5-3: Illustrationen zur Rotorverklebung

55    KOLLMORGEN | kdn.kollmorgen.com | June 2023

                                                                                   TBM2G Instructions | 2 Deutsch

2.3.5 Vorgehensweise bei axialer Montage

2.3.5.1 Kontrolle der axialen Ausrichtung
Die modellspezifischen Umrisszeichnungen von Kollmorgen weisen auf die axiale Ausrichtung hin, die bei der
Montage zwischen Rotor und Stator eingehalten werden muss, um eine ordnungsgemäße Motorleistung zu
gewährleisten. Der Benutzer ist für die Konstruktion der Rotorwelle, des Statorgehäuses und des Lagersystems
verantwortlich, um die angegebene Montageausrichtung zu erreichen. Bearbeitete Schultern auf der Welle oder
Nuten für abnehmbare Sicherungsringe sind gängige Methoden, um die Einbauposition des Rotors zu
kontrollieren. Der maximale Durchmesser der Sicherungsringe oder Wellenschultern sollte unterhalb des
Rotordurchmessers liegen, wenn die Magnete mit der Stahlnabe verbunden sind.

                                                                KOLLMORGEN | kdn.kollmorgen.com | June 2023    56

TBM2G Instructions | 2 Deutsch

     2.3.6 Axiale Montage
     Um die volle Leistung und korrekte Auslösung der Hall-Geräte zu gewährleisten, gibt Kollmorgen ein Einbaumaß
     zwischen der Kante des Laminierstapels und der Kante des Feldgestells [Kollmorgen] an.
     Dieses Einbaumaß stellt sicher, dass das Magnetmaterial den Laminierstapel vollständig abdeckt und sich axial
     erstreckt, um die Hall-Geräte auszulösen, falls zutreffend.
                                              "A"
                                             MAX.
                                                        ARMATURENBAUGRUPPE
                                             "B"
                                                           3.00 [0.118] MAX.
                   4.70 [0.185] MAX                        ÜBERLÖTUNG UND WÄRMESCHIENE
                                                           SIEHE ANMERKUNG 3
                                                                             A

                                                                                                      YOKE-RING

                FELDMONTAGE
                                                           2X 30°

     Ø 91.13 [3.588]
         MAX.
                                                          2X 0.50
                                                          [0.020]
                                                          KAMMER
                                   "C"
                                                                          Ø93.96 - 94.04
                   Ø46.98 - 47.02                                          [3.700 - 3.702]
                    [1.850 - 1.851]
                      0.07 [0.003] A
                   MONTAGEAN-
                   FORDERUNG
                                                                Ø92.33
                                                                [3.635]
                                                                 MAX

                                                                                               0.70±0.40 [0.028±0.015]
                                                                                               MTG DIM
                0.70±0.40 [0.028±0.015]
                             MTG DIM                    SCHARFE ECKE AUF BEIDEN SEITEN.
                                                        HINTERSCHNITT AN DEN ZUGEHÖRIGEN
                                                        BAUTEILEN ERFORDERLICH
                                          SEKTION A-A

                       Figure 5-4: Abbildung des Einbaumaßes, angegeben auf einer TBM2G-068XXX-XXXX-00-Skizze. Dieses Maß
                       wird von der linken Kante des Laminierstapels bis zur linken Kante des Gestellmaterials (nicht Magnet) gemessen.

     Wenn Sie das alternative Einbaumaß von der anderen Seite des Laminierstapels ermitteln möchten, kann der
     Nennwert mithilfe einiger Parameter aus der Zeichnung berechnet werden. Um den Nennwert von der rechten
     Kante des Laminierstapels bis zur rechten Kante des Gestellmaterials zu berechnen, verwenden Sie die
     folgende Gleichung:
                        Alternatives Einbaumaß (mm, nominal) = „C“ - „B“ - 0,70 mm
     Als Beispiel für die Berechnung des alternativen Einbaumaßes verwenden wir Folgendes:

            l     Die Maße für TBM2G-06813-00 aus der TBM2G-068XXX-XXXX-00-Skizze in "Abbildung des
                  Einbaumaßes, angegeben auf einer TBM2G-068XXX-XXXX-00-Skizze. Dieses Maß wird von der linken
                  Kante des Laminierstapels bis zur linken Kante des Gestellmaterials (nicht Magnet) gemessen." (➜ p.
                  57).
            l     Die Gleichung für das alternative Einbaumaß.
            l     Eine Tabelle aus der TBM2G-068-Skizze, die die Werte für „B“ und „C“ angibt, gezeigt in "Tabelle für die

57     KOLLMORGEN | kdn.kollmorgen.com | June 2023

                                                                                        TBM2G Instructions | 2 Deutsch

      Werte „A“ MAX, „B“ und „C“ aus der TBM2G-068XXX-XXXX-00-Skizze." (➜ p. 58).

      Stack Specific Dimensional Data
       Part Number            "A" Max      "B" REF ±0.35 [0.014] “C” ±0.08 [0.004]
       TBM2G-06808-00 18.34 [0.722]               8.2 [0.323]           14.76 [0.581]

       TBM2G-06813-00 22.84 [0.899]             12.70 [0.500]           19.26 [0.758]

       TBM2G-06826-00 36.44 [1.435]             26.30 [1.035]           32.86 [1.294]

                Figure 5-5: Tabelle für die Werte „A“ MAX, „B“ und „C“ aus der TBM2G-068XXX-XXXX-00-Skizze.

Beispiel:
Für TBM2G-06813-00, „B“ = 12,7 mm nominal und „C“ = 19,26 mm nominal. Das ursprüngliche Einbaumaß,
0,70 mm nominal, ist bereits in der Skizze angegeben. Anhand unserer Gleichung können wir nun Folgendes
berechnen:
            Alternatives Einbaumaß (mm) = 19,26 mm - 12,7 mm - 0,70 mm = 5,86 mm
            nominal

                                                                   KOLLMORGEN | kdn.kollmorgen.com | June 2023     58

TBM2G Instructions | 2 Deutsch

     2.3.7 Schnittstelle der elektrischen Verkabelung

     2.3.7.1 Verdrahtung
     Motoren der Serie TBM2G können mit UL-konformen freien Anschlussleitungen mit offenen Enden geliefert
     werden. Der Benutzer ist für die ordnungsgemäße Verlegung und den Anschluss der Kabel gemäß den
     Diagrammen in den Zeichnungen Kollmorgen verantwortlich. Vermeiden Sie die Verlegung von Kabeln über
     scharfe Ecken, Quetschstellen oder Kanten, die die Isolierung durchstechen könnten. Klemmen oder sichern Sie
     Drahtbündel in Anwendungen mit starken Vibrationen und vermeiden Sie den Kontakt der Drähte mit sich
     bewegenden oder vibrierenden Oberflächen, die die Isolierung abreiben könnten. Sorgen Sie für eine
     Zugentlastung für alle Kabelbündel und lassen Sie Platz für einen großzügigen Biegeradius. Der Benutzer
     übernimmt die Verantwortung für die Installation von Steckern, das Crimpen, Löten, die Abschirmung, die
     Ummantelung oder jede andere Drahtbündelung oder elektrische Schnittstellenerweiterung, die über die auf der
     Umrisszeichnung TBM2G gezeigte Konfiguration hinausgeht.

     2.3.7.2 Anforderungen an Anschlusskabel (Option ohne Kabel)
     Empfehlungen/Richtlinien zum Löten von Anschlusskabeln auf Pads.

     2.3.7.3 Allgemeine Daten und Verkabelung der Stromleitungen
     ALLGEMEINE DATEN DER STROMLEITUNGEN
      Motor                      TBM2G-       TBM2G-    TBMG-      TBM2G-      TBM2G-      TBM2G-     TBM2G-
                                   050          060      068         076         085         094        115
      Typ                                                   3 freie Kabelanschlüsse
      Länge, mm*                                                      500
      Leitungsquerschnitt,         20           20        20          18          16          14         14
      AWG
      Nenndurchmesser der         1,47         1,47       1,47       1,70        1,98        2,26        2,26
      Isolierung, mm
      Min. Statischer             7,37         7,37       7,37       8,51        9,91        11,3        11,3
      Biegeradius, mm

     *Optionale Ausführung ohne Leitung (nur Lötpad)

     ELEKTRISCHE SCHNITTSTELLE DER
     STROMLEITUNG
      Farbe                  Funktion (alt)
      Rot                    Phase U (A)
      Weiß                   Phase V (B)
      Schwarz                Phase W (C)

59    KOLLMORGEN | kdn.kollmorgen.com | June 2023

                                                                              TBM2G Instructions | 2 Deutsch

      ERREGUNGSDIAGRAMM DER STROMLEITUNGEN
SCHRITT      Phase „U“ Rot Phase „V“ Weiß Phase „W“ Schwarz
1
                  ⊕               ⊖
2
                  ⊕                                 ⊖
3
                                  ⊕                 ⊖
4
                   ⊖              ⊕
5
                   ⊖                                ⊕
6
                                  ⊖                 ⊕
Rechtsdrehung von der Leiterplatte/dem Leitungsausgangsende aus
gesehen

                                                            KOLLMORGEN | kdn.kollmorgen.com | June 2023   60

TBM2G Instructions | 2 Deutsch

     2.3.7.4 Allgemeine Daten und Verkabelung der thermischen Geräte
     Um einen sicheren Dauerbetrieb von Motoren der Serie TBM2G in anspruchsvollen Anwendungen zu
     gewährleisten, können integrierte Thermistoren auf der Leiterplatte PCBA angebracht werden. Die typische
     Option für TBM2G ist ein PT1000 RTD. Als Alternative bieten drei in Reihe geschaltete PTC-Geräte, von denen
     eins in jeder Phasenwicklung platziert wird, Schutz für jede Phase.

     ALLGEMEINE DATEN ZUR THERMISCHEN LEITUNG
      Motor                      TBM2G-      TBM2G-    TBM2G-      TBM2G-      TBM2G-      TBM2G-      TBM2G-
                                   050         060       068         076         085         094         115
      Typ                                                   2 freie Kabelanschlüsse
      Länge, mm*                                                      500
      Leitungsquerschnitt,          26         26         26          26          26          26          26
      AWG
      Nenndurchmesser der          0,99       0,99       0,99        0,99        0,99        0,99        0,99
      Isolierung, mm
      Min. Statischer              4,95       4,95       4,95        4,95        4,95        4,95        4,95
      Biegeradius, mm

     *Optionale Ausführung ohne Leitung (nur Lötpad)

     ELEKTRISCHE SCHNITTSTELLE DER
     THERMISCHEN LEITUNG
      Farbe             Funktion (alt.)
      Weiß              Temperatursensor +
      Weiß              Temperatursensor -

     2.3.7.4.1 Thermoschutz
     Es gibt zwei Methoden für den thermischen Schutz im Dauerbetrieb. Die erste Methode ermöglicht eine
     kontinuierliche Messung der Motortemperatur mit einem PT1000. Die Temperatur des Motors wird durch
     Messung des Widerstands des PT1000 gemäß IEC-60751 bestimmt (siehe Tabelle unten). Da nur ein Gerät
     verwendet werden kann, kann mit dieser Methode nur eine der Motorphasen überwacht werden. Er wird daher
     nicht für Anwendungen empfohlen, bei denen sich der Motor über einen längeren Zeitraum im Blockierzustand
     befindet.
     Bei der zweiten Methode werden drei Avalanche-PTC in Reihe geschaltet. Für jede der drei Phasen gibt es einen
     PTC, um sicherzustellen, dass keine der Phasen die Nenntemperatur des Motors überschreitet. Diese Option
     sollte gewählt werden, wenn sich der Motor über einen längeren Zeitraum im Blockierzustand befindet. Bei
     normalem Betrieb liegt der Widerstand der Geräte unter 1.500 Ohm. Wenn eine Phase die 155 °C erreicht, steigt
     der Widerstand schnell an und überschreitet > 7.000 Ohm.
     Keine dieser beiden Methoden schützt den Motor vor Überhitzung, wenn ein höherer Strom als der zulässige
     Dauerstrom angelegt wird. Die thermischen Geräte können nicht schnell genug reagieren, um die
     Temperaturveränderung auszugleichen, die beim Anlegen von Spitzenstrom auftritt. Der Antrieb muss die Dauer
     des Spitzenstroms im Motor begrenzen, um eine Überhitzung zu vermeiden.

61    KOLLMORGEN | kdn.kollmorgen.com | June 2023

                                                                                                                     TBM2G Instructions | 2 Deutsch

                                          PT1000 Widerstand vs. Temperatur
                    1800

                    1600
                    1400
Widerstand in Ohm

                    1200
                    1000

                     800

                     600

                     400
                     200

                       0
                           0    20   40      60         80   100 120      140    160   180   200
                                                       Temperatur in ˚C

                               15

Bei dieser Option ist nur der PT1000 in Reihe geschaltet und liefert das gleiche Ergebnis wie in der obigen
Grafik.

                                PTC-3 Serienwiderstand im Vergleich zur Temperatur
100,000

       50,000
Widerstand in Ohm

                    10K

                     5K

                    1000
                           0    20    40          60      80    100     120     140    160   180
                                                       Temperatur in ˚C

                               15$                       15$                     15$

Bei dieser Option sind drei PTCs in drei verschiedenen Phasen in Reihe geschaltet. Wenn sich eine der Phasen
der Nenntemperatur des Motors nähert, steigt der Widerstand stark an.

                                                                                                   KOLLMORGEN | kdn.kollmorgen.com | June 2023   62

TBM2G Instructions | 2 Deutsch

     2.3.7.5 Allgemeine Daten und Verkabelung des Hall-Sensors
     ALLGEMEINE DATEN DES HALL-SENSORS
      Motor                                     TBM2G-           TBM2G-           TBMG-        TBM2G-      TBM2G-      TBM2G-   TBM2G-
                                                  050              060             068           076         085         094      115
      Typ                                                                     5 freie Kabelanschlüsse, Allegro A1260
      Eingangsspannung,                                                                        +5 bis 24
      VDC
      Ausgangssignal                                                                        Sink-Ausführung
      Länge, mm*                                                                                 500
      Leitungsquerschnitt,                           26               26               26        26           26         26       26
      AWG
      Nenndurchmesser der                        0,99                 0,99          0,99        0,99          0,99      0,99     0,99
      Isolierung, mm
      Min. Statischer                            4,95                 4,95          4,95        4,95          4,95      4,95     4,95
      Biegeradius, mm

     *Optionale Ausführung ohne Leitung (nur Lötpad)

     ELEKTRISCHE SCHNITTSTELLE DER HALL-
     SENSOR-LEITUNG
      Farbe                             Funktion (alt)
      Braun                             Hall 1 (U-V)
      Orange                            Hall 2 (V-W)
      Gelb                              Hall 3 (W-U)
      Blau                              +5 bis 24 VDC
      Grün                              Masse

     Sensor-Schaltbild
                      R = 1.5 kΩ (Kunde mitgeliefert)
                                                                             BLAU
                      R                    R                     R      (+5 TO 24 V DC)

      H                    H                     H
          1                    2                     3
                 BROWN               ORANGE                   GELB
               AUSGANG              AUSGANG               AUSGANG
              PHASE - UV           PHASE - VW            PHASE - WU
                                                                              GRÜN
                                                                             (BODEN)

63    KOLLMORGEN | kdn.kollmorgen.com | June 2023

                                                                                                                TBM2G Instructions | 2 Deutsch

Sensor-Ausgangs-Diagramm
U, V, W synchronisiert für Rechtsdrehung von der Leiterplatte/dem Leitungsausgangsende gesehen

     VOLTS
                    1          2          3          4          5          6

               Bemf U-V

     5
H1                                                                               IN PHASE MIT Bemf U-V
     0                               Bemf V-W

     5
H2                                                                               IN PHASE MIT Bemf V-W
     0                                                     Bemf W-U

     5
H3                                                                               IN PHASE MIT Bemf W-U
     0
              60˚                  180˚                  300˚                  420˚
         0˚             120˚                  240˚                  360˚
              ELEKTRISCHE GRADE (RELATIV)

                                                                                              KOLLMORGEN | kdn.kollmorgen.com | June 2023   64

TBM2G Instructions | 2 Deutsch

     2.4 Begriffsdefinitionen für technische Daten
     Maximales Dauerstillstandsmoment, Tmc [Nm]:Das maximale Dauerstillstandsmoment kann bei niedriger
                    Drehzahl und Nennumgebungsbedingungen unbegrenzt aufrechterhalten werden. Es kann
                    zu einer zusätzlichen Reduzierung kommen, wenn die Geschwindigkeit nicht hoch genug ist,
                    um eine gleichmäßige Wärmeverteilung über die Phasen zu erreichen. Dieser Wert geht von
                    einer Umgebungstemperatur von 25 °C aus.
     Maximaler Dauerstrom, Imc [Aeff]:Der maximale Dauerstrom ist der effektive sinusförmige Strom, den der
                     Motor bei niedriger Drehzahl aufnimmt, um das maximale Dauerstillstandsmoment zu
                     erzeugen.

     Maximale mechanische Drehzahl, Nmax [U/min]:Die maximale mechanische Drehzahl ist die höchste
                    Drehzahl, die der Motor erreichen kann. Begrenzt durch mechanische Faktoren wie z. B. die
                    Haftkraft der Magnetverbindung.

     Spitzendrehmoment, Tp [Nm]:Das Spitzendrehmoment kann für kurze Zeit aufrechterhalten werden, abhängig
                    von den Umgebungsbedingungen und dem gesamten Arbeitszyklus. Dieser Wert kann auch
                    aufgrund der Spezifikationen des Antriebs und der Versorgungsspannung begrenzt sein.
     Spitzenstrom, Ip [Aeff]:Der Spitzenstrom des Motors (effektiver sinusförmiger Wert) ist das Dreifache des
                       Dauerstroms. Der tatsächliche Wert ist der jeweils geringere Wert des Spitzenstroms des
                       Motors oder des Spitzenstroms des verwendeten Antriebs.
     Nenndrehmoment, Trtd [Nm]:Das Nenndrehmoment wird abgegeben, wenn der Motor bei Nenndrehzahl
                   Nennstrom aufnimmt. Das Nenndrehmoment kann im Dauerbetrieb (Nrtd) bei Nenndrehzahl
                   unbegrenzt lange erzeugt werden. Dieser Wert geht von einer Umgebungstemperatur von
                   25 °C aus.
     Drehmomentkonstante, Kt [Nm/Aeff]:Die Drehmomentkonstante gibt an, wie viel Drehmoment der Motor pro
                   Stromeinheit erzeugt. Gemessen bei sowohl bei 25 °C Umgebungstemperatur als auch bei
                   155 °C Wicklungstemperatur.
     Gegen-EMK-Konstante, Ke [Veff/krpm]:Die BEMF-Konstante definiert die induzierte Motor-Gegen-EMK als
                   effektiven sinusförmigen Wert zwischen zwei Klemmen pro 1.000 U/min. Gemessen bei
                   sowohl bei 25 °C Umgebungstemperatur als auch bei 155 °C Wicklungstemperatur.
     Motorkonstante, Km [Nm/√W]:Diese Konstante wird in der Regel verwendet, um die Leistungsdichte von
                      Motoren bei oder nahe dem Stillstand zu vergleichen. Sie gibt an, wie viel Drehmoment der
                      Motor mit einer bestimmten Leistung erzeugen kann. Dieser Wert wird mit dem Kt und dem
                      Widerstand bei 25 °C Wicklungstemperatur angegeben.
     Widerstand, Rm [Ω]:Der Widerstand wird von Leitung zu Leitung und an der Leiterplatte gemessen. Der Wert
                     beinhaltet nicht den Widerstand der Motorleitungen. Der Widerstandswert gilt bei 25 °C und
                     steigt mit der Temperatur der Wicklung.

65    KOLLMORGEN | kdn.kollmorgen.com | June 2023

                                                                                      TBM2G Instructions | 2 Deutsch

Induktivität, L [mH]:Die Induktivität wird von Leitung zu Leitung und an der Leiterplatte gemessen. Dies ist die
                   durchschnittliche Induktivität des Motors in Bezug auf die Rotorposition. Dieser Wert wird bei
                   25 °C Wicklungstemperatur gemessen.
Rotorträgheitsmoment, Jm [kg-cm²]:Das Rotorträgheitsmoment beeinflusst die Winkelbeschleunigung Ihres
                Motors. Dieser Wert gilt nur für Standardkomponenten der Feldbaugruppe (Feldgestell und
                Ringmagnet). Vom Kunden bereitgestellte Komponenten verändern das
                Gesamtträgheitsmoment.
Statische Reibung, Tf [Nm]:Die statische Reibung ist das Drehmoment, das überwunden werden muss, damit
                 sich der Motor dreht. Es ist die Kombination aus den Hystereseverlusten bei niedriger
                 Drehzahl und der Spitze des Rastmoments. Sie beinhaltet keine Lagerverluste im System.
                 Diese Reibung sollte bei der Berechnung der Rotationsverluste des Motors bei Drehzahl nicht
                 berücksichtigt werden.
Wärmewiderstand, Rthw-a [Grad C/Watt]:Der Wärmewiderstand ist ein Maß für den Temperaturanstieg im
               stationären Zustand pro Einheit der durch Verluste abgeleiteten Energie. Dieser Wert setzt
               voraus, dass der TBM2G-Motor in einem Gehäuse untergebracht und auf einem Aluminium-
               Kühlkörper montiert ist, wie auf dem entsprechenden CD-Blatt oder einem gleichwertigen
               Produkt beschrieben.

                                                                   KOLLMORGEN | kdn.kollmorgen.com | June 2023      66

TBM2G Instructions | 2 Deutsch

     Notes

     2 mm divisions

67      KOLLMORGEN | kdn.kollmorgen.com | June 2023

                                                                                         TBM2G Instructions | 3 Español

3 Español

3.1 General

3.1.1 Acerca de este manual
En este manual se describe los motores sin carcasa de TBM2G (versión estándar). Si los motores de TBM2G
funcionan en sistemas de accionamiento junto con Kollmorgen® servocontroladores, consulte la documentación
del sistema completo, formada por:

    l       Manual de instalación para servocontroladores
    l       Manual de comunicación de bus de campo (p. ej., CANopen o EtherCAT)

Puede encontrar más información general en la Red del desarrollador de Kollmorgen, disponible en
kdn.kollmorgen.com.

3.1.2 Abreviaturas usadas

        l   Encontrará las abreviaturas usadas para los datos técnicos en Definición de términos.
        l   En este documento, el símbolo (➜ # 25) se refiere a: consulte la página 25.

                                                                     KOLLMORGEN | kdn.kollmorgen.com | June 2023    68

TBM2G Instructions | 3 Español

     3.1.3 Símbolos usados
                 Símbolo              Indicación

                                      Indica una situación peligrosa que, si no se evita, provocará la muerte o
                                      heridas graves.
                   PELIGRO
                                      Indica una situación peligrosa que, si no se evita, podría provocar la muerte
                                      o heridas graves.
               ADVERTENCIA
                                      Indica una situación peligrosa que, si no se evita, podría provocar heridas
                                      leves o moderadas.
                  ATENCIÓN
                                      Indica situaciones que, si no se evitan, podrían causar daños materiales.

                                      Este símbolo indica notas importantes.

                                      Advertencia de peligro (general). En el texto que aparece junto al símbolo se
                                      especifica el tipo de peligro.

                                      Advertencia de peligro por electricidad y sus efectos.

                                      Advertencia de peligro por superficie caliente.

                                      Advertencia de cargas suspendidas.

69    KOLLMORGEN | kdn.kollmorgen.com | June 2023

                                                                                    TBM2G Instructions | 3 Español

3.1.4 Seguridad
3.1.4.0.1 Notas de seguridad

                 ADVERTENCIA para marcapasos
                 Los potentes campos magnéticos que se producen mientras el rotor magnético no está
                 instalado suponen un peligro para personas con implantes, como marcapasos cardiacos,
                 que podrían verse afectados por los campos magnéticos. Como norma general, todas las
                 personas cuya salud pueda deteriorarse como consecuencia de la influencia de los potentes
                 campos magnéticos debería mantenerse a una distancia de seguridad de al menos 1 metro
                 del rotor.

                 PRECAUCIÓN por campo magnético
                 Los potentes campos magnéticos que se producen suponen un peligro para personas con
                 implantes que podrían verse afectados por los campos magnéticos. Como norma general,
                 todas las personas cuya salud pueda deteriorarse como consecuencia de la influencia de los
                 potentes campos magnéticos debería mantenerse a una distancia de seguridad de al menos
                 1 metro del motor.
                 Las tareas de transporte, instalación, puesta en funcionamiento y mantenimiento solo las
                 deben realizar trabajadores debidamente cualificados. Los trabajadores debidamente
                 cualificados son aquellos que están familiarizados con el transporte, montaje, instalación,
                 puesta en funcionamiento y manejo de los motores, y tienen las cualificaciones necesarias
                 para su trabajo. El personal cualificado debe conocer y cumplir los siguientes estándares y
                 directivas: IEC 60364, 60662 y las normas nacionales de prevención de accidentes.
                 Las recomendaciones incluidas en este documento están destinadas a servir como
                 directrices generales para la instalación y solo deben usarse como referencia.
                 Kollmorgen no asume ninguna responsabilidad por la implementación incorrecta de estas
                 técnicas, que será responsabilidad exclusiva del usuario.

                 PRECAUCIÓN, lleve guantes
                 Lleve siempre guantes cuando trabaje en el motor
                 Lea la documentación disponible antes de realizar la instalación y la puesta en marcha. La
                 manipulación incorrecta de los componentes del motor puede causar heridas y daños a
                 personas y equipos. Se debe tener especial cuidado al instalar el rotor dentro del estátor del
                 motor. Puede que sea necesario utilizar herramientas o accesorios.

                                                                KOLLMORGEN | kdn.kollmorgen.com | June 2023       70

TBM2G Instructions | 3 Español

                       PRECAUCIÓN por campo magnético
                       Los potentes campos magnéticos atraen objetos metálicos y crean posibles riesgos para la
                       seguridad de manos y dedos. Durante el trabajo en o cerca de los motores TBM2G,
                       asegúrese de tener a mano al menos dos cuñas de punta fina de un material resistente y no
                       magnético, por ejemplo, el V2A (con un ángulo de cuña de aprox. 10°-15°) y un martillo no
                       metálico (aprox. 3 kg). En caso de emergencia, podrá utilizar estas herramientas para
                       despegar objetos unidos magnéticamente al rotor magnético (por ejemplo, para liberar
                       partes del cuerpo atrapadas).
                       Mantenga relojes, soportes de registros magnéticos (tarjetas de crédito, disquetes, etc.) y
                       pantallas digitales (teléfonos móviles, ordenadores portátiles, etc.) alejados (> 500 mm) del
                       motor TBM2G. Debido a la potencia de las fuerzas de atracción, deberá tener un cuidado
                       especial dentro de un radio de 50 mm del rotor magnético. En esta zona, no se deberán
                       tener en la mano objetos pesados (> 1 kg) o de grandes proporciones (> 1 dm²) de acero o
                       hierro.
                       Nunca se debe almacenar el rotor sin empaquetar. Utilice materiales de embalaje no
                       magnéticos de un grosor mínimo de 20 mm. El lugar de almacenamiento debe estar seco y
                       protegido del calor. No exponga el rotor del motor a una temperatura superior a 110 °C, a
                       menos que esté instalado dentro del estátor. Las temperaturas superiores a 110 °C pueden
                       desmagnetizar los imanes del rotor.
                       Ponga señales de advertencia en el lugar que se almacenen los motores: Precaución:
                       IMANES POTENTES
                       Ponga señales de advertencia fácilmente visibles (p. ej., etiquetas autoadhesivas) en la
                       máquina. Precaución: los sistemas de esta máquina contienen imanes potentes. CAMPOS
                       MAGNÉTICOS POTENTES + ALTAS FUERZAS DE ATRACCIÓN

                       ¡PELIGRO! Conexión a tierra ¡Altas tensiones!
                       Es obligatorio asegurarse de que las piezas metálicas del estátor del motor estén
                       conectadas correctamente a tierra a través de la barra colectora PE (tierra de protección) en
                       el armario eléctrico. No se puede garantizar la seguridad del personal sin una puesta a tierra
                       de baja resistencia. Consulte la sección Conexión a tierra en las Directrices de montaje e
                       instalación de esta documentación para obtener información más detallada.
                       Las conexiones eléctricas podrían llevar tensión aunque el motor no se mueva. No manipule
                       nunca las conexiones eléctricas de los motores cuando haya tensión presente. En casos
                       desfavorables, esto podría causar la formación de arcos eléctricos y causar heridas y daños
                       a las personas y el equipo.

71    KOLLMORGEN | kdn.kollmorgen.com | June 2023

                                                                                      TBM2G Instructions | 3 Español

3.1.5 Nota importante
¡Se requiere personal especializado!
Solamente se permite al personal cualificado realizar tareas como el transporte, el montaje, la configuración y el
mantenimiento. Los trabajadores cualificados y especializados son personas que están familiarizadas con el
transporte, la instalación, el montaje, la puesta en marcha y el funcionamiento de motores, y que disponen de las
correspondientes calificaciones profesionales.

    l   Transporte: solo por personal con conocimientos en la manipulación de componentes sensibles a la
        electricidad electrostática.
    l   Instalación mecánica: solo por personal con formación mecánica.
    l   Instalación eléctrica: solo por personal con formación en electrotecnia.
    l   Configuración: solo personal cualificado con amplios conocimientos de ingeniería eléctrica y tecnología
        de accionamientos

El personal cualificado debe conocer y cumplir con las normas IEC 60364/IEC 60664 y las normas nacionales de
prevención de accidentes.
¡Lea la documentación!
Lea la documentación disponible antes de realizar la instalación y la puesta en marcha. El manejo inadecuado
del estátor/rotor puede causar daños personales o materiales. Por lo tanto, el operario debe asegurarse de que
todas las personas que deban trabajar con el motor sin carcasa hayan leído y entendido el manual y que
cumplan con las advertencias de seguridad que se incluyen ahí.
¡Preste atención a los datos técnicos!
Respete los datos técnicos y las especificaciones sobre las condiciones de conexión (clasificaciones eléctricas
en Technical Data). Si se superan los valores de tensión permitidos, los motores sin carcasa podrían resultar
dañados, por ejemplo, por sobrecalentamiento.
¡Realice una evaluación de riesgos!
El fabricante de la máquina debe generar una evaluación de riesgos para la máquina y tomar las medidas
apropiadas para asegurar que ningún movimiento imprevisto pueda provocar lesiones a alguien o daños
materiales. De la evaluación de riesgos pueden surgir requisitos adicionales para el personal especializado.

                    ¡PRECAUCIÓN! Superficie caliente
                    Las superficies de los motores TBM2G pueden estar muy calientes durante el
                    funcionamiento, según su categoría de protección. ¡Riesgo de quemaduras leves! La
                    temperatura de la superficie puede superar los 155° C.

                         l   Mida la temperatura y espere a que el motor TBM2G se haya enfriado por debajo de
                             los 40 ºC antes de tocarlo.

                                                                   KOLLMORGEN | kdn.kollmorgen.com | June 2023       72

TBM2G Instructions | 3 Español

                         ¡PELIGRO! Conexión a tierra ¡Altas tensiones!
                         Es fundamental garantizar que el motor TBM2G esté conectado de forma segura a la barra
                         colectora de la puesta a tierra de protección (PE) en el armario de distribución. Riesgo de
                         descargas eléctricas. Sin una puesta a tierra de baja resistencia, no es posible garantizar la
                         protección personal y existe riesgo de muerte por descarga eléctrica.

                              l   No tener monitores ópticos no garantiza la ausencia de tensión. Las conexiones
                                  eléctricas pueden tener tensión aunque el rotor no esté girando.
                              l   No desenchufe ninguna conexión durante el funcionamiento. Si se tocan los
                                  contactos expuestos al exterior, existe riesgo de muerte o de lesión grave. Las
                                  conexiones eléctricas pueden tener corriente cuando el rotor no está girando. Esto
                                  puede provocar descargas disruptivas y resultar en lesiones a las personas y daño a
                                  los contactos.

                              l   Tras desconectar el servomotor de la tensión de entrada, espere varios minutos
                                  antes de tocar los componentes que normalmente tienen corriente (p. ej., contactos,
                                  conexiones con tornillos) o de abrir las conexiones.

                              l   Los condensadores del servomotor aún pueden tener una tensión peligrosa varios
                                  minutos después de desconectar las tensiones de entrada. Para garantizar la
                                  seguridad, mida la tensión de la conexión de CC y espere hasta que la tensión haya
                                  caído por debajo de los 60 V.

     Usar según las indicaciones ("Uso previsto")

         l   Solo se permite usar los motores con las condiciones ambientales que se describen en este documento.
         l   Esta serie de motores está destinada exclusivamente para funcionar por servoaccionamiento.
         l   Los motores se instalan como componentes en máquinas o aparatos eléctricos y solo se pueden poner
             en marcha como componentes integrales de dichas máquinas o aparatos.
         l   El usuario final asume la responsabilidad de que la máquina cumpla estas directrices.

     3.1.6 Uso prohibido
     Se prohíbe el uso de los motores en los siguientes entornos sin consultar con Kollmorgen el servicio al cliente:

         l   áreas potencialmente explosivas
         l   entornos con ácidos conductores corrosivos y/o eléctricos, soluciones alcalinas, aceites, vapores, polvo
         l   vacío
         l   directamente en la red de abastecimiento, red eléctrica

     No se permite poner en marcha el motor si la máquina en la que está instalado

         l   no cumple los requisitos de la Directiva sobre maquinaria de la CE
         l   no cumple con la Directiva sobre compatibilidad electromagnética
         l   no cumple con la Directiva sobre equipos de baja tensión

73    KOLLMORGEN | kdn.kollmorgen.com | June 2023

                                              TBM2G Instructions | 3 Español

3.1.7 Nomenclatura modelo

                            KOLLMORGEN | kdn.kollmorgen.com | June 2023   74

TBM2G Instructions | 3 Español

     3.1.8 Resumen de par de torsión
                               0.72 Nm to 1.75 Nm
       050         0.27 Nm to 0.64 Nm
                                           1.17 Nm to 2.85 Nm
                                                                                      Par máximo
       060            0.45 Nm to 0.96 Nm                                              Par continuo
                               1.53 Nm to 4.13 Nm
       068                  0.63 Nm to 1.54 Nm
                                           2.12 Nm to 5.57 Nm
       076                       0.89 Nm to 2.06 Nm
                                                        3.16 Nm to 7.01 Nm
       085                              1.21 Nm to 2.69 Nm
                                                                      3.75 Nm to 9.01 Nm
       094                                          1.58 Nm to 3.67 Nm
                                                                        3.18 Nm to 15.3 Nm
       115                                   1.90 Nm to 6.03 Nm
             0.0    1.0        2.0         3.0       4.0          5.0     6.0          7.0       8.0      9.0     15.0
                                                           Par de apriete (Nm)

     3.1.9 Diagrama de materiales de componentes
                                                                                 1. Yugo
                                                                                             l  Material: acero inoxidable de la
                                                                                                serie 400
                                                                                 2.    Imán anular
                                                                                             l Material: NdFeB (neodimio)

                                                                                             l Revestimiento: epoxi

                                                                                 3.    Panel de circuito impreso (PCB)
                                                                                 4.    Bobina
                                                                                             l Material: cobre

                                                                                             l Revestimiento: barniz

                                                                                 5.    Aislantes de extremos
                                                                                       Material: resina polimérica
                                                                                 6.    Cables de alimentación
                                                                                 7.    Pila de laminado
                                                                                       Material: acero eléctrico
                                                                                 8.    Dispositivos térmicos opcionales
                                                                                       (instalados bajo el PCB)
                                                                                             l PT1000

                                                                                             l PTC Avalanche (3 en series)

                                                                                 9.    Sensores de hall opcionales
                                                                                       (instalados bajo el PCB)
                                                                                             l Allegro A1260

75    KOLLMORGEN | kdn.kollmorgen.com | June 2023

                                                                                       TBM2G Instructions | 3 Español

3.2 Directrices de almacenamiento, funcionamiento y transporte

3.2.1 Almacenamiento
Categoría climática           1K4 según IEC 60721-3-1, EN61800-2.
Temperatura de                -25 a +55 °C, como máximo variación de 20 °K por hora
almacenamiento
Humedad                       humedad relativa del 5 % al 95 %, sin condensación
Tiempo de                     ilimitado
almacenamiento

Solo almacene motores en el embalaje original del fabricante.

3.2.2 Funcionamiento
Temperatura ambiente          De -20 a +40 °C con altitudes de hasta 1000 m sobre el nivel del mar
(con valores nominales)
Humedad permitida (con        95 % de humedad relativa, sin condensación
valores nominales)
Reducción de potencia         Sin reducción de potencia con altitudes superiores a los 1000 m sobre el nivel del
(corrientes y pares)          mar con reducción de la temperatura de 10 °K/1000 m Debe garantizar que la
                              temperatura de la bobina no supere los 155 °C.

3.2.3 Transporte
Categoría climática           2K3 según EN61800-2, IEC 60721-3-2
Temperatura de                -25 a +70 °C, como máximo variación de 20 °K/hora
almacenamiento
Humedad                       humedad relativa del 5 % al 95 %, sin condensación

Evite las descargas. En caso de que el embalaje esté dañado, compruebe que las piezas del motor no tengan
daños visibles. Informe de ello al transportista y, en caso necesario, al fabricante.

3.2.4 Desembalaje
El conjunto de estátor y rotor se envía normalmente junto en un solo paquete o grupo de paquetes. Hay
disponibles grupos de paquetes personalizados como opción especial. El rotor y el estátor se separan mediante
material de embalaje para que no choquen entre sí como consecuencia de las potentes fuerzas magnéticas.
Durante el desembalaje, tome precauciones para mantener las piezas separadas y evitar que el rotor de alto
magnetismo impacte con otros objetos.
Si lo solicita, el estátor puede contener dispositivos de sensor de Hall. Estos dispositivos son susceptibles a
daños por electricidad estática. Se utilizan bolsas ESD en el envío de estátores con dispositivos de Hall. Durante
el desembalaje, se deberán tomar medidas para continuar la protección ESD.

                                                                   KOLLMORGEN | kdn.kollmorgen.com | June 2023       76

TBM2G Instructions | 3 Español

     3.3 Directrices de instalación y montaje

      Las recomendaciones incluidas en este Kollmorgen manual están destinadas a servir como directrices
      generales para la instalación y solo debes usarse como referencia. Kollmorgen no asume ninguna
      responsabilidad por la implementación incorrecta de estas técnicas, que será responsabilidad exclusiva del
      usuario.

     3.3.1 Definiciones de Conjunto de campo y armazón
     Conjunto del armazón (estátor)
     El conjunto del armazón es la parte fija del motor sin carcasa. Este conjunto está formado por laminaciones de
     acero magnético, bobinas y el conjunto de cables conductores. También contiene opciones adicionales, como
     los dispositivos de Hall y los sensores térmicos.
     Conjunto de campo (rotor)
     El conjunto del campo es la parte móvil del motor sin carcasa. Este conjunto está formado por un imán anular de
     tierras raras y un barzón.
     Motor sin carcasa (conjunto)
     Un motor fabricado y enviado en partes separadas: estátor y rotor. Las partes individuales pueden montarse en
     una carcasa, eje y sistema de rodamiento fabricado por el usuario final.

77    KOLLMORGEN | kdn.kollmorgen.com | June 2023

                                                                                        TBM2G Instructions | 3 Español

3.3.2 Responsabilidades de la interfaz de usuario
Para garantizar un rendimiento y fiabilidad correctos para el motor una vez instalado en el sistema, el usuario
será responsable de diseñar la interfaz de montaje usando la siguiente información como directriz. El usuario es
responsable de diseñar el eje del motor, carcasa para el estátor, sistema de rodamiento, los detalles del diseño
de la carcasa, la selección de material, los cálculos de ajuste y los análisis de tolerancia según las necesidades
de la aplicación prevista.

3.3.2.1 Rodamientos
El sistema de rodamiento suministrado por el usuario en la aplicación del motor debe demostrar tener suficiente
rigidez para mantener una holgura uniforme y firme entre el rotor y el estátor en cualquier condición de
funcionamiento. Una holgura uniforme incluye límites de desviaciones y concentricidad entre el rotor y el estátor.

3.3.2.2 Materiales de montaje del estátor
Se sugiere el uso de una carcasa metálica o estructura de abrazaderas para montar firmemente el estátor para
garantizar la mejor ruta conductora del disipador térmico y una buena integridad estructural. Se recomiendan las
aleaciones de aluminio por su mejor conductividad térmica y relación entre fuerza y peso, aunque las aleaciones
de acero inoxidable (serie 300 o equivalente) son una alternativa válida para aplicaciones con menos requisitos
térmicos. El acero al carbono, el hierro fundido, las aleaciones inoxidables de la serie 400 y otros metales
ferrosos que conduzcan el flujo magnético son las opciones menos recomendadas para el montaje del estátor.
Consulte con un ingeniero de Kollmorgen para recibir asistencia si utiliza estos metales. No utilice plásticos u
otros materiales aislantes térmicamente similares, ya que afectan negativamente a la capacidad del disipador
térmico del sistema y hacen que sea necesario reducir drásticamente el rendimiento del motor.

3.3.2.3 Materiales de montaje del rotor
El rotor magnetizado puede instalarse en cualquier eje metálico que elija el usuario. El acero al carbono y el
acero inoxidable son los materiales más utilizados en los ejes, aunque en ocasiones se utilizan aleaciones de
aluminio cuando están diseñadas correctamente para el par de torsión y rango operativo térmico previstos. El
método utilizado para fijar el rotor al eje puede influir en cuál sea el material ideal y en las elecciones de
tolerancia para el eje. El eje no necesita soportar el flujo o el funcionamiento como parte del circuito magnético
para alcanzar el rendimiento nominal con un motor sin escobillas de Kollmorgen.

3.3.2.4 Conexión a tierra
       Cuando está instalada en la aplicación, la pila laminada (o el revestimiento externo de metal expuesto)
       del estátor debe estar en el mismo potencial de tierra eléctrica que el chasis del sistema y el chasis del
       servocontrolador. Si no garantiza esta ruta a tierra en común, la aplicación podría producir un sonido
       eléctrico y supone un riesgo de descarga eléctrica. El riesgo de descarga está especialmente presente
       cuando se utilizan motores con un alto número de polos y alta capacitancia. Normalmente, si el estátor se
       ha instalado con componentes metálicos conductores de la electricidad se habrá conseguido una ruta de
       tierra sólida entre la pila de laminado del estátor y el chasis de la máquina. Kollmorgen recomienda
       comprobar la continuidad para confirmar que la ruta a tierra es correcta antes de encender el sistema de
       motores. En algunas aplicaciones, dependiendo de la configuración de montaje y los materiales
       elegidos, podría ser necesario utilizar un cable de tierra conductor independiente. En estos casos, el
       usuario es el responsable de la instalación de la ruta a tierra y de la comprobación eléctrica.

                                                                    KOLLMORGEN | kdn.kollmorgen.com | June 2023      78

TBM2G Instructions | 3 Español

     3.3.2.5 Instrucciones básicas de montaje
                          La serie TBM2G de Kollmorgen y otros motores sin carcasa ni escobillas
                          utilizan imanes de tierras raras de alto rendimiento. Tenga extremo cuidado
                          durante el manejo o el transporte para evitar heridas o daños al producto.
                          Las fuerzas de atracción entre rotores magnetizados y los objetos metálicos
                          cercanos pueden ser extremadamente potentes. Un manejo inadecuado
                          puede ocasionar impactos repentinos inesperados. El potente campo
                          magnético también puede dañar ordenadores, pantallas y dispositivos de
                          almacenamiento de memoria cercanos. Mantenga el rotor en su embalaje de
                          envío o envuelto para su protección hasta que se vaya a instalar. Esta
                          práctica ayudará a evitar accidentes y prevenir la contaminación como, por
                          ejemplo, de virutas metálicas y residuos que tienden a pegarse a los imanes.

     A continuación encontrará un proceso de montaje genérico que puede seguir para insertar un rotor (conjunto de
     campo) en un estátor (conjunto del armazón)

      1. Monte la carcasa del cliente con seguridad en una superficie estable para evitar cualquier movimiento
         repentino.
      2. Deslice el estátor dentro de la carcasa y fíjelo conectando o sujetando el estátor como se muestra en las
         Prácticas de montaje del estátor.
      3. Deslice el rotor en el eje del cliente y fíjelo conectando o sujetando el rotor como se muestra en las Prácticas
         de montaje del estátor.

          Los imanes de tierras raras pueden agrietarse y astillarse. Tenga cuidado de que el imán no se caiga y
          evite los impactos con otras superficies al montar el rotor en el eje.
      4. Antes de insertar el conjunto de rotor/eje en el conjunto de estátor/carcasa, Kollmorgen recomienda instalar
         primero una fina capa de material de compensación, como las láminas Mylar®, en el orificio interior del
         estátor.
             l Se puede instalar una lámina Mylar en una sola pieza enrollada completamente alrededor de la

                circunferencia del orificio del estátor o en varias piezas insertadas axialmente separadas
                uniformemente. El grosor óptimo de la lámina y el número de láminas necesarias dependerá del
                espacio libre entre el rotor y el estátor para el tamaño de motor específico que el usuario desea
                instalar. Consulte el gráfico de Espacio libre para recorrido radial como referencia.

                  Cuando el usuario intente instalar el rotor, la superficie exterior de este podría adherirse a punto más
                  cercano del orificio interior del estátor debido a las fuerzas magnéticas. La fricción resultante al
                  deslizar el rotor dentro del estátor podría dañar la banda, imanes o revestimiento del rotor o la
                  superficie del orificio del estátor.
      5. Inserte el rotor lenta y suavemente a lo largo de la línea axial central para colocar el rotor dentro del estátor.
         Puede hacerlo a mano o con un accesorio de instalación personalizado.
      6. Instale los rodamientos necesarios en el conjunto del rotor para mantener la alineación del eje antes de
         retirar las láminas de compensación.
      7. Retire el material de compensación del hueco de aire entre el rotor y el estátor antes de ponerlo en
         funcionamiento.

79    KOLLMORGEN | kdn.kollmorgen.com | June 2023

                                                                                     TBM2G Instructions | 3 Español

Espacio libre recorrido radial típico
                             Tamaño de carcasa TBM2G
                             050        060        068         076         085         094         115
 Hueco          mm           0,26       0,29       0,26        0,26        0,26        0,26        0,40
 mecánico
 nominal        pulg.        0,010      0,011      0,010       0,010       0,010       0,010       0,016

 El usuario deberá tener en cuenta los requisitos de concentricidad indicados en cada diagrama de Kollmorgen
 específico de su modelo. Seleccione rodamientos con la menor fricción posible y lubricante de alta calidad
 para minimizar la fricción en el sistema en general, lo que hará posible que el motor funcione perfectamente.

                                                                 KOLLMORGEN | kdn.kollmorgen.com | June 2023     80

TBM2G Instructions | 3 Español

     3.3.3 Prácticas de montaje del estátor
     Kollmorgen sugiere las siguientes opciones para instalar el estátor del motor dependiendo del par de torsión, la
     vibración y las características térmicas de la aplicación, así como el coste, la facilidad de montaje y
     mantenimiento que desee el usuario.

     3.3.3.1 Conexión del estátor

      Se deben limpiar las superficies del estátor y la carcasa cuidadosamente antes de la conexión para garantizar
      una buena adhesión. Consulte la hoja de datos del adhesivo que vaya a utilizar para ver las técnicas de
      limpieza según el material de la carcasa.

     En la mayoría de los casos, los motores del rango de par máximo general de hasta 2400 Nm pueden tener el
     estátor conectado con resina epoxi estructural, como la Scotch-Weld™ 2214 de 3M™ u otros adhesivos
     similares. La conexión es la técnica de instalación permanente recomendada para todos los estátores TBM2G.
     Como se muestra en las ilustraciones de la conexión del estátor, para utilizar el adhesivo correctamente la
     carcasa del estátor debe tener forma de vaso cilíndrico, con un pequeño hombro para la posición axial en un
     extremo y abierto en el otro. El hombro sirve como punto de parada en el que el estátor puede apoyarse cuando
     se inserta desde el extremo abierto y, por lo general, debe dejar libre el diámetro exterior máximo de la última
     vuelta del bobinado como se indica en el diagrama. Es necesario relieves de esquina para que se adapte a las
     curvas cerradas de las laminaciones del estátor. Un pequeño chaflán interno en el extremo abierto del vaso de la
     carcasa facilita la inserción del estátor. Si se realizan los procedimientos de montaje con la carcasa del estátor
     acostada [axis de rotación vertical], la presión hidrostática del adhesivo estructural ayudará al estátor a
     centrarse por sí solo en su carcasa.
                                                                           1.   Rodamiento del cliente
                                                                           2.   Carcasa del cliente
                                                                           3.   Retroacoplamiento del cliente
                                                                           4.   Estátor TBM2G

                        TOPE DE PROFUNDIDAD                                     0.025 MM [0.010 IN.] MIN.
                                                                                SEPARACIÓN DE TODAS LAS
                                                        RANURAS DEL             JUNTAS DE SOLDADURA
                              EL AISLANTE PUEDE          DEPÓSITO DE
                           TOCAR LA CARCASA EN             ADHESIVO               0.13 - 0.26 MM [0.006 - 0.010 IN.]
                                   ESTE EXTREMO                                   RANURA ADHESIVA ADICIONAL
                                                                                  50+% DE LA SUPERFICIE

                                                                                       0.025/0.050 MM
                                                                                       SEPARACIÓN NOMINAL
                                                                                       (RADIAL) POR LADO

                                                                            EPOXI ESTRUCTURAL RECOMENDADO:
                                                                            3M SCOTCHWELD 2214
                                                                            HYSOL EA934NA

              Figure 6-1: Ilustraciones de la conexión del estátor

81    KOLLMORGEN | kdn.kollmorgen.com | June 2023

                                                                                          TBM2G Instructions | 3 Español

La temperatura extrema puede crear un posible problema debido a los coeficientes de expansión desiguales
[p. ej., laminaciones de acero VS carcasa de aluminio]. El usuario debe consultar al fabricante del adhesivo para
recibir instrucciones sobre el grosor correcto de la línea de unión, el proceso de aplicación y el secado. Las
ranuras del diámetro interior de la carcasa que aparecen en las ilustraciones de la conexión del estátor sirven
como depósitos de adhesivo para que la gruesa capa de resina epoxi estructural ofrezca una gran fuerza de
torsión en un amplio rango de temperaturas. Si utiliza una capa gruesa de epoxi, el diámetro interior del vaso de
la carcasa debería ser aproximadamente 0,05 mm - 0,1 mm mayor que el diámetro exterior máximo del estátor
Cuando se usa de la forma recomendada por el fabricante, estos agentes de unión ofrecen una fuerza y
duración excelentes con el paso del tiempo.
Si se prefiere un compuesto de retención, como el LOCTITE® 640™ u otro adhesivo similar, a la resina epoxi
estructural, deberá vigilar que el espacio libre entre el diámetro interior de la carcasa y el diámetro exterior del
estátor sea más reducido para mantener un grosor adecuado de la línea de unión. Consulte las directrices del
fabricante del adhesivo para ver sus recomendaciones.

El usuario asume la responsabilidad de seleccionar un adhesivo adecuado y de diseñar una carcasa con
dimensiones basadas en el ritmo de aumento térmico esperado para las temperaturas extremas previstas de la
aplicación. La temperatura de secado del adhesivo no puede superar los 155 °C para evitar daña el estátor del
motor.

                                                                      KOLLMORGEN | kdn.kollmorgen.com | June 2023      82

TBM2G Instructions | 3 Español

     3.3.3.2 Sujeción del estátor
     Para aplicaciones en las pueda ser necesario instalar y retirar el estátor del sistema repetidamente, la sujeción
     axial puede ser una opción aceptable. Kollmorgen no recomienda esta técnica por lo general para aplicaciones
     con muchos choques y vibraciones ni para aplicaciones con temperaturas extremas sin prestar especial
     atención al diseño. La carcasa del estátor que se muestra en la siguiente ilustración es muy similar a la técnica
     de unión por epoxi. Cuando utilice la técnica de sujeción para montar el estátor, el diámetro interior del vaso de
     la carcasa debe ser aproximadamente 0,025 mm - 0,050 mm mayor que el diámetro máximo exterior del estátor.
     Si así lo desea, el espacio radial pequeño entre el diámetro exterior del estátor y el diámetro interior de la
     carcasa puede llenarse con un compuesto térmico para una conducción más eficiente hacia el disipador térmico.

      Tenga cuidado para evitar contaminar las superficies de unión axial con grasas que podrían reducir la fricción
      de la fijación.

     La función de hombro mecanizado sirve como punto de parada y ubicación contra el que puede apoyarse el
     estátor cuando sea necesario insertarlo. Se requiere un anillo abrazadera distinto en el extremo opuesto del
     estátor, atornillado en la carcasa con entre 4 y 12 sujeciones separadas uniformemente. Con las dimensiones
     proporcionadas en el diagrama, maximice la superficie de sujeción. Esto minimizará la tensión que la sujeción
     ejerce en el estátor. Diseñe la profundidad de perforación en la carcasa para asegurar que el anillo de sujeción
     esté en contacto con el núcleo del estátor antes de entrar en contacto con la carcasa con cualquier tolerancia y
     condición de temperatura. Sujetarlo en la superficie de la carcasa antes que en el estátor hará que la fuerza de
     sujeción no sea suficiente. Consulte el diagrama para ver las tolerancias del estátor. Las presiones de sujeción
     dependen del área de la superficie y de la fuerza de sujeción. La presión de sujeción debe estar en el rango de 5
     a 20 Mpa (de 725 psi a 2900 psi). Deberá tomar medidas para evitar presiones de sujeción excesivas. Las
     presiones extremas causarán mayores pérdidas en el núcleo al funcionar a velocidades de giro altas. También
     deberá garantizar que haya suficiente precarga en los tornillos de apriete. Esto, junto con locker de rosca
     extraíble, ayudará a evitar que los tornillos de apriete se aflojen tras un amplio uso.
                                                                                         1. Carcasa del cliente
                                                                                         2. Estátor TBM2G
                                                                                         3. Anillo de sujeción del
                                                                                            estátor

                                                                      EL ANILLO DE LA ABRAZADERA
                                                                      NECESITA TENER UN HUECO DETRÁS
                          TOPE DE PROFUNDIDAD                         PARA PERMITIR LA COMPRESIÓN DEL
                                                                      HOMBRO DEL ESTATOR

                              EL AISLANTE PUEDE                           0.012/0.025 MM SEPARACIÓN
                           TOCAR LA CARCASA EN                            NOMINAL (RADIAL) POR LADO
                                   ESTE EXTREMO

                                                                         EL ANILLO DE SUJECIÓN CON
                                                                         PERNOS DEBE ENGRANAR AL
                                                                         MENOS EN LA MITAD DEL
                                                                         HOMBRO DEL ESTATOR

              Figure 6-2: Ilustraciones de la sujeción del estátor

83    KOLLMORGEN | kdn.kollmorgen.com | June 2023

                                                                         TBM2G Instructions | 3 Español

3.3.4 Prácticas de montaje del rotor
                La serie TBM2G de Kollmorgen y otros motores sin carcasa ni escobillas
                utilizan imanes de tierras raras de alto rendimiento. Tenga extremo cuidado
                durante el manejo o el transporte para evitar heridas o daños al producto.
                Las fuerzas de atracción entre rotores magnetizados y los objetos metálicos
                cercanos pueden ser extremadamente potentes. Un manejo inadecuado
                puede ocasionar impactos repentinos inesperados. El potente campo
                magnético también puede dañar ordenadores, pantallas y dispositivos de
                almacenamiento de memoria cercanos. Mantenga el rotor en su embalaje de
                envío o envuelto para su protección hasta que se vaya a instalar. Esta
                práctica ayudará a evitar accidentes y prevenir la contaminación como, por
                ejemplo, de virutas metálicas y residuos que tienden a pegarse a los imanes.

3.3.4.1 Control de la desviación radial
                Los diagramas específicos para el modelo de Kollmorgen indican el requisito
                de montaje relacionado con la desviación del diámetro interior del rotor o el
                diámetro exterior del estátor. La flecha representa requisito de desviación
                del diámetro exterior del eje al diámetro interior de la carcasa. El usuario es
                responsable de diseñar el eje, la carcasa y el sistema de rodamiento para
                que se adapte al límite de desviación especificado entre el diámetro exterior
                de la superficie de unión del eje y el diámetro interior de la superficie de
                unión de la carcasa. Si se sigue, la concentricidad general del diámetro
                exterior del rotor al diámetro interior del estátor debería estar dentro de lo
                permitido.

                                                       KOLLMORGEN | kdn.kollmorgen.com | June 2023   84

TBM2G Instructions | 3 Español

     3.3.4.2 Conexión del rotor

      Se deben limpiar las superficies del estátor y la carcasa cuidadosamente antes de la conexión para garantizar
      una buena adhesión. Consulte la hoja de datos del adhesivo que vaya a utilizar para ver las técnicas de
      limpieza según el material de la carcasa.

     Normalmente, en aplicaciones en las que el par de torsión máximo no supere los 750 Nm, los rotores pueden
     conectarse a ejes de acero al carbono o de acero inoxidable. Los compuestos de retención, como el LOCTITE®
     640™ u otros adhesivos similares, normalmente requieren diámetros de interfaz continuos y uniformes y
     tolerancias de ajuste reducidas, como huecos nominales de entre 0,012 mm y 0,025 mm. Las resinas epoxi
     estructurales requieren una holgura de ajuste ligeramente mayor para permitir el uso de una línea de unión más
     gruesa. Las resinas epoxi funcionan mejor en interfaces de eje/rotor con ranuras que sirvan como depósitos de
     adhesivo. Se puede mejorar su efectividad con superficies mecanizadas con texturas mediante moleteado o
     limpieza por arena a presión. Consulte con el fabricante del adhesivo para recibir directrices sobre el grosor
     correcto de la línea de unión, las tolerancias de ajuste, detalles del proceso y secado.
     Para evitar la desmagnetización parcial del rotor, no seque las uniones del rotor/eje a temperaturas superiores a
     110 °C a menos que el rotor se encuentre dentro del estátor correspondiente o el rotor esté completamente
     envuelto en un elemento "conservador" de metal ferroso. Póngase en contacto con un ingeniero de Kollmorgen
     si necesita más información sobre este tema. Antes de unir los rotores a los ejes de aluminio, consulte al
     fabricante del adhesivo para recibir ayuda. Es posible que necesite un adhesivo muy flexible con propiedades
     térmicas más amplias.
                                                                            1. Eje del cliente
                                                                            2. Rotor de conjunto de campo TBM2G

                                                                        MONTAJE DE CAMPO

                                                                              0.012/0.025 MM SEPARACIÓN
                                                                              NOMINAL (RADIAL) POR LADO

                                   PROFUNDIDAD                              EJE DEL CLIENTE
                                   DE AJUSTE AL
                                   HOMBRO

              Figure 6-3: Ilustraciones de la unión del rotor

85    KOLLMORGEN | kdn.kollmorgen.com | June 2023

                                                                                     TBM2G Instructions | 3 Español

3.3.5 Prácticas de montaje axial

3.3.5.1 Control de alineación axial
Los diagramas específicos para el modelo de Kollmorgen indican la alineación axial que debe mantenerse entre
el rotor y el estátor durante el montaje para garantizar el buen funcionamiento del motor. El usuario es
responsable de diseñar el eje del motor, la carcasa para el estátor y el sistema de rodamiento para conseguir la
alineación de montaje especificada. Las formas más comunes de controlar la posición de la instalación del rotor
son los hombros mecanizados en el eje o las ranuras para anillos de retención. El diámetro máximo de los
anillos de retención o los hombros del eje debe mantenerse por debajo del diámetro del rotor cuando los imanes
están unidos al cubo de acero.

                                                                  KOLLMORGEN | kdn.kollmorgen.com | June 2023      86

TBM2G Instructions | 3 Español

     3.3.6 Montaje axial
     Para garantizar el pleno rendimiento y la activación correcta de los dispositivos de Hall, Kollmorgen especifica
     una dimensión de montaje entre el borde de la pila de laminación y el borde del barzón [Kollmorgen].
     Esta dimensión de montaje garantiza que el material magnético cubra totalmente la pila de laminación y se
     extienda axialmente para activar los dispositivos de Hall, si corresponde.
                                            "A"
                                           MAX.
                                                      MONTAJE DEL INDUCIDO
                                           "B"
                                                          3.00 [0.118] MAX.
                 4.70 [0.185] MAX                         SOBRE SOLDAR Y CALENTAR ESTACA
                                                          VER NOTA 3
                                                                            A

                                                                                                       ANILLO YOKE
                MONTAJE DE
                   CAMPO
                                                          2X 30°

     Ø 91.13 [3.588]
         MAX.
                                                         2X 0.50
                                                         [0.020]
                                                         CÁMARA
                                 "C"
                                                                         Ø93.96 - 94.04
                 Ø46.98 - 47.02                                           [3.700 - 3.702]
                  [1.850 - 1.851]
                    0.07 [0.003] A
                 REQUISITO DE
                   MONTAJE
                                                               Ø92.33
                                                               [3.635]
                                                                MAX

                                                                                                0.70±0.40 [0.028±0.015]
                                                                                                MTG DIM
              0.70±0.40 [0.028±0.015]
                           MTG DIM                    ESQUINA AFILADA EN AMBOS LADOS.
                                                      SE REQUIERE UN REBAJE EN LOS
                                                      COMPONENTES DE ACOPLAMIENTO
                                        SECCIÓN A-A

                       Figure 6-4: Ilustración de dimensiones de montaje mostradas en un diagrama TBM2G-068XXX-XXXX-00. Esta
                       dimensión se mide desde el borde izquierdo de la pila de laminado hasta el borde izquierdo del material del yugo
                       (no magnético).

     Si desea establecer la Dimensión de montaje alternativa desde el otro lado de la pila de laminado, el valor
     nominal podrá calcularse usando ciertos parámetros del diagrama. Para calcular el valor nominal desde el borde
     derecho de la pila de laminado hasta el borde derecho del material del yugo, utilice la siguiente ecuación:
                        Dimensión de montaje alternativa (mm, nominal) = “C” – “B” – 0,70 mm

87     KOLLMORGEN | kdn.kollmorgen.com | June 2023

                                                                                       TBM2G Instructions | 3 Español

Para ofrecer un ejemplo de cálculo de la Dimensión de montaje alternativa usaremos:

    l   Las dimensiones de TBM2G-06813-00 del diagrama TBM2G-068XXX-XXXX-00 en "Ilustración de
        dimensiones de montaje mostradas en un diagrama TBM2G-068XXX-XXXX-00. Esta dimensión se mide
        desde el borde izquierdo de la pila de laminado hasta el borde izquierdo del material del yugo (no
        magnético)." (➜ p. 87).
    l   La ecuación para la Dimensión de montaje alternativa.
    l   Una tabla del diagrama TBM2G-068 que indique los valores “B” y “C”, mostrados en "Tabla para los
        valores “A” MAX, “B” y “C” sacados del diagrama TBM2G-068XXX-XXXX-00." (➜ p. 88).

        Stack Specific Dimensional Data
         Part Number          "A" Max      "B" REF ±0.35 [0.014] “C” ±0.08 [0.004]
         TBM2G-06808-00 18.34 [0.722]             8.2 [0.323]          14.76 [0.581]

         TBM2G-06813-00 22.84 [0.899]           12.70 [0.500]          19.26 [0.758]

         TBM2G-06826-00 36.44 [1.435]           26.30 [1.035]          32.86 [1.294]

                Figure 6-5: Tabla para los valores “A” MAX, “B” y “C” sacados del diagrama TBM2G-068XXX-XXXX-00.

Ejemplo:
Para TBM2G-06813-00, “B” = 12,7 mm nominal y “C” = 19,26 mm nominal. La dimensión de montaje original,
0,70 mm nominal, ya aparece en el diagrama. Usando la ecuación, calcularemos lo siguiente:
           Dimensión de montaje alternativa (mm) = 19,26 mm – 12,7 mm – 0,70 mm =
           5,86 mm nominal

                                                                   KOLLMORGEN | kdn.kollmorgen.com | June 2023     88

TBM2G Instructions | 3 Español

     3.3.7 Interfaz del cableado eléctrico

     3.3.7.1 Cableado
     La serie TBM2G de motores puede suministrarse con cables conductores aéreos sin finalizar y compatible con
     UL. El usuario es responsable de tender y conectar el cable conductor correctamente siguiendo los diagramas
     de Kollmorgen. Evite pasar los cables por esquinas cerradas, puntos de enganche o bordes que puedan perforar
     el aislamiento. Sujete o fije de otra manera los cables para las aplicaciones con altas vibraciones y evite que las
     cables entren en contacto con las superficies en movimiento o vibratorias que puedan desgastar el aislamiento.
     Asegúrese de que todos los cables puedan descargar su presión y deje espacio para un radio de flexión amplio.
     Es usuario asume la responsabilidad de instalar el conector, comprimir, soldar, blindar, poner una cubierta a
     cualquier otro conjunto de cables o mejora de la interfaz eléctrica más allá de la configuración que aparece en el
     diagrama de TBM2G.

     3.3.7.2 Requisitos del cable conductor (opción sin cable)
     Recomendaciones/directrices para soldar el cable conductor en la almohadilla.

     3.3.7.3 Especificaciones generales y tendido de los cables de alimentación
     ESPECIFICACIONES GENERALES DE LOS CABLES DE ALIMENTACIÓN
      Motor                       TBM2G-       TBM2G-      TBMG-       TBM2G-      TBM2G-       TBM2G-       TBM2G-
                                    050          060        068          076         085          094          115
      Tipo                                                         3 conectores aéreos
      Longitud, mm*                                                       500
      Calibrador de alambres,        20           20          20          18             16        14           14
      AWG
      Diámetro de aislante          1,47         1,47        1,47        1,70        1,98         2,26         2,26
      nominal, mm
      Mín. Radio de flexión         7,37         7,37        7,37        8,51        9,91         11,3         11,3
      estática, mm

     *Versión sin cable opcional (solo superficie de soldadura)

     INTERFAZ ELÉCTRICA DE LOS CABLES DE
     ALIMENTACIÓN
      Color                Función (alter.)
      Rojo                 Fase U (A)
      Blanco               Fase V (B)
      Negro                Fase W (C)

89    KOLLMORGEN | kdn.kollmorgen.com | June 2023

                                                                                   TBM2G Instructions | 3 Español

GRÁFICO DE EXCITACIÓN DE LOS CABLES DE ALIMENTACIÓN
PASO             Fase "U" roja    Fase "V" blanca Fase "W" negra
1
                        ⊕                ⊖
2
                        ⊕                                    ⊖
3
                                         ⊕                   ⊖
4
                        ⊖                ⊕
5
                        ⊖                                    ⊕
6
                                         ⊖                   ⊕
Rotación CW vista desde el PCX/extremo de salida del cable

                                                                 KOLLMORGEN | kdn.kollmorgen.com | June 2023   90

TBM2G Instructions | 3 Español

     3.3.7.4 Especificaciones generales y cableado del dispositivo térmico
     Pueden montarse termistores integrales en el PCBA para ofrecer un funcionamiento continuo y seguro de los
     motores de la serie TBM2G en las aplicaciones más exigentes. La opción más habitual para el TBM2G es un
     PT1000 RTD. Como alternativa, se pueden conectar tres dispositivos PTC en serie, uno en la bobina de cada
     fase ofrecerá protección a cada fase.

     ESPECIFICACIONES GENERALES DE LOS CABLES TÉRMICOS
      Motor                      TBM2G-      TBM2G-      TBM2G-        TBM2G-     TBM2G-      TBM2G-      TBM2G-
                                   050         060         068           076        085         094         115
      Tipo                                                        2 conectores aéreos
      Longitud, mm*                                                      500
      Calibrador de                 26          26           26           26            26       26          26
      alambres, AWG
      Diámetro de aislante         0,99        0,99         0,99         0,99       0,99        0,99        0,99
      nominal, mm
      Mín. Radio de flexión        4,95        4,95         4,95         4,95       4,95        4,95        4,95
      estática, mm

     *Versión sin cable opcional (solo superficie de soldadura)

     INTERFAZ ELÉCTRICA DE LOS CABLES TÉRMICOS
      Color               Función (alter.)
      Blanco              Sensor térmico +
      Blanco              Sensor térmico -

     3.3.7.4.1 Protección térmica
     Existen dos métodos de protección térmica para el funcionamiento continuo. El primer método permite medir
     continuamente la temperatura del motor usando un PT1000. La temperatura del motor se determina midiendo la
     resistencia del PT1000 por IEC-60751 (consulte el siguiente gráfico). Puesto que solo puede usarse un
     dispositivo, este método solo puede supervisar una de las fases del motor. Por lo tanto, no se recomienda para
     aplicaciones en las que el motor va a estar bloqueado durante un largo período.
     El segundo método utiliza tres PTC Avalanche en serie. Hay un PTC para supervisar cada una de las tres fases
     y asegurarse de que ninguna sobrepase la temperatura nominal del motor. Se debe elegir esta opción si el motor
     va a estar bloqueado durante un largo período de tiempo. Durante el funcionamiento normal, la resistencia de
     los dispositivos estará por debajo de los 1500 ohmios. Cuando una de las fases alcance los 155 °C, la
     resistencia aumentará rápidamente y sobrepasará los 7000 ohmios.
     Ninguno de estos métodos protege al motor del sobrecalentamiento cuando se aplica corriente por encima de la
     capacidad continua. Los dispositivos térmicos no pueden reaccionar a una velocidad suficiente para acomodar
     el cambio de temperatura que se produce al aplicar la corriente máxima. El sistema debe limitar el tiempo que se
     aplica la corriente máxima al motor para evitar que se sobrecaliente.

91    KOLLMORGEN | kdn.kollmorgen.com | June 2023

                                                                                                                         TBM2G Instructions | 3 Español

                                         PT1000 Resistencia en función de la temperatura
                        1800

                        1600
                        1400
Resistencia en ohmios

                        1200
                        1000

                         800

                         600

                         400
                         200

                           0
                               0    20      40    60         80   100 120 140       160    180   200
                                                            Temperatura en ˚C

                                   15

Esta opción solo tiene PT1000 en serie y producirá la misma salida que aparece en el gráfico anterior.

                                         Resistencia en serie PTC-3 frente a temperatura
100,000

        50,000
Resistencia en ohmios

                        10K

                         5K

                        1000
                               0    20       40        60      80    100     120   140    160    180
                                                            Temperatura en ˚C

                                   15$                        15$                   15$

Esta opción tiene tres PTC en serie en tres fases distintas. Si una de las fases se acerca a la temperatura del
motor, la resistencia aumentará drásticamente.

                                                                                                       KOLLMORGEN | kdn.kollmorgen.com | June 2023   92

TBM2G Instructions | 3 Español

     3.3.7.5 Especificaciones generales y cableado del dispositivo sensor de Hall
     ESPECIFICACIONES GENERALES DEL DISPOSITIVO SENSOR DE HALL
      Motor                                   TBM2G-          TBM2G-            TBMG-        TBM2G-        TBM2G-   TBM2G-   TBM2G-
                                                050             060              068           076           085      094      115
      Tipo                                                                    5 conectores aéreos, Allegro A1260
      Tensión de entrada,                                                                    de +5 a 24
      V CC
      Señal de salida                                                                       Tipo hundido
      Longitud, mm*                                                                             500
      Calibrador de alambres,                      26               26               26         26           26       26       26
      AWG
      Diámetro de aislante                     0,99                 0,99             0,99      0,99         0,99     0,99     0,99
      nominal, mm
      Mín. Radio de flexión                    4,95                 4,95             4,95      4,95         4,95     4,95     4,95
      estática, mm

     *Versión sin cable opcional (solo superficie de soldadura)

     INTERFAZ ELÉCTRICA DE LOS CABLES DEL
     SENSOR DE HALL
      Color                         Función (alter.)
      Marrón                        Hall 1 (U-V)
      Naranja                       Hall 2 (V-W)
      Amarillo                      Hall 3 (W-U)
      Azul                          de +5 a 24 V CC
      Verde                         Conexión a tierra

     Diagrama del cableado del sensor
                     R = 1.5 kΩ (Suministrado por el cliente)
                                                                           AZUL
                     R                   R                     R      (+5 TO 24 V DC)

      H                   H                    H
          1                   2                    3
              MARRÓN              NARANJA               AMARILLO
                SALIDA              SALIDA                SALIDA
              FASE - UV           FASE - VW             FASE - WU
                                                                            VERDE
                                                                           (SUELO)

93    KOLLMORGEN | kdn.kollmorgen.com | June 2023

                                                                                                               TBM2G Instructions | 3 Español

Diagrama de salida del sensor
Fase U, V, W para rotación CW vista en PCB/extremo de salida del cable

  VOLTIOS
                    1          2          3          4          5          6

               Bemf U-V

     5
H1                                                                               EN FASE CON Bemf U-V
     0                               Bemf V-W

     5
H2                                                                               EN FASE CON Bemf V-W
     0                                                     Bemf W-U

     5
H3                                                                               EN FASE CON Bemf W-U
     0
              60˚                  180˚                  300˚                  420˚
         0˚             120˚                  240˚                  360˚
              GRADOS ELÉCTRICOS (RELATIVOS)

                                                                                             KOLLMORGEN | kdn.kollmorgen.com | June 2023   94

TBM2G Instructions | 3 Español

     3.4 Definición de los términos de Datos técnicos
     Par de calado continuo máximo, Tmc [Nm]:El par de calado continuo máximo se puede mantener de forma
                      indefinida a velocidad baja y en condiciones ambientales nominales. Podría producirse una
                      reducción adicional si la velocidad no es lo suficientemente alta como para producir una
                      distribución del calor homogénea en todas las fases. Este valor supone una temperatura
                      ambiente de 25 °C.
     Corriente continua máxima, Imc [Arms]:La corriente continua máxima es la corriente sinusoidal efectiva que el
                       motor extrae a baja velocidad para producir el par de calado continuo máximo.
     Velocidad mecánica máxima, Nmax [rpm]:La velocidad mecánica máxima es la mayor velocidad que el motor
                     puede alcanzar. Limitada por factores mecánicos como la fuerza de adhesión del vínculo
                     magnético.
     Par de torsión máximo, Tp [Nm]:El par de torsión máximo se puede mantener durante un corto tiempo,
                      dependiendo de las condiciones ambientales y el ciclo de servicio general. Este valor
                      también puede limitarse según las especificaciones del sistema y la tensión del suministro.
     Corriente máxima, Ip [Arms]:La corriente máxima del motor (valor sinusoidal efectivo) es tres veces mayor que
                     la corriente continua. El valor real es menor que la corriente máxima del motor o la corriente
                     máxima del sistema utilizado.
     Par nominal, Trtd [Nm]:El par nominal se genera cuando el motor es alimentado con la corriente nominal a la
                       velocidad nominal. El par nominal se puede producir de forma indefinida a la velocidad
                       nominal en funcionamiento continuo (Nrtd.). Este valor supone una temperatura ambiente de
                       25 °C.
     Constante de par, Kt [Nm/Arms]:La constante de par indica el par que genera el motor por unidad de corriente.
                      Se mida a una temperatura ambiente de 25 °C y de la bobina de 155 °C.
     Constante EMF trasera, Ke [Vrms/krpm]:La constante BEMF indica la fuerza electromotriz inducida del motor
                     trasera, como valor sinusoidal efectivo entre dos terminales, por 1000 rpm. Se mida a una
                     temperatura ambiente de 25 °C y de la bobina de 155 °C.
     Constante del motor, Km [Nm/√W]:Esta constante se utiliza normalmente para comparar la densidad de
                      potencia de los motores calados o casi calados. Define la cantidad de par de torsión que el
                      motor puede producir con la cantidad de potencia indicada. El valor se indica con Kt y la
                      resistencia a una temperatura de bobina de 25 °C.
     Resistencia, Rm [Ω]:La resistencia se mide entre líneas y en la tarjeta del PC. El valor no incluye la resistencia
                      de los cables del motor. El valor de la resistencia se indica a 25 °C y aumentará con la
                      temperatura de la bobina.
     Inductancia, L [mH]:La inductancia se mide entre líneas y en la tarjeta del PC. Esta es la inductancia media del
                       motor con respecto a la posición del rotor. El valor se mide a una temperatura de bobina de
                       25 °C.
     Momento de inercia del rotor, Jm [kg-cm²]:El momento de inercia del rotor influye la capacidad de aceleración
                     angular del motor. El valor solo afecta a los componentes del conjunto de campo estándar
                     (barzón e imán anular). Los componentes que aporte el cliente alterarán la inercia total.
     Fricción estática, Tf [Nm]:La fricción estática es el par de torsión que debe superarse para que el motor
                        comience a rotar. Es la combinación de las pérdidas de histéresis a baja velocidad y el par
                        entre dientes máximo. No incluye pérdidas de rodamiento en el sistema. Esta fricción no
                        debe incluirse al calcular las pérdidas de rotación del motor acelerado.
     Resistencia térmica, Rthw-a [deg. C/vatio]:La resistencia térmica es una medida del aumento de temperatura
                       en estado estable por unidad de energía disipada de las pérdidas. Este valor asume que el
                       motor TBM2G está alojado y montado en un disipador térmico de aluminio como se define en
                       la hoja de CD correspondiente o su equivalente.

95    KOLLMORGEN | kdn.kollmorgen.com | June 2023

                                                                                           TBM2G Instructions | 4 Français

4 Français

4.1 Généralités

4.1.1 À propos de ce manuel
Le présent manuel décrit les moteurs sans boîtier TBM2G (version standard). En cas d'utilisation de
moteurs TBM2G dans des systèmes d'entraînement avec des servovariateurs Kollmorgen®, veuillez prendre
connaissance de l'ensemble de la documentation fournie, à savoir :

    l       Manuel d'installation des servovariateurs
    l       Manuel de communication du bus de terrain (CANopen ou EtherCAT, par ex.)

Pour plus d'informations, rendez-vous sur le site du réseau de développeurs Kollmorgen, à l'adresse
kdn.kollmorgen.com.

4.1.2 Abréviations utilisées

        l   Les abréviations utilisées pour les caractéristiques techniques sont décrites au chapitre « Définition des
            termes ».
        l   Dans ce document, la symbolique (➜ # 25) signifie « voir page 25 ».

                                                                       KOLLMORGEN | kdn.kollmorgen.com | June 2023       96

TBM2G Instructions | 4 Français

     4.1.3 Symboles utilisés
                      Symbole                       Description

                                                    Indique une situation dangereuse qui, si elle n’est pas évitée,
                                                    entraîne la mort ou de graves blessures.
                         DANGER
                                                    Indique une situation dangereuse qui, si elle n’est pas évitée,
                                                    peut entraîner la mort ou de graves blessures.
                   AVERTISSEMENT
                                                    Indique une situation dangereuse qui, si elle n’est pas évitée,
                                                    peut entraîner des blessures mineures ou modérées.
                       ATTENTION
                                                    Indique une situation qui, si elle n'est pas évitée, peut entraîner
                                                    des dommages matériels.

                                                    Ce symbole signale des remarques importantes.

                                                Avertissement d'un danger (général). Le type de danger
                                                concerné est indiqué dans le texte à côté du symbole.

                                                Avertissement d'un danger lié à l'électricité et ses effets.

                                                    Avertissement d'un danger lié à une surface chaude.

                                                Avertissement d'un danger lié à des charges suspendues.

97    KOLLMORGEN | kdn.kollmorgen.com | June 2023

                                                                                     TBM2G Instructions | 4 Français

4.1.4 Sécurité
4.1.4.0.1 Consignes de sécurité

                 AVERTISSEMENT Pacemaker !
                 Les puissants champs magnétiques générés tant que le rotor magnétique n'est pas installé
                 représentent un danger pour les personnes porteuses d'un implant tel qu'un pacemaker
                 (stimulateur cardiaque), car ils risquent d'interférer avec celui-ci. En général, toutes les
                 personnes vulnérables aux champs magnétiques puissants doivent respecter une distance
                 de sécurité d'au moins 1 mètre avec le rotor.

                 ATTENTION Champ magnétique !
                 Les puissants champs magnétiques générés représentent un danger pour les personnes
                 porteuses d'un implant, car ils risquent d'interférer avec celui-ci. En général, toutes les
                 personnes vulnérables aux champs magnétiques puissants doivent respecter une distance
                 de sécurité d'au moins 1 mètre avec le moteur.
                 Seul un personnel dûment qualifié est autorisé à effectuer des opérations de transport,
                 d'installation, de mise en service et de maintenance. Par personnel dûment qualifié, on
                 entend toute personne familiarisée avec le transport, le montage, l'installation, la mise en
                 service et l'utilisation des moteurs et disposant des qualifications nécessaires à l’exercice de
                 son métier. Le personnel qualifié doit connaître et respecter les normes CEI 60364 et 60662,
                 ainsi que les réglementations nationales en matière de prévention des accidents.
                 Les recommandations fournies dans le présent document sont censées servir de consignes
                 d'installation générales et sont données à titre indicatif.
                 Kollmorgen décline toute responsabilité en cas de mise en œuvre incorrecte de ces
                 techniques, qui relèvent de la seule responsabilité de l'utilisateur.

                 ATTENTION Porter des gants !
                 Portez toujours des gants lors de toute intervention sur le moteur.
                 Lisez la documentation disponible avant l'installation et la mise en service. Une manipulation
                 incorrecte des composants du moteur peut entraîner des blessures et des dégâts. Faites
                 preuve de prudence lors de l'installation du rotor à l'intérieur du stator du moteur. Des outils
                 ou des équipements spécifiques peuvent s'avérer nécessaires.

                                                                 KOLLMORGEN | kdn.kollmorgen.com | June 2023        98

TBM2G Instructions | 4 Français

                       ATTENTION Champ magnétique !
                       Des champs magnétiques puissants attirent les objets métalliques et peuvent se révéler
                       dangereux pour les mains et les doigts. Lors de toute intervention sur ou à proximité d'un
                       moteur TBM2G, veillez à disposer d'un marteau non métallique (d'environ 3 kg) et d'au
                       moins deux cales à pointe fine réalisées dans un matériau non magnétique résistant tel que
                       le V2A (avec un angle de coin compris entre 10° et 15°). En cas d'urgence, vous pouvez ainsi
                       utiliser ces outils pour détacher les objets qui se sont magnétiquement fixés au rotor
                       magnétique (par ex. pour libérer des parties du corps piégées).
                       Tenez les montres, les supports de données magnétiques (cartes de crédit, disquettes, etc.)
                       et les appareils numériques (téléphones portables, ordinateurs portables, etc.) à l'écart du
                       moteur TBM2G (< 500 m). En raison des puissantes forces d'attraction, faites preuve de
                       vigilance lorsque vous vous trouvez à moins de 50 mm du rotor magnétique. À cette
                       distance, veillez à ne pas tenir en main des objets lourds (> 1 kg) ou imposants (> 1 dm²) en
                       acier ou en fer.
                       Le rotor doit toujours être stocké sous conditionnement. Utilisez un emballage non
                       magnétique d'au moins 20 mm d'épaisseur. Le lieu de stockage doit être sec et à l'abri de la
                       chaleur. N'exposez pas le rotor du moteur à une température de plus de 110 °C, sauf s'il est
                       installé à l'intérieur du stator. Une température supérieure à 110 °C risquerait de
                       démagnétiser les aimants du rotor.
                       Affichez l'avertissement « Attention : AIMANTS PUISSANTS » sur le lieu de stockage des
                       moteurs.
                       Apposez des étiquettes d'avertissement (sous forme d'autocollants permanents, par ex.) sur
                       la machine à des endroits bien visibles. Attention : les variateurs de cette machine sont dotés
                       de puissants aimants. CHAMPS MAGNÉTIQUES PUISSANTS + FORCES D'ATTRACTION
                       PUISSANTES !

                       DANGER Mise à la terre ! Hautes tensions !
                       Il est nécessaire de s'assurer que les pièces métalliques du stator du moteur sont
                       correctement mises à la terre par l'intermédiaire de la barre omnibus PE (« protective
                       earth », terre de protection) de l'armoire de commande. La sécurité du personnel ne peut pas
                       être assurée en l'absence d'une terre de protection à basse résistance. Pour plus
                       d'informations, reportez-vous à la section « Mise à la terre » du chapitre « Consignes de
                       montage et d'installation » dans ce document.
                       Les connexions électriques peuvent rester sous tension même lorsque le moteur ne tourne
                       pas. Ne débranchez jamais les connexions électriques du moteur pendant qu'il est sous
                       tension. Des arcs électriques pourraient se former, et occasionner des blessures et des
                       dégâts.

99    KOLLMORGEN | kdn.kollmorgen.com | June 2023

                                                                                         TBM2G Instructions | 4 Français

4.1.5 Avis important
Personnel spécialisé
Seul un personnel dûment qualifié est autorisé à effectuer des opérations de transport, de montage, de
configuration et de maintenance. Par personnel qualifié, on entend toute personne familiarisée avec le transport,
l'installation, le montage, la mise en service et l'utilisation des moteurs et disposant des qualifications minimales
en rapport avec ses activités :

    l   Transport : exclusivement réservé à un personnel possédant des connaissances en matière de
        manipulation de composants sensibles à l'électricité statique.
    l   Installation mécanique : exclusivement réservée à des mécaniciens qualifiés.
    l   Installation électrique : exclusivement réservée à des électriciens qualifiés.
    l   Configuration : exclusivement réservée à des spécialistes de l'électrotechnique et des technologies
        d'entraînement.

Le personnel qualifié doit connaître et respecter les normes CEI 60364 / CEI 60664, ainsi que les
réglementations nationales en matière de prévention des accidents.
Lecture de la documentation
Lisez la documentation disponible avant l'installation et la mise en service. Toute manipulation incorrecte du
stator ou rotor peut provoquer des blessures ou des dégâts. L'opérateur doit donc s'assurer que toutes les
personnes travaillant sur le moteur sans boîtier ont lu et compris le manuel et qu'elles appliquent les consignes
de sécurité qui y sont énoncées.
Prise en compte des caractéristiques techniques
Respectez les caractéristiques techniques et les spécifications relatives aux conditions de connexion
(caractéristiques électriques nominales dans Technical Data). Le dépassement des valeurs de tension ou
d'intensité autorisées peut entraîner des dommages sur les moteurs sans boîtier, par exemple en raison d'une
surchauffe.
Évaluation des risques
Le fabricant de l'appareil doit procéder à une évaluation des risques pour celui-ci et prendre les mesures
appropriées afin d'éviter tout dommage corporel ou matériel provoqué par un éventuel mouvement inopportun.
Des exigences supplémentaires concernant le personnel spécialisé peuvent également découler de l'évaluation
des risques.

                    ATTENTION Surface chaude !
                    Les surfaces des moteurs TBM2G peuvent être très chaudes pendant le fonctionnement,
                    conformément à leur catégorie de protection. Risque de brûlures mineures ! La température
                    de surface peut dépasser 155 °C.

                         l   Mesurez la température et attendez que le moteur TBM2G ait refroidi en dessous de
                             40 °C avant de le toucher.

                                                                     KOLLMORGEN | kdn.kollmorgen.com | June 2023        100

TBM2G Instructions | 4 Français

                          DANGER Mise à la terre ! Hautes tensions !
                          Assurez-vous que le moteur TBM2G est correctement mis à la terre avec la barre omnibus
                          PE (« protective earth », terre de protection) de l'armoire de commande. Risque de choc
                          électrique. Aucune protection personnelle ne peut être garantie sans mise à la terre à basse
                          résistance ; tout choc électrique peut entraîner la mort.

                                l   L'absence de signalétique ne garantit pas l'absence de tension. Les connexions
                                    électriques peuvent être sous tension même si le rotor ne tourne pas.
                                l   Ne débranchez aucun connecteur pendant le fonctionnement. Toucher des contacts
                                    exposés peut entraîner des blessures graves, voire la mort. Les connexions
                                    électriques peuvent être sous tension même lorsque le rotor ne tourne pas. Des arcs
                                    électriques peuvent alors se former, et endommager les contacts et occasionner des
                                    blessures.

                                l   Après avoir déconnecté le servovariateur de la source de tension d'alimentation,
                                    attendez plusieurs minutes avant de toucher des composants habituellement sous
                                    tension (par ex. contacts, raccords vissés) ou d'ouvrir un connecteur.

                                l   Les condensateurs du servovariateur peuvent continuer à présenter une tension
                                    dangereuse plusieurs minutes après la mise hors tension. Pour éviter tout risque,
                                    mesurez la tension de liaison c.c. et attendez qu'elle chute sous 60 V.

      Utilisation recommandée (« Usage prévu »)

          l   L'utilisation des moteurs est uniquement autorisée dans les conditions ambiantes définies dans la
              présente documentation.
          l   Cette gamme de moteurs est exclusivement destinée à être pilotée par des servovariateurs.
          l   Les moteurs sont installés en tant que composants dans des machines ou des équipements électriques et
              ne peuvent être exploités et mis en service qu'en tant que composants intégrés de ces équipements ou
              machines.
          l   L'utilisateur final est responsable de la conformité de la machine.

      4.1.6 Utilisation interdite
      L'utilisation des moteurs dans les environnements suivants est interdite sans avoir consulté au préalable le
      service clientèle de Kollmorgen :

          l   zones potentiellement explosives ;
          l   environnements avec acides corrosifs et/ou conducteurs, solutions alcalines, huiles, vapeurs,
              poussières ;
          l   milieux sous vide ;
          l   directement sur les réseaux d'alimentation secteur.

      La mise en service du moteur est interdite si la machine sur laquelle il est installé :

          l   ne satisfait pas aux exigences de la directive européenne « Machines » ;
          l   ne satisfait pas aux exigences de la directive CEM ;
          l   ne satisfait pas aux exigences de la directive « Basse tension ».

101    KOLLMORGEN | kdn.kollmorgen.com | June 2023

                                                   TBM2G Instructions | 4 Français

4.1.7 Nomenclature des modèles

                                 KOLLMORGEN | kdn.kollmorgen.com | June 2023   102

TBM2G Instructions | 4 Français

      4.1.8 Vue d'ensemble des couples
                               0.72 Nm to 1.75 Nm
       050         0.27 Nm to 0.64 Nm
                                           1.17 Nm to 2.85 Nm
                                                                                  Couple de pointe
       060            0.45 Nm to 0.96 Nm                                          Couple continu
                               1.53 Nm to 4.13 Nm
       068                  0.63 Nm to 1.54 Nm
                                            2.12 Nm to 5.57 Nm
       076                        0.89 Nm to 2.06 Nm
                                                        3.16 Nm to 7.01 Nm
       085                              1.21 Nm to 2.69 Nm
                                                                      3.75 Nm to 9.01 Nm
       094                                          1.58 Nm to 3.67 Nm
                                                                         3.18 Nm to 15.3 Nm
       115                                   1.90 Nm to 6.03 Nm
             0.0    1.0        2.0         3.0       4.0          5.0     6.0       7.0       8.0      9.0    15.0
                                                           Couple (Nm)

      4.1.9 Description des matériaux des composants
                                                                                    1. Culasse
                                                                                             l Matériau : acier inoxydable

                                                                                               série 400
                                                                                    2. Anneau magnétique
                                                                                             l Matériau : NdFeB

                                                                                               (néodyme)
                                                                                             l Revêtement : époxy

                                                                                    3. Carte à circuits imprimés (PCB)
                                                                                    4. Bobine
                                                                                             l Matériau : cuivre

                                                                                             l Revêtement : vernis

                                                                                    5. Isolateurs d'extrémité
                                                                                       Matériau : résine polymère
                                                                                    6. Câbles d'alimentation
                                                                                    7. Pile de stratification
                                                                                       Matériau : acier électrique
                                                                                    8. Dispositifs thermiques en option
                                                                                       (montés sous la carte PCB)
                                                                                             l PT1000

                                                                                             l PTC à avalanche (3 en

                                                                                               série)
                                                                                    9. Capteurs à effet Hall en option
                                                                                       (montés sous la carte PCB)
                                                                                             l Allegro A1260

103   KOLLMORGEN | kdn.kollmorgen.com | June 2023

                                                                                         TBM2G Instructions | 4 Français

4.2 Consignes de stockage, d'utilisation et de transport

4.2.1 Stockage
Classe climatique              1K4 selon la norme CEI 60721-3-1, EN61800-2.
Température de stockage -25 à +55 °C, variations max. 20 °K/heure
Humidité                       5 à 95 % d'humidité relative, sans condensation
Durée de stockage              Illimitée

Le stockage des moteurs doit être effectué uniquement dans l'emballage d'origine du fabricant.

4.2.2 Utilisation
Température ambiante           -20 à +40 °C pour une altitude d'installation jusqu'à 1 000 m au-dessus du niveau
(aux valeurs nominales)        de la mer
Humidité admissible (aux 95 % d'humidité relative, sans condensation
valeurs nominales)
Réduction de puissance         Aucune réduction de puissance pour les altitudes d'installation supérieures à
(courants et couples)          1 000 m au-dessus du niveau de la mer avec une réduction de température de
                               10 °K/1 000 m. Veillez à ce que la température d'enroulement ne dépasse pas
                               155 °C.

4.2.3 Transport
Classe climatique              2K3 selon la norme CEI 60721-3-2, EN61800-2
Température de stockage -25 à +70 °C, variations max. 20 °K/heure
Humidité                       5 à 95 % d'humidité relative, sans condensation

Évitez les chocs. Si l'emballage est abîmé, vérifiez si les pièces du moteur présentent des dommages visibles.
Informez-en le transporteur et, le cas échéant, le fabricant.

4.2.4 Déballage
Le stator et le rotor sont généralement livrés ensemble dans un emballage individuel ou groupé. Un emballage
groupé personnalisé est disponible en option. Le rotor et le stator sont séparés par du matériel d'emballage afin
d'éviter toute interférence en raison de leurs puissantes forces magnétiques. Lors du déballage, veillez à laisser
les pièces séparées et à éviter toute interférence entre le rotor hautement magnétique et les autres objets.
Le stator peut contenir des capteurs à effet Hall le cas échéant. Ces dispositifs sont sensibles aux dommages
électrostatiques. Des sachets antistatiques sont utilisés pour livrer les stators équipés de capteurs à effet Hall.
Lors du déballage, veillez à prendre les précautions nécessaires pour maintenir la protection antistatique.

                                                                     KOLLMORGEN | kdn.kollmorgen.com | June 2023      104

TBM2G Instructions | 4 Français

      4.3 Consignes de montage et d'installation

      Les recommandations fournies dans le présent manuel de Kollmorgen sont censées servir de consignes
      d'installation générales et sont uniquement données à titre indicatif. Kollmorgen décline toute responsabilité en
      cas de mise en œuvre incorrecte de ces techniques, qui relèvent de la seule responsabilité de l'utilisateur.

      4.3.1 Définition de l'ensemble induit et de l'ensemble inducteur
      Ensemble induit (stator)
      L'ensemble induit est la partie fixe du moteur sans boîtier. Cet ensemble se compose de lames d'acier
      magnétique, de bobines et de fils conducteurs. Il peut également être doté en option de dispositifs tels que des
      capteurs à effet Hall ou des capteurs thermiques.
      Ensemble inducteur (rotor)
      L'ensemble inducteur est la partie rotative du moteur sans boîtier. Cet ensemble se compose d'un anneau
      magnétique en terres rares et d'une culasse annulaire.
      Moteur sans boîtier (groupe moteur)
      Moteur fabriqué et livré en deux pièces séparées (stator et rotor). Chacune de ces pièces doit être assemblée
      avec un boîtier, un arbre et un système de paliers fournis par l'utilisateur final.

105    KOLLMORGEN | kdn.kollmorgen.com | June 2023

                                                                                           TBM2G Instructions | 4 Français

4.3.2 Responsabilités de l'utilisateur concernant l'interface
Afin de garantir le bon fonctionnement et la fiabilité du moteur une fois celui-ci installé dans le système, il
incombe à l'utilisateur de concevoir l'interface de montage à l'aide des informations ci-dessous. L'utilisateur est
responsable de la conception de l'arbre de rotor, de l'enceinte de stator, du système de paliers, des détails
conceptuels du boîtier, de la sélection des matériaux, des calculs d'adaptation et de l'analyse des tolérances en
fonction des besoins pour l'usage prévu.

4.3.2.1 Paliers
Le système de paliers fourni par l'utilisateur dans l'application moteur doit être suffisamment rigide pour pouvoir
maintenir un jeu fonctionnel précis et uniforme entre le rotor et le stator quelles que soient les conditions de
fonctionnement. Un jeu uniforme intègre les tolérances de faux-rond et de concentricité entre le rotor et le stator.

4.3.2.2 Matériaux pour le montage du stator
Pour le montage du stator, il est conseillé d'utiliser une structure de fixation ou un boîtier métallique afin de
garantir le chemin de dissipation thermique le plus conducteur possible, ainsi qu'une bonne intégrité structurelle.
Les alliages d'aluminium sont à privilégier en raison de leur conductivité thermique supérieure et de leur rapport
résistance-poids, même si les alliages d'acier inoxydable (série 300 ou équivalente) constituent une alternative
acceptable pour les applications moins critiques sur le plan thermique. L'acier au carbone, la fonte, les alliages
d'acier inoxydable série 400 et les autres métaux ferromagnétiques sont les matériaux les moins recommandés
pour le montage du stator. Consultez un ingénieur Kollmorgen si vous devez utiliser ces métaux. Le plastique et
les autres matériaux isolants similaires sont déconseillés, car ils nuisent à la capacité de dissipation thermique
du système et imposent alors de réduire les performances du moteur.

4.3.2.3 Matériaux pour le montage du rotor
Le rotor aimanté peut être monté sur un arbre métallique de votre choix. L'acier au carbone et l'acier inoxydable
sont les matériaux les plus courants pour l'arbre, même si les alliages d'aluminium sont parfois utilisés lorsqu'ils
sont spécialement conçus pour la plage de températures de service et de couples prévue. La méthode employée
pour fixer le rotor à l'arbre peut influer sur le choix du matériau et des tolérances pour l'arbre. En cas d'utilisation
d'un moteur sans balais Kollmorgen, il n'est pas nécessaire que l'arbre conduise le flux magnétique ou intègre le
circuit magnétique pour que les performances nominales soient atteintes.

4.3.2.4 Mise à la terre
       Lors du montage dans l'application, le feuilletage (ou le manchon extérieur en métal nu) du stator doit
       présenter le même potentiel de terre électrique que le châssis du système et le châssis du servovariateur.
       Si ce circuit de terre commun n'est pas garanti, l'application risque de générer du bruit électrique et de
       présenter un risque de choc électrique. Ce risque de choc est particulièrement présent sur les moteurs à
       grand nombre de pôles dont la capacité électrique est élevée. En général, un circuit de terre fiable entre
       le feuilletage du stator et le châssis de la machine est assuré si des composants métalliques
       électroconducteurs sont utilisés pour monter le stator. Kollmorgen recommande de réaliser un test de
       continuité pour vérifier la liaison à la terre avant d'activer le système moteur. Dans certaines applications,
       une tresse de masse conductrice indépendante peut s'avérer nécessaire suivant la configuration de
       montage et les matériaux choisis. Dans de tels cas, il incombe à l'utilisateur d'installer le circuit de terre et
       de vérifier l'installation électrique.

                                                                      KOLLMORGEN | kdn.kollmorgen.com | June 2023          106

TBM2G Instructions | 4 Français

      4.3.2.5 Instructions de montage de base
                            La série TBM2G et les autres moteurs sans boîtier et sans balais de
                            Kollmorgen utilisent des aimants en terres rares hautes performances.
                            Faites preuve d'une extrême prudence lors de leur manipulation ou transport
                            afin d'éviter tout dommage corporel ou matériel. Les forces d'attraction entre
                            les rotors aimantés et les objets métalliques à proximité peuvent être très
                            puissantes. Une mauvaise manipulation peut entraîner des répercussions
                            soudaines et imprévues. Le puissant champ magnétique risque également
                            d'endommager les ordinateurs, écrans et dispositifs de stockage de mémoire
                            situés à proximité. Avant son installation, laissez le rotor dans sa caisse
                            d'expédition ou sous un emballage protecteur. Cette pratique permet d'éviter
                            tout accident et toute contamination, par ex. des copeaux ou débris
                            métalliques qui ont tendance à s'accrocher aux aimants.

      Vous trouverez ci-dessous une procédure de montage générique que vous pouvez suivre pour insérer un rotor
      (ensemble inducteur) dans un stator (ensemble induit) :

      1. Fixez solidement le boîtier fourni par le client sur une surface stable afin d'éviter tout mouvement soudain.
      2. Faites glisser le stator dans le boîtier et fixez-le par collage ou serrage du stator comme indiqué dans la
         section « Techniques de montage du stator ».
      3. Faites glisser le rotor sur l'arbre fourni par le client et fixez-le par collage ou serrage du rotor comme indiqué
         dans la section « Techniques de montage du rotor ».

           Les aimants en terres rares sont vulnérables à la fissuration et à l'écaillage. Lors du montage du rotor sur
           l'arbre, veillez à ne pas faire tomber les aimants et à éviter tout choc avec d'autres surfaces.
      4. Avant d'insérer l'ensemble rotor/arbre dans l'ensemble stator/boîtier, Kollmorgen recommande de poser
         d'abord une fine couche de matériau de calage (film Mylar®, par ex.) dans l'alésage interne du stator.
             l Le film Mylar peut être installé en un seul tenant sur toute la circonférence de l'alésage du stator ou en

               plusieurs tenants dans le sens axial en des points équidistants. L'épaisseur de film adaptée et le
               nombre de couches de calage idéal dépendent du jeu entre le rotor et le stator, qui est spécifique à la
               taille du moteur que l'utilisateur essaie d'installer. Consultez le tableau « Jeu fonctionnel radial » ci-
               dessous pour déterminer ces valeurs.

                  Lors de l'installation du rotor, il se peut que la surface externe du rotor adhère au point le plus proche
                  de l'alésage interne du stator en raison des forces d'attraction magnétiques. La friction produite lors
                  de l'insertion du rotor à l'intérieur du stator risquerait alors d'endommager la bande, les aimants et
                  les revêtements du rotor ou les surfaces de l'alésage du stator.
      5. Insérez lentement et doucement le rotor le long de l'axe central pour le positionner à l'intérieur du stator.
         Vous pouvez effectuer cette opération à la main ou utiliser un dispositif d'installation personnalisé.
      6. Avant de retirer les cales, installez sur l'ensemble rotor les paliers nécessaires pour maintenir l'alignement
         d'arbre.
      7. Avant la mise en service, retirez le matériau de calage de l'entrefer séparant le rotor du stator.

      Jeu fonctionnel radial type
                                    Taille de châssis TBM2G
                                    050         060          068          076         085          094          115
       Entrefer        mm           0,26        0,29         0,26         0,26        0,26         0,26         0,40
       mécanique
       nominal         po           0,010       0,011        0,010        0,010       0,010        0,010        0,016

107    KOLLMORGEN | kdn.kollmorgen.com | June 2023

                                                                                       TBM2G Instructions | 4 Français

                            Taille de châssis TBM2G
                            050          060         068          076          085         094          115
L'utilisateur doit tenir compte des exigences de concentricité indiquées sur chaque schéma d'encombrement
Kollmorgen spécifique au modèle. Il est recommandé d'utiliser des paliers garantissant le niveau de friction le
plus bas possible et du lubrifiant de haute qualité en vue de limiter la friction dans l'ensemble du système et de
permettre ainsi un fonctionnement optimal du moteur.

                                                                   KOLLMORGEN | kdn.kollmorgen.com | June 2023       108

TBM2G Instructions | 4 Français

      4.3.3 Techniques de montage du stator
      Pour installer le stator du moteur, Kollmorgen recommande les techniques suivantes en fonction du couple, des
      vibrations et des caractéristiques thermiques de l'application, ainsi qu'en fonction du coût et de la facilité de
      montage et d'entretien souhaités par l'utilisateur.

      4.3.3.1 Collage du stator

      Afin de garantir une bonne adhérence, les surfaces du stator et du boîtier doivent être soigneusement nettoyées
      avant de procéder au collage. Reportez-vous à la fiche technique de l'adhésif utilisé pour les méthodes de
      nettoyage adaptées au matériau du boîtier.

      Sur les moteurs dont le couple de crête ne dépasse pas 2 400 Nm, il est généralement possible de coller le stator
      à l'aide d'une colle époxy structurale telle que 3M™ Scotch-Weld™ 2214 ou d'autres adhésifs similaires. Le
      collage est une technique d'installation permanente privilégiée pour tous les stators TBM2G. Comme indiqué sur
      les illustrations du collage du stator ci-dessous, pour que le collage soit réussi, l'enceinte du stator doit être en
      forme de coupelle cylindrique avec une extrémité présentant un petit épaulement pour le positionnement axial et
      une extrémité opposée ouverte. L'épaulement sert de butée au stator lorsqu'il est inséré depuis l'extrémité
      ouverte et doit généralement dépasser le diamètre extérieur maximal de la spire terminale de l'enroulement
      comme indiqué sur le schéma d'encombrement. Des dégagements angulaires sont nécessaires pour tenir
      compte des angles vifs du feuilletage du stator. Un petit chanfrein intérieur à l'extrémité ouverte de la coupelle du
      boîtier facilite l'insertion du stator. Si la procédure de montage est réalisée avec le boîtier du stator posé à plat
      (position verticale à l'axe de rotation), la pression hydrostatique de l'adhésif structural facilitera l'auto-centrage du
      stator dans son boîtier.
                                                                                1.    Palier du client
                                                                                2.    Boîtier du client
                                                                                3.    Rétroaction du client
                                                                                4.    Stator TBM2G

                        BUTÉE DE PROFONDEUR                                   0.025 MM [0.010 IN.] MIN.
                      FONCTION D'ÉPAULEMENT                                   DÉGAGEMENT DE TOUS
                                                        ADHESIVE              LES JOINTS DE SOUDURE
                             L'ISOLATEUR PEUT          RESERVOIR
                                   TOUCHER LE           GROOVES                 0.13 - 0.26 MM [0.006 - 0.010 IN.]
                               BOÎTIER À CETTE                                  RAINURE ADHÉSIVE SUPPLÉ-
                                    EXTRÉMITÉ                                   MENTAIRE 50+% DE LA SURFACE

                                                                                     0.025/0.050 MM ÉCART
                                                                                     NOMINAL (RADIAL) PAR
                                                                                     CÔTÉ

                                                                           ÉPOXY STRUCTURELLE
                                                                           RECOMMANDÉE: 3M SCOTCHWELD
                                                                           2214 HYSOL EA934NA

               Figure 7-1: Illustrations du collage du stator

109    KOLLMORGEN | kdn.kollmorgen.com | June 2023

                                                                                           TBM2G Instructions | 4 Français

Les températures extrêmes peuvent représenter un risque en raison de coefficients de dilatation différents
(feuilletage en acier et boîtier en aluminium, par ex.). Il est conseillé à l'utilisateur de contacter le fabricant de
l'adhésif pour connaître l'épaisseur de trait de colle à appliquer, la méthode d'application à employer et les
conditions de séchage à respecter. Les rainures représentées sur le diamètre intérieur du boîtier sur les
illustrations du collage du stator sont censées servir de réservoirs pour la colle époxy structurale épaisse et
permettre ainsi de fournir une importante résistance à la torsion sur une vaste plage de températures. En cas
d'utilisation de colle époxy structurale épaisse, le diamètre intérieur de la coupelle du boîtier doit être supérieur
d'environ 0,05 mm - 0,1 mm au diamètre extérieur maximal du stator. Lorsqu'ils sont utilisés selon les
recommandations du fabricant, ces agents de liaison offrent d'excellentes caractéristiques de durabilité et de
résistance dans le temps.
Si l'utilisation d'un produit de fixation, tel que LOCTITE® 640™ ou tout autre adhésif similaire, est préférée à
celle d'une colle époxy structurale, il convient d'assurer un écart moins important entre le diamètre intérieur du
boîtier et le diamètre extérieur du stator afin de conserver une épaisseur de colle appropriée. Reportez-vous aux
recommandations du fabricant de l'adhésif.

Il incombe à l'utilisateur de choisir l'adhésif approprié et de concevoir les dimensions du boîtier en fonction du
coefficient de dilatation thermique prévu aux températures d'application extrêmes attendues. Les températures
de séchage de l'adhésif ne doivent pas dépasser 155 °C afin de ne pas endommager le stator du moteur.

                                                                      KOLLMORGEN | kdn.kollmorgen.com | June 2023        110

TBM2G Instructions | 4 Français

      4.3.3.2 Serrage du stator
      Pour les applications nécessitant des installations et désinstallations répétées du stator, le serrage axial peut
      être une bonne solution. Kollmorgen ne recommande généralement pas cette technique pour les applications
      impliquant des vibrations et des chocs importants ou des températures extrêmes sans considération
      conceptuelle particulière. L'enceinte du stator illustrée ci-dessous est très similaire à celle de la technique du
      collage époxy. En cas d'utilisation de la technique de serrage pour le montage du stator, le diamètre intérieur de
      la coupelle du boîtier doit être supérieur d'environ 0,025 mm - 0,050 mm au diamètre extérieur maximal du stator.
      Si nécessaire, le petit espace radial entre le diamètre extérieur du stator et le diamètre intérieur du boîtier peut
      être rempli de pâte thermique pour une meilleure conduction de la chaleur vers le dissipateur thermique.

      Prenez les précautions nécessaires pour éviter de contaminer les surfaces de serrage axial avec de la graisse
      susceptible de réduire la friction de serrage.

      Un épaulement usiné servant de butée au stator lors de son insertion est nécessaire. Une bague de serrage
      distincte est requise à l'extrémité opposée du stator et doit être boulonnée au boîtier avec 4 à 12 fixations posées
      de manière équidistante. À l'aide des dimensions indiquées sur le schéma d'encombrement, maximisez la
      surface de serrage. Cela limitera la tension de serrage exercée sur le stator. La profondeur d'alésage du boîtier
      doit toujours permettre à la bague de serrage d'entrer en contact avec le noyau du stator avant d'entrer en
      contact avec le boîtier, quelles que soient les conditions de température et les tolérances. Dans le cas contraire,
      les forces de serrage seront insuffisantes. Consultez le schéma d'encombrement pour les tolérances du stator.
      Les pressions de serrage dépendent de la surface et de la force de serrage. La pression de serrage doit être
      comprise entre 5 et 20 MPa (725 et 2 900 psi). Veillez à éviter toute pression de serrage excessive. Des
      pressions excessives feraient augmenter les pertes dans le noyau lors du fonctionnement à des vitesses de
      rotation élevées. Veillez également à assurer une précharge suffisante sur les boulons de serrage. Celle-ci, en
      plus de l'application d'un frein-filet, empêchera les boulons de serrage de se desserrer après un fonctionnement
      prolongé.
                                                                                            1. Boîtier du client
                                                                                            2. Stator TBM2G
                                                                                            3. Bague de serrage du stator

                                                                        LA BAGUE DE SERRAGE DOIT AVOIR UN
                                                                        ESPACE DERRIÈRE POUR PERMETTRE LA
                           BUTÉE DE PROFONDEUR                          COMPRESSION DE L'ÉPAULEMENT DU
                         FONCTION D'ÉPAULEMENT                          STATOR.
                               L'ISOLATEUR PEUT                              0.012/0.025 MM ÉCART
                            TOUCHER LE BOÎTIER À                             NOMINAL (RADIAL) PAR CÔTÉ
                               CETTE EXTRÉMITÉ

                                                                            LA BAGUE DE SERRAGE AVEC
                                                                            LES BOULONS DOIT S'ENGAGER
                                                                            AU MOINS SUR LA MOITIÉ DE
                                                                            L'ÉPAULEMENT DU STATOR

               Figure 7-2: Illustrations du serrage du stator

111    KOLLMORGEN | kdn.kollmorgen.com | June 2023

                                                                           TBM2G Instructions | 4 Français

4.3.4 Techniques de montage du rotor
                La série TBM2G et les autres moteurs sans boîtier et sans balais de
                Kollmorgen utilisent des aimants en terres rares hautes performances.
                Faites preuve d'une extrême prudence lors de leur manipulation ou transport
                afin d'éviter tout dommage corporel ou matériel. Les forces d'attraction entre
                les rotors aimantés et les objets métalliques à proximité peuvent être très
                puissantes. Une mauvaise manipulation peut entraîner des répercussions
                soudaines et imprévues. Le puissant champ magnétique risque également
                d'endommager les ordinateurs, écrans et dispositifs de stockage de mémoire
                situés à proximité. Avant son installation, laissez le rotor dans sa caisse
                d'expédition ou sous un emballage protecteur. Cette pratique permet d'éviter
                tout accident et toute contamination, par ex. des copeaux ou débris
                métalliques qui ont tendance à s'accrocher aux aimants.

4.3.4.1 Contrôle du faux-rond radial
                Les schémas d'encombrement spécifiques au modèle de Kollmorgen
                indiquent une exigence de montage pour le faux-rond entre le diamètre
                intérieur du rotor et le diamètre extérieur du stator. Cette légende sert à
                présenter les exigences de faux-rond entre le diamètre extérieur de l'arbre du
                client et le diamètre intérieur du boîtier. Il incombe à l'utilisateur de concevoir
                l'arbre, le boîtier et le système de paliers de manière à respecter la limite de
                faux-rond spécifiée entre le diamètre extérieur de la surface de collage de
                l'arbre et le diamètre intérieur de la surface de collage du boîtier. Si ces
                consignes sont respectées, la concentricité globale entre le diamètre
                extérieur du rotor et le diamètre intérieur du stator devrait être acceptable.

                                                         KOLLMORGEN | kdn.kollmorgen.com | June 2023   112

TBM2G Instructions | 4 Français

      4.3.4.2 Collage du rotor

      Afin de garantir une bonne adhérence, les surfaces du stator et du boîtier doivent être soigneusement nettoyées
      avant de procéder au collage. Reportez-vous à la fiche technique de l'adhésif utilisé pour les méthodes de
      nettoyage adaptées au matériau du boîtier.

      Pour les applications ne nécessitant pas un couple de crête supérieur à 750 Nm, il est généralement possible de
      coller les rotors à des arbres en acier au carbone ou en acier inoxydable. Les produits de fixation, tels que
      LOCTITE® 640™ ou tout autre adhésif similaire, nécessitent généralement des diamètres d'interfaces continus
      homogènes et des tolérances d'ajustement limitées, comme des écarts nominaux de 0,012 mm à 0,025 mm. Les
      époxys structuraux nécessitent généralement un jeu d'ajustement légèrement plus grand afin de pouvoir
      appliquer un trait de colle plus épais. Les colles époxy bénéficient souvent des rainures dans l'interface
      arbre/rotor qui servent de réservoirs et peuvent être renforcées par des surfaces texturées obtenues par
      moletage ou grenaillage. Contactez le fabricant de l'adhésif pour connaître l'épaisseur de trait de colle à
      appliquer, la méthode d'application à suivre et les conditions de séchage à respecter.
      Pour éviter toute démagnétisation partielle du rotor, ne laissez pas sécher les joints de colle entre le rotor et
      l'arbre à des températures supérieures à 110 °C sauf si le rotor est logé à l'intérieur du stator correspondant ou
      s'il est complètement entouré d'un dispositif de type « court-circuit magnétique » en métal ferreux. Pour plus
      d'informations à ce sujet, contactez un ingénieur Kollmorgen. Avant de coller des rotors à des arbres en
      aluminium, consultez le fabricant de l'adhésif. Un adhésif particulièrement flexible présentant des propriétés
      thermiques étendues pourrait s'avérer nécessaire.
                                                                               1. Arbre du client
                                                                               2. Rotor de l'ensemble
                                                                                  inducteur TBM2G

                                                                           ASSEMBLAGE DU CHAMP

                                                                                 0.012/0.025 MM ÉCART
                                                                                 NOMINAL (RADIAL) PAR CÔTÉ

                                     PROFONDEUR                                ARBRE DU CLIENT
                                     D'AJUSTEMENT
                                     À L'ÉPAULE

               Figure 7-3: Illustrations du collage du rotor

113    KOLLMORGEN | kdn.kollmorgen.com | June 2023

                                                                                     TBM2G Instructions | 4 Français

4.3.5 Techniques de montage axial

4.3.5.1 Contrôle de l'alignement axial
Les schémas d'encombrement spécifiques au modèle de Kollmorgen indiquent l'alignement axial à maintenir
entre le rotor et le stator lors du montage afin de garantir des performances adéquates du moteur. Il incombe à
l'utilisateur de concevoir l'arbre de rotor, l'enceinte de stator et le système de paliers de manière à obtenir
l'alignement de montage spécifié. Des épaulements usinés sur l'arbre ou des rainures pour bagues de retenue
amovibles sont des moyens couramment employés pour contrôler la position d'installation du rotor. Le diamètre
maximal des bagues de retenue ou des épaulements d'arbre doit rester inférieur au diamètre du rotor si des
aimants sont collés au moyeu en acier.

                                                                  KOLLMORGEN | kdn.kollmorgen.com | June 2023     114

TBM2G Instructions | 4 Français

      4.3.6 Montage axial
      Afin d'assurer le fonctionnement optimal et le déclenchement approprié des capteurs à effet Hall, Kollmorgen
      spécifie une cote de montage entre le bord du feuilletage et le bord de la culasse annulaire [Kollmorgen].
      Cette cote de montage garantit que le matériau magnétique couvre l'intégralité du feuilletage et s'étend
      axialement pour déclencher les capteurs à effet Hall, le cas échéant.
                                             "A"
                                            MAX.
                                                       ARMATURE ASSEMBLY
                                            "B"
                                                           3.00 [0.118] MAX.
                  4.70 [0.185] MAX                         SUR SOUDURE ET PIQUET DE CHALEUR
                                                           VOIR NOTE 3
                                                                             A

                                                                                                        ANNEAU YOKE
                ASSEMBLAGE
                  DU CHAMP
                                                           2X 30°

      Ø 91.13 [3.588]
          MAX.
                                                          2X 0.50
                                                          [0.020]
                                                          CHAMBRE
                                  "C"
                                                                          Ø93.96 - 94.04
                  Ø46.98 - 47.02                                           [3.700 - 3.702]
                   [1.850 - 1.851]
                     0.07 [0.003] A
                  EXIGENCES DE
                    MONTAGE
                                                                Ø92.33
                                                                [3.635]
                                                                 MAX

                                                                                                 0.70±0.40 [0.028±0.015]
                                                                                                 MTG DIM
               0.70±0.40 [0.028±0.015]
                            MTG DIM                    ANGLE VIF DES DEUX CÔTÉS.
                                                       CONTRE-DÉPOUILLE REQUISE SUR
                                                       LES ÉLÉMENTS D'ASSEMBLAGE
                                         SECTION A-A

                        Figure 7-4: Illustration de la cote de montage indiquée sur un schéma d'encombrement TBM2G-068XXX-XXXX-
                        00. Cette cote est mesurée entre le bord gauche du feuilletage et le bord gauche du matériau de culasse (et non du
                        matériau magnétique).

      Si vous souhaitez déterminer la cote de montage alternative en partant de l'autre côté du feuilletage, il est
      possible de calculer la valeur nominale en utilisant certains paramètres du schéma. Pour calculer la valeur
      nominale entre le bord droit du feuilletage et le bord droit du matériau de culasse, utilisez l'équation suivante :
                         Cote de montage alternative (mm, nominal) = « C » – « B » – 0,70 mm

115     KOLLMORGEN | kdn.kollmorgen.com | June 2023

                                                                                         TBM2G Instructions | 4 Français

Pour fournir un exemple de calcul de la cote de montage alternative, nous allons utiliser :

    l   les dimensions de TBM2G-06813-00 provenant du schéma d'encombrement TBM2G-068XXX-XXXX-00
        indiquées à la "Illustration de la cote de montage indiquée sur un schéma d'encombrement TBM2G-
        068XXX-XXXX-00. Cette cote est mesurée entre le bord gauche du feuilletage et le bord gauche du
        matériau de culasse (et non du matériau magnétique)." (➜ p. 115) ;
    l   l'équation pour la cote de montage alternative ;
    l   un tableau issu du schéma d'encombrement TBM2G-068 qui indique les valeurs « B » et « C », présenté à
        la "Tableau des valeurs « A » MAX, « B » et « C » issu du schéma d'encombrement TBM2G-068XXX-
        XXXX-00." (➜ p. 116).

        Stack Specific Dimensional Data
         Part Number           "A" Max       "B" REF ±0.35 [0.014] “C” ±0.08 [0.004]
         TBM2G-06808-00 18.34 [0.722]              8.2 [0.323]           14.76 [0.581]

         TBM2G-06813-00 22.84 [0.899]             12.70 [0.500]          19.26 [0.758]

         TBM2G-06826-00 36.44 [1.435]             26.30 [1.035]          32.86 [1.294]

                 Figure 7-5: Tableau des valeurs « A » MAX, « B » et « C » issu du schéma d'encombrement TBM2G-
                 068XXX-XXXX-00.

Exemple :
Pour TBM2G-06813-00, « B » = 12,7 mm nominal et « C » = 19,26 mm nominal. La cote de montage d'origine
(0,70 mm nominal) est déjà indiquée sur le schéma d'encombrement. Nous allons à présent utiliser notre
équation pour le calcul suivant :
           Cote de montage alternative (mm) = 19,26 mm – 12,7 mm – 0,70 mm = 5,86 mm
           nominal

                                                                    KOLLMORGEN | kdn.kollmorgen.com | June 2023     116

TBM2G Instructions | 4 Français

      4.3.7 Interface de câblage électrique

      4.3.7.1 Câblage
      Les moteurs de la série TBM2G peuvent être fournis avec des fils conducteurs volants sans terminaison
      homologués UL. Il incombe à l'utilisateur d'acheminer et de raccorder les fils conformément aux schémas
      Kollmorgen. Évitez d'acheminer les fils sur des coins pointus, des points de pincement ou des bords susceptibles
      de perforer la gaine isolante. Fixez à l'aide d'attaches ou par n'importe quel autre moyen les faisceaux de câbles
      en cas d'applications à fortes vibrations et veillez à ce que les fils ne puissent pas toucher de surfaces mobiles ou
      vibrantes susceptibles d'abraser la gaine isolante. Prévoyez un dispositif anti-traction pour tous les faisceaux de
      câbles et laissez un espace offrant un rayon de courbure important. L'utilisateur est responsable de l'installation
      des connecteurs, de leur sertissage, de leur soudage, de leur blindage, de leur manchonnage et de toute autre
      mise en faisceau ou toute amélioration d'interface électrique allant au-delà de la configuration indiquée sur le
      schéma d'encombrement TBM2G.

      4.3.7.2 Exigences relatives aux fils conducteurs (version fournie sans fil)
      Recommandations/lignes directrices concernant le soudage du fil conducteur sur la pastille.

      4.3.7.3 Caractéristiques générales et câblage des fils d'alimentation
      Caractéristiques générales des fils d'alimentation
       Moteur                     TBM2G-         TBM2G-     TBM2G-       TBM2G-         TBM2G-     TBM2G-      TBM2G-
                                    050            060        068          076            085        094         115
       Type                                                            3 fils volants
       Longueur, mm*                                                         500
       Calibre, AWG                  20            20          20            18           16          14           14
       Diamètre d'isolant           1,47          1,47        1,47         1,70          1,98        2,26         2,26
       nominal, mm
       Rayon de courbure            7,37          7,37        7,37         8,51          9,91        11,3         11,3
       statique min., mm

      *Version fournie sans fil en option (pastille de soudure uniquement)

      INTERFACE ÉLECTRIQUE DES FILS
      D'ALIMENTATION
       Couleur                 Fonction (alt.)
       Rouge                   Phase U (A)
       Blanc                   Phase V (B)
       Noir                    Phase W (C)

117    KOLLMORGEN | kdn.kollmorgen.com | June 2023

                                                                                   TBM2G Instructions | 4 Français

       TABLEAU D'EXCITATION DES FILS D'ALIMENTATION
 ÉTAPE          Phase « U » rouge Phase « V » blanc Phase « W » noir
 1
                        ⊕                    ⊖
 2
                        ⊕                                        ⊖
 3
                                             ⊕                   ⊖
 4
                        ⊖                    ⊕
 5
                        ⊖                                        ⊕
 6
                                             ⊖                   ⊕
Rotation antihoraire observée depuis le côté PCB/sortie de fil

                                                                 KOLLMORGEN | kdn.kollmorgen.com | June 2023   118

TBM2G Instructions | 4 Français

      4.3.7.4 Caractéristiques générales et câblage des dispositifs thermiques
      Pour un fonctionnement continu en toute sécurité des moteurs de la série TBM2G dans des applications à forte
      sollicitation, il est possible de fixer des thermistances à l'ensemble PCB. L'option généralement choisie pour
      TBM2G est une sonde RTD PT1000. Une autre solution consiste à utiliser trois PTC en série, placés chacun
      dans chaque enroulement de phase afin de protéger chaque phase.

      CARACTÉRISTIQUES GÉNÉRALES DES FILS DE PROTECTION THERMIQUE
       Moteur                       TBM2G-     TBM2G-       TBM2G-     TBM2G-         TBM2G-    TBM2G-       TBM2G-
                                      050        060          068        076            085       094          115
       Type                                                          2 fils volants
       Longueur, mm*                                                         500
       Calibre, AWG                    26            26       26             26         26         26           26
       Diamètre d'isolant             0,99           0,99    0,99        0,99          0,99        0,99        0,99
       nominal, mm
       Rayon de courbure              4,95           4,95    4,95        4,95          4,95        4,95        4,95
       statique min., mm

      *Version fournie sans fil en option (pastille de soudure uniquement)

      INTERFACE ÉLECTRIQUE DES FILS DE
      PROTECTION THERMIQUE
       Couleur              Fonction (alt.)
       Blanc                + du capteur thermique
       Blanc                - du capteur thermique

      4.3.7.4.1 Protection thermique
      Deux méthodes permettent de garantir la protection thermique en vue d'un fonctionnement continu. La première
      permet de mesurer en continu la température du moteur à l'aide d'une sonde PT1000. La température du moteur
      est déterminée en mesurant la résistance de la sonde PT1000 conformément à la norme CEI-60751 (voir
      tableau ci-dessous). Comme il n'est possible d'utiliser qu'un seul dispositif de ce type, cette méthode ne permet
      de surveiller qu'une seule phase du moteur. Par conséquent, elle n'est pas recommandée pour les applications
      dans lesquelles le moteur sera longtemps en décrochage.
      La seconde méthode consiste à utiliser trois PTC à avalanche en série. Un PTC est attribué à chacune des trois
      phases afin de s'assurer qu'aucune d'entre elles ne dépasse la température nominale du moteur. Cette solution
      doit être choisie si le moteur est en décrochage pendant une longue période. En fonctionnement normal, la
      résistance des dispositifs restera inférieure à 1 500 ohms. Si une phase atteint 155 °C, la résistance augmentera
      rapidement et dépassera 7 000 ohms.
      Aucune de ces méthodes ne protège le moteur contre la surchauffe lorsqu'un courant supérieur à la capacité de
      charge continue est appliqué. Les dispositifs thermiques ne peuvent pas réagir suffisamment vite pour tenir
      compte du taux de variation de température appliqué en cas de courant de crête. Le variateur doit limiter la durée
      du courant de crête appliqué au moteur pour empêcher ce dernier de surchauffer.

119    KOLLMORGEN | kdn.kollmorgen.com | June 2023

                                                                                                                     TBM2G Instructions | 4 Français

                                      PT1000 Résistance en fonction de la température
                     1800

                     1600
                     1400
Résistance en Ohms

                     1200
                     1000

                      800

                      600

                      400
                      200

                        0
                            0    20      40    60         80   100 120 140       160   180   200
                                                         Température en ˚C

                                15

Cette solution consiste uniquement en une sonde PT1000 en série et donnera le même résultat que celui indiqué
sur le graphique ci-dessus.

                                        PTC-3 in Series Resistance vs. Temperature
100,000

       50,000
Résistance en Ohms

                     10K

                      5K

                     1000
                            0    20       40        60      80    100     120   140    160   180
                                                         Température en ˚C

                                15$                        15$                   15$

Cette solution consiste en trois PTC en série pour protéger chacune des trois phases. Si l'une des phases
s'approche de la température nominale du moteur, la résistance augmentera considérablement.

                                                                                                   KOLLMORGEN | kdn.kollmorgen.com | June 2023   120

TBM2G Instructions | 4 Français

      4.3.7.5 Caractéristiques générales et câblage des capteurs à effet Hall
      CARACTÉRISTIQUES GÉNÉRALES DES CAPTEURS À EFFET HALL
       Moteur                                TBM2G-             TBM2G-             TBM2G-        TBM2G-      TBM2G-     TBM2G-   TBM2G-
                                               050                060                068           076         085        094      115
       Type                                                                            5 fils volants, Allegro A1260
       Tension d'entrée, Vcc                                                                      +5 à 24
       Signal de sortie                                                                      À courant absorbé
       Longueur, mm*                                                                               500
       Calibre, AWG                               26                  26                26          26           26       26       26
       Diamètre d'isolant                        0,99             0,99                0,99         0,99          0,99    0,99     0,99
       nominal, mm
       Rayon de courbure                         4,95             4,95                4,95         4,95          4,95    4,95     4,95
       statique min., mm

      *Version fournie sans fil en option (pastille de soudure uniquement)

      INTERFACE ÉLECTRIQUE DES FILS DES
      CAPTEURS À EFFET HALL
       Couleur                            Fonction (alt.)
       Marron                             Hall 1 (U-V)
       Orange                             Hall 2 (V-W)
       Jaune                              Hall 3 (W-U)
       Bleu                               +5 à 24 Vcc
       Vert                               Terre

      Schéma de câblage des capteurs
                       R = 1.5 kΩ (Fourni par le client)
                                                                                BLEU
                       R                    R                     R        (+5 TO 24 V DC)

       H                    H                     H
           1                    2                     3
                 MARRON               ORANGE                  JAUNE
                  SORTIE               SORTIE                 SORTIE
               PHASE - UV           PHASE - VW            PHASE - WU
                                                                                VERT
                                                                             (TERRAIN)

121    KOLLMORGEN | kdn.kollmorgen.com | June 2023

                                                                                                                 TBM2G Instructions | 4 Français

Schéma de sortie des capteurs
U, V, W phasés pour rotation antihoraire observée côté PCB/sortie de fil

     VOLTS
                    1          2          3          4          5          6

               Bemf U-V

     5
H1                                                                               EN PHASE AVEC Bemf U-V
     0                               Bemf V-W

     5
H2                                                                               EN PHASE AVEC Bemf V-W
     0                                                     Bemf W-U

     5
H3                                                                               EN PHASE AVEC Bemf W-U
     0
              60˚                  180˚                  300˚                  420˚
         0˚             120˚                  240˚                  360˚
              DEGRÉS ÉLECTRIQUES (RELATIFS)

                                                                                               KOLLMORGEN | kdn.kollmorgen.com | June 2023   122

TBM2G Instructions | 4 Français

      4.4 Définition des termes pour les caractéristiques techniques
      Couple de décrochage continu maximal, Tmc [Nm]:Le couple de décrochage continu maximal peut être
                      maintenu indéfiniment à bas régime et aux conditions ambiantes nominales. Une plus forte
                      réduction de la puissance est possible si le régime n'est pas suffisamment élevé pour assurer
                      une répartition de chaleur uniforme sur l'ensemble des phases. Cette valeur suppose une
                      température ambiante de 25 °C.
      Courant continu maximal, Imc [A eff.]:Le courant continu maximal est le courant sinusoïdal efficace que le
                       moteur absorbe à bas régime pour pouvoir délivrer le couple de décrochage continu maximal.
      Vitesse mécanique maximale, Nmax [tr/min]:La vitesse mécanique maximale est la vitesse la plus élevée que
                      peut atteindre le moteur. Elle est limitée par des facteurs mécaniques tels que la résistance
                      d'adhérence de la liaison magnétique.
      Couple de crête, Tp [Nm]:Le couple de crête peut être maintenu pendant de courtes durées, en fonction des
                        conditions ambiantes et du cycle de service global. Cette valeur peut également être limitée
                        en fonction de la tension d'alimentation et des caractéristiques du variateur.
      Courant de crête, Ip [A eff.]:Le courant de crête du moteur (valeur sinusoïdale efficace) est égal à trois fois le
                        courant continu. La valeur réelle est la valeur la moins élevée entre le courant de crête du
                        moteur et le courant de crête du variateur utilisé.
      Couple nominal, Trtd [Nm]:Le couple nominal est délivré lorsque le moteur consomme le courant nominal au
                       régime nominal. Il peut être produit indéfiniment au régime nominal en service continu (Nrtd).
                       Cette valeur suppose une température ambiante de 25 °C.
      Constante de couple, Kt [Nm/A eff.]:La constante de couple définit le couple produit par le moteur par unité de
                      courant. Elle est mesurée à une température ambiante de 25 °C et à une température
                      d'enroulement de 155 °C.
      Constante de FCEM, Ke [V eff./ktr/min]:La constante de FCEM définit la force contre-électromotrice induite du
                      moteur sous forme de valeur sinusoïdale efficace entre deux bornes, pour 1 000 tr/min. Elle
                      est mesurée à une température ambiante de 25 °C et à une température d'enroulement de
                      155 °C.
      Constante moteur, Km [Nm/√W]:Cette constante est généralement utilisée pour comparer la densité de
                      puissance des moteurs au décrochage ou au quasi-décrochage. Elle définit le couple que le
                      moteur peut délivrer à une puissance donnée. Cette valeur est indiquée avec la constante de
                      couple et la résistance à une température d'enroulement de 25 °C.
      Résistance, Rm [Ω]:La résistance est mesurée entre phases et au niveau de la carte à circuits imprimés. Cette
                       valeur n'inclut pas la résistance des fils du moteur. La valeur de résistance est déterminée à
                       25 °C et augmente avec la température d'enroulement.
      Inductance, L [mH]:L'inductance est mesurée entre phases et au niveau de la carte à circuits imprimés. Il s'agit
                       de l'inductance moyenne pour le moteur déterminée par la position du rotor. Cette valeur est
                       mesurée à une température d'enroulement de 25 °C.
      Moment d'inertie du rotor, Jm [kg.cm²]:Le moment d'inertie du rotor prend en compte la capacité d'accélération
                        angulaire du moteur. Cette valeur ne s'applique qu'aux composants d'ensemble inducteur
                        standard (culasse annulaire et anneau magnétique). Les composants fournis par le client
                        entraîneront une modification de l'inertie totale.
      Friction statique, Tf [Nm]:La friction statique correspond au couple à surmonter pour faire tourner le moteur.
                          Cette valeur combine les pertes par hystérésis à bas régime et la valeur maximale du couple
                          de cogging. Elle n'inclut pas les pertes au niveau des paliers du système. Cette friction ne doit
                          pas être incluse dans le calcul des pertes rotationnelles du moteur à haut régime.
      Résistance thermique, Rthw-a [°C/W]:La résistance thermique mesure la hausse de la température en régime
                       permanent par unité d'énergie dissipée par les pertes. Cette valeur suppose que le

123    KOLLMORGEN | kdn.kollmorgen.com | June 2023

                                                                 TBM2G Instructions | 4 Français

moteur TBM2G a été installé dans un boîtier et équipé d'un dissipateur thermique en
aluminium comme spécifié dans la fiche technique catalogue correspondante ou son
équivalent.

                                              KOLLMORGEN | kdn.kollmorgen.com | June 2023   124

TBM2G Instructions | 4 Français

      Notes

      2 mm divisions

125      KOLLMORGEN | kdn.kollmorgen.com | June 2023

                                                                                                TBM2G Instructions | 5 Italiano

5 Italiano

5.1 Generale

5.1.1 Informazioni sul presente manuale
Il presente manuale descrive i TBM2G motori frameless (versione standard). Se i motori TBM2G sono utilizzati
nei sistemi di azionamento insieme a servoazionamenti Kollmorgen®, attenersi all'intera documentazione
relativa al sistema in oggetto, costituita da:

    l       Manuale di installazione dei servoazionamenti
    l       Manuale di comunicazione del bus di campo (ad es. CANopen o EtherCAT)

Ulteriori informazioni di base possono essere reperite nella Kollmorgen Developer Network, disponibile
all'indirizzo kdn.kollmorgen.com.

5.1.2 Abbreviazioni usate

        l   Le abbreviazioni utilizzate per i dati tecnici sono reperibili nella sezione Definizione dei termini.
        l   Nel presente documento il simbolo (➜ # 25) significa: vedere pagina 25.

                                                                          KOLLMORGEN | kdn.kollmorgen.com | June 2023      126

TBM2G Instructions | 5 Italiano

      5.1.3 Simboli usati
                  Simbolo              Significato

                                       Indica una situazione pericolosa che, se non evitata, provoca conseguenze
                                       gravi o letali.
                    PERICOLO
                                       Indica una situazione pericolosa che, se non evitata, può provocare
                                       conseguenze gravi o letali.
                      AVVISO
                                       Indica una situazione pericolosa che, se non evitata, può comportare lesioni
                                       lievi o moderate.
                  ATTENZIONE
                                       Indica situazioni che, se non evitate, possono causare danni materiali.

                                       Questo simbolo indica note importanti.

                                       Avviso di un pericolo (generale). Il tipo di pericolo è specificato dal testo
                                       accanto al simbolo.

                                       Avviso di un pericolo causato dall'elettricità e dai relativi effetti.

                                       Avviso di un pericolo causato da una superficie calda.

                                       Avviso della presenza di carichi sospesi.

127    KOLLMORGEN | kdn.kollmorgen.com | June 2023

                                                                                      TBM2G Instructions | 5 Italiano

5.1.4 Sicurezza
5.1.4.0.1 Note sulla sicurezza

                  AVVISO Pacemaker
                  Gli intensi campi magnetici generati finché non viene installato il rotore magnetico
                  rappresentano un pericolo per i portatori di impianti, ad es. pacemaker cardiaci, che
                  potrebbero subire l'influsso dei campi magnetici. In generale, tutti coloro la cui salute
                  potrebbe risultare compromessa dalla presenza di forti campi magnetici devono tenersi alla
                  distanza di sicurezza di almeno 1 m dal rotore.

                  ATTENZIONE Campo magnetico
                  Gli intensi campi magnetici generati rappresentano un pericolo per i portatori di impianti che
                  potrebbero subire l'influsso dei campi magnetici. In generale, tutti coloro la cui salute
                  potrebbe risultare compromessa dalla presenza di forti campi magnetici devono tenersi alla
                  distanza di sicurezza di almeno 1 m dal motore.
                  Attività quali trasporto, installazione, messa in funzione e manutenzione possono essere
                  eseguite unicamente da personale debitamente qualificato. Con personale debitamente
                  qualificato si intendono persone che hanno dimestichezza con il trasporto, l'installazione, la
                  messa in funzione e l'utilizzo di motori e che sono in possesso delle necessarie qualifiche per
                  il lavoro da svolgere. Il personale qualificato è tenuto a conoscere e rispettare le seguenti
                  norme e direttive: IEC 60364, 60662 e le disposizioni antinfortunistiche nazionali.
                  Le raccomandazioni contenute nel presente documento costituiscono linee guide generali
                  per l'installazione e sono incluse a scopo di consultazione.
                  Kollmorgen non si assume alcuna responsabilità per l'errata implementazione di queste
                  tecniche, che rimane esclusivamente di competenza dell'utilizzatore.

                  ATTENZIONE Indossare guanti
                  Indossare sempre guanti quando si lavora sul motore.
                  Leggere la documentazione disponibile prima di procedere all’installazione e alla messa in
                  funzione. Un uso improprio dei componenti del motore può causare lesioni alle persone e
                  danni alle apparecchiature. Prestare particolare attenzione quando si installa il rotore
                  all'interno dello statore del motore. Potrebbero essere necessari appositi strumenti o
                  attrezzature.

                                                                 KOLLMORGEN | kdn.kollmorgen.com | June 2023        128

TBM2G Instructions | 5 Italiano

                        ATTENZIONE Campo magnetico
                        Campi magnetici intensi attraggono gli oggetti metallici e possono rappresentare un rischio
                        per la sicurezza delle mani e delle dita. Quando si lavora in prossimità dei motori TBM2G
                        accertarsi di avere a portata di mano almeno due cunei a punta fine in robusto materiale non
                        magnetico, ad es. V2A (con un angolo di circa 10°-15°), e un martello non metallico (circa 3
                        kg). In caso di emergenza si potranno usare questi strumenti per staccare oggetti uniti
                        magneticamente al rotore magnetico (ad es. per rimuovere parti del corpo rimaste
                        incastrate).
                        Orologi, supporti dati magnetici (carte di credito, dischetti, ecc.) e display digitali (cellulari,
                        laptop, ecc.)non vanno tenuti nelle immediate vicinanze (<500 mm) del motore TBM2G. Le
                        elevate forze di attrazione richiedono particolare attenzione quando ci si trova a una distanza
                        di circa 50 mm dal rotore magnetico. Entro questa distanza non si devono tenere in mano
                        oggetti in ferro o acciaio pesanti (>1 kg) o con ampia superficie (>1 dm²).
                        Non riporre mai il rotore non debitamente imballato. Per l'imballaggio utilizzare materiale non
                        magnetico con uno spessore di almeno 20 mm. Riporre il rotore in un luogo asciutto e al
                        riparo da fonti di calore. Non esporre il rotore a temperature superiori a 110 °C se non
                        installato all'interno dello statore. Temperature superiori a 110 °C possono smagnetizzare i
                        magneti del rotore.
                        Prevedere cartelli di avviso dove sono riposti i motori: Attenzione: MAGNETI POTENTI
                        Applicare sulla macchina simboli di avviso facilmente visibili (ad es. etichette autoadesive
                        permanenti). Attenzione: Gli azionamenti di questa macchina sono dotati di magneti potenti.
                        CAMPI MAGNETICI INTENSI + ELEVATE FORZE DI ATTRAZIONE

                        PERICOLO Messa a terra Alte tensioni
                        È obbligatorio garantire una corretta messa a terra delle parti metalliche dello statore del
                        motore sulla barra collettrice PE (terra protettiva) nel quadro elettrico ad armadio. In assenza
                        di una terra protettiva a bassa resistenza non è possibile assicurare la sicurezza del
                        personale. Vedere la sezione Messa a terra delle Linee guida per il montaggio e
                        l'installazione della presente documentazione per informazioni più dettagliate.
                        I collegamenti elettrici potrebbero essere sotto tensione anche se il motore non si muove.
                        Non staccare mai i collegamenti elettrici al motore quando è presente tensione. In situazioni
                        sfavorevoli si potrebbero creare archi elettrici, con potenziali lesioni alle persone e danni alle
                        apparecchiature.

129    KOLLMORGEN | kdn.kollmorgen.com | June 2023

                                                                                            TBM2G Instructions | 5 Italiano

5.1.5 Nota importante
È richiesto l’intervento di personale specializzato
Solo personale debitamente qualificato può eseguire attività di trasporto, installazione, configurazione e
manutenzione. Con personale qualificato e specializzato si intende il personale che ha dimestichezza con le fasi
di trasporto, installazione, montaggio, messa in servizio e funzionamento dei motori e che utilizza le qualifiche di
cui dispone per svolgere le rispettive mansioni:

    l   Trasporto: solo a cura di personale con nozioni di movimentazione di componenti sensibili alle cariche
        elettrostatiche.
    l   Installazione meccanica: solo a cura di meccanici qualificati.
    l   Installazione elettrica: solo a cura di elettricisti qualificati.
    l   Configurazione: solo a cura di personale qualificato esperto in elettrotecnica e nelle tecnologie di
        azionamento.

Il personale qualificato è tenuto a conoscere e a rispettare le norme IEC 60364/IEC 60664 e le norme
antinfortunistiche nazionali.
Leggere la documentazione in materia
Leggere la documentazione disponibile prima di procedere all’installazione e alla messa in funzione. L’utilizzo
improprio dello statore/rotore può provocare danni alle persone o alle cose. L'operatore deve quindi garantire
che tutte le persone incaricate di lavorare sul motore frameless abbiano letto e compreso il manuale e che
vengano rispettate le avvertenze di sicurezza di questo manuale.
Prestare attenzione ai dati tecnici
Attenersi ai dati tecnici e alle specifiche relative ai collegamenti (valori nominali elettrici in Technical Data). In
caso di superamento dei valori di tensione o corrente ammessi potrebbero verificarsi danni ai motori frameless,
ad es. a causa del surriscaldamento.
Eseguire una valutazione dei rischi
Il costruttore della macchina deve eseguire una valutazione di rischio per la macchina ed adottare misure
adeguate per evitare che movimenti imprevisti causino lesioni alle persone o danni alle cose. Tale valutazione
potrebbe anche mettere in rilievo requisiti supplementari per il personale specializzato.

                    ATTENZIONE Superficie calda
                    Le superfici dei motori TBM2G possono essere molto calde durante il funzionamento, a
                    seconda della loro categoria di protezione. Rischio di lievi ustioni La temperatura della
                    superficie può superare 155 °C.

                          l   Misurare la temperatura e attendere che la temperatura del motore TBM2G scenda
                              al di sotto di 40 °C prima di toccarlo.

                                                                      KOLLMORGEN | kdn.kollmorgen.com | June 2023        130

TBM2G Instructions | 5 Italiano

                           PERICOLO Messa a terra Alte tensioni
                           È essenziale accertarsi che il motore TBM2G sia messo a terra in sicurezza alla barra
                           collettrice PE (terra protettiva) nell’armadio elettrico. Rischio di scossa elettrica. In assenza
                           di messa a terra a bassa resistenza non è possibile garantire la protezione delle persone e
                           sussiste il rischio di morte per scossa elettrica.

                                 l   L'assenza di display ottici non garantisce l'assenza di tensione. I collegamenti di
                                     alimentazione possono condurre tensione anche se il rotore non ruota.
                                 l   Non scollegare i connettori durante il funzionamento. Toccare i contatti esposti
                                     comporta un pericolo di morte o di lesioni gravi. I collegamenti di alimentazione
                                     possono essere sotto tensione anche se il rotore non ruota. Questo può causare
                                     fiammate con conseguenti lesioni alle persone e danni ai contatti.

                                 l   Dopo aver scollegato il servoazionamento dalla tensione di alimentazione, attendere
                                     alcuni minuti prima di toccare i componenti normalmente sotto tensione (ad es.
                                     contatti, collegamenti a vite) o aprire eventuali collegamenti.

                                 l   I condensatori nel servoazionamento possono ancora condurre una tensione
                                     pericolosa diversi minuti dopo l'interruzione delle tensioni di alimentazione. Per
                                     garantire la sicurezza, misurare la tensione DC-link e attendere che la tensione sia
                                     scesa sotto i 60 V.

      Utilizzo secondo le istruzioni ("Uso previsto")

          l   All'utilizzatore è consentito azionare i motori solo nelle condizioni ambientali che sono definite nella
              presente documentazione.
          l   La serie di motori è destinata esclusivamente ad essere azionata tramite servoazionamenti.
          l   I motori vengono installati come componenti in un apparecchio elettrico o macchine e possono essere
              messi in servizio e in funzione come parti integranti di tali apparecchi o macchine.
          l   L'utilizzatore finale si assume la responsabilità per la conformità delle macchine.

      5.1.6 Uso vietato
      È vietato l'impiego dei motori nei seguenti ambienti, se non previa consultazione dell'assistenza clienti
      Kollmorgen:

          l   zone potenzialmente esplosive
          l   ambienti con acidi corrosivi e/o elettricamente conduttivi, soluzioni alcaline, oli, vapori, polveri
          l   sotto vuoto
          l   direttamente su reti di alimentazione elettrica

      La messa in funzione del motore è vietata se la macchina in cui è stato installato

          l   non soddisfa i requisiti della Direttiva Macchine CE
          l   non è conforme alla direttiva sulla compatibilità elettromagnetica (EMC)
          l   non è conforme alla Direttiva Bassa Tensione

131    KOLLMORGEN | kdn.kollmorgen.com | June 2023

                                                TBM2G Instructions | 5 Italiano

5.1.7 Nomenclatura modello

                             KOLLMORGEN | kdn.kollmorgen.com | June 2023   132

TBM2G Instructions | 5 Italiano

      5.1.8 Panoramica valori di coppia
                               0.72 Nm to 1.75 Nm
       050         0.27 Nm to 0.64 Nm
                                           1.17 Nm to 2.85 Nm
                                                                                  Coppia di picco
       060            0.45 Nm to 0.96 Nm                                          Coppia continua
                               1.53 Nm to 4.13 Nm
       068                  0.63 Nm to 1.54 Nm
                                            2.12 Nm to 5.57 Nm
       076                        0.89 Nm to 2.06 Nm
                                                        3.16 Nm to 7.01 Nm
       085                              1.21 Nm to 2.69 Nm
                                                                      3.75 Nm to 9.01 Nm
       094                                          1.58 Nm to 3.67 Nm
                                                                         3.18 Nm to 15.3 Nm
       115                                   1.90 Nm to 6.03 Nm
             0.0     1.0       2.0         3.0       4.0          5.0     6.0         7.0         8.0   9.0    15.0
                                                           Coppia (Nm)

      5.1.9 Illustrazione dei materiali dei componenti
                                                                                 1. Giogo
                                                                                              Materiale: acciaio inossidabile
                                                                                              l

                                                                                              serie 400
                                                                                 2.   Magnete ad anello
                                                                                            l Materiale: NdFeB (neodimio)

                                                                                            l Rivestimento: epossidico

                                                                                 3.   Scheda a circuito stampato (PCB)
                                                                                 4.   Bobina
                                                                                            l Materiale: rame

                                                                                            l Rivestimento: vernice

                                                                                 5.   Isolatori terminali
                                                                                      Materiale: resina polimerica
                                                                                 6.   Cavi di alimentazione
                                                                                 7.   Pacco di lamine
                                                                                      Materiale: acciaio elettrico
                                                                                 8.   Dispositivi termici opzionali
                                                                                      (montati sotto la PCB)
                                                                                            l PT1000

                                                                                            l PTC a valanga (3 in serie)

                                                                                 9.   Sensori a effetto Hall opzionali
                                                                                      (montati sotto la PCB)
                                                                                            l Allegro A1260

133    KOLLMORGEN | kdn.kollmorgen.com | June 2023

                                                                                              TBM2G Instructions | 5 Italiano

5.2 Linee guida per lo stoccaggio, il funzionamento e il trasporto

5.2.1 Conservazione
Categoria climatica             1K4 secondo IEC 60721-3-1, EN61800-2
Temperatura di                  da -25 a +55 °C, max. variazione 20 °K all'ora
stoccaggio
Umidità                         umidità rel. dal 5% al 95%, senza formazione di condensa
Durata di conservazione         illimitata

Conservare unicamente nell'imballaggio originale del produttore.

5.2.2 Funzionamento
Temperatura ambiente (a da -20 a +40 °C per un'altitudine del sito fino a 1000 m slm
valori nominali)
Umidità ammessa (a              95% di umidità relativa, senza formazione di condensa
valori nominali)
Riduzione di potenza            Nessuna riduzione della potenza per altitudini del sito oltre 1000 m slm con
(correnti e coppie)             riduzione della temperatura di 10 °K ogni 1000 m. Accertarsi che la temperatura
                                degli avvolgimenti non superi 155 °C.

5.2.3 Trasporto
Categoria climatica             2K3 secondo IEC 60721-3-2, EN61800-2
Temperatura di                  da -25 a +70 °C, max. variazione 20 °K/ora
stoccaggio
Umidità                         umidità rel. dal 5% al 95%, senza formazione di condensa

Evitare gli urti. Se l'imballaggio è danneggiato, controllare che i componenti del motore non presentino danni
visibili. Informare il trasportatore e, se del caso, il produttore.

5.2.4 Rimozione dell'imballaggio
Il gruppo rotore/statore viene di norma spedito insieme in un imballaggio unico o collettivo. Come opzione
speciale è possibile avere un imballaggio collettivo personalizzato. Rotore e statore sono separati da materiale di
riempimento per evitare urti dovuti alle elevate forze magnetiche. Prestare attenzione durante la rimozione
dell'imballaggio a tenere separati i componenti e a evitare che il rotore altamente magnetizzato urti contro altri
oggetti.
Lo statore può contenere, se richiesto, dispositivi con sensori a effetto Hall. Tali dispositivi possono essere
soggetti a danni dovuti a elettricità statica. Per la spedizione di statori con dispositivi a effetto Hall sono previsti
sacchetti antistatici. Durante la rimozione dell'imballaggio evitare di eliminare la protezione antistatica.

                                                                        KOLLMORGEN | kdn.kollmorgen.com | June 2023        134

TBM2G Instructions | 5 Italiano

      5.3 Linee guida per il montaggio e l'installazione

      Le raccomandazioni contenute nel presente manuale Kollmorgen costituiscono linee guide generali per
      l'installazione e sono incluse unicamente a scopo di consultazione. Kollmorgen non si assume alcuna
      responsabilità per l'errata implementazione di queste tecniche, che rimane esclusivamente di competenza
      dell'utilizzatore.

      5.3.1 Definizioni di gruppo indotto e gruppo campo
      Gruppo indotto (statore)
      Il gruppo indotto è la parte fissa del motore frameless. Questo gruppo include le lamine in acciaio magnetico, le
      bobine e il gruppo cavi. Può anche contenere in via opzionale altri elementi quali dispositivi a effetto Hall o
      sensori termici.
      Gruppo campo (rotore)
      Il gruppo campo è la parte mobile del motore frameless. Questo gruppo comprende un magnete ad anello in
      elementi delle terre rare e un anello a giogo.
      Motore frameless (gruppo)
      Un motore prodotto e spedito in componenti separati: statore e rotore. I singoli componenti devono essere
      assemblati in un alloggiamento realizzato a cura dell'utilizzatore finale, con sistema di supporto a cuscinetti.

135    KOLLMORGEN | kdn.kollmorgen.com | June 2023

                                                                                             TBM2G Instructions | 5 Italiano

5.3.2 Responsabilità dell'utilizzatore in merito all'interfaccia
Per garantire l'affidabilità e prestazioni adeguate del motore una volta installato nel sistema, l'utilizzatore è
responsabile della progettazione dell'interfaccia di montaggio sulla base delle informazioni seguenti a titolo di
linee guida. L'utilizzatore è tenuto a progettazione l'albero del rotore, il case dello statore e il sistema di supporto
a cuscinetti, a definire i dettagli dell'alloggiamento, a provvedere alla selezione dei materiali, ai calcoli di
adattamento e all'analisi delle tolleranze sulla base dei requisiti dell'applicazione prevista.

5.3.2.1 Cuscinetti
Il sistema di cuscinetti fornito dall'utilizzatore per l'applicazione motore deve essere sufficientemente rigido da
mantenere un gioco uniforme tra rotore e statore in tutte le condizioni di esercizio. Un gioco uniforme include i
limiti di coassialità e concentricità tra rotore e statore.

5.3.2.2 Materiali per il montaggio dello statore
Per un montaggio rigido dello statore finalizzato a garantire il miglior percorso conduttivo per la dissipazione del
calore e la corretta integrità strutturale, si consiglia di utilizzare un alloggiamento metallico o una struttura di
fissaggio adeguata. Si prediligono le leghe di alluminio per l'ottima conduttività termica e l'eccellente rapporto
resistenza/peso, sebbene le leghe di acciaio inossidabile (serie 300 o equivalente) sono un'alternativa
accettabile per applicazioni meno critiche a livello termico. Le scelte meno appetibili per il montaggio dello
statore includono acciaio al carbonio, ghisa, leghe inossidabili della serie 400 e altri metalli ferrosi che
conducono un flusso magnetico. In caso di impiego di questi metalli, consultare un tecnico Kollmorgen per
ricevere assistenza. Si sconsiglia l'uso di plastica o altri materiali termoisolanti simili, poiché influiscono
negativamente sulla capacità di dissipazione termica del sistema, rendendo necessaria una consistente
riduzione di potenza del motore.

5.3.2.3 Materiali per il montaggio del rotore
Il rotore magnetizzato può essere montato su qualsiasi albero metallico scelto dall'utilizzatore. I materiali più
comuni per gli alberi sono acciaio al carbonio e acciaio inossidabile, sebbene si utilizzino talvolta leghe di
alluminio se adeguatamente concepite per la coppia e l'intervallo di esercizio termico previsti. Il metodo di
fissaggio del rotore all'albero può influire sulla scelta ottimale del materiale e delle tolleranze per l'albero. Non
necessario che l'albero sia vettore di flusso o faccia parte del circuito magnetico per ottenere le prestazioni
nominali quando si impiega un motore brushless Kollmorgen.

5.3.2.4 Messa a terra
       Una volta montato nell'applicazione, il pacco di lamine (o manicotto esterno in metallo non rivestito) dello
       statore deve trovarsi allo stesso potenziale elettrico di terra del telaio del sistema e del telaio del
       servoazionamento. In assenza di questo percorso di messa a terra comune, l'applicazione può essere
       soggetta a disturbi elettrici e rappresentare inoltre un rischio di scossa elettrica. Il rischio di scossa è
       particolarmente alto in caso di motori con elevato numero di poli ed elevata capacità. Di norma, se si
       utilizzano componenti metallici elettricamente conduttivi per il montaggio dello statore, si ottiene
       automaticamente un robusto percorso di messa a terra tra il pacco di lamine dello statore e il telaio della
       macchina. Kollmorgen consiglia vivamente di eseguire una verifica di continuità per confermare la
       presenza di un adeguato percorso di messa a terra prima di mettere in funzione il motore. In alcune
       applicazioni, in base alla configurazione di montaggio e ai materiali scelti, può essere necessaria una
       fascetta di messa a terra conduttiva separata. In questi caso l'utilizzatore è responsabile dell'installazione
       del percorso di messa a terra e della verifica elettrica.

                                                                       KOLLMORGEN | kdn.kollmorgen.com | June 2023         136

TBM2G Instructions | 5 Italiano

      5.3.2.5 Istruzioni di base per il montaggio
                           I motori della serie TBM2G di Kollmorgen e altri motori brushless frameless
                           utilizzano magneti ad alte prestazioni a base di elementi delle terre rare.
                           Usare la massima cautela durante la manipolazione o il trasporto per evitare
                           lesioni e danni al prodotto. Le forze di attrazione tra i rotori magnetizzati e
                           oggetti metallici vicini possono essere molto elevate. Una manipolazione non
                           adeguata può causare urti imprevisti e improvvisi. L'intenso campo
                           magnetico può inoltre danneggiare PC, monitor e dispositivi di archiviazione
                           posti nelle vicinanze. Mantenere il rotore all'interno del contenitore di
                           spedizione o adeguatamente protetto fino al momento dell'installazione. In
                           questo modo si eviteranno incidenti e contaminazioni dovute ad es. a sfridi
                           metallici o detriti che potrebbero attaccarsi ai magneti.

      Di seguito è riportato un processo di montaggio generico cui attenersi quando si inserisce un rotore (gruppo
      campo) in uno statore (gruppo indotto)

      1. Posizionare l'alloggiamento fornito da cliente su una base stabile e fissarlo per evitare spostamenti
         improvvisi.
      2. Far scivolare lo statore nell'alloggiamento e assicurarlo incollandolo o bloccandolo come illustrato in
         Procedure di montaggio dello statore.
      3. Far scivolare il rotore sull'albero fornito dal cliente e assicurarlo incollandolo o bloccandolo come illustrato in
         Procedure di montaggio del rotore.

           I magneti in elementi delle terre rare sono soggetti alla formazione di cricche e schegge. Fare attenzione a
           non farli cadere e a evitare urti con altre superfici durante il montaggio del rotore sull'albero.
      4. Prima di inserire il gruppo rotore/statore nel gruppo statore/alloggiamento, Kollmorgen consiglia vivamente
         di applicare un sottile strato di materiale con funzione di spessore, ad es. Mylar® film, nel foro interno dello
         statore.
              l Il film di Mylar può essere applicato come un pezzo unico avvolto interamente intorno alla

                circonferenza del foro dello statore o in più pezzi inseriti assialmente in punti equidistanti. Lo spessore
                ottimale del film e il numero di strati applicati dipende dal gioco tra rotore e statore relativo alla
                specifica taglia del motore che l'utilizzatore intende installare. Vedere la tabella sui giochi di
                scorrimento radiale riportata di seguito.

                  La superficie esterna del rotore può attaccarsi al punto più vicino sul foro interno dello statore a
                  causa delle forze di attrazione magnetica quando l'utilizzatore tenta di installatore il rotore. L'attrito
                  risultante durante lo scorrimento del rotore sulla parte interna dello statore potrebbe danneggiare la
                  banda, i magneti e i rivestimenti del rotore o le superfici del foro dello statore.
      5. Inserire il rotore procedendo lentamente e con cautela lungo l'asse centrale per posizionarlo all'interno dello
         statore. Questa operazione può essere svolta a mano o con un'attrezzatura di installazione personalizzata.
      6. Installare sul gruppo rotore i cuscinetti necessari a mantenere l'allineamento dell'albero prima di rimuovere
         gli spessori.
      7. Rimuovere gli spessori inseriti nella luce tra il rotore e lo statore prima di procedere alla messa in funzione.

      Gioco di scorrimento radiale tipico
                                   Dimensioni telaio TBM2G
                                   050          060          068          076          085          094          115
       Luce           mm           0,26         0,29         0,26         0,26         0,26         0,26         0,40
       meccanica
       nominale       in           0,010        0,011        0,010        0,010        0,010        0,010        0,016

137    KOLLMORGEN | kdn.kollmorgen.com | June 2023

                                                                                          TBM2G Instructions | 5 Italiano

                             Dimensioni telaio TBM2G
                             050         060          068          076          085          094          115
L'utilizzatore deve tenere conto dei requisiti di concentricità indicati su ciascun disegno di massima Kollmorgen
per un dato modello. Scegliere cuscinetti con valori di attrito il più possibile bassi e lubrificante di alta qualità
per ridurre l'attrito globale del sistema, garantendo in tal modo un funzionamento ottimale del motore.

                                                                    KOLLMORGEN | kdn.kollmorgen.com | June 2023         138

TBM2G Instructions | 5 Italiano

      5.3.3 Procedure di montaggio dello statore
      Kollmorgen consiglia le seguenti opzioni per l'installazione dello statore del motore in funzione di coppia,
      vibrazione e caratteristiche termiche dell'applicazione, nonché costo, facilità di montaggio e manutenzione
      secondo le esigenze dell'utilizzatore.

      5.3.3.1 Incollaggio dello statore

      Pulire a fondo le superfici dello statore e dell'alloggiamento prima di procedere all'incollaggio per assicurare una
      buona adesione. Consultare la scheda tecnica dell'adesivo utilizzato per le procedure di pulizia a seconda del
      materiale dell'alloggiamento.

      Nella maggior parte dei casi, nei motori con intervallo di coppia di piccolo fino a 2.400 Nm lo statore può essere
      fissato in posizione con un materiale epossidico strutturale, ad es. 3M™ Scotch-Weld™ 2214 o altri adesivi
      simili. L'incollaggio è una tecnica di installazione permanente preferita per tutti gli statori TBM2G. Come mostrato
      sotto nelle figure relative all'incollaggio dello statore, per utilizzare adeguatamente questa tecnica è necessario
      che il case dello statore abbia una forma cilindrica, con un piccolo spallamento per il posizionamento assiale a
      un'estremità e aperto all'altra estremità. Lo spallamento funge da fine corsa per lo statore una volta inserito
      dall'estremità aperta e in generale deve superare il diametro esterno massimo del giro finale dell'avvolgimento
      come riportato nel disegno di massima. I rilievi sugli angoli sono necessari per contenere gli spigoli vivi delle
      lamine dello statore. Un piccolo smusso interno all'estremità aperta dell'alloggiamento aiuta l'inserimento dello
      statore. Se la procedura di montaggio viene eseguita con l'alloggiamento dello statore in piano [asse di rotazione
      verticale], la pressione idrostatica dell'adesivo strutturale contribuisce all'autocentraggio dello statore
      nell'alloggiamento.
                                                                             1.   Cuscinetto cliente
                                                                             2.   Alloggiamento cliente
                                                                             3.   Retroazione cliente
                                                                             4.   Statore TBM2G

                          STOP DI PROFONDITÀ                                      0.025 MM [0.010 IN.] MIN.
                  CARATTERISTICA DELLA SPALLA                                     DISTANZA DA TUTTI I
                                                        SCANALATURE               GIUNTI DI SALDATURA
          L'ISOLANTE PUÒ TOCCARE L'ALLOGGIAMENTO       DEL SERBATOIO                0.13 - 0.26 MM [0.006 - 0.010 IN.]
                             SU QUESTA ESTREMITÀ        DELL'ADESIVO                SCANALATURA ADESIVA
                                                                                    AGGIUNTIVA 50+% DELLA
                                                                                    SUPERFICIE

                                                                                         0.025/0.050 MM
                                                                                         DISTANZA NOMINALE
                                                                                         (RADIALE) PER LATO

                                                                              EPOSSIDICO STRUTTURALE
                                                                              CONSIGLIATO: 3M SCOTCHWELD 2214
                                                                              HYSOL EA934NA

               Figure 8-1: Incollaggio dello statore

139    KOLLMORGEN | kdn.kollmorgen.com | June 2023

                                                                                            TBM2G Instructions | 5 Italiano

Temperature estreme possono rappresentare un potenziale problema a causa dei diversi coefficienti di
dilatazione termica [ad es. delle lamine in acciaio rispetto all'alloggiamento in alluminio]. L'utilizzatore deve
consultare il produttore dell'adesivo per indicazioni in merito allo spessore corretto per il cordone adesivo, al
processo di applicazione e alle modalità di manutenzione. Le scanalature presenti nel diametro interno
dell'alloggiamento illustrato nelle figure relative all'incollaggio dello statore hanno la funzione di serbatoi di
adesivo per il denso materiale epossidico strutturale e contribuiscono a incrementare la resistenza alla torsione
in un ampio intervallo di temperature. Se si utilizza un adesivo epossidico denso, il diametro interno
dell'alloggiamento cilindrico deve essere di circa 0,05 - 0,1 mm superiore al diametro esterno massimo dello
statore. Se utilizzati come consigliato dal produttore, questi adesivi assicurano una durata e una resistenza
notevoli nel tempo.
Se al posto di un materiale epossidico strutturale si preferisce un composto bloccante LOCTITE® 640™ o un
altro adesivo simile, occorre verificare che il gioco tra il diametro interno dell'alloggiamento e il diametro esterno
dello statore sia minore per mantenere un idoneo spessore del cordone adesivo. Consultare le linee guida del
produttore per eventuali indicazioni.

L'utente si assume la responsabilità della selezione dell'adesivo adatto e della progettazione delle dimensioni
dell'alloggiamento in base al coefficiente di dilatazione termica previsto in funzione degli estremi di temperatura
dell'applicazione. Le temperature di indurimento degli adesivi non devono superare i 155 °C per evitare danni
allo statore.

                                                                      KOLLMORGEN | kdn.kollmorgen.com | June 2023        140

TBM2G Instructions | 5 Italiano

      5.3.3.2 Bloccaggio dello statore
      Per applicazioni in cui lo statore potrebbe essere sottoposto a montaggio e smontaggio continui, il bloccaggio
      assiale potrebbe rappresentare un'opzione accettabile. Kollmorgen in genere non raccomanda questa tecnica
      per applicazioni soggette a vibrazioni e urti notevoli o a temperature estreme senza particolari indicazioni di
      progettazione. Il case dello statore mostrato nella figura sottostante è molto simile a quanto illustrato per la
      tecnica di incollaggio con adesivo epossidico. Quando si monta lo statore utilizzando la tecnica di bloccaggio, il
      diametro interno dell'alloggiamento cilindrico deve essere di circa 0,025 - 0,050 mm superiore al diametro
      esterno massimo dello statore. Se si desidera, il piccolo spazio radiale tra il diametro esterno dello statore e il
      diametro interno dell'alloggiamento può essere riempito con un composto termico per garantire una conduzione
      più efficiente verso il dissipatore di calore.

      Usare la massima cautela per non contaminare le superfici di bloccaggio assiale con grassi che potrebbero
      ridurre l'attrito di bloccaggio.

      È necessario uno spallamento lavorato a macchina con funzione di fine corsa e punto di posizionamento per lo
      statore una volta inserito. Occorre un anello di bloccaggio separato all'estremità opposta dello statore, da
      imbullonare all'alloggiamento con 4-12 dispositivi di fissaggio equidistanti. Aumentare al massimo la superficie di
      bloccaggio utilizzando le dimensioni indicate nel disegno di massima. In questo modo si riduce la sollecitazione
      di bloccaggio che agisce sullo statore. Prevedere per il foro dell'alloggiamento una profondità tale da garantire il
      contatto tra l'anello di bloccaggio e il nucleo dello statore prima del contatto con l'alloggiamento in tutte le
      condizioni di tolleranza e temperatura. Il bloccaggio sulla superficie dell'alloggiamento prima che sullo statore
      determinerà una forza di bloccaggio insufficiente. Vedere il disegno di massima per le tolleranze applicate allo
      statore. Le pressioni di bloccaggio dipendono dalla superficie e dalla forza di bloccaggio. La pressione di
      bloccaggio deve essere compresa tra 5 e 20 Mpa (da 725 psi a 2900 psi). Prestare attenzione per evitare
      pressioni di bloccaggio eccessive. Pressioni estreme causeranno un aumento delle perdite dal nucleo in
      presenza di elevate velocità di rotazione. Prestare inoltre attenzione per garantire un precarico sufficiente sui
      bulloni di bloccaggio. Questa misura, insieme a un frenafiletti amovibile, eviterà che i bulloni di bloccaggio si
      allentino dopo un uso prolungato.
                                                                                            1. Alloggiamento cliente
                                                                                            2. Statore TBM2G
                                                                                            3. Anello di bloccaggio dello
                                                                                               statore

                            STOP DI PROFONDITÀ                          L'ANELLO DI SERRAGGIO DEVE AVERE
                               CARATTERISTICA                           UNO SPAZIO DIETRO PER CONSENTIRE
                                  DELLA SPALLA                          LA COMPRESSIONE DELLA SPALLA
                                                                        DELLO STATORE.
                         L'ISOLANTE PUÒ TOCCARE                              0.012/0.025 MM DISTANZA
                             L'ALLOGGIAMENTO SU                              NOMINALE (RADIALE) PER LATO
                                QUESTA ESTREMITÀ

                                                                            L'ANELLO DI SERRAGGIO CON
                                                                            I BULLONI DEVE IMPEGNARE
                                                                            ALMENO LA METÀ DELLA
                                                                            SPALLA DELLO STATORE

               Figure 8-2: Bloccaggio dello statore

141    KOLLMORGEN | kdn.kollmorgen.com | June 2023

                                                                           TBM2G Instructions | 5 Italiano

5.3.4 Procedure di montaggio del rotore
                I motori della serie TBM2G di Kollmorgen e altri motori brushless frameless
                utilizzano magneti ad alte prestazioni a base di elementi delle terre rare.
                Usare la massima cautela durante la manipolazione o il trasporto per evitare
                lesioni e danni al prodotto. Le forze di attrazione tra i rotori magnetizzati e
                oggetti metallici vicini possono essere molto elevate. Una manipolazione non
                adeguata può causare urti imprevisti e improvvisi. L'intenso campo
                magnetico può inoltre danneggiare PC, monitor e dispositivi di archiviazione
                posti nelle vicinanze. Mantenere il rotore all'interno del contenitore di
                spedizione o adeguatamente protetto fino al momento dell'installazione. In
                questo modo si eviteranno incidenti e contaminazioni dovute ad es. a sfridi
                metallici o detriti che potrebbero attaccarsi ai magneti.

5.3.4.1 Controllo della coassialità radiale
                I disegni di massima specifici per i modelli di Kollmorgen evidenziano un
                requisito di montaggio relativo alla coassialità del diametro interno del rotore
                con il diametro esterno dello statore. L'indicazione si riferisce ai requisiti di
                coassialità tra il diametro esterno dell'albero e il diametro interno
                dell'alloggiamento. L'utilizzatore è responsabile della progettazione
                dell'albero, dell'alloggiamento e del sistema di cuscinetti in conformità con il
                limite di coassialità specificato tra il diametro esterno della superficie di
                incollaggio dell'albero e il diametro interno della superficie di incollaggio
                dell'alloggiamento. Se si rispetta questo requisito, la concentricità globale del
                diametro esterno del rotore rispetto al diametro interno dello statore risulterà
                accettabile.

                                                        KOLLMORGEN | kdn.kollmorgen.com | June 2023   142

TBM2G Instructions | 5 Italiano

      5.3.4.2 Incollaggio del rotore

      Pulire a fondo le superfici dello statore e dell'alloggiamento prima di procedere all'incollaggio per assicurare una
      buona adesione. Consultare la scheda tecnica dell'adesivo utilizzato per le procedure di pulizia a seconda del
      materiale dell'alloggiamento.

      In generale, per applicazioni in cui la coppia di picco non supera 750 Nm è possibile incollare i rotori ad alberi in
      acciaio al carbonio o acciaio inossidabile. Con composti bloccanti, ad es. LOCTITE® 640™ o altri adesivi simili
      sono di regola necessari diametri continui e uniformi dell'interfaccia e tolleranze di accoppiamento ristrette, ad
      es. luci nominali pari a 0,012 mm - 0,025 mm. I materiali epossidici strutturali richiedono generalmente giochi di
      accoppiamento di poco superiori per ottenere un cordone di incollaggio più spesso. Per i materiali epossidici
      risultano spesso vantaggiose scanalature nell'interfaccia albero/rotore che fungono da serbatoi di adesivo; sono
      inoltre utili superfici testurizzate mediante zigrinatura o granigliatura. Rivolgersi al produttore dell'adesivo per
      indicazioni sul corretto spessore del cordone di incollaggio, sulle tolleranze di accoppiamento, sui dettagli del
      processo e sulle procedure di indurimento.
      Per evitare la parziale smagnetizzazione del rotore, non indurire i giunti adesivi rotore/albero a temperature
      superiori a 110 °C a meno che il rotore non sia integrato nello statore corrispondente o sia completamente
      circondato da un'armatura di protezione in metallo ferroso. Consultare un tecnico Kollmorgen per maggiori
      informazioni su questo argomento. Prima di incollare rotori ad alberi in alluminio, chiedere assistenza al
      produttore dell'adesivo. Potrebbe essere necessario un adesivo altamente flessibile con notevoli proprietà
      termiche.
                                                                                1. Albero cliente
                                                                                2. Gruppo campo (rotore)

                                                                            ASSEMBLAGGIO DEL CAMPO

                                                                                 0.012/0.025 MM DISTANZA
                                                                                 NOMINALE (RADIALE) PER LATO

                                     PROFONDITÀ DI
                                     MONTAGGIO
                                                                                ALBERO DEL CLIENTE
                                     ALLA SPALLA

               Figure 8-3: Incollaggio del rotore

143    KOLLMORGEN | kdn.kollmorgen.com | June 2023

                                                                                            TBM2G Instructions | 5 Italiano

5.3.5 Procedure di montaggio assiale

5.3.5.1 Controllo dell'allineamento assiale
I disegni di massima specifici per i modelli di Kollmorgen indicano la necessità di mantenere l'allineamento
assiale tra rotore e statore una volta montati per garantire adeguate prestazioni del motore. L'utilizzatore è
responsabile della progettazione dell'albero del rotore, del case dello statore e del sistema di cuscinetti
finalizzata al conseguimento dell'allineamento di montaggio specificato. Per controllare la posizione di
installazione del rotore si utilizzano di norma spallamenti lavorati a macchina presenti sull'albero o sulle
scanalature per anelli di ritegno rimovibili. Il diametro massimo degli anelli di ritegno o degli spallamenti per
l'albero deve essere mantenuto inferiore al diametro del rotore laddove i magneti sono incollati al mozzo in
acciaio.

                                                                      KOLLMORGEN | kdn.kollmorgen.com | June 2023      144

TBM2G Instructions | 5 Italiano

      5.3.6 Montaggio assiale
      Per assicurare prestazioni ottimali e una corretta attivazione dei dispositivi a effetto Hall, Kollmorgen specifica
      una quota di montaggio tra il bordo del pacco di lamine e il bordo dell'anello a giogo [Kollmorgen].
      Questa quota di montaggio assicura la copertura completa del pacco di lamine da parte del materiale magnetico
      e, se del caso, l'estensione assiale dello stesso per attivare i dispositivi a effetto Hall.
                                             "A"
                                            MAX.
                                                       ARMATURA
                                            "B"
                                                           3.00 [0.118] MAX. SALDARE E RISCALDARE
                  4.70 [0.185] MAX                         ECCESSIVAMENTE IL PICCHETTO VEDERE NOTA 3
                                                                              A

                                                                                                              ANELLO DI YOKE
              ASSEMBLAGGIO
                 DEL CAMPO
                                                           2X 30°

      Ø 91.13 [3.588]
          MAX.
                                                          2X 0.50
                                                          [0.020]
                                                          CAMERA
                                  "C"
                                                                          Ø93.96 - 94.04
                  Ø46.98 - 47.02                                           [3.700 - 3.702]
                   [1.850 - 1.851]
                     0.07 [0.003] A
                  REQUISITI DI
                  MONTAGGIO
                                                                Ø92.33
                                                                [3.635]
                                                                 MAX

                                                                                                       0.70±0.40 [0.028±0.015]
                                                                                                       MTG DIM
               0.70±0.40 [0.028±0.015]
                            MTG DIM                    ANGOLO VIVO SU ENTRAMBI I LATI.
                                                       SOTTOSQUADRO RICHIESTO SUI
                                                       COMPONENTI DI ACCOPPIAMENTO
                                         SEZIONE A-A

                        Figure 8-4: Illustrazione della quota di montaggio riportata su un disegno di massima di un TBM2G-068XXX-
                        XXXX-00. Questa quota viene misurata dal bordo sinistro del pacco di lamine al bordo sinistro del materiale del
                        giogo (non del magnete).

      Se si desidera stabilire la quota di montaggio alternativa dall'altro lato del pacco di lamine, è possibile calcolare il
      valore nominale utilizzando alcuni parametri a partire dal disegno Per calcolare il valore nominale dal bordo
      destro del pacco di lamine al bordo destro del materiale del gioco, utilizzare l'equazione seguente:
                         Quota di montaggio alternativa (mm, nominale) = “C” – “B” – 0,70 mm

145     KOLLMORGEN | kdn.kollmorgen.com | June 2023

                                                                                           TBM2G Instructions | 5 Italiano

Come esempio di calcolo della quota di montaggio alternativa useremo:

    l   Le quote per TBM2G-06813-00 dal disegno di massima di TBM2G-068XXX-XXXX-00 in "Illustrazione
        della quota di montaggio riportata su un disegno di massima di un TBM2G-068XXX-XXXX-00. Questa
        quota viene misurata dal bordo sinistro del pacco di lamine al bordo sinistro del materiale del giogo (non
        del magnete)." (➜ p. 145).
    l   L'equazione per la quota di montaggio alternativa
    l   Una tabella dal disegno di massima di TBM2G-068 che riporta i valori di “B” e “C”, mostrata in "Tabella dei
        valori di “A” MAX, “B” e “C” dal disegno di massima di TBM2G-068XXX-XXXX-00." (➜ p. 146).

        Stack Specific Dimensional Data
         Part Number           "A" Max       "B" REF ±0.35 [0.014] “C” ±0.08 [0.004]
         TBM2G-06808-00 18.34 [0.722]               8.2 [0.323]           14.76 [0.581]

         TBM2G-06813-00 22.84 [0.899]             12.70 [0.500]           19.26 [0.758]

         TBM2G-06826-00 36.44 [1.435]             26.30 [1.035]           32.86 [1.294]

                 Figure 8-5: Tabella dei valori di “A” MAX, “B” e “C” dal disegno di massima di TBM2G-068XXX-XXXX-00.

Esempio:
Per TBM2G-06813-00, “B” = 12,7 mm nominale e “C” = 19,26 mm nominale. La quota di montaggio originale,
0,70 mm nominale, è già indicata nel disegno di massima. Applicando la nostra equazione possiamo calcolare
quanto segue:
           Quota di montaggio alternativa (mm) = 19,26 mm – 12,7 mm – 0,70 mm = 5,86
           mm nominale

                                                                     KOLLMORGEN | kdn.kollmorgen.com | June 2023        146

TBM2G Instructions | 5 Italiano

      5.3.7 Interfaccia di cablaggio elettrico

      5.3.7.1 Cablaggio
      I motori della serie TBM2G sono disponibili con cavi flying lead senza terminazioni conformi a UL. L'utilizzatore è
      responsabile del corretto instradamento dei cavi e del collegamento degli stessi come da schemi riportati nei
      disegni Kollmorgen. Evitare percorsi dove i cavi debbano attraversare spigoli vivi, rischiando di restare pizzicati e
      di forare la guaina isolante. Bloccare o fissare in altro modo i fasci di cavi in applicazioni con vibrazioni elevate ed
      evitare il contatto con superfici mobili o vibranti che potrebbero abradere la guaina isolante. Prevedere sistemi di
      allentamento della tensione per i fasci di cavi e garantire spazio a sufficienza per la piegatura. L'utente si assume
      la responsabilità dell'installazione dei connettori, della crimpatura, della saldatura, della schermatura, del
      montaggio di bussole o di qualsiasi altro tipo di sistema di raggruppamento dei cavi o di miglioramento
      dell'interfaccia elettrica in aggiunta alla configurazione mostrata nel disegno di massima di TBM2G.

      5.3.7.2 Requisiti per i cavi (nessuna opzione)
      Raccomandazioni/linee guida per la saldatura del cavo sulla piastra.

      5.3.7.3 Specifiche generali e cablaggio dei cavi di alimentazione
      SPECIFICHE GENERALI DEI CAVI DI ALIMENTAZIONE
       Motore                        TBM2G-        TBM2G-      TBMG-       TBM2G-         TBM2G-     TBM2G-       TBM2G-
                                       050           060        068          076            085        094          115
       Tipo                                                               3 flying lead
       Lunghezza, mm*                                                         500
       Diametro filo, AWG               20           20          20           18            16          14            14
       Diametro nominale               1,47         1,47        1,47         1,70          1,98        2,26          2,26
       guaina isolante, mm
       Min. raggio di curvatura        7,37         7,37        7,37         8,51          9,91        11,3          11,3
       statico, mm

      *Versione senza cavo opzionale (solo piastra saldata)

      INTERFACCIA ELETTRICA DEI CAVI DI
      ALIMENTAZIONE
       Colore                     Funzione (alt)
       Rosso                      Fase U (A)
       BIANCO                     Fase V (B)
       Nero                       Fase W (C)

147    KOLLMORGEN | kdn.kollmorgen.com | June 2023

                                                                                 TBM2G Instructions | 5 Italiano

  TABELLA DI ECCITAZIONE DEI CAVI DI ALIMENTAZIONE
PASSO          Fase "U" rosso Fase "V" bianco Fase "W" nero
1
                     ⊕                ⊖
2
                     ⊕                             ⊖
3
                                      ⊕            ⊖
4
                     ⊖                ⊕
5
                     ⊖                             ⊕
6
                                      ⊖            ⊕
Rotazione CW vista da PCB/estremità uscita cavo

                                                              KOLLMORGEN | kdn.kollmorgen.com | June 2023   148

TBM2G Instructions | 5 Italiano

      5.3.7.4 Specifiche generali e cablaggio dei dispositivi termici
      Per garantire un funzionamento sicuro continuo dei motori della serie TBM2G in applicazioni complesse, è
      possibile collegare alla scheda PCBA termistori integrati. L'opzione tipica per TBM2G è un rilevatore di
      temperatura a resistenza (RTD) PT1000. In alternativa, tre dispositivi PTC cablati in serie, uno per avvolgimento,
      assicurano protezione ad ogni fase.

      SPECIFICHE GENERALI DEI CAVI TERMICI
       Motore                       TBM2G-       TBM2G-       TBMG-       TBM2G-         TBM2G-     TBM2G-       TBM2G-
                                      050          060         068          076            085        094          115
       Tipo                                                              2 flying lead
       Lunghezza, mm*                                                        500
       Diametro filo, AWG              26           26           26          26            26          26           26
       Diametro nominale              0,99         0,99         0,99        0,99          0,99        0,99         0,99
       guaina isolante, mm
       Min. raggio di curvatura       4,95         4,95         4,95        4,95          4,95        4,95         4,95
       statico, mm

      *Versione senza cavo opzionale (solo piastra saldata)

      INTERFACCIA ELETTRICA DEI CAVI TERMICI
       Colore               Funzione (alt)
       Bianco               Sensore termico +
       Bianco               Sensore termico -

      5.3.7.4.1 Protezione termica
      Esistono due metodi per la protezione termica in caso di funzionamento continuo. Il primo metodo prevede la
      misurazione continua della temperatura del motore utilizzando un PT1000. La temperatura del motore viene
      determinata misurando la resistenza del PT1000 secondo IEC-60751 (vedere grafico sottostante). Dal momento
      che è possibile usare solo un dispositivo, questo metodo è in grado di monitorare unicamente una delle fasi del
      motore. Pertanto è sconsigliato per applicazioni in cui il motore resta in stallo per un periodo prolungato.
      Il secondo metodo impiega tre PTC a valanga in serie. È previsto un PTC per monitorare ciascuna delle tre fasi e
      accertare che nessuna di esse superi la temperatura nominale del motore. Scegliere questa opzione se il motore
      rimane in stallo per un periodo prolungato. Durante il normale funzionamento la resistenza dei dispositivi resta
      inferiore a 1.500 ohm. Quando una fase raggiunge 155 °C la resistenza aumenta rapidamente e supera 7.000
      ohm.
      Nessuno di questi metodi protegge il motore dal surriscaldamento quando viene applicata corrente superiore al
      valore nominale continuo. I dispositivi termici non sono in grado di reagire con sufficiente rapidità rispetto alla
      variazione della temperatura che si verifica quando si applica una corrente di picco. È necessario che
      l'azionamento limiti il tempo in cui la corrente di picco viene applicata al motore per evitarne il surriscaldamento.

149    KOLLMORGEN | kdn.kollmorgen.com | June 2023

                                                                                                                       TBM2G Instructions | 5 Italiano

                                      Resistenza PT1000 in funzione della temperatura
                    1800

                    1600
                    1400
Resistenza in Ohm

                    1200
                    1000

                     800

                     600

                     400
                     200

                       0
                           0    20       40    60         80   100 120 140        160   180   200
                                                         Temperatura in ˚C

                               15

Questa opzione prevede solo il PT1000 in serie e dà una curva come mostrato nel grafico che precede.

                                Resistenza PTC-3 in serie in funzione della temperatura
100,000

       50,000
Resistenza in Ohm

                    10K

                     5K

                    1000
                           0     20       40        60      80    100      120   140    160   180
                                                         Temperatura in ˚C

                               15$                          15$                   15$

In questa opzione sono presenti tre PTC in serie in tre fasi diverse. Se una delle fasi si avvicina alla temperatura
nominale del motore, la resistenza aumenta notevolmente.

                                                                                                    KOLLMORGEN | kdn.kollmorgen.com | June 2023   150

TBM2G Instructions | 5 Italiano

      5.3.7.5 Specifiche generali e cablaggio dei sensori a effetto Hall
      SPECIFICHE GENERALI DEI SENSORI A EFFETTO HALL
       Motore                                 TBM2G-          TBM2G-            TBMG-        TBM2G-        TBM2G-   TBM2G-   TBM2G-
                                                050             060              068           076           085      094      115
       Tipo                                                                          5 flying lead, Allegro A1260
       Tensione d’ingresso, V                                                                da +5 to 24
       CC
       Segnale di uscita                                                                        Sink
       Lunghezza, mm*                                                                            500
       Diametro filo, AWG                          26               26               26          26          26       26       26
       Diametro nominale                        0,99                0,99             0,99       0,99        0,99     0,99     0,99
       guaina isolante, mm
       Min. raggio di curvatura                 4,95                4,95             4,95       4,95        4,95     4,95     4,95
       statico, mm

      *Versione senza cavo opzionale (solo piastra saldata)

      INTERFACCIA ELETTRICA DEI SENSORI A
      EFFETTO HALL
       Colore                           Funzione (alt)
       Marrone                          Hall 1 (U-V)
       Arancione                        Hall 2 (V-W)
       Giallo                           Hall 3 (W-U)
       Blu                              da +5 a 24 V CC
       Verde                            Terra

      Schema di cablaggio dei sensori
                      R = 1.5 kΩ (Fornito dal cliente)
                                                                           BLU
                      R                   R                    R      (+5 TO 24 V DC)

       H                   H                   H
           1                   2                   3
               MARRONE          ARANCIONE                  GIALLO
                 USCITA            USCITA                 USCITA
               FASE - UV         FASE - VW              FASE - WU
                                                                            VERDE
                                                                           (TERRA)

151    KOLLMORGEN | kdn.kollmorgen.com | June 2023

                                                                                                                TBM2G Instructions | 5 Italiano

Schema delle uscite dei sensori
U, V, W in fase per rotazione CW vista da PCB/estremità uscita cavo

     VOLTI
                    1          2          3          4          5          6

               Bemf U-V

     5
H1                                                                               IN FASE CON Bemf U-V
     0                               Bemf V-W

     5
H2                                                                               IN FASE CON Bemf V-W
     0                                                     Bemf W-U

     5
H3                                                                               IN FASE CON Bemf W-U
     0
              60˚                  180˚                  300˚                  420˚
         0˚             120˚                  240˚                  360˚
              GRADI ELETTRICI (RELATIVI)

                                                                                             KOLLMORGEN | kdn.kollmorgen.com | June 2023   152

TBM2G Instructions | 5 Italiano

      5.4 Definizione dei termini per i dati tecnici
      Coppia di stallo continua max., Tmc [Nm]:La coppia di stallo continua max. può essere mantenuta per un
                         tempo indefinito a bassa velocità e in condizioni ambientali nominali. È prevista una riduzione
                         supplementare della potenza se la velocità non è sufficientemente elevata da generare una
                         distribuzione uniforme del calore tra le fasi. Questo valore presuppone una temperatura
                         ambiente di 25 °C.
      Corrente continua max, Imc [Arms]:La corrente continua massima è la corrente sinusoidale effettiva che il
                       motore assorbe a bassa velocità per generare la coppia di stallo continua max.

      Velocità meccanica max., Nmax [giri/min]:La velocità meccanica max. è la velocità più elevata che il motore
                       può raggiungere. È limitata da fattori meccanici quali la forza adesiva del legame magnetico.

      Coppia di picco, Tp [Nm]:La coppia di picco può essere mantenuta per durate brevi, in funzione delle condizioni
                        ambientali e del ciclo di lavoro complessivo. Questo valore può essere limitato anche sulla
                        base delle specifiche dell'azionamento e della tensione di alimentazione.
      Corrente di picco, Ip [Arms]:La corrente di picco del motore (valore sinusoidale effettiva) è pari tre volte la
                         corrente continua. Il valore reale è inferiore alla corrente di picco del motore o alla corrente di
                         picco dell'azionamento utilizzato.
      Coppia nominale, Trtd [Nm] :La coppia nominale è prodotta quando il motore assorbe la corrente nominale alla
                       velocità nominale. La coppia nominale può essere prodotta per un tempo indefinito alla
                       velocità nominale in funzionamento continuo (Nrtd). Questo valore presuppone una
                       temperatura ambiente di 25 °C.
      Costante di coppia, KT [Nm/Arms]:La costante di coppia definisce la quantità di coppia che è prodotta dal
                       motore per unità di corrente. Misurata sia a temperatura ambiente (25 °C) che alla
                       temperatura degli avvolgimenti (155 °C).
      Costante di forza elettromotrice di ritorno, Ke [Vrms/kgiri/min]:La costante BEMF definisce la forza
                        elettromotrice di ritorno indotta del motore, come un valore sinusoidale effettivo tra due
                        morsetti, per 1.000 giri/min. Misurata sia a temperatura ambiente (25 °C) che alla
                        temperatura degli avvolgimenti (155 °C).
      Costante del motore, Km [Nm/√W]:Questa costante viene di norma usata per confrontare la densità di potenza
                       del motore allo stallo o in prossimità di esso. Definisce la quantità di coppia che il motore può
                       produrre con una data quantità di potenza. Questo valore è indicato con Kt e resistenza alla
                       temperatura degli avvolgimenti di 25 °C.
      Resistenza, Rm [Ω]:La resistenza viene misurata in concatenazione e in corrispondenza della scheda PCB. Il
                       valore non include la resistenza dei cavi del motore. Il valore della resistenza è indicato a 25
                       °C e aumenta all'aumentare della temperatura degli avvolgimenti.
      Induttanza, L [mH]:L'induttanza viene misurata in concatenazione e in corrispondenza della scheda PCB. È
                       l'induttanza media del motore rispetto alla posizione del rotore. Il valore è misurato alla
                       temperatura degli avvolgimenti di 25 °C.
      Momento di inerzia del rotore, Jm [kg-cm²]:Il momento di inerzia del rotore tiene conto della capacità di
                       accelerazione angolare del motore. Questo valore si riferisce unicamente ai componenti
                       standard del gruppo campo (anello a giogo e magnete ad anello). I componenti forniti dal
                       motore alterano l'inerzia totale.
      Attrito statico, Tf [Nm]:L'attrito statico è la coppia che va superata affinché il motore entri in rotazione. È la
                           combinazione delle perdite di isteresi a bassa velocità e del picco della coppia di cogging.

153    KOLLMORGEN | kdn.kollmorgen.com | June 2023

                                                                                       TBM2G Instructions | 5 Italiano

                  Non include le perdite del sistema dovute ai cuscinetti. Questo attrito non va considerato nel
                  calcolo delle perdite rotazionali del motore in velocità.
Resistenza termica, Rthw-a [° C/watt]:La resistenza termica è la misura dell'aumento di temperatura in stato
                 costante per unità di energia dissipata dalle perdite. Questo valore presume che il motore
                 TBM2G sia incluso in un alloggiamento e sia montato su un dissipatore di calore in allumino
                 come definito nella corrispondente scheda CD o equivalente.

                                                                  KOLLMORGEN | kdn.kollmorgen.com | June 2023      154

TBM2G Instructions | 5 Italiano

      Notes

      2 mm divisions

155      KOLLMORGEN | kdn.kollmorgen.com | June 2023

                                                 TBM2G Instructions | 6 中文

6 中文

6.1 一般信息

6.1.1 关于本手册
本手册介绍 TBM2G 无框电机（标准版本）。如果在驱动系统中共同运行 TBM2G 电机与
Kollmorgen® 伺服驱动器，请遵守整个系统文档，包括：
  l 伺服驱动器安装手册
  l 现场总线通信手册（例如 CANopen 或 EtherCAT）

更多背景信息请参阅 Kollmorgen 开发者网络，网址 kdn.kollmorgen.cn。

6.1.2 所使用的缩写词

  l 技术数据中所使用的缩写词可参阅“术语定义”。
  l 在本文档中，符号 (➜ # 25) 是指：请参阅第 25 页。

                                   KOLLMORGEN | kdn.kollmorgen.com | June 2023   156

TBM2G Instructions | 6 中文

      6.1.3 所用符号
               符号                含义

                                 表示一种危险情况，如果不加以避免，将会导致人员死亡或严重受
                                 伤。
                    危险
                                 表示一种危险情况，如果不加以避免，可能会导致人员死亡或严重
                                 受伤。
                    警告
                                 表示一种危险情况，如果不加以避免，可能会导致人员轻度或中度
                                 受伤。
                    小心
                                 表示如果不避免，可能会导致财产损失。

                                 表示重要的注意事项。

                                 危险警告（通用）。 危险类型取决于符号旁边的文字描述。

                                 用电危险警告。

                                 表面高温危险警告。

                                 悬挂负载警告。

157   KOLLMORGEN | kdn.kollmorgen.com | June 2023

                                           TBM2G Instructions | 6 中文

6.1.4 安全性
6.1.4.0.1 安全注意事项

          起搏器警告！
          只要不安装磁转子便会产生强磁场，这会对体内有受磁场影响的植入物（如
          心脏起搏器）的人员构成危险。 一般而言，所有因强磁场影响而可能遭受健
          康损害的人员必须与转子保持至少 1 米的安全距离。

          小心磁场！
          产生强磁场会对体内有受磁场影响的植入物的人员构成危险。 一般而言，所
          有因强磁场影响而可能遭受健康损害的人员必须与电机保持至少 1 米的安全
          距离。
          只有具备相应资质的人员才允许执行诸如运输、安装、调试和维护等活动。
          具备相应资质的人员是指熟悉电机的运输、组装、安装、调试和操作，并具
          备相应工作资质的人员。 具备资质的人员必须了解并遵守以下标准和指
          令：IEC 60364、60662 和国家事故预防条例。
          >本文档中的建议旨在作为一般安装指南，仅供参考使用。
          >对于这些技术的错误实施，Kollmorgen 不承担任何责任，由用户承担全部
          责任。

          小心戴防护手套！
          在操作电机时，请务必戴上防护手套。
          安装和调试前需阅读可用文档。 操作电机部件不当可能会造成人身伤害和设
          备损坏。 在电机定子内安装转子时必须特别注意。 可能需要工具或固定装
          置。

                             KOLLMORGEN | kdn.kollmorgen.com | June 2023   158

TBM2G Instructions | 6 中文

                       小心磁场！
                       强磁场会吸引金属物体，并对手和手指造成安全隐患。 在操作 TBM2G 电机
                       或在其附近工作时，确保手边至少有两个由坚固的非磁性材料制成的细尖楔
                       形物，例如：V2A（楔角约为 10°-15°）和非金属锤（约 3 kg）。 紧急情况
                       下，您可以使用这些工具分离被磁力束缚在磁性转子上的物体（例如，释放
                       身体被困部分）。
                       将手表和磁性数据媒介（信用卡、软盘等）以及数字显示器（手机、笔记本
                       电脑等）远离 TBM2G 电机 (<500 mm) 放置。 由于磁吸引力较大，在距磁
                       性转子约 50mm 的范围内须特别小心。 在此区域内，不得手持重型（>1
                       kg）或大面积（>1 dm²）的钢或铁制品。
                       不得在未对转子进行包装的条件下储存转子。 使用厚度至少为 20 mm 的非
                       磁性包装材料。 储存位置必须干燥，并避免受热。 除非安装在定子内部，否
                       则请勿将电机转子暴露在超过 110°C 的高温下。 超过 110°C 的热量会使转
                       子磁体退磁。
                       在存放电机的地方贴上警告标志：小心：强磁
                       在机器上贴上易见的警告标志（如永久性自粘标签）。 小心：本机上的驱动
                       器装有强磁体。 强磁场 + 高吸引力！

                       危险接地！ 高压危险！
                       必须确保电机定子的金属部件与开关柜内的 PE（保护性接地）母线正确接
                       地。 无低电阻保护性接地则无法保证人员的安全。 有关详细信息，请参见本
                       文档“固定和安装指南”中的“接地”部分。
                       即使电机未运作，电源连接可能仍带电。 在存在电压的情况下，切勿解除电
                       气连接。 在不利的情况下，这会引起电弧放电，并对人员和设备造成伤害和
                       损坏。

159   KOLLMORGEN | kdn.kollmorgen.com | June 2023

                                              TBM2G Instructions | 6 中文

6.1.5 重要事项
需要专业人员！
只有具备相应资质的人员才允许执行诸如运输、组装、设置和维护等任务。 具备资质的专业
人员是指熟悉电机运输、安装、组装、调试和操作且具备履行职责所需的相关最低资质：
 l 运输：只能由具有处理静电敏感器件知识的人员执行。
 l 机械安装：只能由在机械方面具有资质的人员执行。

 l 电气安装：只能由在电气方面具有资质的人员执行。

 l 设置：只能由具有电气工程和驱动器技术相关知识的合格人员执行。

具备资质的人员必须了解并遵守 IEC 60364 / IEC 60664 和国家事故预防条例。
阅读文档！
安装和调试前需阅读可用文档。 错误处理定子/电机会对人员造成伤害或损坏财产。 因此，操
作人员必须确保受托在无框电机上工作的所有人员都已阅读并理解本手册并遵守本手册中的
安全事项。
注意技术数据！
遵守有关连接条件的技术数据和规格（Technical Data 中电气额定值）。 如果超过允许的电
压值或电流值，则会损坏无框电机，比如出现过热。
执行风险评估！
机器制造商必须对机器进行风险评估，并采取适当措施来确保意外的移动不会造成任何人身
伤害或财产损失。 通过风险评估，可能还会对专业人员提出更多要求。
          小心表面高温！
          TBM2G 电机在操作过程中，根据它们的防护类别，表面可能会非常烫。 当
          心轻度烧伤！ 表面温度会超过 155°C。
          l   测量温度并等待，直到 TBM2G 电机冷却到 40°C 以下再去触
              碰。

                                KOLLMORGEN | kdn.kollmorgen.com | June 2023   160

TBM2G Instructions | 6 中文

                       危险接地！ 高压危险！
                       确保 TBM2G 电机与开关柜中的保护性接地（PE）母线安全接地至关重要。
                       有触电危险。 请确保低电阻接地，否则无法保证人身安全，有触电死亡的危
                       险。
                      l   没有光学显示器并不能保证没有电压。 即使转子不旋转，电源连接处也可
                          能带有电压。
                      l   在操作过程中，不要拔掉任何连接器的插头。 触摸暴露触点有死亡或严重
                          伤害的风险。 即使转子不旋转，电源连接也可能是带电的。 这可能会引起
                          跳火，导致人员受伤、触电损坏。

                      l   在断开伺服驱动器与电源电压的连接后，请等待几分钟后，再触摸任何正
                          常带电的部件（如触电、螺丝连接处）或打开任何连接。

                      l   伺服驱动器中的电容器在关闭电源电压数分钟后仍然可以携带电压，危
                          险。 为确保安全，请测量直流母线电压，直到电压降到 60V 以下。

      依照指示使用（“预期用途”）
        l 用户只允许在本文件中规定的环境条件下操作电机。
        l 该系列电机专用于由伺服驱动器驱动。

        l 电机作为部件安装在电气设备或机器上，只能作为这些设备或机器的集成

          部件进行调试并投入使用。
        l 最终用户负责机器的合规性。

161   KOLLMORGEN | kdn.kollmorgen.com | June 2023

                                          TBM2G Instructions | 6 中文

6.1.6 禁止使用
在未咨询 Kollmorgen 客户支持部的前提下，禁止在以下环境中使用电机：
 l 可能发生爆炸的区域
 l 具有腐蚀性和/或导电性的酸性溶液、碱性溶液、油、蒸汽、灰尘的环境

 l 真空

 l 直接在主电源网络上使用

如果安装机器有以下情况，则禁止调试电机
 l 不符合欧共体机械指令的要求
 l 不符合 EMC 指令

 l 不符合低电压指令

                            KOLLMORGEN | kdn.kollmorgen.com | June 2023   162

TBM2G Instructions | 6 中文

      6.1.7 型号命名原则

163   KOLLMORGEN | kdn.kollmorgen.com | June 2023

                            TBM2G Instructions | 6 中文

6.1.8 转矩概览

6.1.9 部件材料图
                     1. 磁轭
                        l 材料：400 系列不锈

                          钢
                     2. 环形磁铁
                        l 材料：钕铁硼（钕）

                        l 涂层：环氧树脂

                     3. 印刷电路板 (PCB)
                     4. 线圈
                        l 材料：铜

                        l 涂层：清漆

                     5. 端部绝缘
                        材料：聚合树脂
                     6. 电源线
                     7. 叠片
                        材料：电工钢
                     8. 可选过热保护装置
                        （安装在 PCB 下方）
                        l PT1000

                        l PTC 雪崩（3 个串
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
