BryanRalston/robot-lab/modules/actuators/results/DRIVE_HEAT_PLATES.md

# Elmo G-TWI standoff heat plates — R-134/R-135/R-136 (RL Actuators, 2026-10-21)
Script `drive_heat_plates.py` (CadQuery 2.8) → `results/drive_heat_plates.json`, STEP in `cad/drive_plate_*.step`. Masses are CAD volume × 2.70 g/cm³ (6061-T6).
Basis: losses from Thermal R131_ELMO_MG.md (MAN-G-TWI v2.011 §11.2.1 chart −25 % + 1 W control): knee 6.0, hip_pitch 6.2, ankle 3.0, shoulder_pitch 4.2 W carry; R-096 duty = 0.6× carry. Air 35 °C, h 8 (standing/duty), h 12 check. Pad: 1 mm gap pad ≥3 W/mK, 0.3 K/W per drive. Limit: baseplate ≤80 °C (Elmo 85 − 5); firmware derate 75 → 50 % at 85 → off 90 (Electronics/Controls). All plates sit on G10/PEEK standoffs (4 × M3 corners, ø3.4) with no metal path to motor housings or femur (R-066, R-136 §1, hip_pitch off-housing per R-136 §2).

| plate | qty | geometry (6061) | area m² (wetted − drive faces) | mass g each | T base duty h8 | carry cont h8 | carry cont h12 |
|---|---|---|---|---|---|---|---|
| knee (2 drives/plate) | 2 | 100 z × 48 y × 1.5 base + 12 axial fins 8 × 1.0 (4 mm pitch) toward femur, η 0.998 | 0.0273 | 45.0 | **69.2** | 91.9 (derate) | 73.6 |
| hip_pitch | 4 | 80 × 80 × 1.5 flat | 0.0122 | 25.8 | **75.3** | 102.2 (derate) | 80.4 |
| ankle | 4 | 60 × 56 × 1.5 flat | 0.0060 | 13.5 | **74.1** | 100.2 (derate) | 78.8 |
| shoulder_pitch | 2 | 80 × 80 × 1.5 flat | 0.0122 | 25.8 | **62.3** | 80.5 | 65.8 |

Others (hip roll/yaw, elbow, waist, neck) stay on housings (Thermal PASS). Wrist pair: no plate; bay vent or derate (Electronics), per R-136.

**Mass:** plates 298.4 g + standoffs/screws 40.8 g [EST: G10 tube 0.25 g + M3 A2 0.6 g, 4/plate] = **0.339 kg robot**. Bare knee plates already in R-066 (2 × ≈19.4 g) ⇒ new addition 0.300 kg vs R-136's implied +0.256 ⇒ **+0.044 kg over booking** (over the 0.005 freeze; Arbiter to book — see D89).

**L51 envelope (knee):** stack = standoff 8.5 + base 1.5 + pad 1.0 + drive 14.4 = 25.4 of 26 mm (0.6 margin); y 48 of 52; z 100 of 104; 2 drives use 75 mm of z. Fins capped at 8 mm by depth; 0.0273 m² is 9 % under Thermal's 0.03 but the duty case still meets 80 with 10.8 K margin. Connector mating height above the 14.4 drive body is NOT inside the 26 mm box — Electronics to confirm.

**Findings:** continuous carry at h 8 exceeds 85 on knee/hip/ankle; it is held by the R-096 duty limit and firmware derate (or h ≥12 vent flow). hip_pitch duty (75.3) sits at the derate start. Next: G3 thermal re-check with plates in CAD (R-136).

## Rev 2 — D90 (Electronics 23f6992 §18.5 P-055, R-140, R-141), 2026-10-21
Supersedes the knee/hip_pitch rows and the L51 stack above. Same model (h 8 duty, 35 °C, pad 0.3 K/W); only geometry changed.
- **Drive mount (all plates):** G-TWI base 4 × M2 on 30.6 × 25.6 ±0.1 (MAN-G-TWI p.79). Plate and gap pad get Ø2.4 clearance holes only; M2 × 6 screws go up from the femur/structure side (screws booked by R-141). M3 G10/PEEK corner standoffs unchanged.
- **PE:** no PE lead per plate. One serrated washer per plate on a bare/masked seat; the heat sink is at PE inside the drive (Electronics §8.3). +0.1 g/plate [EST].
- **Knee re-solved inside 26 mm:** fins moved off the femur face onto the **drive side**: 6 axial fins 15 × 1.0 (3 per 7.5 mm strip either side of the 30 mm drive footprint, 100 long). They sit beside the drives and top out at 20.5 mm, below the PCB underside plane at 21.4. The femur side now only clears the Ø3 M2 heads: **standoff 4.0** (head 2.0 + 2.0). Stack 4.0 + 1.5 + 1.0 + 14.9 + 1.6 = **23.0 mm**: 3.0 mm to the 26 wall, so ID's 3 mm fits exactly (0.0 left). The plug exits sideways at −z, so it adds no depth. No extra Legs/ID depth needed.
- **Knee thermal (existing model, h 8):** area 0.0261 m², duty **70.7 °C** (rev 1 69.2; R-140 accepted ≤75.3), carry continuous h8 94.6 (derate), h12 75.3. A femur gap under 4 mm would credit only 30 % of that face [EST]; at 3.5 mm the duty temperature is 75.9 °C, so 4.0 is the minimum standoff. **Thermal re-run requested** to confirm the femur-gap credit and drive-side fin flow (R-140 vent-stream h 8 condition).
- **Hip pitch ≤72 °C:** flat plate 80 → **84 × 84 × 1.5**, duty **71.5 °C** (83 mm gives 72.4). Fits off-housing per R-136 §2 [EST: pelvis bay clearance not yet checked in CAD].
- **Harness:** knee −z, hip pitch to pelvis, ankle +z, shoulder to bay; MRTA2P26S bend radius 31.5 mm.
- **Mass:** knee 43.4 g each (−1.6), hip_pitch 28.4 g each (+2.6), washers +1.2 g. Total **0.347 kg** vs 0.339 (R-140) ⇒ **+0.008 kg**, which is over the 0.005 freeze, so it goes to the Arbiter (P-153).

## Rev 3 — D91 (Thermal R131_ELMO_MG.md rev 2, 16f8176), 2026-10-21
Supersedes the rev 2 knee. Uses Thermal's basis: h 8 applies only to open, black-anodised faces with ≥10 mm of clear air. Fin gaps under 5 mm, faces enclosed in the L51 box and faces looking at the femur are credited 0. Target UA ≥ 0.185 W/K at h 8 for ≤75 °C at duty (7.2 W/plate).
- **Why it can't stay inside 26 mm:** at enclosed h 3–6, even both faces of the 100 × 48 plate give ≤0.06 W/K. Padding to the thigh shell (Thermal option 2) has no Legs data on shell area or h, so it isn't evidenced. Two plates (option 3) need about 2× the y envelope, against the 4 mm free.
- **Knee rev 3 (option 1):** the plate is flipped. The two drives hang on the femur-facing side (4 × M2 30.6 × 25.6 clearance holes, screw heads on the outer face between fins, one serrated washer on a masked seat). The plate's black-anodised outer face is a window in the thigh shell at the L51 26 mm boundary. **8 axial fins, 13 × 1.0 mm at 6.0 mm pitch (5.0 mm gaps), run along the thigh-axis stream outside the box.** The edges are sealed to the shell. Corner G10 standoffs/M3 go to the thigh frame. The inner plate face is bare 6061 (low ε), and a 0.05 mm Al foil shield goes on the femur under the drives (0.6 g/leg [EST]).
- **Stack (from the femur):** gap 7.0 (connector/plug, −z exit) + PCB 1.6 + drive 14.9 + pad 1.0 + base 1.5 = 26.0. The ID 3 mm shell is replaced locally by the plate. **Fins protrude 13 mm beyond the L51 box** (minimum 12 mm gives 73.8 °C at duty, 1.2 K margin). This is an envelope change for Legs/ID: the thigh fairing needs a 100 × 48 window and the fins stand proud.
- **Thermal:** UA **0.203 W/K** (0.0256 m² open, η 0.995). Duty at h 8 **71.5 °C**; continuous carry 95.8 at h 8 (derate) and 76.1 at h 12. Heat into the femur ≈ 0.3 W [EST: 7 mm air gap k/s 3.9 W/m²K + foil radiation ≈ 0.3, 0.0021 m², ΔT 30], against Thermal's ~3 W for rev 2.
- **Hip pitch / ankle / shoulder interface condition (Thermal R131 rev 2 (b)):** the plate back face must see structure at ≤50 °C (thigh/pelvis shell or frame), never the hip-pitch housing (85–98 °C), or it must carry a low-ε shield toward any housing. Hip pitch 84 mm gives 68.8 °C at duty, h 8 (Thermal). **CAD check: there is no assembly CAD placing these plates (only the standalone cad/drive_plate_*.step), so this can't be verified yet. It is carried as a binding interface condition for Legs/Arms placement.**
- **Mass:** knee 46.8 g each (rev 2 43.4, +3.4), foil +1.2 g. Total **0.355 kg** (rev 2 0.347, +0.008; R-140 0.339, **+0.016**).

## Rev 4 — D93 (Thermal R131 rev 4 44b7c36, T&R R-143 447aa8e, ID P-154 rev 4 e61cbf2), 2026-10-21
Supersedes the rev 3 knee. The guard is ID's CAD, not drawn here: `modules/design/cad/covers/knee_fin_guard.*`. That is a 1.5 mm PC cap, 104 × 52, with a low-ε inner face (ε ≤ 0.1) and the outer face in cover colour, 4 mm slots at 5.5 mm pitch, 64 % open face, open at both z ends, 4 × M2.5 into heat-set inserts in the window frame, and a 45° × 8 mm chamfer on the lower (z 690) edge for the RV12 rods.
- **Fins:** 8 at 6 mm pitch, 1.0 thick, **18.5 mm** (Thermal rev 4 picked 18; +0.5 mm compensates the taper, see below). Tips are R0.5. The lower (z 690) ends are tapered 45° × 8 mm so the tips keep the 10 mm standoff under ID's chamfer.
- **Taper evaluation:** using Thermal's rev 4 values (UA 0.246 at h 8 and 0.135 standing, both at 18 mm with no taper), the taper costs 512 mm² of fin face (1.5 %):
  - 18 mm + taper: UA 0.242, standing duty **76.1 °C**. That meets ≥0.23 but **misses ≤75.5**.
  - **18.5 mm + taper: UA 0.248, standing 0.136 W/K, standing duty 75.2 °C. Both pass.** This is the compensating change.
- **Mounting:** the plate is held by 4 × PEM FHS-M3 studs pressed into the inner face (1.5 mm 6061), with nuts behind the window-frame lip. The rev 3 Ø3.4 corner holes would have run through the outermost fins (x ±21) and a counterbore would cost 4.5 % of the area, so the holes are dropped. Hardware mass is as before [EST].
- **Answers to ID:**
  1. With the plate outer face at x −34.5, the fins are **18.5 mm (not 18)**, so the tips sit at x −53.0. ID's guard inner face moves out 0.5 mm, from 28.0 to 28.5 mm (proud 29.5 → **30.0**), to keep the 10 mm standoff. The RV12 clearance at the chamfer drops from 7.8 to about 7.3 mm [EST, linear], which ID should re-run in r143_knee_sweep. If ID can't take +0.5 mm, the fallback is 18 mm fins at 76.1 °C standing (+0.6 K over the Thermal recommendation, still under the 80 °C base limit).
  2. **Edge seal:** the plate is 100 × 48, set into the 100 × 48 window. The seal is a 1 mm silicone FIP bead on the plate's inner face perimeter against the frame lip, **inboard of the plate**. Nothing projects outboard of x −34.5 except the fins, which start 3 mm in from each long edge (outer fins at x ±21 + 0.5). The guard's 4 mm flange lands on the frame outside the 104 × 52 wall, and the wall inner face (101 × 49) clears the plate edges by 0.5 mm per side. No interference. The stud nuts are under the frame lip, not under the flange.
- **Thermal (Thermal rev 4, scaled):** UA 0.248 at h 8, 0.136 standing. Drive base ≤75.2 °C at duty in all cases. Guard face ≤40.3 °C (unchanged, low-ε inner face). Femur bond 68.2–69.1 °C: keep the foil and the bare inner face. Firmware touch cap rejected (Robot Lab).
- **Mass:** knee plate 58.4 g each (rev 3 46.8, so +23.2 g for 2). ID guard ≈ 20.3 g each (Thermal rev 4), so +40.6 g for 2. Total **+0.064 kg [CAD+EST]. Booked as +0.066 kg vs rev 3 per Robot Lab / Thermal.** Plates file total 0.378 kg (excluding the guards).

## Rev 4b — D94 (Legs L71 6060973: L58 tab clearance), 2026-10-21
- **Plate narrowed** from 48 to **46 mm, y 107–153** (thigh frame), giving 3.0 mm to the L58 tab edges (tabs at y 100/160, 8 wide, so edges at 104/156).
- **Fins:** 8 fins at 46/8 = 5.75 mm pitch, thinned to **0.75 mm** so each gap stays **5.0 mm**, Thermal's dead-channel limit. Height 18.5 mm, R0.5 tips, lower 45° × 8 taper. Tips stay 10 mm from the guard inner face (28.5). Fin efficiency 0.986 (was 0.99).
  - Rejected: 7 fins (6.57 pitch) give 80.2 °C standing at 18.5 mm and 78.2 °C at 19.5. Keeping 1.0 mm fins at 5.75 pitch leaves 4.75 mm gaps, which Thermal treats as dead.
- **Thermal (scaled from Thermal rev 4):** UA **0.247** at h 8, 0.135 standing. Drive base at standing duty **75.4 °C** (≤75.5, margin 0.1 K). Thermal should confirm 5.75 pitch / 5.0 gap against their 6 mm-pitch recommendation.
- **Mass:** knee plate 47.8 g each (rev 4 58.4), **−21 g robot**. This is a credit, not booked; it is inside the +0.066 rev 4 booking.
- **Guard/ID:** the window and guard narrow by 2 mm: window 100 × 46, guard wall 104 × 50 (y 105–155). At ID's current 52 mm wall (y 104–156) the guard touches the L58 tab edges inside x −34.5…−38 (tab tips at x −38). Even at 50 mm the guard wall sits only 1 mm from the tabs, so ID and Legs need to shorten the tabs to x ≤ −34 or notch the guard.
- **Binding (Thermal 389f91b):** the knee plate's PEM M3 studs must land in **G10 standoffs with no metal contact** to the frame or femur. A metal path takes the femur bond to 69–71 °C (limit 70).
- **Guard superseded:** the P-154 PC guard is dropped in favour of a **vented fairing grille (ID/Legs)**. The fin tips still need **≥10 mm of clear air** behind the grille's inner face.

## Rev 4c — D95 placements (after Legs L72 e44c588 FAIL), 2026-10-21
Script `drive_plate_sweep_d95.py` → `results/drive_plate_sweep_d95.json`. It is Legs' L72 sweep (model_v4, L71/L72 pose set: knee 0–145, hip pitch −107.3…+40, roll/yaw/ankle extremes) with the **full envelope**: 8.5 G10 standoff + 1.5 plate + G-TWI 35 × 30 × 14.9 + PCB 1.6. The knee housing is swapped to the **release STEP** (`knee_twin_housing_release_r116.step`, with fins), not model_v4's plain D59 STEP. Frame: L51/L58 convention (zero pose, left leg, mm; right leg mirrored in y). Pass is ≥3 mm.

| plate (per leg) | size | back-face point (3–4 mm off the structure) | normal (structure → drive) | min clearance | governed by | back face sees |
|---|---|---|---|---|---|---|
| AN1 ankle | 56 (y) × 60 (z) | (40, 130, 215), plate centre x 49.25 | **+x** (shin front) | **3.5 PASS** | the tibia tube it mounts to; everything else ≥ 4.7 (ankle screw bodies/rods 7.9–11.0); knee housing beyond 30 mm at knee 145 | tibia tube ø45 7075 (structure, no heat source) ≤ 50 °C [EST] |
| AN2 ankle | 56 × 60 | (40, 130, 290) | +x | **3.5 PASS** | same | same |
| HP1 hip pitch | 84 (y) × 84 (z) | (−88, 45, 1178), plate centre x −97.25 | **−x** (outboard of the pelvis rear wall) | **3.0 PASS** | the pelvis shell it mounts to (Torso); waist deck 8.0; hip yaw yoke 24.5 | pelvis shell rear wall, 4 mm 7075 (Torso: confirm ≤ 50 °C, i.e. no battery or heat source behind it) |
| HP2 hip pitch | 84 × 84 | (−88, 135, 1178) | −x | **3.0 PASS** | same; hip yaw yoke 18.0 | same |

- **Rejected:** lateral (+y) and medial (−y) tibia faces read 0.0 mm (knee housing at knee 145, the other leg at hip roll −20). The D94 rear-shin and z 905 hip positions fail per L72.
- **Shin-front drives** reach x 49.25 + 0.75 + 16.5 = **66.5**. The shin hull/cover isn't in model_v4, so ID must confirm the shin cover clears x 66.5 + 3 at z 185–320. Harness exits +z to the ankle (Electronics §18.5).
- **Hip pitch plates** span y 3–87 and 93–177 per side (inside the shell's y ±185), z 1136–1220 (inside the shell's z 1126–1230). Drives reach x −114.5, so the rear torso cover needs to clear x −117.5.
  - **Harness reach to the hip pitch motors** (on the hip pitch screw units, about z 880–1000 near the hip pitch axis z 920, y ≈ 130): straight line about 200–330 mm. Routed through the hip yaw (+45/−35°) and roll (−20/+45°) service loop, about **0.45–0.6 m per drive [EST]**. That's plausible for motor phase + Hall/thermistor + encoder from the drive. It's longer than the current knee runs, so Electronics should confirm the cable length limit and EMC.
- Plate masses are unchanged (hip pitch 84 × 84, ankle 60 × 56). Torso owns the pelvis-wall mounting (4 × M3 G10 standoffs per plate).

### Knee twin housing front fins (answer for ID P-156 / Legs L72 §2b)
**Yes.** The release geometry `cad/knee_twin_housing_release_r116.step` (job 9c, D80, built on rev B fins D69, `knee_fins_revb.py`) has **front fins**: 7 per motor can, 9 mm tall, 1.0 thick, axial over the can (z 1–43), spanning ±27.7° about the screw axis on the front (local −y). It also has rear fins: 14 per can, 25 mm, 60° span. That is 42 fins, 0.0703 m², 0.093 kg per knee.
- Local bbox: plain D59 STEP y −41…+41, x ±92; release STEP **y −50…+65.8, x ±102.4** (front +9, rear +24.8, sides +10.4 including the R-116 boss).
- model_v4 / L72 use the plain D59 STEP, so the housing's real front is about 9 mm further forward than L72's x −79.4 (≈ −70 [EST], depending on the screw-axis direction), and its rear about 25 mm further aft.
- Rev C was withdrawn. There is no later re-CAD.
- Legs should swap model_v4 to the release STEP. My D95 sweep uses it.
