BryanRalston/robot-lab/modules/actuators/results/LINKAGE_TABLE.md

# Leg linkage table (Actuators, R-013 / R3b) — one table, no double counting

Generated by `linkage_table.py` from `cad_mass.json`, `hp_lever_fea.json`, `hp_bearing.json`. Supersedes the Actuators side of `modules/legs/LINKAGE_TABLE.md` (Legs keeps its file; numbers below are the ones to roll up).

| part | owner | kg each | n/leg | kg/leg | source | Legs must confirm |
|---|---|---|---|---|---|---|
| hip_pitch lever, config B, needle-cheek hub, SF 1.5 + proof test (2 halves, loft arms, ears; dy 69), 7075 + 2 steel pins ø12x25 | Actuators | 0.2491 | 1 | 0.2491 | CAD+FEA hp_lever_fea.py HUB=needle (R4), was 0.371 at SF 2.13 |  |
| hip_pitch pivot: 2x IKO TLA 3520 Z needle + hardened shaft ø35/30x67 + thrust washers + circlips | Actuators | 0.2373 | 1 | 0.2373 | datasheet 2x0.0435 + shaft CAD-calc + washers [EST]; replaces CRBH 5013 A line 0.314 | Legs: tongue bore ø35 press fit (not ø80) |
| knee lever r47.5 | Actuators | 0.1346 | 1 | 0.1346 | CAD | v3 knee-lever credit dropped (Legs L14 accepted) |
| nut-rotor hub | Actuators | 0.016 | 6 | 0.096 | CAD |  |
| trunnion pin pair ø16/ø9 steel (knee + ankle bodies; hip bodies now on clamp eyes, R5b) | Actuators | 0.0259 | 4 | 0.1036 | CAD; 6 -> 4 pairs/leg (Legs L18 clamp form, P-014) |  |
| hip_pitch body axial eye: SKF GE 12 E in 7075 eye on body end + ø12x28 42CrMo4 pin in clamp arm | Actuators | 0.0599 | 2 | 0.1197 | GE 12 E datasheet 0.016 + eye 0.019 CAD-calc + pin calc; clamp_review.py | Legs: clamp arm bore ø12 H7 |
| ankle_pitch 73 mm lever (R5b): 2 RV12 screws +4 mm and 2 body tubes +4 mm for +4.3 % stroke | Actuators | 0.0128 | 1 | 0.0128 | calc; size.py ARM_FIX 0.073 | Legs: instep lug pin radius 70 -> 73 mm |
| rod-end: SKF GE 12 E spherical plain bearing (0.016 kg, C0 54 kN) in a 7075 eye ø30x12 with M12 boss (0.019 kg CAD-calc) | Actuators | 0.035 | 6 | 0.21 | datasheets/skf_ge12e.pdf; catalog SIKAC 12 M (0.118 kg, C0 14 kN) rejected: 3.4x heavier |  |
| ankle rod-end lugs on foot instep (2) | Legs | 0.0 | 1 | 0.0 | 0.042/leg counted in Legs M2 line (L19); removed here (−0.084 both legs, R5b) |  |
| thigh split-collar clamp for hip_pitch bodies | Legs | 0.0 | 1 | 0.0 | 0.237/leg counted in Legs M2 line (L18); Actuators review clamp_review.json: bond + light clamp required |  |

**Total 1.163 kg/leg = 2.326 kg both legs** (contract 0.609; rollup used 0.609). Open: thigh trunnion clamp (Legs).

No double counting: Legs structure 4.85 kg excludes all lever solids, bearings, pins, hubs, rod-ends (L8/L14); actuator housings (cad_mass.json housing group) exclude everything above. Ankle lever: the ankle rod-ends act on the Legs instep lugs (no separate Actuators ankle lever solid). Nut-rotor hubs: 2 per twin-screw unit x 3 units = 6/leg = 12 both legs (R-013 count, 0.192 kg).

Rollup: 65.79 + 1.718 + thigh clamp 0.20 (R-016 [EST]) = **67.71 kg** CAD-supported (of which Actuators R3b hip_pitch lever +0.224, pivot bearing +0.475; other linkage corrections +1.019). If Legs structure (−0.56) and Torso (−0.80) land: 66.35 kg vs 66.5 kg hard (R-017). Harness M3 not included here (see results/harness.md).

**Actuator-owned deltas vs `arbiter/mass_rollup_official.json` (R-022 single source of truth; no robot total computed here):** harness 1.2864 vs official 1.2864 → +0.0000 kg; linkage both legs 2.3262 vs official 2.3262 → -0.0000 kg. Official credible robot total: 66.054 kg.
