BryanRalston/robot-lab/modules/legs/results/r031/drive_plate_placement_check.md

# L72: Actuators D94 drive heat plates + ID P-156 rev 4d knee vents vs leg CAD
Scripts: `drive_plate_sweep_l72.py` -> `drive_plate_sweep_l72.json`; `p156_vent_check_l72.py` -> `p156_vent_check_l72.json` (model_v4 OCC min distance; L71 pose set: knee 0-145, hip pitch -107.3..+40, roll/yaw extremes, ankle pitch -40..+30 / roll ±20).
Plates modelled as 10 mm slabs (1.5 plate + 8.5 standoff toward +x) at the D94 centres; drive bodies not modelled (no size given) = optimistic. Vent run used a0b2aea duct geometry (x -34.5..-63, z 643-837); rev 4d (x -57, z to 860) differences handled by the bbox numbers below.
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
