BryanRalston/robot-lab/media/progress/2026-10-21_reliability_R2_verify.png

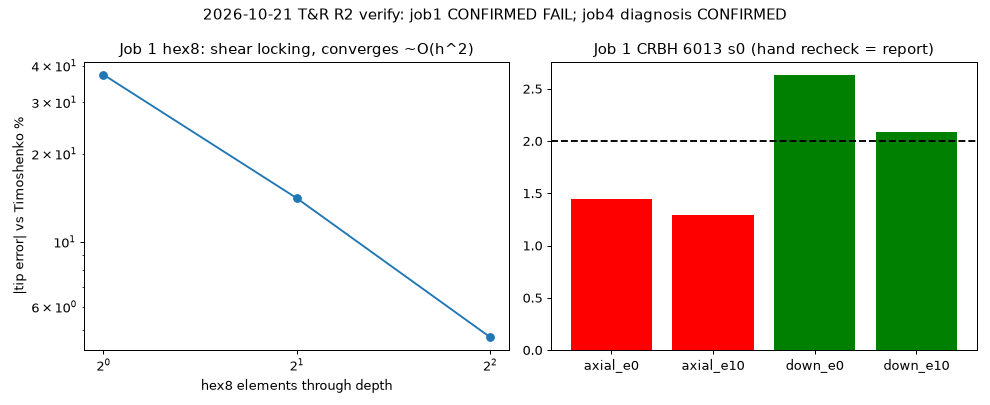
media/progress/2026-10-21_reliability_R2_verify.png
