BryanRalston/robot-lab/modules/actuators/results/hp_lever_fea_convergence.png

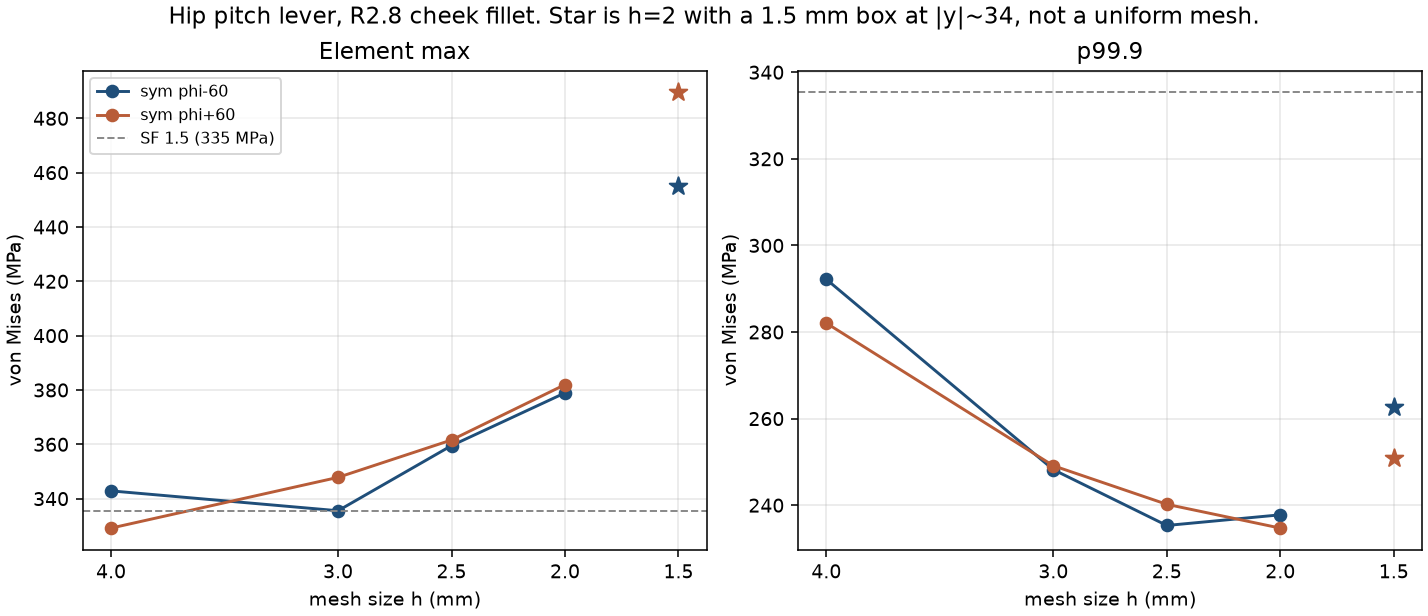
modules/actuators/results/hp_lever_fea_convergence.png
