BryanRalston/robot-lab/modules/legs/grokbuild/results/carry_yaw_roll.png

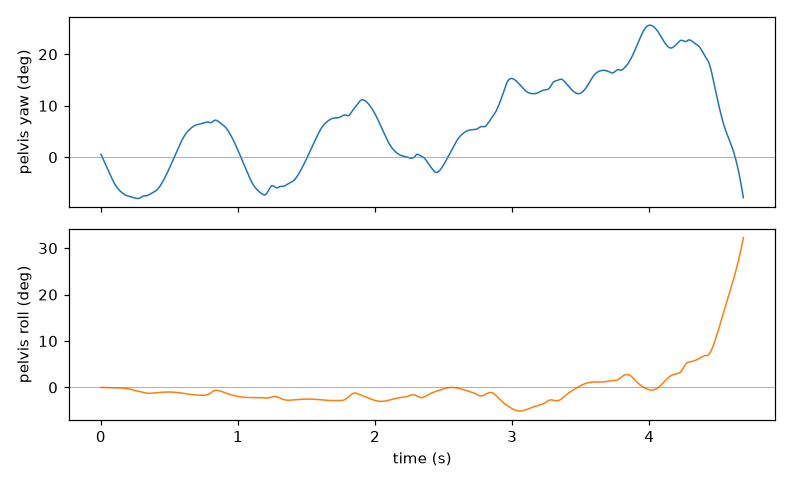
modules/legs/grokbuild/results/carry_yaw_roll.png
