BryanRalston/robot-lab/modules/legs/grokbuild/results/cruise_0p5_yaw_roll.png

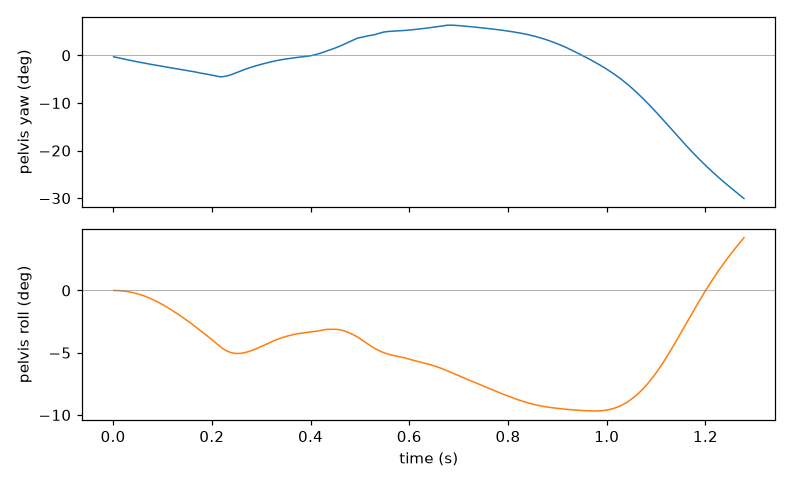
modules/legs/grokbuild/results/cruise_0p5_yaw_roll.png
