BryanRalston/robot-lab/modules/legs/grokbuild/results/cruise_0p8_yaw_roll.png

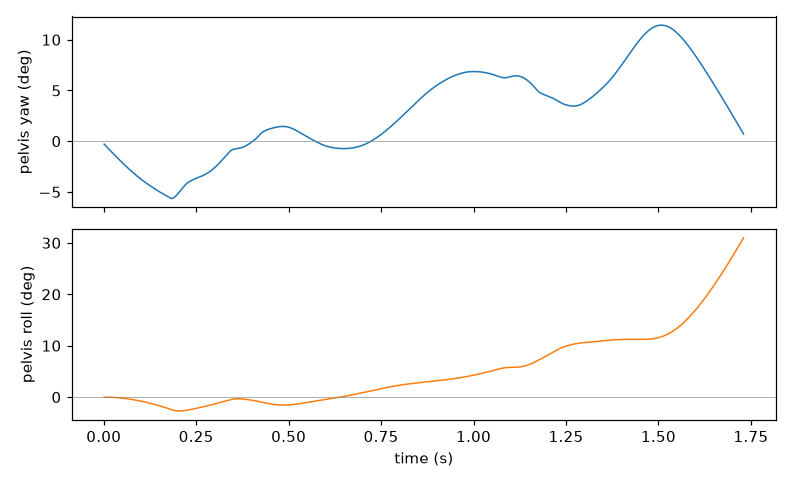
modules/legs/grokbuild/results/cruise_0p8_yaw_roll.png
