BryanRalston/robot-lab/modules/legs/grokbuild/results/push_yaw_roll.png

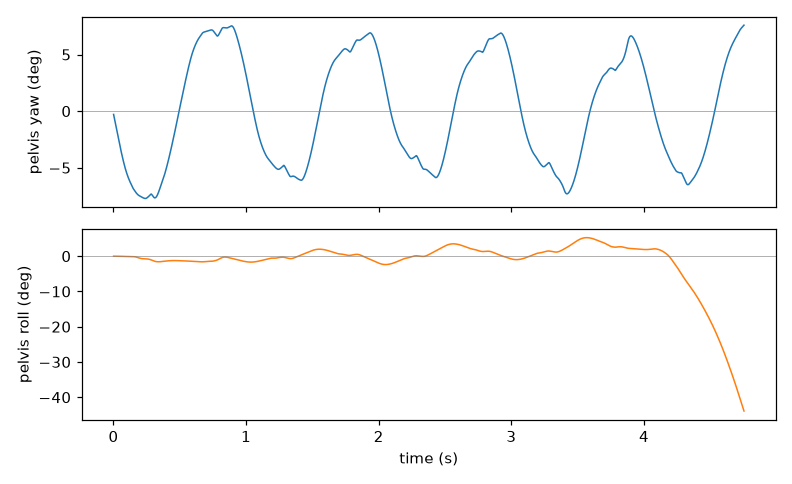
modules/legs/grokbuild/results/push_yaw_roll.png
