BryanRalston/robot-lab/modules/legs/grokbuild/results/walk_yaw_roll.png

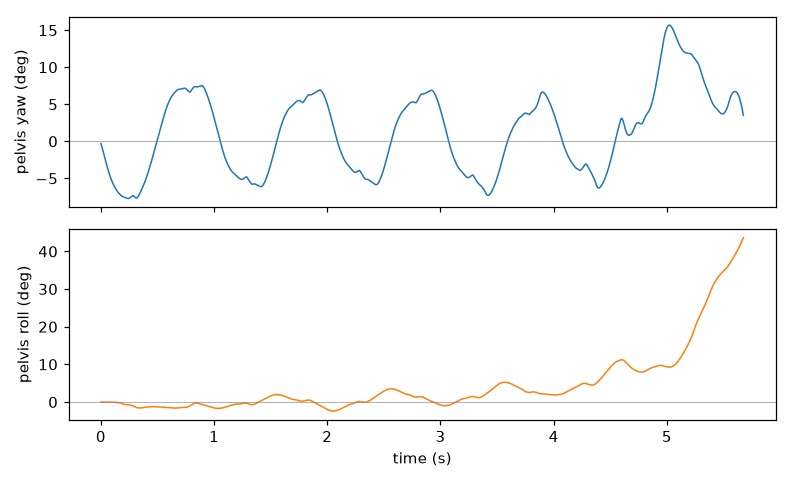
modules/legs/grokbuild/results/walk_yaw_roll.png
