BryanRalston/robot-lab/modules/legs/results/r7/g_0p8/walk_yaw_roll.png

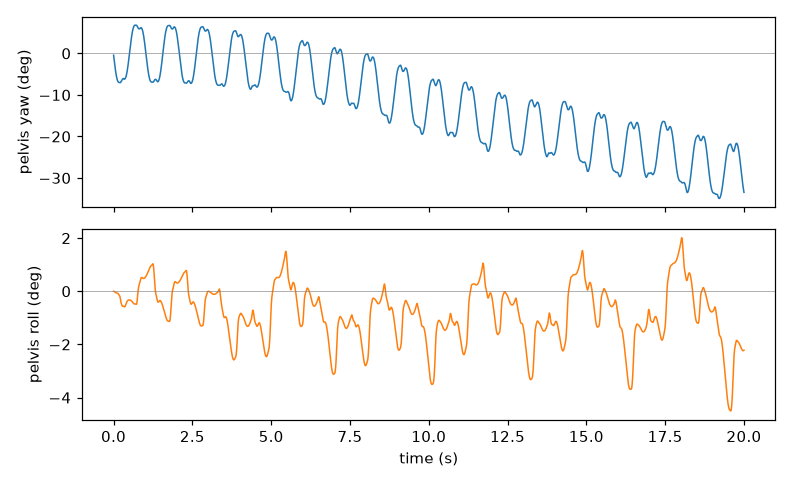
modules/legs/results/r7/g_0p8/walk_yaw_roll.png
