BryanRalston/robot-lab/modules/legs/results/r7/g_1p0_cm/walk_yaw_roll.png

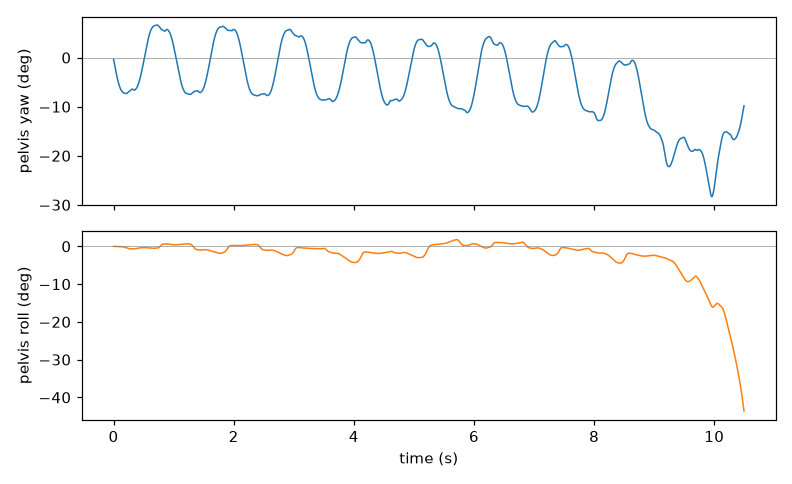
modules/legs/results/r7/g_1p0_cm/walk_yaw_roll.png
