BryanRalston/robot-lab/modules/legs/results/r7/g_1p0_t2/walk_yaw_roll.png

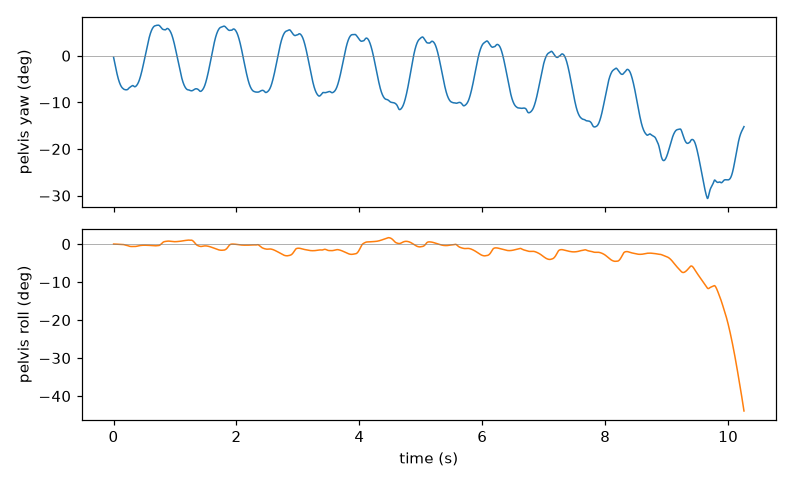
modules/legs/results/r7/g_1p0_t2/walk_yaw_roll.png
