BryanRalston/robot-lab/modules/head/CHANGELOG.md

# Head module changelog
- 2026-10-14 (Robot Lab): head-as-balancer study. Verdict: <1 % peak hip/waist torque benefit, so balance is not worthwhile; the neck is designed for gaze and stabilization. Real parts placed in model_v4 (2× XM430-W350-R, ZED X Mini, CF shell replaces PA12). Head line 0.80 kg, +4.4 W. P-019 filed (0.000 kg claimed, a possible −0.337 credit pending A12).
- 2026-10-14 (Robot Lab, A23/R-025): cited the bearings (6806/6800), converter (RECOM RP40-11012SFR, 43–160 V in, replaces the wrong 48 V part), prepreg and 7075 stock, and the Lee Spring series. Neck servos on the carrier RS485. Added the JCB022/JCB009 GMSL2 note (+0.045 kg, brain area). Head line 0.810 → 0.817 kg; P-019 addendum filed.
- 2026-10-14 (Robot Lab, A27/R-026): RP40-11012SFR/P-HC heat-sink variant specified; note-9 input filter added (3× Rubycon 200BXF68MEFC12.5X20 + 2× Littelfuse SMDJ90A + carrier PCB, 0.0159 kg, ~$14); XM430 1.5 A current limit recorded as required firmware setting. Head line 0.817 → 0.833 kg.
- 2026-10-14 (Robot Lab, A28/A30/A32, R-027): filter caps → Panasonic EEU-EE2D680 (active, 4.7 g, $0.60; head line 0.833 → 0.837). Cover cost sheet in modules/covers/. Machined 7075 palm CAD (modules/model/palm_7075.py, 0.0924 kg/hand) fitted in model_v4.
