BryanRalston/robot-lab/media/progress/2026-10-14_actuators_v4_fixes.png

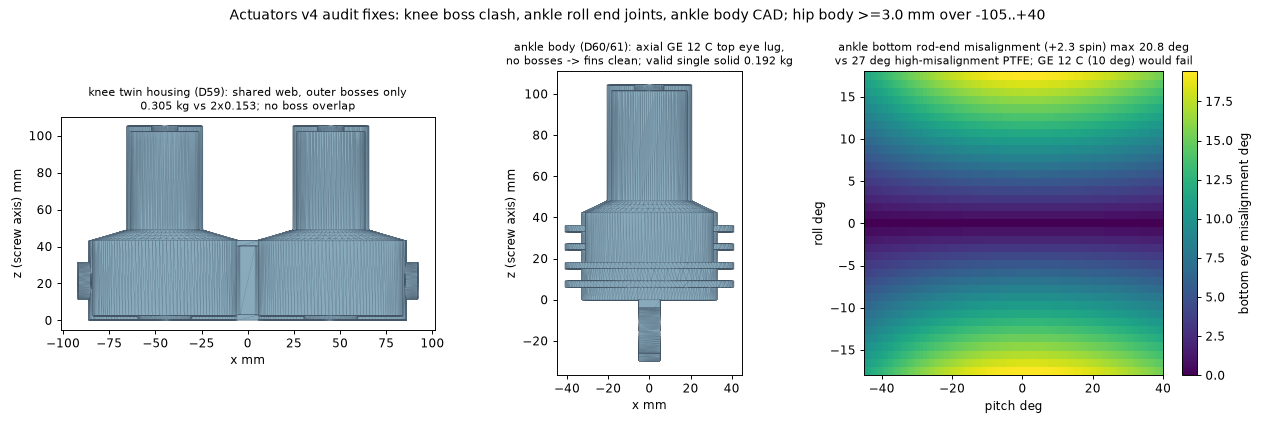
media/progress/2026-10-14_actuators_v4_fixes.png
