BryanRalston/robot-lab/modules/legs/rl/humanoid_mjx_rough.xml

<mujoco model="robotlab_v3">
  <!-- Generated by sim/v3/gen_v3.py from v3 CAD (joint locations, per-segment mass/COM/inertia scaled to the 63.8 kg catalog rollup)
       and v3/analysis (ctrlrange = catalog peak torque, armature = TBM2G rotor inertia x ratio^2). Collision = primitives; visuals on the site = CAD GLB parts.
       Linear (roller-screw) joints modelled as rotary with their effective ratio at the nominal lever arm. Leg-leg contacts are enabled
       (single-leg adduction beyond -6 deg collides in CAD). -->
  <compiler angle="radian"/>

  <option integrator="implicitfast" iterations="4" ls_iterations="8"/>

  <size nkey="1"/>

  <statistic meaninertia="7.42287" meanmass="2.83337"/>

  <default>
    <geom rgba="0.5 0.7 0.88 1"/>
  </default>

  <asset>
    <texture type="2d" colorspace="auto" name="grid" builtin="checker" rgb1="0.1 0.15 0.2" rgb2="0.15 0.2 0.25" width="300" height="300"/>
    <material name="grid" texture="grid" texrepeat="8 8"/>
    <hfield name="terrain" size="6 6 0.02 0.05" nrow="65" ncol="65" elevation="
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
  </asset>

  <worldbody>
    <geom name="floor" pos="0 0 -0.01" type="hfield" material="grid" hfield="terrain"/>
    <light pos="0 0 4"/>
    <body name="pelvis" pos="0 0 1.16">
      <inertial pos="0 0 0.0195" mass="7.06148" diaginertia="0.108303 0.0249963 0.112226"/>
      <joint name="root" type="free"/>
      <geom name="pelvis" size="0.085 0.185 0.052" pos="0 0 0.018" type="box"/>
      <site name="imu"/>
      <body name="L_hipY" pos="0 0.13 0">
        <inertial pos="0.0059 0 -0.1058" mass="2.1325" diaginertia="0.00339857 0.00457339 0.00363983"/>
        <joint name="l_hip_yaw" range="-0.610865 0.785398" armature="0.079" damping="0.5" frictionloss="0.3"/>
        <body name="L_hipR" pos="0 0 -0.115">
          <inertial pos="0 0.0023 -0.1151" mass="1.95942" diaginertia="0.00392304 0.00340906 0.00288459"/>
          <joint name="l_hip_roll" range="-0.20944 0.261799" armature="0.441" damping="0.5" frictionloss="0.3" axis="1 0 0"/>
          <body name="L_thigh" pos="0 0 -0.125">
            <inertial pos="-0.06 0 -0.1867" quat="0.707107 0 0 0.707107" mass="2.49984" diaginertia="0.0383913 0.032192 0.0139824"/>
            <joint name="l_hip_pitch" range="-1.8326 0.698132" armature="0.441" damping="0.5" frictionloss="0.3" axis="0 1 0"/>
            <geom name="l_thigh" size="0.04 0.155" pos="0.018 0 -0.215" type="capsule"/>
            <body name="L_shank" pos="0 0 -0.42">
              <inertial pos="0.0355 0.0013 -0.1027" mass="3.31466" diaginertia="0.0577128 0.0620554 0.0166257"/>
              <joint name="l_knee" range="0 2.35619" armature="0.2018" damping="0.5" frictionloss="0.3" axis="0 1 0"/>
              <geom name="l_shank" size="0.035 0.15" pos="0.014 0 -0.2" type="capsule"/>
              <geom name="l_calf" size="0.045 0.07" pos="-0.06 0 -0.19" type="capsule"/>
              <body name="L_foot" pos="0 0 -0.42">
                <inertial pos="0.0535 0.0007 -0.0317" quat="0.707098 -0.00336595 -0.00307188 0.707101" mass="2.77655" diaginertia="0.021411 0.0152394 0.011322"/>
                <joint name="l_ankle_pitch" range="-0.915949 0.698132" armature="0.289" damping="0.5" frictionloss="0.3" axis="0 1 0"/>
                <joint name="l_ankle_roll" solreflimit="0.004" solimplimit="0.95 0.99" range="-0.314159 0.314159" armature="0.0944" damping="0.5" frictionloss="0.3" axis="1 0 0"/>
                <geom name="l_foot" size="0.12 0.05 0.012" pos="0.06 0 -0.074" type="box"/>
                <site name="l_sole" size="0.2" pos="0.06 0 -0.086"/>
              </body>
            </body>
          </body>
        </body>
      </body>
      <body name="R_hipY" pos="0 -0.13 0">
        <inertial pos="0.0059 0 -0.1058" mass="2.1325" diaginertia="0.00339857 0.00457339 0.00363983"/>
        <joint name="r_hip_yaw" range="-0.785398 0.610865" armature="0.079" damping="0.5" frictionloss="0.3"/>
        <body name="R_hipR" pos="0 0 -0.115">
          <inertial pos="0 0.0106 -0.1151" mass="1.95942" diaginertia="0.00371326 0.00340906 0.0026748"/>
          <joint name="r_hip_roll" range="-0.261799 0.20944" armature="0.441" damping="0.5" frictionloss="0.3" axis="1 0 0"/>
          <body name="R_thigh" pos="0 0 -0.125">
            <inertial pos="-0.06 0 -0.1867" quat="0.707107 0 0 0.707107" mass="2.49984" diaginertia="0.0383913 0.032192 0.0139824"/>
            <joint name="r_hip_pitch" range="-1.8326 0.698132" armature="0.441" damping="0.5" frictionloss="0.3" axis="0 1 0"/>
            <geom name="r_thigh" size="0.04 0.155" pos="0.018 0 -0.215" type="capsule"/>
            <body name="R_shank" pos="0 0 -0.42">
              <inertial pos="0.0355 -0.0013 -0.1027" mass="3.31466" diaginertia="0.0577128 0.0620554 0.0166257"/>
              <joint name="r_knee" range="0 2.35619" armature="0.2018" damping="0.5" frictionloss="0.3" axis="0 1 0"/>
              <geom name="r_shank" size="0.035 0.15" pos="0.014 0 -0.2" type="capsule"/>
              <geom name="r_calf" size="0.045 0.07" pos="-0.06 0 -0.19" type="capsule"/>
              <body name="R_foot" pos="0 0 -0.42">
                <inertial pos="0.0535 -0.0007 -0.0317" quat="0.707101 -0.00307188 -0.00336595 0.707098" mass="2.77655" diaginertia="0.021411 0.0152394 0.011322"/>
                <joint name="r_ankle_pitch" range="-0.915949 0.698132" armature="0.289" damping="0.5" frictionloss="0.3" axis="0 1 0"/>
                <joint name="r_ankle_roll" solreflimit="0.004" solimplimit="0.95 0.99" range="-0.314159 0.314159" armature="0.0944" damping="0.5" frictionloss="0.3" axis="1 0 0"/>
                <geom name="r_foot" size="0.12 0.05 0.012" pos="0.06 0 -0.074" type="box"/>
                <site name="r_sole" size="0.2" pos="0.06 0 -0.086"/>
              </body>
            </body>
          </body>
        </body>
      </body>
      <body name="waistY" pos="0 0 0.028">
        <inertial pos="0 0.0083 0.092" mass="1.52831" diaginertia="0.00205593 0.00176222 0.00205593"/>
        <joint name="waist_yaw" range="-1.5708 1.5708" armature="0.137" damping="0.5" frictionloss="0.3"/>
        <body name="torso" pos="0 0 0.092">
          <inertial pos="-0.0006 0.0007 0.1585" quat="0.702468 0.709508 0.0371409 -0.0419261" mass="17.5478" diaginertia="0.313032 0.21409 0.17983"/>
          <joint name="waist_pitch" range="-0.523599 1.0472" armature="0.239" damping="0.5" frictionloss="0.3" axis="0 1 0"/>
          <geom name="torso" size="0.11 0.17 0.13" pos="0 0 0.18" type="box"/>
          <geom name="chest_pad" size="0.044 0.049 0.049" pos="0.1 0 0.22" type="box" mass="0"/>
          <body name="payload" pos="0.25 0 0.1">
            <inertial pos="0 0 0" mass="0.001" diaginertia="1e-05 7.5e-06 1e-05"/>
          </body>
          <body name="L_shoulderP" pos="0 0.17 0.22">
            <inertial pos="0 0.0857 -0.0178" quat="0.178039 0.684326 0.178039 0.684326" mass="1.45803" diaginertia="0.00164864 0.0013849 0.00126712"/>
            <joint name="l_shoulder_pitch" range="-3.14159 1.0472" armature="0.441" damping="0.5" frictionloss="0.3" axis="0 1 0"/>
            <body name="L_upper_arm" pos="0 0.112 -0.04">
              <inertial pos="0 0 -0.1256" mass="1.21677" diaginertia="0.00324333 0.00324333 0.000650344"/>
              <joint name="l_shoulder_roll" range="-0.261799 3.14159" armature="0.309" damping="0.5" frictionloss="0.3" axis="1 0 0"/>
              <joint name="l_shoulder_yaw" range="-2.61799 2.61799" armature="0.137" damping="0.5" frictionloss="0.3" pos="0 0 -0.1"/>
              <geom name="l_upper_arm" size="0.04 0.085" pos="0 0 -0.135" type="capsule"/>
              <body name="L_forearm" pos="0 0 -0.26">
                <inertial pos="0 0 -0.1136" mass="4.65353" diaginertia="0.0294574 0.0291606 0.00254473"/>
                <joint name="l_elbow" range="-2.44346 0" armature="0.104" damping="0.5" frictionloss="0.3" axis="0 1 0"/>
                <geom name="l_forearm" size="0.038 0.1085" pos="0 0 -0.1485" type="capsule"/>
                <body name="L_hand" pos="0 0 -0.267">
                  <inertial pos="0 0 -0.0954" mass="0.495101" diaginertia="0.0009923 0.0009923 0.0003965"/>
                  <joint name="l_wrist_roll" range="-2.96706 2.96706" armature="0.079" damping="0.5" frictionloss="0.3"/>
                  <joint name="l_wrist_pitch" range="-1.22173 1.22173" armature="0.0122" damping="0.5" frictionloss="0.3" pos="0 0 -0.03" axis="0 1 0"/>
                  <joint name="l_wrist_yaw" range="-0.698132 0.698132" armature="0.0122" damping="0.5" frictionloss="0.3" pos="0 0 -0.03" axis="1 0 0"/>
                  <geom name="l_hand" size="0.016 0.043 0.07" pos="0 0 -0.1" type="box"/>
                </body>
              </body>
            </body>
          </body>
          <body name="R_shoulderP" pos="0 -0.17 0.22">
            <inertial pos="0 -0.0857 -0.0178" quat="-0.178039 0.684326 -0.178039 0.684326" mass="1.45803" diaginertia="0.00164864 0.0013849 0.00126712"/>
            <joint name="r_shoulder_pitch" range="-3.14159 1.0472" armature="0.441" damping="0.5" frictionloss="0.3" axis="0 1 0"/>
            <body name="R_upper_arm" pos="0 -0.112 -0.04">
              <inertial pos="0 0 -0.1256" mass="1.21677" diaginertia="0.00324333 0.00324333 0.000650344"/>
              <joint name="r_shoulder_roll" range="-3.14159 0.261799" armature="0.309" damping="0.5" frictionloss="0.3" axis="1 0 0"/>
              <joint name="r_shoulder_yaw" range="-2.61799 2.61799" armature="0.137" damping="0.5" frictionloss="0.3" pos="0 0 -0.1"/>
              <geom name="r_upper_arm" size="0.04 0.085" pos="0 0 -0.135" type="capsule"/>
              <body name="R_forearm" pos="0 0 -0.26">
                <inertial pos="0 0 -0.1136" mass="4.65353" diaginertia="0.0294574 0.0291606 0.00254473"/>
                <joint name="r_elbow" range="-2.44346 0" armature="0.104" damping="0.5" frictionloss="0.3" axis="0 1 0"/>
                <geom name="r_forearm" size="0.038 0.1085" pos="0 0 -0.1485" type="capsule"/>
                <body name="R_hand" pos="0 0 -0.267">
                  <inertial pos="0 0 -0.0954" mass="0.495101" diaginertia="0.0009923 0.0009923 0.0003965"/>
                  <joint name="r_wrist_roll" range="-2.96706 2.96706" armature="0.079" damping="0.5" frictionloss="0.3"/>
                  <joint name="r_wrist_pitch" range="-1.22173 1.22173" armature="0.0122" damping="0.5" frictionloss="0.3" pos="0 0 -0.03" axis="0 1 0"/>
                  <joint name="r_wrist_yaw" range="-0.698132 0.698132" armature="0.0122" damping="0.5" frictionloss="0.3" pos="0 0 -0.03" axis="1 0 0"/>
                  <geom name="r_hand" size="0.016 0.043 0.07" pos="0 0 -0.1" type="box"/>
                </body>
              </body>
            </body>
          </body>
          <body name="neckY" pos="0 0 0.295">
            <inertial pos="0 0.0004 0.075" mass="0.366081" diaginertia="0.000304193 0.00017832 0.000304193"/>
            <joint name="neck_yaw" range="-1.39626 1.39626" armature="0.0005" damping="0.5" frictionloss="0.3"/>
            <body name="head" pos="0 0 0.075">
              <inertial pos="0.0456 0 0.0848" mass="0.483562" diaginertia="0.00177271 0.0020874 0.00254893"/>
              <joint name="neck_pitch" range="-0.698132 0.698132" armature="0.0005" damping="0.5" frictionloss="0.3" axis="0 1 0"/>
              <geom name="head" size="0.1" pos="0.01 0 0.08"/>
            </body>
          </body>
        </body>
      </body>
    </body>
  </worldbody>

  <contact>
    <exclude body1="pelvis" body2="L_thigh"/>
    <exclude body1="pelvis" body2="R_thigh"/>
    <exclude body1="pelvis" body2="torso"/>
    <exclude body1="L_thigh" body2="L_shank"/>
    <exclude body1="L_shank" body2="L_foot"/>
    <exclude body1="R_thigh" body2="R_shank"/>
    <exclude body1="R_shank" body2="R_foot"/>
    <exclude body1="torso" body2="L_upper_arm"/>
    <exclude body1="torso" body2="R_upper_arm"/>
    <exclude body1="L_upper_arm" body2="L_forearm"/>
    <exclude body1="R_upper_arm" body2="R_forearm"/>
  </contact>

  <actuator>
    <general name="l_hip_yaw" joint="l_hip_yaw" ctrlrange="-70 70"/>
    <general name="l_hip_roll" joint="l_hip_roll" ctrlrange="-204 204"/>
    <general name="l_hip_pitch" joint="l_hip_pitch" ctrlrange="-350 350"/>
    <general name="l_knee" joint="l_knee" ctrlrange="-258 258"/>
    <general name="l_ankle_pitch" joint="l_ankle_pitch" ctrlrange="-311 311"/>
    <general name="l_ankle_roll" joint="l_ankle_roll" ctrlrange="-177 177"/>
    <general name="r_hip_yaw" joint="r_hip_yaw" ctrlrange="-70 70"/>
    <general name="r_hip_roll" joint="r_hip_roll" ctrlrange="-204 204"/>
    <general name="r_hip_pitch" joint="r_hip_pitch" ctrlrange="-350 350"/>
    <general name="r_knee" joint="r_knee" ctrlrange="-258 258"/>
    <general name="r_ankle_pitch" joint="r_ankle_pitch" ctrlrange="-311 311"/>
    <general name="r_ankle_roll" joint="r_ankle_roll" ctrlrange="-177 177"/>
    <general name="waist_yaw" joint="waist_yaw" ctrlrange="-70 70"/>
    <general name="waist_pitch" joint="waist_pitch" ctrlrange="-116 116"/>
    <general name="l_shoulder_pitch" joint="l_shoulder_pitch" ctrlrange="-167 167"/>
    <general name="l_shoulder_roll" joint="l_shoulder_roll" ctrlrange="-164 164"/>
    <general name="l_shoulder_yaw" joint="l_shoulder_yaw" ctrlrange="-70 70"/>
    <general name="l_elbow" joint="l_elbow" ctrlrange="-76 76"/>
    <general name="l_wrist_roll" joint="l_wrist_roll" ctrlrange="-36 36"/>
    <general name="l_wrist_pitch" joint="l_wrist_pitch" ctrlrange="-48 48"/>
    <general name="l_wrist_yaw" joint="l_wrist_yaw" ctrlrange="-48 48"/>
    <general name="r_shoulder_pitch" joint="r_shoulder_pitch" ctrlrange="-167 167"/>
    <general name="r_shoulder_roll" joint="r_shoulder_roll" ctrlrange="-164 164"/>
    <general name="r_shoulder_yaw" joint="r_shoulder_yaw" ctrlrange="-70 70"/>
    <general name="r_elbow" joint="r_elbow" ctrlrange="-76 76"/>
    <general name="r_wrist_roll" joint="r_wrist_roll" ctrlrange="-36 36"/>
    <general name="r_wrist_pitch" joint="r_wrist_pitch" ctrlrange="-48 48"/>
    <general name="r_wrist_yaw" joint="r_wrist_yaw" ctrlrange="-48 48"/>
    <general name="neck_yaw" joint="neck_yaw" ctrlrange="-4.1 4.1"/>
    <general name="neck_pitch" joint="neck_pitch" ctrlrange="-4.1 4.1"/>
  </actuator>

  <sensor>
    <gyro site="imu" name="gyro"/>
    <velocimeter site="imu" name="local_linvel"/>
    <accelerometer site="imu" name="accelerometer"/>
    <framezaxis objtype="site" objname="imu" name="upvector"/>
    <touch site="l_sole" name="l_foot_touch"/>
    <touch site="r_sole" name="r_foot_touch"/>
    <subtreecom body="pelvis" name="pelvis_com"/>
    <subtreelinvel body="pelvis" name="pelvis_linvel"/>
  </sensor>

  <keyframe>
    <key name="home" qpos="0 0 1.14945 1 0 0 0 -5.70398e-06 -8.37864e-05 -0.199383 0.377488 -0.142259 0.000109713 9.91938e-06 -0.000100439 -0.199275 0.377338 -0.14222 0.000135083 3.30337e-05 0.00739669 0.00393842 1.98653e-06 4.26314e-07 -0.292835 3.8108e-12 0.000518364 9.87687e-08 0.00393841 1.98652e-06 4.26314e-07 -0.292835 3.81068e-12 0.000518364 9.87687e-08 7.14183e-07 0.00256277"/>
  </keyframe>
</mujoco>
