BryanRalston/robot-lab/(commit log)

2026-10-12 v2 CAD: parametric CadQuery model, interference checks + range fixes (knee 0-120), CAD mass/inertia, scikit-fem FEA (femur/tibia/hip bracket), STEP/GLB export, v2_cad viewer page; rotary elbow; sim r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
2026-10-13 v3 WIP checkpoint: catalog parts, checks, CAD, FEA, sim, site pages (in progress)
2026-10-13 v3.2 WIP: ankle actuators to shank front, twin knee screws + lever re-clock (0-135°), stroke check, torso doublers, analysis fixes
2026-10-13 v3.2 WIP: knee lever transform fix (was commented out), half-model FEA, battery mass-down, balance COM report, knee 0-135 in sim
2026-10-13 v3.2 step3: CAD COM +4.4 mm ahead of ankles; sim stands with balance ON, not with balance OFF (controller limit)
2026-10-13 modules: Arbiter round 1 — DRAFT TARGETS, CONTRACTS rev0, PROPOSALS/RULINGS templates, v3 AUDIT
2026-10-13 legs step1: gait library (LIPM preview + 2-stage ZMP correction, IK, floating-base ID with CoP/friction QP); walk 1.2 m/s and stairs 18 cm results
2026-10-13 legs step2: all six gait-ID scenarios (walk 1.2/0.8, stairs 18 cm, 20 kg carry, sit-to-stand, push step), envelope table + plots
2026-10-13 legs step3: forward-sim walking (ID feed-forward + PD + virtual-model balance); walk 1.0 m/s ID added
2026-10-13 legs step4: README (method, assumptions, requirement table, forward-sim results); proposals P-001..P-004
2026-10-13 legs: README duty cell fix
2026-10-13 Actuators round 1: re-size leg actuators to P-001/P-002, 20S bus + Gold Twitter + EtherCAT, twin-screw knee/hip_pitch, P-004 response, P-005
2026-10-13 Actuators round 2: knee 7565 rpm (RV12x5 47.5 mm), CAD housings/linkage (-1.81 kg), regen bus sim, datasheets
2026-10-13 actuators: keep round-1 progress image frozen
2026-10-13 Actuators: P-006 round-2 contract updates
2026-10-13 legs r2 step1: 65 kg gait-ID re-run (all scenarios + r2 gait with arm swing/pelvis yaw), stairs with wide ankle limit, fsim controller attempts, DECISIONS
2026-10-13 Actuators round 3: iron loss, steady 1.0 m/s fallback, regen sensitivity sweep, bench test plan, P-007
2026-10-13 legs r2 step2: knee lever sweep 58.5-40 mm and hip_pitch twin-screw geometry study (angle-resolved needs from 65 kg ID)
2026-10-13 legs r2 step3: leg structure 4.84 kg (both legs) + 0.588 kg linkage allowance breakdown; fsim --record + stick-figure strips
2026-10-13 legs r2 step4: Grok Build briefs (WBC 1.2 m/s, structure FEA), P-008..P-010, DECISIONS L7-L9, media + README
2026-10-13 legs: Actuators follow-up L10 (knee k=0.87, hip lever clearance clash + fix, no flange credit)
2026-10-13 legs r3 step1-2: carry 20 kg at 0.8/1.0 m/s (ID + fsim complete), sit-to-stand re-plan hip>=-75 deg with chair in scene
2026-10-13 legs r3 step3-5: structure hand check (closed-box foot), one linkage table, 0.8 m/s gait export, P-011, DECISIONS L11-L15
2026-10-13 Actuators r3b: hip_pitch lever config B FEA (0.371 kg, SF 2.13), clearance check, CRBH 5013 A pivot bearing
2026-10-13 Actuators r3b: ankle 77 mm study (R-011), one linkage table + mass rollup (R-013)
2026-10-13 Actuators r3b: bench plan 235 W line + BOM/schedule, P45B binning/usable fraction, D25-D31, P-012
2026-10-13 Arbiter R-014..R-015: P-011 carry verified at 1.0 m/s (replaces 0.8 fallback, 1.2 tracked, 77 mm lever open); linkage table accepted, T2 recovery M1-M4 (-1.95 kg) -> 64.61 kg
2026-10-13 Arbiter R-016: whole-robot T2 ruling folding P-012 (linkage 2.53 kg accepted, ankle 70 mm, margin 1.3 hip_roll/hip_pitch, cuts M1-M4); T2 66.5 kg recommendation PENDING BRYAN
2026-10-13 Arbiter R-017: Bryan approves T2 hard limit 65.0 → 66.5 kg; keep 20 kg carry and M1–M4 cuts
    Resolves R-016 PENDING BRYAN (Option B). Owners: M3 harness → RL Actuators;
    M3 covers and M4 brain held by Arbiter as placeholders (credit on real numbers).
    Rollup 64.61 if M1–M4 land; credible ≈ 65.95 [EST] (reserve 0.55, thin).
2026-10-13 legs r2 step4: 1 kHz whole-body QP on the 1.2 m/s cruise
    The QP walks the looped walk_1p2_r2 slice, then the stance foot loses corners and the pelvis upright check trips at 4.915 s (mean 1.133 m/s). A 60 N·s lateral push at 4.06 s falls at 4.491 s. The 20 kg carry falls at 7.733 s (mean 1.187 m/s). The fsim --kc 10 --kr 8 re-run falls at 5.452 s.
    Acceptance numbers, per-joint torques, and the stick-figure GIF are in modules/legs/grokbuild/results and media/progress.
2026-10-13 Actuators r4 M1: needle straddle pivot, lever SF 1.5 + proof test, GE12E rod ends, linkage table 2.25 kg
2026-10-13 Actuators r4 M3: harness mass model 0.82 kg (target 1.46)
2026-10-13 Actuators r4: ITECH RFQ draft (not sent), rollup 66.45 kg, D32-D40, P-013, progress image
2026-10-13 Arbiter R-018: P-013 ruling — harness credited per part 1.344 kg, M1 closed −0.278, credible 66.98 vs 66.5, 0.78 kg reassigned (Legs M2 FEA, harness evidence)
2026-10-13 Actuators R5 A2 (O16): harness on datasheet g/m + v3 routed lengths 1.314 kg (credit -0.030 per R-018), cable/connector datasheets, ITECH RFQ parked
2026-10-13 legs r4: M2 structure 4.79 kg (scikit-fem foot+clamp FEA), femur ø80 seat, hip stop -105, thigh clamp, 66.5 kg gait re-run, P-014, L16-L20
2026-10-13 Arbiter R-019: P-014 ruled — hip stop -105 (R-012 amended), ankle 73 mm conditional, split-collar clamp conditional, M2 credited -0.339 (FEA parts x1, hand x0.5), lug double count removed, credible 6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
2026-10-13 Actuators R5b: ankle 73 mm, thigh clamp review (bond required), linkage cleanup + data-driven harness line, MachFlex/SILI-E flex harness, O21 masses+ROM, P-015
2026-10-13 legs r5: femur ø35 needle press-fit tongue (O17), bonded thigh clamp + positive backup (O22), instep pin 73 mm clearance, M2 4.822 kg, L21-L24
2026-10-13 Arbiter R-020: P-015 + Legs r5 ruled — O17 needle/ø35 tongue, bonded clamp + pinned sleeve (shoulder overruled), PTFE GE eyes w/ T9 life cond., M2 4.862 accepted, harness credited 1.324, credible 66.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
2026-10-13 legs r6: A7 DP490 bond spec (cited datasheets, proof 13.1 kN, witness mark), A6 hip stop bumper + soft limit, A1' FEA brief items 6-7, L25-L27
2026-10-13 Actuators R6 (R-020 A8/A9/A5): GE 12 C eye life 10.6k h -> wear part 5250 h, JST-GH 0.384 g published, O20 test plans, ankle 73 mm stroke 118.6 mm + RV12x4 L10 544k h, rollup 66.853
2026-10-13 legs r6: WBC QC diagnosis, contact-fix sweep (all fail), Grok Build fix brief
2026-10-13 Arbiter R-022: official mass rollup (single source of truth) credible 66.054 / paper 64.531 vs 66.5; A8 GE 12 C wear part 5250 h accepted; A9 harness 1.286 x1.0; A5 2.9 mm inadequate -> ankle_roll ±1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
2026-10-13 Actuators R-022 A13: official-rollup re-base, deltas only; ankle ±18 stroke
2026-10-13 legs R-022 A14: ankle_roll ±18° hard stop, push re-run, thigh-clamp pin access panel
2026-10-13 legs r6: close the WBC plan loop on DCM footsteps
    _plan_mpc places the swing foot from the sagittal and lateral DCM error, adapts playback rate around cruise/v_plan, and feeds yaw_off into the stance hip yaw and the swing foot. Cruise 0.5 and 0.8 no longer produce the same run.
    The 1.2 m/s walk still falls at 5.676 s (mean 1.082 m/s). The 60 N·s push and the 20 kg carry fall as well. Realized double support on the walk is 2.41% and the airborne fraction is 9.81%. Numbers are in modules/legs/grokbuild/results/REPORT.md.
2026-10-13 legs r7: WBC r6 QC diagnosis + DS/CoP-inset tests, RL walking brief
2026-10-13 legs r7b: WBC touchdown gate, 12 mm CoP margin + toe-rocker refs, 0.8/1.0/1.2 tests
2026-10-13 Actuators O13: fillet the hip_pitch lever cheek junction and add the convergence runner.
    R3 on the arm-to-cheek splines self-intersects on the 5 mm cheek wall, so geom4 keeps the largest valid OCC fillet (R2.8). The runner meshes h = 4, 3, 2.5, 2 mm plus a 1.5 mm gmsh box at |y| ~ 34.
2026-10-13 Actuators O13: report the hip_pitch lever mesh study.
    R2.8 cheek fillet, five meshes. The element max climbs to 490 MPa at the bore lip (SF 1.03). No finite Richardson peak, so d0 stays 25 mm.
2026-10-14 Actuators O13b: lever v2 pressure-loaded bore FEA, B1 rejected, Grok Build brief
2026-10-14 legs L34/L35: hip_pitch lever G2 (closed cap) chosen, ±38.5 envelope accepted with arm-clocking condition
2026-10-14 Actuators O13b: Grok Build lever brief G2-only, Legs L34/L35 constraints, READY FOR QUEUE
2026-10-14 Legs FEA checkpoint: fork, tongue, clevis, ring, tubes, press-fit, and bond.
    P2 tetrahedra, C3D27 tubes, and the axisymmetric DP490 layer. The bore cosine now integrates to the requested force. Result JSON is under modules/legs/grokbuild/results. Clamp, femur tongue, and foot are still running.
2026-10-14 Legs FEA: foot, clamp, femur tongue, and the structure report.
    h = 2 mm foot with the ankle flange, h = 1.5 mm clamp, femur tongue press-fit, and the clevis mesh comparison. STRUCTURE_FEA_REPORT.md records every solved stress. The M2 line is unchanged at 4.822 kg.
2026-10-14 legs r8: structure FEA fixes (clevis pad, clamp arm, tangent tongue neck, foot collar, tube doublers), M2 5.114, GB re-check brief
2026-10-14 Legs RL: MJX walk env, PPO trainer, and CPU eval harness.
    The training copy, gait reference, and eval live under modules/legs/rl. sim/v3 is unchanged. PPO smoke on the RTX 5060 ran; the long walk is next.
2026-10-14 Legs RL: keep Brax eval metric keys on the env step.
    EvalWrapper adds metrics['reward'] before the episode scan. Replacing the metric dict dropped that key and the eval unroll would not trace.
2026-10-14 Legs RL: checkpoint the walk_a policy after 40M steps.
    Final MJX eval on the training env: mean body speed 0.67 m/s against a mean command of 0.68 m/s, return 105.2, 12.5% of episodes fell, up-vector 0.995. Wall clock 4.14 h, 2318 MiB, 2772 env-steps/s. The push fine-tune continues from this checkpoint. The CPU gates are not scored yet.
2026-10-14 Legs RL: restart walk_b on 50-150 N pushes.
    The 50-300 N mix, including a 15% chance of a 300 N impulse, left the eval fall rate at 72% from 7.2M through 21.6M steps. walk_b and carry now use the brief's 50-150 N range and resume from the walk_a checkpoint.
2026-10-14 Arbiter R-023: accept Legs L36 FEA fixes (M2 5.154), void A1', 0.267 tube hold, A14 adds; official rollup credible 66.125 / paper 64.891, reserve 0.375
2026-10-14 Robot Lab: v4 model-fidelity pass - module-part legs, placeholder upper body, joint audit (4 buildable, 26 placeholder, 2 FAIL), interference sweep, site/v4.html
2026-10-14 Actuators v4 audit fixes D59-D62: knee twin housing, ankle end joints + body STEP, hip body trim; P-018
2026-10-14 legs v4 audit: knee twin housing, ankle D60 clevises + QA1/outrigger, hip yaw/roll stops, real clevis/foot dims, hip note corrected; audit 0 FAIL
2026-10-14 Actuators D63: ankle top clevis fit, tine ligament check, instep lug position
2026-10-14 Arbiter R-024: accept v4 audit fixes (Legs 15c602d +0.200, Actuators P-018 +0.138); official rollup credible 66.463 / paper 65.229, reserve 0.037; floor waiver to R13; margin plan A18-A22
2026-10-14 Robot Lab v4.1: fold in Actuators D59-D62 + Legs L37-L40, measured hip clearance, ankle verdict from sweep data; full re-sweep, audit 6 buildable / 26 placeholder / 0 FAIL; GLB + v4.html regenerated
2026-10-14 Legs RL: checkpoint the walk_b policy after 30M steps.
    Final MJX eval with 50-150 N pushes: mean speed 0.60 m/s against a mean command of 0.61 m/s, return 87.9, 12.5% of episodes fell, mean episode length 18.9 s, up-vector 0.995. Wall clock 3.11 h. The 24M-step eval had a 3.1% fall rate at a lower command. Carry is training from this checkpoint.
2026-10-14 Arbiter R-025: P-019 head line accepted (v3 basis 2.692 -> 1.178 credited), A11 AGX301 needs JCB022 GMSL2 board (+0.045), D63 reviewed (no mass); official rollup credible 64.995 / paper 63.392, reser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
2026-10-14 Robot Lab A23 (R-025): cite head parts (6806/6800, RECOM RP40-11012SFR 68-84V->12V, prepreg, 7075 stock, Lee spring), RS485 on carrier, JCB022/JCB009 GMSL2 note; head line 0.817 kg; P-019 addendum
2026-10-14 Arbiter R-026: A23 accepted/closed; head 0.817 paper / 1.104 credited (-0.074); RP40-11012SFR verified (43-160 V covers 68-84 V + 90 V clamp; 3.0 A servos <= 3.33 A, ZED on PoC); order /P-HC, add inp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
2026-10-14 Robot Lab A27 (R-026): RP40-HC variant, note-9 input filter (3x 200BXF68 + 2x SMDJ90A), XM430 1.5 A current limit as required firmware setting
2026-10-14 Arbiter R-027: A27 booked/closed (head 0.833, filter +0.016; obsolete BXF cap -> A28); no-3D-printing = crew preference (a88c2d8/104c9ad), not Bryan; P-020 covers PA12 MJF -> thermoformed PC 1.5 mm (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
2026-10-14 RL Arms & Hands R1: architecture (sim/v3 arm loads 10 kg reach/carry; keep v3 shoulder/elbow/wrist_roll, wrist pair 4.3x oversized -> downsize proposal; tendon 11-DoF hand; arms+hands 19.08 kg on bud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
2026-10-14 RL Controls R1: take over legs/wbc + RL walk; R1_STATUS (G4 not met: WBC fell 5.676 s @1.2, RL walk_a 0.67 m/s 12.5% falls, CPU gates unscored); MJX neck -> 2x XM430 4.1 Nm per P-019/A26
2026-10-14 RL Electronics R1: architecture (AGX301 needs 36-60 V: booked DCM3623x75H26C2 is 36-75V->24V, propose DCM3623TA5N53B4 43-154V->48V; A11 close w/ JCB022; A24 close conditional on CTI BSP r38.4 ZED X s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
2026-10-14 legs: D63 tine spec (L41), P-019 sim neck (L42), Controls handoff, v5 fairing envelope script WIP
2026-10-14 RL Industrial Design R1: own V5 polish plan; v5 cover set draft (P-020 PC 1.5 panels 2.01 kg vs 1.16 booked; propose P-022 knee cap, P-023 hip skirt, P-024 waist bellows, P-025 ankle boot +0.38; trim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
2026-10-14 RL Industrial Design R2: trimmed v5 cover set as baseline (R-029): P-020 1.009 kg (-0.148) + P-022..P-025 0.383 = +0.236 kg vs booked (+0.126 with CF shin/thigh); untrimmed +1.238 kept as option
2026-10-14 RL Industrial Design: A29 panel layout + mould list (12 PC tools, 1 strip, 1 bellows, 2 patterns); trimmed delta +0.236 <= 0.30 cap
2026-10-14 RL Thermal R1: whole-robot heat budget at 1.0 m/s + 20 kg carry (~792 W; hip_pitch/knee fail under closed covers, bondline needs thermal break, elbow hold fails, Thor bay needs ~21 CFM)
2026-10-14 RL Electronics R1.1: A34 Elmo R70/100 verified (install guide Table 3 + elmomc.com; no peak row), DCM3623TA5N53B4 24.0 g datasheet Rev1.2, regen clamp 88/86 V + 92 V bus ceiling (Roboteq SR5K rejecte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
2026-10-14 RL Torso & Power R1: architecture (20S5P P45B 1620 Wh 8.75 kg; BQ79616x2 BMS, IPT059N15N3 B2B FETs, L50S125; 48 V brain rail DCM3623TA5N53B4 per Electronics; torso 4.305 kg; waist_pitch need 188 > 11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
2026-10-14 RL Materials R1: MATERIALS_DB (.md/.json, cited) + REVIEW_R1 (covers, palm, Ti cross, femur/bond, PTFE liners)
2026-10-14 Actuators D64 A25 harness (GMSL2 coax, RS-485, ECAT waist, STO star, 48 V compute), Elmo R-type spec check; D65 wrist pair BNK1004 downsize
2026-10-14 RL Arms & Hands R2: P-026 arm ROM cut (elbow -125, wrist +-60/+-30), P-027 wrist pair <=0.90 kg/side; R2_OPEN_ITEMS O-A1..O-A5 (O-A3 forearm cross-section FAIL at ID66, O-A4 arm harness inside 1.286 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
2026-10-14 Actuators D66 A33: STO 3-wire daisy chain per branch (0.218 kg), 32 Elmo drives (leg pigtails 8/leg, neck = Dynamixel), harness 1.496
2026-10-14 RL Controls A40/P-029: per-joint 2-node winding model (Cu α, TBM2G Rth, sizing.json) + derate 120->130->140 °C; demo on WBC 1.2 m/s trace: knees hit 120 °C at 9-10 min (tau_cont 83 Nm < RMS 96-118)
2026-10-14 legs v5: swept fairing keep-out envelopes (hull+5 mm) STL+JSON; knee_cap/foot_upper/hip_skirt re-sweep with tighter clips in progress
2026-10-14 RL Electronics R1.2: Arms & Hands answers (clock-spring vs slip ring, MRTA2P26S torsion, arm STO 0.0425 kg/side, P-026 loops -0.0012 kg, hand node, RP40-11024SFR wrist 24 V, SPI tactile); A41 Thor du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
2026-10-14 RL Arms & Hands R3 (A39/R-030): P-028 chest-carry pose sp -60/el -110, elbow 6.95 / shoulder 43.45 N·m at 10 kg/hand; hold limit: none at pose, <=30 s if elbow >15 N·m [assumption pending Thermal J-T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
2026-10-14 RL Thermal: O-A2 arm hold transient (elbow +100 K in 3.6 min, shoulder never at nominal h) and A35 hip_pitch/knee vent spec (h>=15, inlet>=50/outlet>=60 cm2, gap>=8 mm)
2026-10-14 RL Materials A37: G10 thermal-break sleeves at hip_pitch eye pins (SF 5.0 RT / ~2.5 hot EST, ~10 K/W, +15 g EST); DB adds G10/PEEK/PEI
2026-10-14 RL Torso & Power R1.1: regen clamp (2x IPT059N15N3, HS200 1R5, LEV100A4ANG contactor, HS50 47R + BSC520N15NS3 precharge, BMS interlock; +0.745 kg to Arbiter); Arms O-A1 answers (y +-0.170 kept, 8xM8 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
2026-10-14 R-032: Thor fan Sunon PF40281B 0.042 kg / 6.12 W
2026-10-14 Actuators D67 P-027: wrist BNK1004 pair 3.46x pitch peak, L10 26.2 kh (fw1.2, EST duty), 0.884 kg/side w/ AksIM-2 encoders
2026-10-14 RL Arms & Hands R3: P-028 -> P-042 per R-031; hold limits from Thermal O-A2 (unlimited in band; elbow >15 N·m: <=2 min @40 then <=28; shoulder >55 N·m <=10 min); hand node + RP40-11024SFR +0.156 kg b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
2026-10-14 Arbiter A12 (R-031 §11): official rollup through R-032: harness 1.496 incl. STO, trimmed covers +0.236, Sunon fan +0.042 (T7 +6.12 W), regen clamp +0.150; credible 65.809 / paper 64.380, reserve 0.69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
2026-10-14 RL Torso & Power R1.2 (R-031): waist_pitch margin 204/188.2 cited; O-T3 contactor kept (diverse disconnect); clamp = P-045; A41 duct vents 46 cm2 free each, partition +0.147, TSR 1-48120WI fan supply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
2026-10-14 RL Electronics R1.3: XP[1] OV trip range from MAN-G-CR 1.406 (0..WI[35], reduce-only; WI[35] value for 100 V models not public -> bench read / Elmo question)
2026-10-14 Actuators D68: O-A3 maxon drive lengths (DCX22S+GPX22HP 72.4/70.9/80.9; DCX16S+GPX16LN 52.2/60.7), TBM2G hot Kt/R (Cu 1.501x @155C), HD efficiency ~84% @500rpm; datasheets
2026-10-14 legs v5: final re-swept knee_cap (r<=110 about knee axis), foot_upper (no screws, z<=165), hip_skirt (r<=150 about hip) envelopes
2026-10-14 Actuators D69 (A40): THERMAL_DATA_PACK (155 C limit, PT1000 code A, motor/iron/Elmo loss), knee fix 2x TBM2G-08513D + shank path (never reaches 120 C, +0.47 kg); G2 brief amendment 1 (T&R fatigue 58 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
2026-10-14 RL Electronics R1.4: Torso replies - P-045 clamp HS100 1R5 (76.7 J/C, 400 J=5.2 K; 200 W cont not needed w/ charge rule) 0.145 kg <= 0.15; contactor/precharge ~0.23 Torso -> Arbiter; O-T9 accepted w/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
2026-10-14 R-033: pack contactor +0.232, clamp HS100, G5 T-025/T-026
2026-10-14 RL Arms & Hands R3b: P-042 recheck w/ catalog inertials (elbow 7.09, shoulder 46.87); arm_inertials_r3.json for Controls (O-A1); wrist duty L10 57.7 kh @fw1.5 (rec fw1.5); mass line 17.908 vs 19.084 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
2026-10-14 RL Arms & Hands P-042: hold limits per Thermal 7675c8b (elbow <=3 min @40 then <=28; shoulder 126 C derate band); elbow solution: 15 N·m pose primary, brake option evaluated (no cited part, not propo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
2026-10-14 RL Thermal D69 knee check: 0.72 K/W needs finned tibia spreader (bare tube 0.85-0.99); covered ~125-135 C, vented ~90 C; tibia collar ~42 C pass; knee drives on spreader; limits 155 abs/130 derate/12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
2026-10-14 RL Arms & Hands: P-027 cross-check for R-034: credit -1.332 (D67 0.884/side incl. encoders), not -1.371; 66.511-1.332=65.179, clears 0.011 overage, reserve 1.321; verdict confirmed (packaging caveat 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
2026-10-14 RL Controls A40 v2: THERMAL_DATA_PACK (f205f7b) params, 155 C hard limit, iron + Elmo drive loss, D69 knee (tau_cont 141, Tw60 89/92 C), arms+waist, PT1000 correct(); knee_thermal.py base uses load_p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
2026-10-14 RL Torso & Power R1.3: HS100 clamp pulse check (OPEN, fallback 2x HS100 0R75), 4.15 V cap breaks T7 -> charge 4.20 V, HS25 pre-charge option, O-T9 accepted, BMS message gaps, torso line 5.024 kg (+0.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
2026-10-14 RL Electronics R1.5: R-033 changelog (13.8), weld/short bus sense AMC1311 x2 + fault-channel split (13.9), hand current cap + wrist-pair phase-lead interface (10.6)
2026-10-14 R-036: charge 4.20 V/cell, BMS regen hard req, runtime margin thin
2026-10-14 RL Torso & Power O-T7: sim_torso_body_r1.json re-split torso body (16.625 kg, pack in chest, 2x1.52 shoulder_pitch in Arms line) for Controls to merge
2026-10-14 Actuators D70 wrist rotary CSG-14 0.671 kg/side; D71 shoulder_pitch CRBH fs 1.04 -> 8016A; D72 wrist leads 0.244 kg/side; D67 L10 57.7 kh credit -1.332
2026-10-14 RL Arms & Hands A32/P-021: palm_7075.py (7075-T6 palm CAD, tendon/finger/wrist/thumb features, galvanic + hybrid), guarded import in model_v4; audit_v4 runs (6 BUILDABLE/26 PLACEHOLDER, 0 interferenc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
2026-10-14 RL Electronics R1.6: A43 hand burst (RP40 hiccup at 150% typ -> RP100H-11024SRW 101 W, 105/157 g; supercap rejected; wrist 0.5 mm2 OK at 3.3 A); R-036 clamp vs top-of-charge window from regen traces 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
2026-10-14 RL Torso & Power R1.4: record R-035/R-036; FAULT_N ch2 = 2x BQ77216 (OV 4.25 V); host S32K344 + BQ79600-Q1; BMS +0.26 W, walk margin +0.74 W; LEV100 190 g cited (torso 5.016 paper); P45B 4.20+-0.05 V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
2026-10-14 RL Thermal A43: shoulder 47-54 N.m continuous OK (<=99 C), 10 min cap OK to 62 N.m, torque-graded caps above; hand motors OK for 80 W bursts with per-motor caps, RP40-11024SFR NO (150% OLP) -> <=52 W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
2026-10-14 Actuators A42/D72: wrist motor leads merged into harness.py; harness 1.4959 -> 1.9841 kg (+0.4882)
2026-10-14 legs: R-031 lever family + P-046..P-050 fixes + T&R FEA brief; D69 knee saddle (Thermal 26412c7) + no-cover zones; envelopes summary for ID; knee-cap gap 10.2 mm @135; 7050 femur; L43-L46
2026-10-14 RL Controls A40 v3: Thermal 26412c7 limits (derate 130->145, off 150 PT1000, 155 abs, target 120); drives off housings (P-027, knee on shank saddle); 1.2 m/s 60 min all legs <=115 C; P-042 carry pose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
2026-10-14 RL Controls: apply arm_inertials_r3 (a618ce0) to sim/v3 (L/R mirrored; 2x1.52 kg shoulder_pitch merged into torso, 63.47->69.48 kg sim); P-042 carry static balance: COM 107 mm ahead of ankle (toe mar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
2026-10-14 RL Electronics R1.7: Torso R1.4 alignment (BQ77216 ch2, S32K344+BQ79600, BUS_SENSE_STATUS frame); R-038 2x RP40-11024SFR independent rails (no share pin per datasheet), 3/3 flexor split, O-E11 per-co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
2026-10-14 RL Industrial Design: final Legs envelopes -> covers -0.124 kg vs booked (-0.184 CF thigh); shin fairing deleted (knee saddle/lower shank no-cover); P-022 knee cap +20% flag; knee cap/thigh gap 10.2 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
2026-10-14 RL Thermal A43 hand supply sign-off: PASS with RP40 case-to-Al bulkhead (gap pad), case 71 C at 35 C, 34 K margin, 40 W/rail continuous OK; -HC heatsink in closed bay FAIL
2026-10-14 RL Electronics R1.8: A43 closure - Thermal mounting conditions, TMP117 bracket sensor (derate 90 C, off 100 C), clip heatsinks dropped, mass per Arbiter (R-040 pending)
2026-10-14 A44 (R-039): side-fall drop/tuck/hip-first strategy, analytic 539 N·m vs 550 at 66.21 kg; CRBH 7013A fs check
2026-10-14 Actuators: R-031 lever section check (b30/d36 +0.123 kg robot, fallback +0.252 > steel threshold; rod 1.94/1.07 mm) + envelope STEPs; D69 strap across thigh trunnion (TAI GFTS 2 sections >=1.32 W/K, 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
2026-10-14 RL Arms & Hands R4: A42 forearm FIT (two mixed tiers 163.8/177 mm, no growth; wrist D70 + hand PSU to shoulder bay), wrist fork fix by sphere rule (palm drop 12 mm, P-026 ±60/±30 min gap 4.91), routi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
2026-10-14 RL Industrial Design R-042: 40 mm EPP 80 shoulder pad (P-051 proposed), 109 cm2/side, -22.6% force (550->426 N·m), 0.100 kg pair at cap; untrimmed text +1.255
2026-10-14 RL Controls: knee A40 on Legs ID plans (walk_1p2_r7 07613D 113-116 C / D69 63-64 C; r2 carry plan 07613D hits 130 C at 32 min) -> D69 needed for carry; sim/v3 torso = Torso sim_torso_body_r1 (16.625 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
2026-10-14 RL Thermal D69B: femur strap/spreader fails 0.72 K/W at h12 (0.82-0.89), marginal at h20; adds +5-8 K to failing thigh bondline unless PEEK-isolated; real need is 1.05 K/W -> recommend housing fins +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
2026-10-14 R-044: reject femur straps, knee housing fins adopted
2026-10-14 RL Electronics R1.9: RP40 bare outline/mounting, O-E11 filter itemized 0.028 kg (x4 = 0.110 vs 0.060 booked), hand-motor leads 22x SiF 0.25 x 1.7 m = 0.202 kg/side proposal
2026-10-14 RL Torso & Power R1.5: shoulder bays on 12 mm bulkhead face (no bracket), ~14 W/side est, bulkhead ~79 C steady; vents 25 cm2 free in/out per bay away from Thor exhaust; 22-lead grommet O16 at 75 mm 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
2026-10-14 RL Materials R-042: EPP 80 shoulder pad check (220 J OK but peak ~17-20 kN not 7.1; PC backing plate; 69 C contact not OK); DB adds EPP80
2026-10-14 Actuators D73 wrist units above pivot (links 15.8 g pending), D74 SHG-20-2SH hollow roll Ø21, D75 hand-board options A +0.398 / B 0-0.077 pending (R-043 freeze); harness booked 1.9841 unchanged
2026-10-14 R-046: hand board stays in forearm (B), A rejected; D73 +0.016
2026-10-14 RL Industrial Design R-042 R2: EPP pad fails real curve; re-size -> 5052 HC 3.1 pcf cartridge 84 cm2 x 37 mm + 10 mm EPP, 0.095 kg pair, 548 N·m; options a-d tabled
2026-10-14 thermal: R-042 EPP pad face temps; A43C forearm RP40/board (supersedes d4cca06 for R-046)
2026-10-14 RL Industrial Design R-047: cover offsets -0.224 kg itemized (louvres -0.142, PC 1.2 low-draw -0.064, PA12 rim -0.013, pad -0.005; -0.112 half-credit); D73 forearm bulge envelope note
2026-10-14 R-049: EPP pad rejected; constant-force crush element <=0.100 kg pair
2026-10-14 thermal: A43C rev R-047 board-only forearm, ladder derate transient
2026-10-14 RL Materials A37 rev B: PEI tine sleeves + 15% lands (SF 2.2 fault hot), outer-ring rejected, Ti limiters, +17 g EST; DB adds Ultem 1000
2026-10-14 RL Industrial Design: shoulder pad R3 for 265 J (Controls 03fc980): HC 3.1 pcf 80x105x44, 6 mm EPP face, 0.100 kg pair at cap; coverage OK for +-15 mm contact; R-047 item 4 -> 0.000, total -0.219
2026-10-14 Actuators D69 rev B (R-043/A46/A47): keep 2x TBM2G-07613D + 0.05 m2 housing fins, walk 96/carry x1.1 116 C open; +0.18 kg robot vs +0.65 booked (-0.47 to reserve); fin sweep: 10.5 mm to knee trunnion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
2026-10-14 Legs L47/L48: R-031 lever merged-web L35 re-check (b30/d36 +0.118 kg, femur 11.0 mm) + knee housing fin envelope sweep; tibia saddle dropped (Thermal 9b9e169), no-cover zone moves to thigh
2026-10-14 RL Electronics R1.10: 16.5 hand board forearm, derate ladder, 125 C parts (XMC4300-F100K256-AA replaces LAN9252 105 C; STM32H7x5 '3' or drop; DRV8874-Q1 G1; X7R), HW OT cutoff NTC+LM2903B-Q1 ~110 C l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
2026-10-14 RL Materials R-042/R-049: honeycomb cartridge check (HexWeb CR III 3.1/4.5 pcf cited; ID R3 fails rate band; recommend 4.5 pcf 63x63x57, ~0.068 kg pair EST); DB adds 5052 honeycomb
2026-10-14 RL Electronics R1.11: 16.6 R-051 latching HW OT cutoff (LM2903B-Q1 positive-feedback latch, rail-cycle reset <70 C, OT_FLAG_N to XMC4300 GPIO), NCP15WF104F03RC rated -40..125 C (Murata), ladder tunin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
2026-10-14 RL Industrial Design: Legs 6f53d77 - knee-housing front grille merged into thigh louvres (thigh 0.443->0.322 pair; R-047 item 1 -0.154, total -0.231); shin fairing optional add-back (+0.300 PC/+0.227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
2026-10-14 RL Industrial Design: shoulder pad R4 (Materials 8a3cc66/R-049): HC 4.5 pcf 62x62x57 cartridge, 8.94 kN @x1.3, 282 J @x1.0, 0.095 kg pair itemized; R-047 item 4 -0.005, total -0.236
2026-10-14 T-030 R-049: honeycomb crush element primary (7.05/9.17 kN, 41 mm stroke, face/angle logging), EPP >75% strain = UNKNOWN, updated hand estimate
2026-10-14 thermal: fix D69C A_gross bug; A43C XMC4300 board power + NTC 110 C check; A43 shoulder-bay air vs RP40 derating
2026-10-14 RL Arms & Hands R5: palm DROP_MM 12 + neck (+0.010 both; audit/clash rerun -> bryan PC); forward fall >>369 N·m -> shoulder_pitch <=300 clutch proposal, D71 7013A conditional on T-030; A44 tuck sy-60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
2026-10-14 Actuators D69 rev B fins as built (Thermal D69C layout): 0.0703 m2, 0.0932 kg/knee measured, walk 89.2 / carry+10% 106.4 C open (Thermal 88/105); hip lever L47 RC STEP 0.464 kg/lever (Legs +0.118 not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
2026-10-14 R-055: Arms R5; forearm: D73 compaction first, <=40mm lengthen fallback
2026-10-14 model_v4: fingers/thumb -12 mm and wrist lug extended to the dropped palm plate (A42/R5, palm_7075.DROP_MM=12); syntax/import check only, full audit on bryan PC
2026-10-14 Actuators R5: thermal pack labels per CONTRACTS §1a (+shoulder_yaw); D76 wrist side-by-side -49 mm, CSF-11 yaw -0.08 kg; D77 clutch too heavy; D78 sheath not found; D79 board in forearm
2026-10-14 T-030 R-054: ID R4 cartridge (62x62x57, 41.0 mm, 6.88/8.94 kN), Arms R5 tuck (-5/-60/-20/-110), carry release before tuck, reach side-only, cap-shell contact geometry, hand estimate
2026-10-14 RL Industrial Design: shoulder pad R5 - relocate to shoulder-cap mount on roll housing (conformal PC saddle, bonded band/inserts), core-sized plate (R4 plate overhang fails 0.5/0.8 mm), 0.097 kg pair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
2026-10-14 RL Materials: honeycomb angle/scatter basis (+-15% -> lot-tested 4.5 pcf ~61x61x53-58 or 71 mm untested), shoulder-cap mount needs 7075 cradle; TENDON_SHEATH (no cited 2.5 mm part <=35 mm; Zeus PTFE 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
2026-10-14 RL Industrial Design: shoulder pad R5 docs (shoulder-cap mount, core-sized plate, 0.097 pair); R-054 decisions recorded; WRIST_FAIRING design for D76 (124x70 stadium, dorsal access, 0.095/side, +0.07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
2026-10-14 RL Materials: tidy doubler mass line
2026-10-14 RL Arms & Hands R6: forearm stack-up with D76 = 284.5 vs 270 (-14.5 mm; R5 undercounted D73 by 28 mm); closure board->upper-arm tube + spool 5 mm + D76 at z26.5 -> +5.0 mm; CSF-11 yaw 0.85-0.99x vs A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
2026-10-14 RL Electronics R1.12: 16.7 forearm hand-board fit (annulus 3185/4824 mm2, FITS), XMC4300 lacks POSIF -> XMC4800-F100K2048 AA, STM32H7 dropped, DP83822HF 125C PHY (closes O-E12), XMC IDD table (0.45/0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
2026-10-14 R-060: lot-tested cores; mount inside cap, booked 0.127
2026-10-14 RL Controls R-052: D69 rev B reproduced within 0.5 K (tau_cont 102.1, walk 96.4, carry x1.1 116.3/103.9, fan 118/77/90) at 0.05 m2 fins + drive on housing; script uses 0.025 m2 (-> 110/136 C); P-042 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
2026-10-14 R-062: rev B double-verified; fins extra >=0.05, drives off housing
2026-10-14 RL Materials R-060: 7075 shoulder doubler D-A (flat seat on roll housing face, 15.5 g/side, pair 85.6 g); legs variant needs FEA; spreader cannot merge
2026-10-14 RL Arms R6b: ID checks (roll housing 2 mm wall fails bare-ring pad load; 66.5 mm pad clashes upper arm at all roll; new tuck sp-30 gives 27.8 mm with 124 mm wrist; fairing edge z>=+10); Electronics 1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
2026-10-14 thermal: R-059 wrist fairing + shoulder-roll pad; A43C 4.3 W XMC4800 rerun with Arms clamp fix
2026-10-14 R-063: pad mount D-A booked 0.106; rev B fin area confirmed
2026-10-14 T-030 per Materials fd46ad8 (6.95kN/38mm gate, 9.17/42 peak, angle scaling + 15 deg limit, 2.2x spike sensitivity) and R-057 (reach removed, tuck permanent); T-031 forward-fall brief + --dirs F gear-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
2026-10-14 R-064: wrist slots adopted; A43 thermal met at 4.3W; ladder unchanged
2026-10-14 Electronics §17: R-062 knee drives to thigh shell; harness delta +0.071 kg/leg
2026-10-14 R-065: pad >=292J worst case; tuck inside chest outline; diagonal pitch <=369
2026-10-14 RL Industrial Design: pad R6 (roll-output mount, 7075 doubler replaces PC saddle, lot-tested 60.9x60.9x55 core, 9.16 kN/275 J, 0.100 pair vs booked 0.127); wrist fairing R-059 (torso-facing forbidden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
2026-10-14 RL Materials R-065: core resize (±3% lot cert, 61.8x61.8x60, 292 J at 15°, peak 9.17 kN), pair 87.0 g, standout 67.5 mm; mandatory part spec (pre-crush, lot cert)
2026-10-14 Legs L47-R (R-066): lever reconciled on RC STEP 0.4642 kg vs booked sf15 0.2492 -> +0.430 kg robot; L47 +0.118 withdrawn (wrong baseline)
2026-10-14 R-068: pad core 61.8x61.8x60 +-3% frozen; unify mount
2026-10-14 R-065: T-031 remedies (a) inside-outline tucks A/B/D from tuck_search.py, (b) preload, (c) forearm crush; diagonals LF/RF; gear<=369 in every mode; pad gate >=292 J @15deg worst case, stroke param (4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
2026-10-14 Electronics §18: R-069 mass-down (0.064 cited wire; +0.124 conditional XT30U removal)
2026-10-14 R-070: rev B standing hold met; tuck primary; wrist open-frame -0.036
2026-10-14 T-030 per Materials 48f55c3: gate 7.31 kN/43.2 mm (293.7 J @15deg), peak 9.17, 1.05x initial-peak gate cases, 2.2x relabelled fault; flag 1.05x on 9.17 = 578 N*m
2026-10-14 RL Electronics R1.13: 16.8 R-061: ENX22 RS-422 (100 C); 2 POSIF + 4 ENX22 Absolute BiSS-C (24x margin), count/dir rejected; MCU was on rail A -> always-on 12 V feed; RP40 CTRL ref -Vin, /P open=ON; B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
2026-10-14 Legs R-069: L47 lever shape-opt Grok Build brief (after G3, target -0.13..-0.17 kg robot) + ankle cross pocketing hand model [EST]
2026-10-14 RL Industrial Design: pad R7 - mount decision roll output + Materials D-A doubler (frozen 61.8x61.8x60 core, 9.15 kN, 293 J @15deg, 0.084 pair); single FEA case defined; wrist open-frame conditions (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
2026-10-14 R-071: harness -0.064; soldered splices rejected; reserve ~0.22
2026-10-14 RL Torso & Power R1.6: R-069 savings (cited -0.0225: LEV100 190 g, HS25 pre-charge; EV100 -0.060 needs +1.5 W ruling), bulkhead stays 12 mm (11 mm SF 1.76), bay thermal ~50 C, inlet top z<=0.155, poc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
2026-10-14 RL Torso & Power R-071: 2.5 mm2 battery link FAIL (ampacity/coordination; fault I2t PASS x16, I_f ~1.17 kA); O-T4 closed (450 VDC, 20 kA DC); mass-down asks noted
2026-10-14 R-073: encoders, leads +0.022, MR30 -0.025, pad roll-output 0.092, legs path
2026-10-14 RL Industrial Design R-069: new cover trims beyond R-047, recommended -0.194 kg (-0.097 half credit); options foot-shell delete, bellows delete, knee 1.2 mm
2026-10-14 RL Arms R7: tuck B check (behind chest, >=35 mm, fall ~343 N.m EST); pad/doubler mount on 7075 roll-yaw link boss (CRBH 6013 s0 2.45@e0, e<=10 mm); forearm definitive -13.9 (D79 board in) / +5.0 boar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
2026-10-14 RL Materials: R-072 lot spec amended (1.00x initial peak, absolute 9.17 kN; core -> 61.8x61.8x61, pair 87.6 g); R-068 mount compare (roll output + D-A); MASS_DOWN_R069
2026-10-14 R-074: battery link 2.5mm2 rejected, torso -0.0225, EV100 rejected, pocketing FEA
2026-10-14 thermal: R-073 ENX22 encoder-end check + ladder B; A35 A36 compliance note
2026-10-14 Electronics §18.2b: R-075 RP03-RAW isolated AO x2 (+0.024 net), T-029 CM test, G1 MR30 clip
2026-10-14 R-069 actuator mass-down: knee fin rev C (-0.065 kg, drives off housing), fin/cheek clash check
2026-10-14 R-076: bus not SELV (RP03, reinforced isolation), pad 61mm, CSG-14, forearm lengthen, ladder B
2026-10-14 R069_MASS_DOWN: correct drives-on-housing risk, pad geometry, hedge unverified gear checks
2026-10-14 RL Torso & Power: R-074 recorded (torso 5.0035), EV100 dropped (3.0 W hold), L50S125 clears ~1.17 kA in ~3 ms pre-arc (O-T8 fuse closed for 10 mm2), T-031 chest contact (bare CF FAIL; HexWeb CR III p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
2026-10-14 RL Materials: COVER_TRIMS_REVIEW (A/C1/D/E/G yes, B no, F1 test; fabrics cited 71 vs 270-310 g/m2); DB adds fabrics
2026-10-14 R-077: RP03-11012SRAW with 80% derate, knee fin rev C conditional, housing pocketing FEA
2026-10-14 Legs L49-L52: A38 rev B tine (rounded e20, +0.011 kg net), Thermal D69C fins 12x25 rear measured 0.0738 kg/knee + clash/fairing, R-062 knee drive plate on femur rear (wire 0.16-0.24 m), ankle cross 7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
2026-10-14 Electronics §18.2c: R-076 bus insulation audit, connector 100 V check, isolation boundaries, PCB rule E-PCB-1
2026-10-14 RL Materials: TENDON_SHEATH rev B (plain PTFE out; no catalog <=2.5 mm coil; custom flat-wire coil EST ~94 g both hands; tendon SF 2.47 at 775 N)
2026-10-14 RL Industrial Design: pad R8 (core bonded to integral 7075 link boss, D-A dropped; 0.096 pair incl. boss, tray option 0.116; centre on CRBH plane; FEA case updated); hip exhaust 70 cm2 (41 %); R-069 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
2026-10-14 RL Controls R-069: knee_revC_check (rev C 0.0459 m2 fins vs rev B 0.0703): STEP area verified, t 1.0 mm eta_an 0.99; P-042 carry x1.1 FAILS at h8-10 (rev B too at h8); 70.8 hold 122.8 C h8 eta0.7; ta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
2026-10-14 RL Torso & Power R-076: SurLok Plus IPXXB connectors (main link 16 mm2), reinforced creepage 2.8 / clearance 1.5 mm, shrouds; connector net ~+0.19 kg EST flagged; O-T12/O-T13
2026-10-14 G4 Grok Build brief: housing pocketing FEA (R-077)
2026-10-14 R-078: uncited isolation = none, worst-case isolation design, XMC 72 MHz
2026-10-14 RL Materials R-076: pad credit reconciled (-4.4 g remaining vs R-073 0.092), covers reconciled with R-075, T-031 chest crush curve (101x101x78, 0.077 kg)
2026-10-14 thermal: R-077 knee h ruling (h>=12 not a floor; carry limit/fan); mark D69C rev C withdrawn
2026-10-14 Legs L53/L54: rev C fins measured 0.0605 kg/knee + clash/fairing (4.7 mm past hull -> grille offset); ID C2 foot top shell deletion accepted w/ conditions, sole pad gap flagged
2026-10-14 Electronics §18.2e: R-078 reinforced boundaries designed in, +0.054 kg (Nomex DCM/RP40, WE 749014012 x5, ISOW/ISO774x hands+STO, ISO1042 BMS)
2026-10-14 Electronics §18.2f: R-079 IP2X inventory 0.086 kg vs 0.25 booked (credit ~0.164, enclosure condition C1)
2026-10-14 D76 update: yaw CSG-14 (+0.08 pair), units lowered to z+26.5 (2.02 mm to fork sphere); spool 5 mm not supported (Marlow 8xd); D77 closed
2026-10-14 Electronics §18.2g: AO supply RP03 -> RECOM RP06-11012SRAW (6 W, 36-160 V, reinforced, 14 g), net 0 kg
2026-10-14 R-082: forearm cap 17 mm for >=2 mm margin, no 5 mm spool
2026-10-14 RL Torso & Power R-079: SBS75X IP20 pack/blind-mate (22 g cited), no bulkhead limb connectors (IP2X enclosure), 10 mm2 link; net -0.161 vs +0.25 booked; FEA spec ready; T-031 rev2 98x98 pad 22.35 kN 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
2026-10-14 RL Arms R8b (R-082): forearm 287 in model_v4 (2.1 mm margin); ext 0.0214/side (+0.005 pair vs R8), arms line 18.139; P-042 elbow 14.58<=15; full-reach elbow peak ~73 > 69 cap -> accel <=87% or ~8.5 k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
2026-10-14 RL Materials: A37 rev C (Legs A38 accepted, pads within SKF da 15, cheek limiters dropped, +10.6 g), sheath rev C (500 N cap, D/d + splice derates), R-080 chest backing (bulkhead land + 60x6 rib +0.0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
2026-10-14 thermal: A38 femur rod-path vs break; R-083 EtherCAT junction 60 C ruling; shoulder bay with 2x RP06
2026-10-14 RL Torso & Power R-084: net +0.005 correction, PSBS75X (~68 g/pair, distributor-cited, Anderson publishes no mass), IP2X bus run ~0.33 m/pole, O-T14 rejected (stiffened pack front SF<2, >=0.38 kg), s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
2026-10-14 RL Industrial Design: Arms R8 forearm cover +15 mm (+0.012 pair); R-079 pad B; R-075/R-081 C2 and silpoly/PA12; R069 tests; touch protection; drive-bay vents
    - Forearm cover L 250->265 mm (shell OD70 unchanged); proportion 0.95 signed off; script delta +0.006/side +0.012 pair
    - Pad R8 option B adopted (0.116, +0.024 vs 0.092); field rebond A rejected; Materials -4.4 g remaining vs R-073
    - R-069: B dropped->B2 PA12 -0.016 (kneel-fall); D/E silpoly 71 g/m2; C2 net -0.133 (R-081 -0.065 half); F2 rejected; C1 dent dropped
    - R069_TESTS.md: T-B2 kneel-fall, T-F1 cycle, T-G retention/fall
    - TOUCH_PROTECTION.md: +0.25 origin is electrical (Torso/Electronics; 0.086 inventoried); thermal cover fix 0.0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
2026-10-14 R-078/R-080: hand XMC4800 72 MHz budget, peripherals, topology, per-flexor 1.08 A stall cap
2026-10-14 RL Torso & Power T-031: adopt Materials' bulkhead land backing (+0.030, cited) over sandwich (0.070) and pack front (fails); pad total 0.091 (-0.040); sternum skin x~+0.147 needs ~37 mm bulge (ID)
2026-10-14 R-087: standoff ribs +0.020, knee bay panels +0.040 net, Wurth move, reserve -0.37
2026-10-14 RL Materials: A37 rev D (lever-eye PEI sleeve + 22/12 tine sleeves; net +27.6 g, +19.2 if R_col<=8)
2026-10-14 Electronics §18.2l: junction relocation, knee covers to ID, 144 MHz AO 3.19 W, DRV8874 R_IPROPI 3.83k (1.915 A), rail summed-current limit 1.5 A + stagger, sleeve +0.013
2026-10-14 RL Materials: T-031 land stiffness ~27 MN/m (SS+shell) vs 5.3 req, PASS; keep 60x6 rib (strength SF 2.55 at 22.35 kN)
2026-10-14 RL Torso & Power R-087: EtherCAT junction PCB on partition cold face (80x120 mm outline, 4xM3, keep-outs, >=13 mm to pack lid), ECAT route rear/left, one 90-deg barrier crossing of sleeved clamp run
2026-10-14 R-083: hand XMC4800 144/144/144 adopted (41% CPU, BiSS STEP 71, VADC /5, PWM 20k, single PHY); 72 MHz kept as fallback; flexor cap 1.66 A clamp/1.80 A trip/ILIM 1.9 A + G5 per-assembly eta calibration
2026-10-14 R-090: flexor cap 1.66 A with G5 calibration, A37 rev D +0.028
2026-10-14 thermal: A43C R-089 144 MHz 4.6 W, 287 mm forearm, ladder B still-air check
2026-10-14 RL Industrial Design: R-082 forearm cover 267 mm (+0.014 pair, 0.96 sign-off); R-087 merged PA12 knee-drive panel 0.071; R-088 P-052 sternum +0.058
    - Forearm cover L 250->267 mm for bone 287 mm; proportion 0.96 signed off; script +0.014 pair (R-087 books it)
    - Merged PA12 thigh-rear panel replaces +0.082 PC rear panels + Electronics 41.8 g covers: 0.071 pair (-0.053 vs separate; +0.031 vs R-087 booked +0.040 FLAG)
    - Tool-only 4x M2.5 captives into Legs band-clamp tabs (Legs to confirm tabs); IP2X baffle; inlet 52 / outlet 63 cm2
    - P-052 sternum plate 120x120, 37 mm proud, +0.058 kg (Torso land+rib separate)
2026-10-14 R-091: rail limit vs T4, IP2X merge neutral, bus-bar sleeve
2026-10-14 RL Torso & Power P-052: sternum pad centre (0.100,0,0.220), 4xM4 inserts (+-0.040, 0.180/0.260), skin x~+0.150, PC plate ~0.058 kg (net ~+0.013 EST)
2026-10-14 R-092: hand board thermal closed, gap pad +0.004
2026-10-14 R-093: knee panel -0.006, sternum plate +0.058, reserve -0.41
2026-10-14 RL Torso & Power R-093: sternum PC bezel ring + film replaces plate, skin x+0.147 no gap, service rule; net +0.020 (-0.038 vs ab432da)
2026-10-14 Legs RL: checkpoint the carry policy after 32M steps.
    Final MJX eval on 0-20 kg and the heightfield: return 52.2, speed 0.62 m/s against a mean command of 0.66 m/s, 87.5% of episodes fell, mean length 11.9 s, up-vector 0.992. Wall clock 5.41 h, 2386 MiB. CPU gates not run. Training is paused here.
2026-10-14 RL Arms R9 (R-091): T4 close at 1.50 A/rail + stagger; single corners pass (<=0.79 s @50 ms); combined worst stalls at 30 N tip (needs 2.08 A/rail), passes at 22 N grip floor (0.80 s); logic 4.6 W on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
2026-10-14 Legs L55-L58: rev B fins measured 0.0932 kg/knee + clash (overhang no trim, 5 mm grille bulge), A37 rev D tine ø22 FEA + lever-eye/knee path findings, R-081 sole pad spec, ID panel tabs; rev C withdr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
2026-10-14 RL Industrial Design: P-052 sternum bezel (R-094) replaces full plate — ID 0.040 vs 0.058; net -0.005 vs CF shell
    Pad 1 mm CF face is visible skin at x~+0.147; PC 1.5 bezel ring (4 captive M4s at Torso §25.1 inserts), <=4 mm flange overlap, 1 mm gasket stand-off, 90x90 free, foam edge seal, TPU film, 15 mm blend. Service: dent >1 mm or crush => replace pad.
2026-10-14 R-099: legs fins, A38 tine, sole pad, tabs
2026-10-14 RL Controls R-081 sole pad CoP re-check (sole_cop_r1.py, compliant Winkler edge + 6 mm ZMP height): ref_m12 walk min margin 12 -> 5.5 mm (47A) / 8.3 (67A); static carry toe 63.4 -> 60.2 / 61.9; zero-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
2026-10-14 RL Controls: R-072/R7/R-076/R-085/R-088 fall briefs + limits
    T-030: gate on 9.17 kN absolute peak (1.05x fault-only); Arms R7 pad on
    roll-yaw link (lever 0.064 m, e<=0.010, release 0.12-0.22 s); R-076
    off-axis table (B side PASS ~10°, diagonals/R5 FAIL).
    T-031: chest rev2 plateau 17.7-22.3 / 16.6-20.8 kN, stroke 62 mm, R-088
    +37 mm standout; --chest-plateau/--chest-stroke; log gear, CRBH s0,
    hand-thigh, outside_core, chest angle/bottom-out, m_eff.
    limits/: elbow hard cap 69 Nm (keep thermal 40 Nm/3 min); R-085 87%
    accel blend at full reach >8.5 kg; interim roll soft stop 135°.
2026-10-14 R-089/R-097: hand rail sum limit 1.50 A @10 kHz, flexor stagger 50 ms default/150 ms max (close 0.72-0.93 s), VADC /6, T-029 rail test, G1 datasheet list
2026-10-14 RL Torso & Power R-102/R-095: pad lot acceptance [19.5,22.3] kN 0deg (18.3 kN at 15deg, 56.4 mm), fallback 95 mm core +0.005; face PU clear note +0.008
2026-10-14 RL Arms R10: pad-normal impact angles (tuck B side 5 deg; R5 retired; diagonals via tuck B + waist yaw +-45 -> 5 deg; wedge rejected); tuck B fall ~351 N.m EST at 287; elbow full-reach accel scale 0.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
2026-10-14 legs: L59 sole R-102 3mm>=60A frame, L60 bracket move, L61 trunnion PEI bush break, plans regen brief
2026-10-14 R-104: sole frame, PEI bushes, elbow 0.84
2026-10-14 MATERIALS_DB: ULTEM 4001 wear grade, Vibram 7373/7663 Shore A (R-106)
2026-10-14 legs: L61 rev R-106 PTFE-PEI bushes 14.4MPa 31.9K/W +0.055; TOP85 Shore citation
2026-10-14 RL Controls R-102/R10: per-dir tuck B, elbow 0.84, WBC_COP_M 16 mm
    Side falls use tuck B (R5 retired). Diagonals: B + waist yaw +/-45 deg
    toward fall shoulder (Arms-method pad angle 5 deg, margin +10; wy+/-30
    gives 15.8). LB arm-only fallback if waist slow. LF waist-slow: flag
    Materials/Arbiter, no wedge. fall_config.json + tuck_search per-dir table.
    Elbow accel scale 0.84 at full reach >8.5 kg (0.85 -> 69.02 Nm at 287 mm
    forearm; 0.84 -> 68.71). O-T5 ~+0.7-0.9% cycle. WBC_COP_M=16 mm provisional.
2026-10-14 legs: L61 final ULTEM 4001 9/21x20 33.1K/W worn +0.074; L59 Shore sources
2026-10-14 R-109: fall waist yaw
2026-10-14 R-110: hot-rated A38 bond (EA 9396 post-cured) + DB: Ultem 4001 k, Vibram 7373 3mm, adhesives
2026-10-14 legs: L62 thin-wall ULTEM 4001 trunnion bush alt (R-111) 10.07K/W 14.0MPa +0.030 robot
2026-10-14 RL Industrial Design: +12.7 mm knee grille bulge (+0.021 pair); L58 tab bosses PASS; L61 cheek open windows 0 kg; TPU film 4.61 g cited (DoonX ρ 1.20)
    Legs L55: rev B fins 4.7 mm past keep-out — 5 mm alone leaves 0.3 mm (fails A35 >=8 mm), adopt 12.7 mm. L58 tabs at x-38 y100/160 z700/780 align with panel M2.5. L61 ø26x20 bosses clash ~9 mm EST with outboard fairing — open 40x30 windows (0 kg). R-098 film: 98x98 x 0.4 mm x 1.20 = 4.61 g.
2026-10-14 L63: A38 cross-pin backup check at 29.6 kN; 8x ø7 radial pins proposed
2026-10-14 R-116: 12 mm trunnion bore, 23 mm boss
2026-10-14 L63-R: cross-pin layout per Materials conditions (stagger, 2.5D rows), H7/m6 bonded, bond SF 1.49, G3 FEA brief
2026-10-14 Legs RL: CPU gate results for the three walk policies.
    All four gates fail. The carry policy stays up for 20 s at the 1.2 m/s command with mean horizontal speed 1.127 m/s, and for 20 s with 20 kg at 0.722 m/s. Both pushes knock it down. walk_a and walk_b fall in the first second.
2026-10-21 RL Industrial Design: R-113 P-052 TPU film removed (-0.005); P-053 radial pin access band for L63-R (+0.016 robot EST); sole fallback no cover impact
2026-10-21 RL Industrial Design: P-053 rev2 no pin access panel (bench-only extraction); -0.036 robot vs L30
2026-10-21 RL Controls: sim/v3 J10 hardware update (forearm 287, knee rev B fins, fallback 6 mm sole, chest pad; 64.827 kg), make_model regen; R-117 payload-position DR + P-042 carry gate (interim), tests
2026-10-21 RL Controls: R-118 sim mass 67.1 kg nominal, DR 65.0-68.5 (make_model, randomize, eval_box corner gates), regen, tests; plan+brief
2026-10-21 ID: pad R9 (job1 FAIL response): smaller core + slip skin, s0 hand calc, rerun case
2026-10-21 R-119 shoulder-pad roll torque: roll clutch basis, 265 J energy
2026-10-21 RL Arms R11: pad load-path fix after FEA job1 fail (B: roll-axis carrier + CRBH 8016 keeps CSG-25, s0 2.53, gear SF 1.28, ~+1.1 kg pair EST; gear-upsize case CSG-32 1.04x / CSG-40 1.72x; grounded A1 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
2026-10-21 ID: pad R10 per R-119 (292 J @7.0 kN, s0 fail -> Arms bearing), rerun case
2026-10-21 RL Arms R12: qualify ID R9 pad (7.0 kN, PTFE mu0.15): R9 alone fails roll gear (521 N.m); recommend R9 + 7075 stand-off pad centre <=20 mm below roll axis, CRBH 6013/CSG-25 kept, e<=5 (s0 2.21, gear 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
2026-10-21 ID: R-120 pad R10 booking, stand-off layout proposal (Arms-owned), Job 8 add-on case
2026-10-21 RL Arms R13 (R-120): stand-off on ID 00ff254 layout w/ Arms flange OD70 8xM4 PCD62+dowels (ID 6xM4 PCD50 SF1.51 too thin); CRBH 7013 A housing OD108/hub70; e stack WC 2.13/RSS 0.92 <=5; clash light p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
2026-10-21 Legs: finalize L47-SO and ankle cross FEA briefs (jobs 5, 7)
2026-10-21 Materials R7: job 7 7075-T7351 ankle cross inputs, L63-R H7/m6 check, swap scan + P-053/P-054
2026-10-21 RL Torso & Power: O-T5 closed 4.55 h; FEA job 3 FINAL; R-103 sternum +0.035; P-145..P-150 cuts -0.26 [EST]
2026-10-21 PROPOSALS: restore Materials P-053/P-054 dropped in 946aa68 conflict resolution
2026-10-21 D81: job1 'forearm-roll' torque = superseded shoulder_roll pad case; keep CSG-25-100, P-055 drop roll clutch
2026-10-21 Electronics §18.4 P-054: cited touch-guard booking 0.145 kg (−0.105 vs 0.25); Elmo OV trip (WI[35]/XP[1]/MF 0x5000) from MAN-G-CR 1.406
2026-10-21 Legs: ankle-cross FEA brief FINAL rev B (7075-T7351, DU bushes, P-053 hollow pins)
2026-10-21 Legs: BOM.md fastener list for Materials Ti swap scan
2026-10-21 Electronics BOM.md: fastener table (14 counted, 0.90 g steel non-structural cited)
2026-10-21 RL Torso: fastener BOM (138 pcs, 50 S/88 N; P-147 -0.05); FEA job 3 yaml+gmsh/ccx script, smoke-tested
2026-10-21 D82: R-122 Actuators rows (housing pocketing -0.316 [EST]) + fastener BOM, Ti non-structural -0.091
2026-10-21 RL Torso: FEA job 3 conformal fragment mesh, ccx post-processing (SF/defl/freq/buckle PASS/FAIL), coarse e2e proven; PROPOSALS torso total -0.25
2026-10-21 Pad R10 FEA rerun (R-120, CASE 00ff254): s0/gear/bolts PASS; stand-off vM+defl FAIL; dowel-only shear FAIL
2026-10-21 Job 8 add-on (Arms R13, R-120): s0/gear/flange bolts PASS; rib+plate vM, defl, dowel-only FAIL; CAD clash not run (no CAD)
2026-10-21 ID: stand-off R11 layout (box section, solid plate, D6 dowels), R11 FEA case, R120 trims, fastener BOM, shoulder CAD (STL)
2026-10-21 R-123: 7075 allowable 480/320 governs; P-053 dup -> P-151; actuator fasteners +0.517, R-122 row3/row12; stand-off R11 +0.060; reserve -1.470
2026-10-21 ID: R-123(d) R11 CASE gates 320/480, R11 +0.060 booked; PROPOSALS P-053 thigh pin access
2026-10-21 TARGETS: T2 limit 68.0 kg conditional (R-123 option B), Robot Lab decision
2026-10-21 RL Controls: R-123 sim nominal 68.0 kg (make_model, eval_box gate), regen, tests
2026-10-21 R-124 conditional 68.0 kg limit
2026-10-21 RL Arms R14: verify ID stand-off R11 (ec12542). Part OK with fixes (flange OD76, D6 dowels PCD57, bore D36, 3xD8 plate access holes; box SF2.34, plate 3.38, dowel 2.41; e stack 2.32 WC). BLOCKER: rea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
2026-10-21 R-123 Materials fixes: 7075 typical label, drop 404 REPO_AL7075, T031 Sy 480, thick-plate A/B (unverified), Ti fastener qualification, P-151
2026-10-21 thermal: T2 68.0 kg actuator margins
2026-10-21 D84: R-123 arm/waist fasteners +0.875 kg; 7075 480/560/70 in G3/G4 briefs and cad_mass; row 12 conditions; 320 re-check
2026-10-21 R-125: W2 shoulder placement (e<=2.4), R-121 clash corrected, arm fasteners +0.50, ankle cross 262 MPa; credible 68.64 > 68.0, R-124 fails
2026-10-21 ID: shoulder CAD housing coaxial X (Arms R14 dims), stand-off/pad ON HOLD R-12x, R14 inputs, BOM de-dup, head/torso cover STL+STEP
2026-10-21 R-125 (c): actuator arm/waist fasteners +0.875, Arms BOM overlap -0.107, JOB9 503->320; credible ~69.41 > 68.0, R-124 fails
2026-10-21 RL Arms R14: add housing_7013_real_coaxX.step (was never exported, not ignored); Job 8b note: head/torso cover STEPs available (site frame Y-up, transform; torso coarse), still on hold
2026-10-21 T&R JOB9_SPEC rev1 (R-123/R-125): 7075 480/560/70, static allowable 320 (single-path A-basis/1.5, 262 thick plate), Se 87 kept
2026-10-21 R-125(b): verified MIL-HDBK-5H 7075 T651/T7351 plate A/B Fty, single-path rule, AL7075T7351 row
2026-10-21 ID: R-125 W2 cover check (head/torso vs on-axis pad): no clash, torso-housing 36.5 mm; pad window re-centred
2026-10-21 Legs: ankle-cross FEA brief FINAL rev C (R-125b: 262/239 ST/295 bearing, ≤1.5in plate, grain orientation)
2026-10-21 Legs: R-031 fatigue brief to R-123 7075 values (480/560/70, 320 allowable)
2026-10-21 Legs: R-031 brief drop superseded 7075 source reference
2026-10-21 Legs: ankle cross FEA brief FINAL rev D (Materials 95436bf)
2026-10-21 RL Arms R15 (R-125 W2): one-piece 7075 wrap carrier CAD (STEP/STL), contact Y 138.8, s0 2.056/1.999 e0/e2.4, Mx 251; OD108 gap 3.0 nominal; head PASS, torso cover penetration roll>=~118 (coarse) -> p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
2026-10-21 R-126: G4 mass rollup 69.42 kg (ledger 69.41), official rollup regenerated, option C scope
2026-10-21 ID: r15 roll sweep (torso 3mm lost 130, contact 132 deg), side-face check, R11 superseded by Arms W2 carrier
2026-10-21 T&R JOB9_SPEC rev2 per R-127(b): tubes single-path 262, 7075 single-path 294/262, 6061 161, fall/fault min(A-basis, Sy/1.1), 480 fall limit removed
2026-10-21 RL Controls: R-127 shoulder roll soft limit 135->115 deg (soft_limits, controller_config, test incl. fall poses); job10 brief note (inputs pin unchanged)
2026-10-21 R-127: MIL-HDBK-5H A-basis rows: 7075-T651 by thickness, 7050 tube (extrusion stand-in), 6061-T6; R-125(b) /1.5 limits
2026-10-21 RL Arms R15b (R-127): carrier gap 3.4 (OCC 3.4 mm), arm 25x60x4, R6 plate root; s0=2.0 at e=2.246 (limit 2.3 is past crossing -> propose 2.2); e stack 1.92 PASS; arm 243 / plate 255 (R6) vs 294/262; 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
2026-10-21 D85: R-126 v3 adders traced; double counts -2.57..-2.73 full, -1.63 credit now; Elmo 22.2 g cited
2026-10-21 RL Torso R-127 C(b): sandwich plate assessment (-0.10 EST, bulkhead FAIL core shear), job 3b coarse; torso cover CAD (STEP + CadQuery, sternum bulge, shoulder openings)
2026-10-21 T&R JOB9_SPEC rev3 per R-128: 7075-T651 single-path by stock band (LT 308/313/308/294/280, ST 271/257, unstated 257), per-band fall/fault, tubes 7050-T73511 262/393, per-part band table
2026-10-21 RL Arms R15c (R-128): carrier stock 7075-T651 2.5 in plate (73x63.4x62, no dim <=2 in), grain L=Y (arm bending), LT=X, ST=Z; Job 8b gate 294 (not 308); STOCK_GRAIN.md table for all arm 7075 parts, re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
2026-10-21 Legs L64: R-128 check (job 7 limit kept, T651 vs T7351 conflict), femur/P-047 vs 262, DRAWING_NOTES
2026-10-21 D86: R-127 C(b) Mg actuator housings (Elektron 43): -0.26..-0.63 kg, G4-Mg addendum
2026-10-21 MATERIALS_DB: 7075-T651 plate >3 in A-basis (knee web), single-path limits; ankle-cross note marked verified
2026-10-21 RL Arms R16: option C(b) CF links - upper arm rejected (+0.013 pair, bond = 92% of 87 mm tube); forearm CF -0.203 pair (-0.091 with 7075 thermal sleeve), GJ 0.14x, cost cited; Job 8c spec (not launch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
2026-10-21 R-131 v3 adders, Elmo mass, Mg housings
2026-10-21 ID: R-127 roll sweep vs Torso cover; opening dia110 on pitch axis z220; envelope height 470->z50-310; soft limit 127
2026-10-21 D87: R-128 stock/grain/path table; all actuator parts pass band allowables; G4 gates per housing
2026-10-21 D87: knee twin housing stock >4.0 in (R-132) - 211 MPa provisional, fixes listed; JOB9 basis
2026-10-21 R-131: Elektron 43 allowables (DS-490 A-basis L 195/303; T/plate unverified) + MG_GALVANIC_PLAN
2026-10-21 R7 §G: Job 8b gates e<=2.2, 294 LT / 271 ST (R-132); Job 8c CF forearm FINAL + queueable (R-132 gates, torsional-stiffness vs Controls bandwidth, 0.8 mm sleeve)
2026-10-21 RL Torso: cover CAD per ID e874653 (z50-310, taper 250->340, chamfer, Ø110 at pitch z220, Ø90 neck, sternum x+147); job 3/3b bulkhead re-centred on z220
2026-10-21 Legs L65: femur/tibia side-dent fix 1.5 mm uniform wall (SF 1.13/1.10 vs 393), +0.147 robot; L66 knee centre web T7351 notes (R-132)
2026-10-21 RL Arms R17: clevis + roll-yaw link pocketing study (R-132 §5): -0.296/side (-0.59 pair) CALC on EST geometry, lugs need 9 mm; Job 8d spec
2026-10-21 thermal: R-131 Elmo no-heatsink mounting + D86 Mg housings dT
2026-10-21 ID: R-133 sweep vs Torso cover (3mm lost 130, contact 170-172, chamfer 6.5 mm, opening 7 mm); torso top width 340
2026-10-21 RL Torso: cover vents on sloped panel (30.2/25.2 cm2, 3.5 mm slots, IP2X), Thor/duct clears chamfer by 24 mm
2026-10-21 R-136 Elmo drive plates, Mg thermal pass
2026-10-21 D88: R-131 bottom-up 32 units; true overlap -1.84 kg full; wrist drives unbooked; shoulder_roll 4010 flag
2026-10-21 ID: R-133 sweep re-run vs Torso 4b8ac1c (vents): 3mm lost 130, contact 171-172, vents >=10.8 mm
2026-10-21 RL Controls: FOREARM_TORSION_REQ (Job 8c gate): >=15 Hz w/ 10 kg (5x 3 Hz BW), k_tube >=2.9 kN·m/rad; CSG-14 K1 4.7 dominates; CF 9.8 passes (20.1 Hz)
2026-10-21 RL Legs L67 (R-135): P-152 sleeve OD 46.80, knee web stock 4.25 in from CAD, JOB9 b3 min-wall request
2026-10-21 R-137 actuator ledger, knee housing forging
2026-10-21 R7 §G Job 8c: Controls torsion gate (8f80c42): assembly k_t>=2.9 kN.m/rad; mode with CSG-14 4.7 in series >=15 Hz @0.2 kg.m2, >=40 Hz hand-only; CF hand calc 20.1/460 Hz; overwrap only if k_t<2.9
2026-10-21 T&R JOB9_SPEC rev5: b3 femur/tibia 1.5 mm re-run at min wall 1.37/1.40 (R-135), 7050-T73511 262/393, sleeve+DP490 model, loads/BCs, quadratic elements, convergence, pass/outputs
2026-10-21 Arms: R16 torsion estimate corrected to Controls gate (20.1 Hz); R17 progress image + LOG
2026-10-21 P-152: Actuators co-sign (collar/hip-pitch output unchanged)
2026-10-21 Legs L68: knee web hand forging per R-137 §6/R-138; P-152 OD 46.80 accepted
2026-10-21 D88 addendum: shoulder roll 4010/6013/7013 cited, +0.36 bearing confirmed + 0.287 housing [EST]; D89 knee forging spec
2026-10-21 D89: R-134..136 Elmo standoff heat plates, 0.339 kg CAD, +0.044 vs R-136
2026-10-21 R-139 shoulder roll housing +0.287
2026-10-21 R-140 heat plate mass, knee plate accepted
2026-10-21 Electronics §18.5 P-055: G-TWI plate interface (M2 30.6x25.6 pattern, PE via drive, knee stack fails 27.5>26, TI[1]/CL[1]/PL[1] derate, 85 C hw trip), +0.008 kg
2026-10-21 R-141 derate curve, drive screws
2026-10-21 §18.5 P-055 addendum: CoE 0x22A2/0x22A3 temperature, 0x6072/0x6073 limits, BI 0x2012/2013, SDO 10 Hz (G-ETHERCATAM 1.403)
2026-10-21 Actuators D90: heat plates rev 2 (G-TWI M2 pattern, knee stack 23.0/26, hip pitch 84 mm 71.5 C, +0.008 kg P-153)
2026-10-21 RL Controls: R-141 drive thermal derate logic (0x6072 per-mille, whole-robot stop latch, hysteresis, stale/jump handling) + tests [WIP]
2026-10-21 RL Controls: R-141 drive derate per 430684c (0x22A2 temp, 0x6072 per-mille), DRIVE_DERATE.md, controller_config, timing check
2026-10-21 thermal: R-131 rev 2 D90 heat plates re-check
2026-10-21 R-142 sit latch 83C, plates rev2
2026-10-21 RL Controls: R-142 timing test/doc fix (1 K worst-case band)
2026-10-21 Actuators D91: heat plates rev 3 (knee finned shell window, UA 0.203, 71.5 C, +13 mm fins; +0.016 kg P-153)
2026-10-21 thermal: R-131 rev 3 D91 knee window plate
2026-10-21 T&R R-143 §2b: knee fins 71.5C FAIL ISO 13732-1 -> perforated PC guard spec (>=10mm air, >=60% open, <=48C touch, +0.04kg, UA re-check); TP-G5-15; tracker
2026-10-21 legs L69: G3 lever FAIL review, R8 arm-edge fillet, L47 candidate 0
2026-10-21 ID: R-143 knee plate rev3 ROM sweep (guard 24.5 mm envelope, min 6.6 mm rods @141 deg), P-154 knee fin guard CAD + proposal
2026-10-21 Legs L70: L47-SO brief per R-144 (single-path 294 LT/271 ST, cand 0 own ladder, 58 EST)
2026-10-21 ID: P-154 rev 4 guard (fins 18, 29.5 mm, low-eps liner, 64% open, lower chamfer); R-143 sweep min 7.8 mm @141
2026-10-21 Actuators D92: G3 lever R8/R5 blends + b34/d40 (est amp 53/58), T651 2.5in single-path 271, re-run brief G3-R2, P-155 +0.113 kg
2026-10-21 legs: cite Materials 58 MPa fatigue amplitude (R-144)
2026-10-21 RL Controls: R-142 safe-sit timing in sim (legs WBC, 0.5 derate): crouch stable at 1.5 s (2.0 s unsaturated), GIF + LOG
2026-10-21 Actuators D93: knee plate rev 4 (fins 18.5 + 45x8 lower taper, UA 0.248, 75.2 C standing, PEM studs; ID guard +0.5 mm; P-153 +0.066)
2026-10-21 Legs L71: P-153/P-154 knee window + 29.5 mm guard ROM/fall check
2026-10-21 R-145 safe-sit end state, knee plate rev4 mass
2026-10-21 ID: P-154 rev 4b guard (Act 5008683 + Legs L71): 104x66, tab notches, bosses, sweep 30.0 mm rods 12.0 @140 PASS
2026-10-21 Legs L71 addendum: G10 standoff no-metal-path, grille per Thermal
2026-10-21 Actuators D94: knee plate rev 4b 46 mm (8x0.75 fins, UA 0.247, 75.4 C standing); R-145 safe-sit holding: no brake/backdrive hold
2026-10-21 T&R R-143 rev4b: fins recessed behind fairing grille (Thermal 389f91b), guard dropped; grille temp est (<=45.6C worst), probe B unreachable, ISO 13732-1 PASS w/ margins; TP-G5-15 touch points moved; 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
2026-10-21 Actuators D94b: knee plate G10 no-metal stud condition (Thermal 389f91b); P-154 guard -> vented fairing grille, >=10 mm tip air
2026-10-21 thermal: R-143 rev 4c D94 knee plate
2026-10-21 ID: P-156 thigh-fairing knee venting (grille 65%, inlet/outlet 1296 mm2, duct insert); P-154 withdrawn; mass reconcile
2026-10-21 RL Controls: D94 friction-hold torque flag in the R-145 MO_OFF guard + tests
2026-10-21 ID: P-156 rev 4d: fin-tip baffle chimney, outlet aft/up z822-860, housing-fairing foil + slots, +2 mm bulge; mass +0.039 pair
2026-10-21 ID: P-156 rev 4d STL (baffle, chimney duct, plenum floors)
2026-10-21 T&R R-143 rev4d recheck: grille 37-38.5 / fairing 40.6-41.5 confirmed; outlet webs 54-61C FAIL (new); IP2X ok, housing-fairing slots must be <=5mm; TP-G5-15 touch+IP2X at grille/inlet/outlet/fairing 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
2026-10-21 Legs L72: drive plate placement + P-156 vent CAD check
2026-10-21 ID: P-156 rev 4e: outlet shroud (2686 mm2), housing-fairing slots 4.0+-0.3x20 x5, housing bare; mass +0.054 pair
2026-10-21 T&R R-143 rev4e: outlet shroud recheck (41-44C only with dilution slots; ID closed-bottom fails 48), IP2X fail at open top/sides, 48C no-sustained-contact class confirmed w/ conditions (ISO 13732-1, 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
2026-10-21 ID: P-156 rev 5 replan on Legs L72 geometry: outboard transfer duct + side exit/hood, rear grille dropped; mass +0.097 pair
2026-10-21 ID: P-156 rev 5a hood louvres (IP2X, 3394 mm2 free), Option B L60 cut-out note; mass +0.112 pair
2026-10-21 T&R R-146 prone landing: chest-pad load cases L1/L2/L3, controlled lower PASS, tip-from-kneel conditional (torso g 38-104 g open), TP-G5-16, tracker
2026-10-21 Legs L73: R-146 ankle stop extension study, P-157
2026-10-21 ID: T&R asks: prone head gap 42 mm PASS, HANDLING_MAP draft (W017 knee outlet), rev5a hood foil confirmed
2026-10-21 Actuators D95: drive plate placements (ankle shin front 3.5 mm, hip pitch pelvis rear wall 3.0 mm, full envelopes, release knee housing); knee release has front fins
2026-10-21 T&R R-143 rev5: side exit/hood REJECT (hand-in-zone, 43C likely contact: louvres/plume/hand FAIL), IP2X PASS, Option B recommended, N1 class wrong; R-146: 100mm core recheck, pack shock (c974f54) L2 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
2026-10-21 Legs L74: P-156 Option B L60 cut-out stress/fit, D95 plate re-check
2026-10-21 thermal: R-143 Option B L60 cut-out re-run
2026-10-21 R-147 ankle ROM, L74 straps, vent hold, torso core
2026-10-21 T&R R-146 update for Controls fc86721: kneel CoG 0.674 (368 J, 19-20 mm/70, 24-82 g, rails <=7.1 kN, head ok), L1 conditional on 0.30 m/s, raw vs filtered g for TP-G5-17, rescue procedure review; tra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
2026-10-21 ID P-156 rev 6 Option B (notch+shroud), HANDLING_MAP rev 6, shin blister AN1/AN2 5.0 mm, T-031 head 68 mm proposal
2026-10-21 RL Torso R-146: 100 mm core (face x+159, global transform), rail stop shoulder P-158 sized (latch closed), 13.3 kN kneel check, head clearance options, OpenRadioss decks + post, D95 pelvis answers, j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
2026-10-21 T&R L60 fall load case (29 kN screw-line, straps SF 4.3/2.8) + R-143 B2 rear outlet PASS w/ conditions (notch 1320 rerun Tb 71.3, skirt foil/gap, hand clearance); TP-G5-15 B2; tracker
2026-10-21 RL Torso: 116 mm core per ID 341ef4a (skin x+175, head 69.8 PASS, 25deg margin 20.7%), stability/bond/bezel/W2 checks, decks regenerated
2026-10-21 RL Arms R18: arm clash vs 116 mm chest pad (ID 341ef4a): min 0 mm before/after, <10 mm 192->269, hand/forearm folded-elbow cross-body only; Controls keep-out recommended; R17 LOG entry moved to media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
2026-10-21 thermal: D95 hip-pitch plate / pelvis wall check
2026-10-21 ID P-052 rev 2: tapered bezel/fairing on PA66 crush posts for 116 mm core (65 mm bulge), head 69.8 PASS, neg-roll W2 check, N6 update, BOM
2026-10-21 Legs L75: P-157 accepted, L74 twin-strap FEA brief, housing-plate gap fix, skirt/shin gates
2026-10-21 ID: chest_pad_bezel_r2.step (global frame) for Arms R18 G2 sweep
2026-10-21 Controls: arm vs knee shroud clearance (T&R 2e9b25c): static 63.1 mm PASS, envelope FAIL (min -67 mm), keep-out proposal; HANDLING_MAP: accept ID's T&R bec3b82 edits, add Controls conflicts C1-C5
2026-10-21 L75: cited G10 allowables (compression flat/edge, k), bearing [EST] + R-125(b)/hot limits
2026-10-21 Legs L76: G10 allowables, laminate orientation for thermal break
2026-10-21 T&R B2 hand-to-shroud clearance spec (Controls 6d4c8fb): plume keep-out, face contact OK thermally, mechanical 15/10/5 & 20/15/10 mm supervisor thresholds, source fixes; tracker
2026-10-21 ID P-156 rev 6b shroud (y<=150, aft-only openings, TPU edge), stack z840 pending Thermal, +4 mm plate; P-023 skirt rev 6 relief (4.0 mm worst); HANDLING_MAP C1-C5 rulings
2026-10-21 Actuators D96: ankle toggle 3D (-61.0 roll0, -58.6 roll18), carrier relief 4.6 mm, knee fin-tip trim 3.5 mm (r116b), L75 knee stop/peak answers
2026-10-21 R-148 ankle/knee ROM contract, mass ledger
2026-10-21 ID P-023 rev 7 flap study (FAIL: 59.7% cut, finger trap), Thermal 5fd6a54 stack z840 PASS, recommend split rear skirt
2026-10-21 D96: PU knee stop 135 deg impact study: knee speed at stop 6.18 rad/s max (forward fall), crouch collapse 5.41, kneel tip 2.50; torque [EST] vs PU stiffness
2026-10-21 Controls: arm self-collision supervisor (R18 chest box, ID rev 6b shroud hull baad131, T&R 925d72e 15/10/5 & 20/15/10 + K_plume timers), tests, config, closed-loop re-sweep, reach cost
2026-10-21 D96/P-157: ankle dorsiflexion soft limit with roll coupling (-0.916 / -0.955 at |roll|<=10 deg, stop -0.960) in supervisor (check_ankles -> HOLD_DERATED in KNEEL) + kneel; tests
2026-10-21 Controls: self-collision supervisor tuned (influence 100 mm, xi_in 8, aim +4 mm): min 17.2 mm walk/stand, crouch 87; P-042 payload keep-out (hook pending T&R); walk/carry attenuation; shroud rev 6b F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
2026-10-21 Actuators D97: PU knee stop pair (90A laminated, r60), 1030 N.m peak at 6.9 deg, rotor screw load 0.095 C0a, +0.263 kg P-158
2026-10-21 Actuators D97: renumber knee stop proposal P-158 -> P-159 (P-158 taken)
2026-10-21 Controls: bilateral thigh-panel keep-out (ID P-023 rev 8 df1e9e3): panel hull distance pair on hip dofs + coupled soft limit backstop; controller poses all clear (>=120 mm), walk/carry 54.9 mm; tests
2026-10-21 RL Torso: job 3 pocketing FEA (jobs 3 and 3b), overall FAIL
    CalculiX 2.23 C3D10 on the yaml torso. LC1 land deflection converges at 58.5 mm, buckling factor at 1.00, and the post ligament at 1576 MPa (SF 0.16 on 257). The raw peak is a singularity at the post-to-pelvis corner. Mode 1 is 64.1 Hz. Job 3b drops 1.39 kg on the sandwich pelvis and fails the same gates.
2026-10-21 T&R hip skirt rev8 pinch check: hem gap 24.4/21.5 FAIL, L-R bilateral FAIL broader than ID (yaw 22), Controls keep-out >=28 mm + compliant edges, N7/H2 review, TP-G5-18; tracker
2026-10-21 D97 PU knee stop re-run (nonlinear spring + 34% resilience, armature DR): max 1095 N.m / 7.40 deg / knee 142.4 (forward fall); no case over 8.6 deg or 1258 N.m
2026-10-21 model_v4: knee twin housing -> Actuators D96 r116b release STEP (was D59 unfinned): vol 108515 -> 142950 mm3, +96.8 g/knee @7075 2.81 [EST density]; clash_v4: standing 0, floating 0, knee 0-135 sweep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
2026-10-21 R-149 torso job3 fail, mass ledger
2026-10-21 sim/v3: mirror r_hip_yaw -45..35 (Legs L39), ankle_pitch hard -0.916 rad (P-157/R-147, D96) + -0.955 roll-coupled runtime soft limit; gen_v3 mirror rule fixed; make_model regen (68.001 kg); panel/shr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
2026-10-21 job10: repin sim/v3 + inputs to ddfcff8 (L39 hip-yaw mirror, P-157 ankle -0.916); note legacy walk_a test failure (ankle), CONTRACTS l.116 needs per-side ranges
2026-10-21 ID P-023 rev 8b: hem R144 (28.3 mm w/ overtravel), panel y86+chamfer, PE foam edges <=140 N, asym L/R sweep (cover trim insufficient -> Controls keep-out), HANDLING_MAP N7/N8/H2/rescue
2026-10-21 RL Torso: job 3 DIAGNOSIS (33.5 kN / 0.05 mm traced to 1f3a99b/946aa68, superseded by T&R b1fe48f), job 3c closed boxes (coarse: k 19 MN/m, buckle 4.6, 382 Hz, LC2 pass; stress open; +1.43 kg full), 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
2026-10-21 Legs L77 WIP: r116b gap, skirt r6 (superseded), knee stop, brief addendum
2026-10-21 Legs L77/L78: r116b gap, rev 8 skirt sweep, knee PU stop check, P-158 pad, brief addendum
2026-10-21 Electronics §18.5 bring-up checklist B1-B6 (Controls 8cbf083); §18.6 P-056 Torso 7075 pack box as enclosure: UL 2271 cites, liner 3x Nomex 70.7 g, retained items 76.3 g cited, bonding/EMI, open items
2026-10-21 T&R L60 fall load rev B: pair peak correction, DLF 1.05 + rotor inertia, bracket 13.1 kN; tube moment 1.23 kN·m (stop+motor), tibia 2.3/femur 1.8 or Controls stop-zone torque cap; tracker
2026-10-21 RL Torso: bay box as UL 2271 pack enclosure (Electronics 1a23584): lid gasket, GORE MultiVent rear-web vent Ø25/0.2 bar, mounts off joints, earthing, Formex GK-10; net +0.692 kg; pack/pad geometry op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
2026-10-21 RL Arms R18b: arm clash vs real chest pad STEP (ID ec40f5f): <10 mm 269->329, contacts 193; hands-together 12.0, P-042 109/33, tuck B 172, roll-127 worst 0.5 at full elbow fold; Controls keep-out box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
2026-10-21 RL Arms R19 (R-150): hands-first plant: CRBH 258 A wrist bearing s0 1.15 FAIL at 1525 N (heel plant, e<=10); cap <=875 N/hand or 2-sided wrist support; heel band +0.012/hand; elbow 2 s at 82 C: ~49 N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
2026-10-21 ID P-023 rev 8c: J-channel in hem gate, hem R141.5 (27.7 mm w/ overtravel), 40 mm XLPE edges (hem 74 N, L/R limp 127 N), N7 wording
2026-10-21 ID P-023 rev 8c: Legs L77 fixes (shroud in hem gate -> local notch, panel relief over knee housing, lower-edge return flange), new STLs
2026-10-21 T&R: record Robot Lab knee-cap + 1.7 mm tibia decision (L60); side-fall frontal tube bending case (S1 PASS, S2c knee-first conditional), TP-G5-19; tracker
2026-10-21 RL Arms: P-021 palm 4 mm heel band (R19, +0.0117 kg/hand CALC, 66/308 MPa, T651 1.5 in, L=finger axis); CAD regenerated; R18b/R19 progress image + LOG
2026-10-21 Hip skirt foam: Plastazote LD29 (95 C) cited; CLD 2x -> hem 153 N fail, 15 mm strip fix
2026-10-21 ID P-023 rev 8c foam: Plastazote LD29, hem/notch strip 15 mm (115 N), L/R load-limited 127 N, J-channel 15.5
2026-10-21 T&R side-fall rev B: L39 PU hip-roll bumper in parallel with the motor; S2b PASS, S1 conditional on stop energy (bottom-out fails), bumper spec, skirt overtravel flag; TP-G5-19; tracker
2026-10-21 RL Controls: hip-pinch keep-out (rev 8b, 35/30/28, exact boundary, job10 no limit), knee-plate keep-out (Legs 916c57f), chest box from real STEP (Arms 0a8a3cc); tests 15 pass
2026-10-21 Electronics §18.7 P-057: Option A pack notch feasibility (whole 5P groups, 20 cells if notch >72 mm deep), 2 Cu links 12 mm2 55 mV@100A, +0.050 kg, vent conflict open
2026-10-21 Actuators D98: r75 PU knee stop (contact 133°, 834 N·m @66 J, bottom 92.5 J @143.6°), outboard placement swept ≥6.4 mm, STEP; armature J_refl(q) (0.083 @135 vs sim 0.2018 stale); rotor reaction sign;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
2026-10-21 controls: walk-fall bisect (old ~4 s fall; ddfcff8 ankle range -> 2.8 s regression), R19 straight-arm kneel candidate + DR (FAIL: chest 0.26-0.30 m/s, plant ~1.2 kN), 49 N.m kneel elbow option (Arbit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
2026-10-21 Controls: side-fall sim set (S1/S2b/S2c, L39 bumper, knee cap on): base S2c 10.6 J 17/54 fail; swing-leg tuck rule 0/54 (1.66 J max); hip-roll damping rejected; S2c knee-first not reproduced; SIDE_FA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
2026-10-21 Legs L79-L81: tibia 2.0 wall + R-152 CAD mass, straps at 13.1 kN, PU bumper cited curve, rulings
2026-10-21 T&R L60 rev C (tibia 45x2.0, D99 44 J interim on D98, fault no-rupture), side-fall rev C (Controls 464b25b, tuck: all PASS, stumble pending), foot landing 1.70 m/s check, TP-G5-19/20, inspection sche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
2026-10-21 Legs L83: tube buckling hand + FEA brief, ankle roll stop r45, M4 12.9
2026-10-21 RL Controls: hip-pinch stopgap thresholds 40/35/33 mm (T&R 76de66a, +5 mm)
2026-10-21 Actuators D99: r75 knee stop re-sized to T&R rev C (contact 130°, 544 N·m @44.1 J, E25 95.8 J, bottoming 789 N·m, rate x1.3); C1/C2/top-out/sweep PASS, mass 0.484 kg FAIL vs 0.35; P-159
2026-10-21 Electronics §18.7 P-057 review of Torso ea6fc57: taps (SLUSE81F 100R/0.47uF, cell-end fuse req, 9 mV), link B net -0.018 (P-057 +0.032), BMS 10 mm depth rules, vent FAIL over hip-yaw drive; freeze = 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
2026-10-21 ID: P-023 rev 8d (T&R 76de66a): notch +1.5, rigid stops, J-channel 14.5, drop empty STL
2026-10-21 P-023 r8d: tidy standoff tip wording
2026-10-21 ID: P-023 rev 8e stop-in-cup (option a) CAD + alignment sweep: FAIL, not recommended
2026-10-21 Legs L84: D99 knee stop strikers/seats, SFs, mass (breaks 0.35 cap), sweep fails 3 mm
2026-10-21 Legs L84 rev2: D99 STEP placement, same-seg sweep, arm resize, mass 0.487 vs 0.35, kneel 108.9<130; r8c partial log
2026-10-21 R-155 D99 adopted, ledger 69.05
2026-10-21 RL Controls: D100 rules (no commanded MO=0 standing; 14 N.m hip roll/yaw cap in pinch zone, side-fall tuck check: never engages); drop limp hold; SELF_COLLISION rev 8c
2026-10-21 RL Controls: hip-pinch on ID rev 8f STLs (76cc34d), keep 40/35/33 stopgap (T&R 42c4e50); all 15 T&R 8f closures trip at 33 (<=0.83 mm vs T&R); test
2026-10-21 Controls: contract TUCK knees on (ramp 90-120 B172, cap 50 N.m >=120, knees drop last); D99 130 deg stop 90-case: powered 38.5 J max 0/90 >44.1, 3.80 rad/s; tripped 81 J/6.17 rad/s; short-brake [EST]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
2026-10-21 Controls: swing-leg tuck gated to standing/double support (disabled in single support) per Robot Lab ruling on 976eca8; test; SIDE_FALL.md
2026-10-21 T&R side-fall C.3 / L60 C.3: Controls 976eca8 stumble (S2c not observed, tuck standing-only, 2708 N landing 69 %), TUCK 38.5 J, tripped 81 J fault; tracker
2026-10-21 WBC walk retune on sim/v3 ddfcff8: heel-rise plan pre-pass + gate/CoP tune, best 13.78 s @1.2 (FAIL 20 s); job10 ref_cycle needs ankle past -0.916 (hold recommended); clash_v4 rerun (knee sweep clean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
2026-10-21 WBC retune: sensitivity sweep appendix (plateau at 13.78 s, plan regen needed)
2026-10-21 Legs L85: D99 rulings, deepened-arm re-sweep PASS min 10.3 mm
2026-10-21 Legs L86: 2.7 kN standing-tuck case in Job 7 brief; M4 helicoil 1.5D, cross T7351, M4 12.9 torque 4.0 N.m
2026-10-21 3c-final rev B: closed waistY, pelvis internal reinforcement, lid/socket gussets, Thor +9, P-160 hard stop, Electronics 18.7 items, progress image
2026-10-21 Controls: hands-first toe kneel <=125 deg attempt (knee soft limit, cap on, per-phase knee max): 0/16 pass, knee 133-138 in hand reach under the 50 N.m cap; 65 kg chest-lower bug diagnosed (head cont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
2026-10-21 Legs L87: hip yaw L-35..+40 / R-40..+35 (Controls 2b92408); r7 gaits superseded
2026-10-21 Actuators D99 r75b: striker arm 24x18 (flush, t0-22 hits ankle screw 0.5 mm) + tibia ring 2x ø6 pins per Legs L84 r2 6a3d84c; re-sweep min 4.5 mm PASS; P-159 0.487 kg FAIL vs 0.35 pending Robot Lab; 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
2026-10-21 job 10 HELD: banner in job10_brief + RETRAIN_PLAN_J10 (ref_cycle exceeds -0.916 ankle; regen in progress; no start until new pin)
2026-10-21 Actuators D100: hip roll/yaw limp hold vs 140 N clamp — shorting damps only, FAIL under stance/twist loads; no mass change
2026-10-21 PROPOSALS: drop stale D98 P-159 block; P-159 r75b accepted at 0.49 kg cap per Robot Lab
2026-10-21 Job 7 brief: 3,914 N fall case with 48a9da0 citation
2026-10-21 Controls: head-clear neck posture in chest lower (neck -0.68 rad); standalone DR 9/9 pass (0.082 m/s, <=433 N, knee 111.7, head >=48 mm); joined 65 kg still head-limited; kneel_toe results marked sta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
2026-10-21 RL Controls: rev 8f hip-pinch boundary + job10 sweep JSON (L/R identical to 8c), 14 N.m cap rerun at 40 mm zone (never engages), SELF_COLLISION 8f table; test-gated commit script
2026-10-21 ID: P-023 rev 8g geometry-only re-sweep (Legs convention/surfaces): hem gaps PASS (a) 49.6/27.8; L/R panel+shroud 0 mm FAIL, ruling needed; levers; Legs -35.2 = sphere metric
2026-10-21 WIP: native ankle-bound plan generator (ANK_MIN, stance toe-pivot heel rise + swing toe-down), r8 plans 1.2/1.15 + ref_ds25 0.8/1.0/1.2 at 68 kg; clash_v4 per-side hip yaw L-35..40 R-40..35
2026-10-21 Controls: quasi-static transition to pose (b) (qs_transition.py, WBC CoM + hand force ramp): 0 pass at 68 kg; P1 crouch OK, reach stalls 50-70 mm short or tips onto the hands; QS_TRANSITION.md (DR/ch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
2026-10-21 Legs L89: D99 r75b flush arm 4.5 mm PASS, CAD mass 0.871 kg robot (0.344 base wrong), taper -0.089 kg; L85 corrected
2026-10-21 3c rev C: fine lid submodel, mass round m1-m5, lid 4.5, tap fuse 0451.500
2026-10-21 torso pack: regenerate layout json (tap fuse 0451.500)
2026-10-21 Legs L88 pelvis reinf/vent PASS 15.2 mm, vent clear; L90 8g L-R closure FAIL 0.0 mm, combined yaw/adduction PU ramp stop sized
2026-10-21 Controls: static reach IK check: unloaded hand reach with CoM over feet IS feasible (straight-leg pike, hands -77 mm reach, CoM 187 mm behind toe flat-foot); gap was the crouch family; scheduled reac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
2026-10-21 r8 ankle-bound plans WBC results (best 6.55 s @1.16 m/s, FAIL 20 s), mass-setting explanation, hip-yaw <3 mm clearance check (knee housings 0.0 mm at L+40 / R-40; R stop tab 0.31 mm), LOG
2026-10-21 clash_v4.json regenerated (r116b, per-side hip yaw L-35..40 R-40..35: full range clear by overlap volume)
2026-10-21 Actuators D100b: hip limp hold with ID r8g hand levers (82-180 mm) — stance/twist still FAIL all pairs, hem-shroud worst 1348 N
2026-10-21 Legs L91: D99 reopened, taper not pursued, 8g bumper hold; integrated knee stop concept A 0.36 / B 0.26 kg
2026-10-21 Legs L91 addendum: L90 hip yaw/roll ramp stop FINAL, coupled limit replaces L87 yaw, 8g hold cleared
2026-10-21 Legs L92: final coupled hip yaw/roll limit per Controls 1b44344 (L yaw -12..+28 -> -5..+10 at roll -12), ramp face re-placed
2026-10-21 T&R: verify Controls hip_pinch on rev 8f STLs (+ Legs 3f4164b yaw ROM): 15th pose, hem STL vs sphere, 35/30/28 OK
2026-10-21 Actuators D101: integrated knee stop in r116b housing (Legs L91 B/A) NO-GO — housing 185 mm above knee, >=161 mm from neck/lever; tibia-strike needs 231 mm PU vs 66 mm gap; P-159 note
2026-10-21 3c rev D: chest load off the lid (socket walls to floor, shelves), lid 1.5, pelvis x-ribs; tap-fuse R in R_CB sizing
2026-10-21 PROPOSALS P-159: record Robot Lab D101 ruling (option b, cap = CAD mass)
2026-10-21 R-156 D99 CAD mass, L90 hip stop, ledger 69.48
2026-10-21 3c rev E: final coarse pass (ribs 8, socket clearances, flush top shelf); R1 mass/COM overrun note
2026-10-21 R-157 torso job 3c: plateau-down study before accepting +2.63
2026-10-21 R-157a torso 3c provisional, ledger 72.11
2026-10-21 T&R TORSO_BC_P160_REVIEW: inertia-relief BC (waist 9.0 kN/2.5 kN·m vs 29/4.36), T-031 gate cut to 824 J, plateau study LC1 17.9 kN, P-160 partial; tracker
2026-10-21 R-158 torso IR BC, 824 J gate, plateau conditional
2026-10-21 Materials: chest pad core HexWeb CR III 5/32-5052-3.8 for 11.2 kN weakest plateau (3eacd56)
2026-10-21 Controls: T&R 3eacd56 reply (partial): D99 waist-pitch speed probe (worst 6.34 rad/s at -30 range end, tripped waist); 25deg pad fit and back-fall case OPEN
2026-10-21 Actuators D102: waist-pitch CSG-25-100 data for P-160 yoke stop — K1/K2/K3, windup 0.222 deg @204, gap budget 0.10 deg / Ks 634 kN.m/rad (locked case), no-brake rotor impact 117 N.m per rad/s, CRBH 6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
2026-10-21 Actuators D102b: waist drivetrain J 0.652 kg.m2 at output (rotor+WG), 12.9 J at 6.3 rad/s, rigid-stop gear impact 1215 N.m > ratchet 650 -> compliant stop required
2026-10-21 Legs L93: L91 void, roll sign, L92 re-sweep (housings 0 at toe-out>=19, panel 27.5), D99 taper FEA brief, clevis pocket no-fit; roll clash run pending
2026-10-21 P-160: energy case parameters (I, E, lug location, travel envelope), sizing on hold for D102c
2026-10-21 Controls: waist-pitch stop-zone torque zero per Actuators D102 (bd21ff0), 3 deg zone, all states
2026-10-21 torso: waist-pitch torque limiter keep-out (Mayr EAS-compact size 2), R1 mass EST
2026-10-21 Controls: L3 25deg topple plateau-pad sim (24 runs: max 489 J x1.5, crush 36.5/81.2 mm, no bottoming; C1 11/24, C2 19/21, C3 22/24; no run reached 25 deg; 11 head-first); correct 084af79 head speed (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
2026-10-21 Controls: wire D102 waist stop-zone zero into WBC + backfall sim; waist TUCK damping study (WAIST_TUCK_DAMP)
2026-10-21 torso: job 3e PROVISIONAL brief (R-158c); limiter keep-out note (Actuators <=0.4 kg)
2026-10-21 Controls: L3 head-first replay (11 seeds: head world speed 3.8-4.99 m/s, E_head<=6.0 J [EST, m_head 0.48], upper KE<=301 J); forced-25deg at 72.1 kg NOT achieved (32 ICs, tilt 9.9-17 deg)
2026-10-21 Controls: L3 head-first rerun at head 1.104 kg (11/11 still head-first; worst seed 14 5.02 m/s, 13.9 J [EST], upper KE 305 J; head 50-254 mm below chest pad, 136-338 mm below shoulders); worst pose +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
2026-10-21 Legs L93b: roll clash results, coupled roll-pitch + toe-out proposal
2026-10-21 Design: P-161 head-first protection: standoff sweep (chest pad first to ~98deg pitch; torso standoff not viable crown-down), LD29 25 mm crown/brow liner for 20.7 J (~110 g), visor recess >=20 mm, CF 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
2026-10-21 Actuators D102c: integrated Belleville friction torque limiter (Tc 170 +/-10%, ø90/66, 0.394 kg CAD) — dynamic gear peak <=193 N.m at 8.32/7.0/2.5-4.1 rad/s, both torsos; heat 3 C at 324 J; braking l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
2026-10-21 Design: P-161 update per Controls 0ef2d9e: standoff dropped (seed 14 pitch ~127deg), liner primary 20.9 J; neck/body-KE case not coverable (457 J needs 152-457 mm at 3-1 kN)
2026-10-21 Controls: waist friction-limiter slip monitor per Actuators D102c (encoder diff x100, >100 J break-away flag, re-home after slip; braking limits 3.67/5.86/5.75 rad/s)
2026-10-21 R-159 D102c limiter +0.394, ledger 72.50
2026-10-21 Legs L94: rulings; limp-contact study started
2026-10-21 Legs L94 limp contact study (partial): screw body-on-body first; PU pad interim, Actuators splay final
2026-10-21 Controls: L3 head-first variants at 1.104 kg: waist hold 204 N.m head-first 2/11, knee hold 129 N.m 9/11, both 3/11; waist-held chest E x1.5 up to 539 J at 5.5 m/s
2026-10-21 R-160 crown liner +0.022, ledger 72.52
2026-10-21 Design: D102c limiter vs waist covers PASS (~52 mm min, est); HEAD_NECK_BREAKAWAY_PACKAGING.md (neck annulus r22-45 x 89 mm, collar bypass onto torso land)
2026-10-21 FMEA F21 hip screw limp contact (Legs f535463) + inspection; F19 update from Controls d5c0abc; tracker
2026-10-21 Electronics §18.8 P-058: waist back-drive regen (D102c): EMF 14.04 V/(rad/s), 95 V at 6.77; pumped <=70 J (48% KE), pack 3.3 A/cell vs 13.5 A P45B; P-045 covers (drive-side powered); no per-drive TVS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
2026-10-21 Torso: D102c limiter keep-out, encoder side, PU waist stop sizing
2026-10-21 Controls: regen/bus guard per Electronics P-058 (86 V no-regen, waist brake <=5.75 rad/s, BMS-open speed interlock)
2026-10-21 Materials: P-161 crown liner check - 25 mm LD29 fails QS, rec 32 mm; shell stack order
2026-10-21 Legs L95: WBC walk_1p2 pair gaps (min 34.35 mm f118), pair-geometry limit note
2026-10-21 Actuators D104: hip_pitch inner screw adduction contact (splay infeasible, pad clamp rules)
2026-10-21 Torso: waist stop structure SF, CRBH tilt, P-162 brake tilt, 183 J alt, overtravel sweep, wing fit
2026-10-21 Torso: adopt 183 J waist stops, cheek pad, P-162 reaction note, R1 +1.13 kg EST
2026-10-21 Actuators D102c: correct PU stop gate 356 J -> 183 J (torso only; drive inertia sheds via limiter)
2026-10-21 RL job2r: case B finest level
